JoanSanbartolome/ESP-Riego/gestion/informes/VAL-0029-01.md

---
id: VAL-0029-01
spec: SPEC-0029
fecha: 2026-11-14
commit_revisado: 0a786a3
checklists: [esquema v10, librerias v6]
veredicto: APROBADO_CON_OBSERVACIONES
---

# VAL-0029-01 · Bloque de sensores

## Alcance de la revisión

Nivel completo sobre `0a786a3` (rama `spec/SPEC-0029-bloque-sensores`), con copias en la carpeta temporal y sin MCP.

- **Reproducido de forma independiente:**
  - pinout del símbolo y de la huella frente a §5.4 (p. 17, Fig. 18), Fig. 15 (p. 15) y Fig. 17 (p. 16);
  - dirección I²C con la Tabla 11 (p. 21);
  - unión de la raíz en la netlist kicadxml exportada de una copia;
  - modelo 3D enlazado en la instancia: ruta, transformación, `layout.3d` y render `vista.py huella --3d` con el STEP de respaldo;
  - la sincronización de la PCB: `sincronizar.py` sobre la PCB de `3dfec5d` da una placa igual a la del commit (comparación huella a huella sin UUID).
- **Cambios de `herramientas/kicad/`** (`_comun.modelo_de_respaldo`, `sincronizar.py`, `comprobar.py librerias.3d`): revisión del diff, 5 casos directos de la función, 3 mutaciones de `librerias.3d`/`layout.3d` y `sincronizar.py --actualizar U13`. `test_kicad.py` completo: 34/35; el fallo, `Mutaciones.test_librerias_fichas`, viene de SPEC-0028.
- **Recalculado:** C_b máx. (75 pF), derating de C47 (73 nF), autocalentamiento (2 mK y 0,49 K), modelo de la isla (G = 0,67 + 0,29 y 2,4 mW/K; f = 0,29; τ ≈ 108 s), calentamiento de la placa (4,5 K y 10,5 K), dHR/dT (2,98 % HR/K) y 3 K → 41,9 % HR. Todo cuadra.
- **Por muestreo:**
  - 4 códigos con `jlc.py` (C2848306, C2909890, C7461861 y C14663): coinciden con `stock-sensores.csv`, salvo el stock de C14663, que se ha movido (34,63 M);
  - las 2 URL de `Datasheet`: HTTP 200;
  - 3 restricciones de AMB-02 frente al requisito: borde, sin planos y orientación.

## Comprobaciones automáticas

| Comprobación | Resultado |
|---|---|
| ERC | 0 (`verificar.py hardware/v2`; `kicad-cli sch erc --severity-all` sobre una copia: 0) |
| DRC | 0 errores, 0 avisos; sin conectar 352 → 358 (+6 = 1 por I2C_SDA, 1 por I2C_SCL, 2 por +3V3 y 2 por GND: los pads nuevos de U13 y C47) |
| Paridad esquema↔PCB | 0 |
| Puntos `[auto]` | 16 OK, 2 N/A. FALLAN `librerias.gitattributes` (`*.WRL`) y `librerias.fichas`, con las mismas 6 líneas de la hoja MCU que antes de la spec. Ningún punto nuevo en FALLA |

## Criterios de aceptación de la spec

| Criterio | Evidencia | Resultado |
|---|---|---|
| Piezas, valores, huellas y pines = `sensores.md` y datasheet | Netlist: U13-1 SDA → `/I2C_SDA`, U13-2 SCL → `/I2C_SCL`, U13-3 VDD → +3V3, U13-4 VSS → GND; C47 entre +3V3 y GND. Pads de la huella 1 (−0,7, −0,4), 2 (−0,7, 0,4), 3 (0,7, 0,4), 4 (0,7, −0,4), 0,5 × 0,3, paso 0,8, columnas a 1,4 = Fig. 17/18 | Cumple |
| `verificar.py`: ERC 0, DRC 0, paridad 0, sin `[auto]` nuevo en FALLA; sin conectar solo por las huellas nuevas | Tabla de arriba; el parte da 352 → 358 | Cumple |
| `campos.py revisar`: 0 diferencias con `campos-sensores.csv` | «diferencias con la tabla 0». Los DISTINTO y FALTA son de alimentación, ya estaban | Cumple |
| Cinco hojas; I2C_SDA/SCL a GPIO41/42; sin *pull-ups* duplicados ni NC en pines unidos | Netlist: 5 hojas; `/I2C_SDA` = {U5-34 IO41, R24-2, U13-1} y `/I2C_SCL` = {U5-35 IO42, R25-2, U13-2}. Las 2 NC de esos pines, retiradas | Cumple |
| Sin pad central, 3D de respaldo en la instancia y sin librerías de la v1 | 4 pads, sin pad central. U13 enlaza un solo `model`, `${KIPRJMOD}/../libraries/3d/…NoCentralPad.step` (offset 0, giro 0, escala 1). El STEP no ha cambiado desde `daa0aa6`, validado en VAL-0015-02; en el render, la marca del pin 1 cae sobre el triángulo de la serigrafía. `lib_id`: `Sensor_Humidity`, `Device` y `power` | Cumple |
| Dirección sin choque, calentador fuera de uso, consumo = `mcu.md` §8.2 | AD1B → 0x44 (Tabla 11, p. 21), único en el bus de la placa; la expansión va por GPIO47/48. `heater_max_duty: 0.0`. 500 µA máx. (p. 9) = 0,5 mA de §8.2 | Cumple |
| Restricciones de AMB-02 listas para `restricciones.csv`, sin colocar ni rutar | Tabla del §0 con el formato de `restricciones.py`. U13 y C47 quedan fuera del Edge.Cuts (y ≈ 271–277 frente a 60–130) y no hay pistas nuevas | Cumple |

## Requisitos

| Requisito | Evidencia | Resultado |
|---|---|---|
| AMB-01 | SHT40 en placa, I²C, desacoplo y *pull-ups* | Cumple |
| AMB-02 | Borde lateral (FAB-07), ranuras con un puente, área de regla en F.Cu y B.Cu sin relleno ni vías, orientación a la rejilla y corrección según las salidas (§8). Cifras recalculadas | Cumple (lo confirma el prototipo, §9) |
| KIC-02 | Raíz con alimentación, MCU, salidas, sensores y conectores | Cumple |
| FW-03 | §8: T corregida, HR por Magnus y calentador apagado | Cumple |

Puntos `[juicio]` de las checklists:

- Cajetín: título, hoja, versión, fecha e Id 6/6, vistos en el render de la hoja.
- Cálculos con fórmula, fuente y margen; recalculados.
- C47 con derating.
- Desacoplo y *pull-ups* del sensor (esquema l. 63).
- Tabla de restricciones (l. 67).
- Pines y tipo eléctrico (librerías l. 20, 21 y 41).
- Pin 1 en serigrafía y en Fab.
- 3D alineado (l. 30 y 34).
- Datasheet del fabricante, V7.3 (l. 46).
- Origen oficial anotado (l. 9).

Todo correcto.

## Hallazgos

Severidad: **C** crítico · **A** alto · **M** medio · **B** bajo.

| ID | Sev. | Hallazgo | Evidencia | Requisito | Cambio propuesto |
|---|---|---|---|---|---|
| VAL-0029-01-01 | M | El comportamiento nuevo de `herramientas/kicad/` no tiene prueba en `test_kicad.py`: ni `_comun.modelo_de_respaldo`, ni el cambio de modelo de `sincronizar.py`, ni la rama «respaldo» de `librerias.3d`. El README pide una prueba para lo que se añade. Mis comprobaciones dan el comportamiento correcto: función con oficial ausente/existente, sin respaldo y `libs3d=None`; M1, la instancia vuelve al oficial → `layout.3d` FALLA; M2, sin el STEP → los dos puntos FALLAN; M3, respaldo `.wrl` → FALLA; `--actualizar U13` conserva el respaldo. El autor ya lo dejó en PENDIENTE: `test_kicad.py` está fuera de su zona | `git diff 3dfec5d 0a786a3 -- herramientas/` (sin cambios en `herramientas/pruebas/`); `herramientas/kicad/README.md` § Herramientas y § Puntos | KIC-02 (herramientas, DEC-0009 M1) | Añadir en `test_kicad.py`: (a) casos de `modelo_de_respaldo` como los de arriba; (b) `Mutaciones`: `librerias.3d` OK con respaldo y FALLA sin él; (c) `sincronizar` de una huella oficial sin 3D que deja `${KIPRJMOD}/../libraries/3d/…` en la instancia. Se puede juntar con el arreglo de `test_librerias_fichas`. **No afecta a la spec siguiente**, salvo que vuelva a cargar una huella oficial sin 3D (el USB-C HRO ya tiene respaldo); `layout.3d` cubre ese caso mientras tanto |
| VAL-0029-01-02 | B | La ficha `SHT4x.md` no recoge el cierre del bloque. Sigue con `verificado_por: pendiente (ing-validacion), solo el modelo 3D de respaldo`, aunque VAL-0015-02-05 lo cerró. «Uso en el proyecto» dice que la variante «la fija el bloque de sensores» y las «Notas de los assets» dicen que el bloque «tiene que añadir» el `model`: las dos cosas ya están hechas. `sensores.md` Anexo A lo reconoce («la ficha no se ha tocado») | `hardware/componentes/SHT4x.md`, cabecera, «Notas de los assets» y «Uso en el proyecto»; `gestion/informes/VAL-0015-02.md` l. 34 | AMB-01 | En la cabecera, `verificado_por: VAL-0015-02 (3D de respaldo)`. Variante fijada: SHT40-AD1B-R3, U13 (SPEC-0029). Instancia con el `model` de respaldo, enlazada por `sincronizar.py` |
| VAL-0029-01-03 | B | El SHT40-AD1B-R2 (C2909890) es el mismo chip a 1,7491 $ (frente a 1,8538 $ del R3) y tiene más stock (14 052 frente a 13 207). Con la misma huella y la misma dirección, ahorra ≈ 0,10 $ por placa. La diferencia entre R2 y R3 es solo el carrete (2 500 o 10 000 uds, Tabla 11, p. 21), que en el montaje de JLCPCB no cuenta | `jlc.py` 2026-11-14; `stock-sensores.csv` | — | Valorar el cambio de U13 a C2909890 (MPN, LCSC y Value en `campos-sensores.csv`, `sensores.md` §0, §2 y §10, y la ficha) con `campos.py aplicar`. Es opcional |
| VAL-0029-01-04 | B | `mcu.md` §8.2 da 61 mA para el calentador (200 mW / 3,3 V). El datasheet da 60 mA típ. y **100 mA máx.** (Tabla 4, p. 9). No cambia nada porque el calentador no se usa; `sensores.md` §4.1 ya da el máximo. Lo anotó el autor | `docs/diseno/mcu.md` l. 194; SHT4x p. 9 | AMB-01 | En la próxima revisión de `mcu.md`: «60 mA típ. / 100 mA máx. (p. 9) … el total subiría a 0,55 A» |

Contraste con los partes:

- Las afirmaciones del parte 02 se sostienen: +6 sin conectar, netlist, 3D y fallo previo del test.
- El parte 01 nombra C46: lo corrigió el paso 2 (C47) y la nota del coordinador lo explica.
- Los dos partes coinciden con los entregables.

## Propuestas para las checklists

- `[auto]` Esquema: las referencias de `campos-<hoja>.csv` no pueden estar usadas en otra hoja del proyecto (`campos.py revisar`). Habría parado el C46 duplicado de la spec y del paso 1.
- `[auto]` Librerías, l. 33: un caso de `test_kicad.py` en el que el respaldo de `libraries/3d` haga pasar `librerias.3d` y su ausencia lo haga fallar (ver VAL-0029-01-01).
- `[juicio]` Esquema: cuando un bloque cierra la elección de una pieza (variante, 3D enlazado), su ficha en `hardware/componentes/` se actualiza en la misma spec.

## Veredicto

**APROBADO_CON_OBSERVACIONES.** Se cumplen los 7 criterios de aceptación. Quedan un hallazgo M (VAL-0029-01-01, pruebas de la herramienta, que no afecta a la spec siguiente) y tres B.
