JoanSanbartolome/ESP-Riego/gestion/informes/VAL-0025-01.md

---
id: VAL-0025-01
spec: SPEC-0025
fecha: 2026-11-13
commit_revisado: 07b48a6
checklists: [esquema v9, librerias v6]
veredicto: APROBADO_CON_OBSERVACIONES
---

# VAL-0025-01 · Hoja de salidas en el esquema v2

## Alcance de la revisión

Validación completa de `7d78d12..07b48a6` en la rama `spec/SPEC-0025-hoja-salidas`. Reproducido de forma independiente, sobre una copia de `hardware/{v2,libraries,componentes}` en el *scratchpad* (`v25\`):

- la netlist kicadxml exportada de la copia frente al Anexo B, en los **6 canales** (87 refs, todos sus pines, con el script propio `anexo_b.py`), y los pines de U7–U12 frente a la Tabla 2, p. 4 del BTT6050 (`pdftotext`);
- las uniones de la raíz (pin de hoja ↔ etiqueta ↔ no conexión) y los GPIO de U5 frente a la tabla de pines del ESP32-S3-WROOM-1;
- BOM (`sch export bom`, con y sin `--exclude-dnp`) y CPL (`pcb export pos`, completo y `--smd-only --exclude-dnp`);
- atributos de las dos huellas (`huella.py`, `git diff`) y de J1 y las huellas nuevas en la PCB;
- diff semántico de la PCB frente a `7d78d12` (sin uuid) y cruce de los 628 pads con la netlist; recuento esperado de «sin conectar».

Por muestreo: 4 filas de `campos-salidas.csv`/`stock-salidas.csv` con `jlc.py` (C534868, C17902, C17713, C2286) y 5 de los 12 cambios de `salidas.md` (1, 7, 9, 10 y 11). El MCP no se ha usado (salvo `get_jlcpcb_part`, que no tiene la base descargada).

## Comprobaciones automáticas

| Comprobación | Resultado |
|---|---|
| ERC | 0 (0 errores, 0 avisos) |
| DRC | 0 errores, 0 avisos; 352 sin conectar (172 en `main`) |
| Paridad esquema↔PCB | 0 |
| Puntos `[auto]` | 16 OK, 2 N/A (zonas, restricciones), 2 FALLA: `librerias.gitattributes` (`*.WRL`) y `librerias.fichas` (6 códigos del MCU); los dos están en SPEC-0028 |
| `campos.py revisar` | 0 diferencias con la tabla; 20 incoherencias entre hojas, todas de los tipos de SPEC-0028 |
| `hardware/v2` tras `verificar.py` | sin cambios (`git status`) |

## Criterios de aceptación de la spec

| Criterio | Evidencia | Resultado |
|---|---|---|
| Piezas, valores, huellas y pines frente a §9 y Anexo B | Netlist: 0 diferencias en los 6 canales (pines NC del BTT sin red; D6 K=GND, A=`LED1_A`; D12 K=`OUT1`, A=GND). U7–U12 = Tabla 2, p. 4. Valores, huellas, LCSC y MPN de las 13 líneas = §9; totales 6 U, 6 J, 43 R, 20 C, 6 LED + 6 D | Cumple |
| `verificar.py`: ERC 0, DRC 0, paridad 0; `attr`, `campos`, `dnp` OK; sin conectar solo por huellas nuevas | +180 sin conectar = mi recuento por redes (10 aristas internas por canal × 6, IN/IS 3 × 6 cada una, OUT_DEN 7, BUS_24V 20, GND 57). Diff semántico: las 80 huellas previas solo cambian en el `thickness` de los textos, el `attr` de J1 y 19 redes renombradas (`/MCU/INn` → `/INn`, `/Alimentacion/BUS_24V` → `/BUS_24V`); 628 pads = netlist | Cumple |
| `campos.py revisar`: 0 diferencias; sin incoherencias nuevas fuera de SPEC-0028 | Las 7 nuevas (Datasheet y Fabricante de C25803, C381466, C513710, C8465) son del tipo «`Datasheet` distinto» y «`Fabricante` ausente», en el alcance de SPEC-0028 | Cumple |
| Pin 1 = OUTn, pin 2 = GND en los 6 bornes (REL-06) | J4–J9 en la netlist y en la PCB | Cumple |
| D12–D17 DNP en símbolo y huella, fuera de BOM y CPL | Símbolo `dnp yes`, `in_bom no`, `in_pos_files no`; huella `smd exclude_from_pos_files exclude_from_bom dnp`; ausentes en los 2 BOM y los 2 CPL exportados (D6 presente) | Cumple |
| Ninguna librería de la v1 | `lib_id`: `Device`, `Connector`, `power`, `esp-riego`; tablas solo con `${KIPRJMOD}/../libraries/esp-riego.*` | Cumple |
| Raíz: sin no conexiones en pines unidos; IN1–6, IS1–6, OUT_DEN y BUS_24V a sus GPIO | 21 → 7 no conexiones, las 7 en pines de MCU sin unir (I²C, EXP_*, PULSE_IN). Etiqueta local en cada uno de los 38 pines unidos, sin discrepancias de nombre. IN1–6 → U5 19, 20, 21, 8, 9, 10 (IO11, 12, 13, 15, 16, 17); IS1–6 → U5 4, 5, 6, 7, 12, 17 (IO4–9); OUT_DEN → U5 31 (IO38); BUS_24V → U1 OUT, JP1, TP5 y VS de U7–U12. Direcciones: hoja y raíz según Anexo B | Cumple |

## Requisitos

| Requisito | Evidencia | Resultado |
|---|---|---|
| REL-01, REL-03 | 6 BTT6050 con su *clamp*; D12–D17 DNP (DEC-0008) | Cumple |
| REL-04 | R32–R37 en IN1–6 y R44 en OUT_DEN a GND, sin otras cargas en esas redes | Cumple |
| REL-05, REL-08, REL-09 | Sin cambio de cálculo; se deciden en el layout (§11) | Fuera de esta spec |
| REL-07 | R63–R68 + D6–D11 desde IN_n, cátodo a GND (pad 1 = ② del KT-0603R) | Cumple |
| REL-10 | Pin 6 → R_SENSE 1206 → IS_n con R_IS 820 Ω y C_IS 100 nF a GND; R_OL 47 kΩ 0805 de BUS_24V a OUTn | Cumple |
| Checklist de esquema `[juicio]` | Cajetín en el PDF exportado (p. 2: título, «Hoja: Salidas», 2.0-dev, 2026-11-12, A3, 2/5). Cálculos de `salidas.md` sin cambios de valor (los validó VAL-0023-01). Tabla de restricciones en §11. Pines de arranque: ninguno de los GPIO usados es de arranque | Cumple |
| Checklist de librerías `[juicio]` | Las dos huellas solo ganan la línea `attr`; `huella.py`: BTT smd, 40 pads, cruce con el símbolo de 15 pines sin pines ni pads sueltos; WJ500V through_hole, 2 pads | Cumple |
| Muestreo de campos y stock | Tipo, MPN y fabricante iguales a JLCPCB (2026-11-13); stock ±2 % del 2026-11-12. MPN de UNI-ROYAL coherentes con valor y potencia (W4 = 1/4 W, W8 = 1/8 W) | Cumple |
| Muestreo de `salidas.md` | Cambios 1, 7, 9, 10 y 11 con el texto exacto del log de SPEC-0024; los «requiere DEC» de §0, §5, §11 nota 1, §13.1, §13.8 y trazabilidad citan DEC-0008 (no queda ninguno) | Cumple |

## Hallazgos

Severidad: **C** crítico · **A** alto · **M** medio · **B** bajo.

| ID | Sev. | Hallazgo | Evidencia | Requisito | Cambio propuesto |
|---|---|---|---|---|---|
| VAL-0025-01-01 | B | La cabecera de `salidas.md` sigue citando «`docs/02` v0.4», mientras §11 (l. 373) y DEC-0008 ya remiten a la v0.5, que cambia FAB-03, un requisito de la misma línea | `docs/diseno/salidas.md` l. 4 y l. 373; `docs/02` l. 3 y l. 269 | FAB-03 | «`docs/02` v0.5» en l. 4. Se puede llevar a SPEC-0028; no afecta a la spec siguiente |

Contraste con los partes: lo que afirma el parte 02 (cifras de sin conectar, renombres, 14 no conexiones quitadas, banderas DNP, incoherencias 13 → 20) coincide con lo que he reproducido. El parte 03 dice que `hardware/v2` «todavía no tiene la hoja de salidas», pero el commit del paso 2 (`dc8d474`) es anterior. Su resultado, sin embargo, es correcto: con la hoja, C17713, C17902 y C23253 ya no salen en `librerias.fichas`.

## Propuestas para las checklists

- `[auto]` esquema: netlist de la hoja frente al plan de conexiones del documento de diseño (Anexo B o equivalente, en una tabla que se pueda leer con un script). Lo han escrito por separado el autor (`plan_salidas.py`) y validación (`anexo_b.py`): es candidato a `hoja.py netlist --plan`.
- `[auto]` esquema (`esquema.dnp`): que las piezas DNP no salgan en el BOM ni en el CPL exportados con las órdenes del paquete de fabricación, no solo que lleven las banderas.

## Veredicto

**APROBADO_CON_OBSERVACIONES.** Se cumplen los siete criterios de aceptación: la netlist reproduce el Anexo B en los seis canales, la raíz llega a los GPIO de `mcu.md` §9.2, D12–D17 quedan fuera del BOM y del CPL, y la PCB solo gana las 87 huellas sin colocar. Queda una sola observación, B, que no afecta a la spec siguiente.
