JoanSanbartolome/ESP-Riego/gestion/informes/VAL-0024-01.md

---
id: VAL-0024-01
spec: SPEC-0024
fecha: 2026-11-10
commit_revisado: c2401d6
checklists: [librerias v3, esquema v6 (FAB-02)]
veredicto: APROBADO_CON_OBSERVACIONES
---

# VAL-0024-01 · Piezas del bloque de salidas

## Alcance de la revisión

Nivel completo. Commit `c2401d6` (rama `spec/SPEC-0024-piezas-salidas`), diff frente a `60cec8d`. Revisados la huella `esp-riego:Infineon_PG-TDSO-14_8.65x3.9mm_P1.27mm_EP2.65x6.4mm`, el símbolo `esp-riego:BTT6050-1ERA`, las fichas `M7.md` (y `datasheets/M7.pdf`), `BTT6050-1ERA.md`, `BTT6030-2ERA.md`, `WJ500V-5.08-2P.md`, `KT-0603R.md` y la fila D4 de `bloque-alimentacion.md`, los tres renders `render_SPEC-0024_*.png` y el log `01-jr-conformidad.md` (tablas de stock, de campos y los 10 cambios a `salidas.md`). `hardware/v2` no se ha abierto: solo copias en la carpeta temporal.

## Comprobaciones automáticas

| Comprobación | Resultado |
|---|---|
| `verificar.py` sobre una copia de `hardware/v2` + `libraries` | ERC 0 · DRC 0 (172 sin conectar: placa sin rutar, previo) · paridad 0. `hardware/v2` no cambia en la spec |
| DRC de una placa de prueba con el `.kicad_pro` de v2 (huella nueva y la de `60cec8d` como control, pads 15 en BUS_24V) | 0 errores. Solo `lib_footprint_issues` (librería no listada en la placa de prueba) y el «sin conectar» entre las dos huellas |
| Gerber + Excellon de la placa de prueba | F.Paste: 10 aperturas (2 × 1,1 × 2,95 y 8 × 0,6 × 0,4), 8,410 mm² = **49,6 %**; pasta a ≥ 0,250 mm del taladro y 0,100 mm del anillo. F.Mask: una apertura de 2,65 × 6,4 (vías dentro). B.Mask: ninguna apertura en el EP. B.Cu: pad de 2,65 × 6,4 + 10 anillos de 0,6. Taladros: 10 × 0,3 mm; paso 1,2 mm (0,9 mm entre bordes) y 1,9 mm entre columnas |
| API de JLCPCB (2026-11-10, 20 códigos) | Tipo, stock, tramos y `dataManualUrl` coinciden con el log (deriva de stock < 0,1 %) |
| Modelos 3D | Los 10 `.step` existen (`${KICAD10_3DMODEL_DIR}` de 10.0.6 y `hardware/libraries/3d/`) |

## Criterios de aceptación de la spec

| Criterio | Evidencia | Resultado |
|---|---|---|
| Símbolo, huella y 3D resolubles; pines y pads frente al datasheet; render con pin 1 y cátodos | Script de modelos; símbolo BTT 15/15 frente a la Tabla 2, p. 4; M7 pp. 1 y 3; KT-0603R (VAL-0022-01); renders: triángulo y marca junto al pad 1 del BTT, pad cuadrado del borne, banda del D_SMA en el pad 1 | Cumple |
| ≥ 8 vías 0,3/0,6 numeradas 15, sin pasta en taladros; diff limitado; ninguna otra huella con vías | 10 vías; diff solo en `descr`, pad 15, pad B.Cu, vías y pasta; oficiales sin `thru_hole`; borne: 2 patillas de 1,3 mm | Cumple |
| Tipo y stock con fecha; cambios de compra según DEC-0007 | Tabla del log frente a la API; búsqueda de Basic para 220 nF 100 V 0805 y 4,7 µF 100 V 1210: los primeros 100 de 1 385 y 679 resultados, todos Extended | Cumple |
| Fichas M7, BTT6050, WJ500V y D4 | Ver hallazgo 05 | Cumple |
| Tabla de campos de 87 referencias, D12–D17 DNP | 6 U + 6 J + 43 R + 20 C + 12 D; coherente con §9 y Anexo B | Cumple |
| Cambios a `salidas.md` con texto exacto | Están los que enumera la spec (l. 434, §9, §11, Anexo A). Falta uno que también es consecuencia de la spec (hallazgo 03) | Cumple |
| Checklist de librerías v3 | Repaso del log contrastado | Cumple |
| Nada de `hardware/v2` ni de `docs/` modificado | `git diff --stat 60cec8d c2401d6` | Cumple |

## Requisitos

| Requisito | Evidencia | Resultado |
|---|---|---|
| FAB-02 | Vías 0,3/0,6 mm; anillo de 0,15 mm; 0,9 mm entre taladros ≥ 0,45 mm (JLCPCB, entre taladros de pads) y ≥ 0,25 mm (`min_hole_to_hole` de v2) | Cumple |
| FAB-05 | `LCSC Part#` en las 87; 4 líneas Extended, todas ya justificadas | Cumple |
| FAB-11 | 10/10 `.step` existentes | Cumple |
| KIC-01 | Rutas `${KIPRJMOD}` / `${KICAD10_3DMODEL_DIR}` | Cumple |
| REL-03 | D12–D17 DNP con huella `D_SMA` (DEC-0008); atributos y `--exclude-dnp` de `sch export bom` y `pcb export pos` presentes en kicad-cli 10.0.6 | Cumple |
| REL-06, REL-07 | Pin 1 = OUT_n en el borne; LED K = pad 1 | Cumple |

## Hallazgos

Severidad: **C** crítico · **A** alto · **M** medio · **B** bajo.

| ID | Sev. | Hallazgo | Evidencia | Requisito | Cambio propuesto |
|---|---|---|---|---|---|
| VAL-0024-01-01 | M | **No se demuestra que la pasta del EP baste para soldar el *tab*.** El 49,6 % está en el límite inferior del intervalo habitual (50–80 %; IPC-7525) y no compensa las vías abiertas por arriba. Las 10 vías dejan 1,13 mm³ de agujero (Ø 0,3 × 1,6 mm). La pasta aporta 8,41 mm² × 0,10–0,12 mm × ≈ 50 % de metal = 0,42–0,50 mm³ de estaño. El *tab* lleva toda la corriente de VS y el calor. Referencias: Infineon 85 % sin vías; `SOIC-8-1EP…_ThermalVias` oficial, 70 %. **No afecta a la hoja de SPEC-0025**, solo a la cifra del cambio 10 | Gerber F.Paste de la placa de prueba; imagen *footprint* de infineon.com/package/PG-TDSO-14-11 (sin vías, 2 × 2,95 × 2,45); `Package_SO.pretty/SOIC-8-1EP_3.9x4.9mm_P1.27mm_EP2.41x3.3mm_ThermalVias` | FAB-02 | Llevar la pasta a 0,10 mm del **taladro**, no del anillo, para subir a ≈ 65 %. Ejemplo comprobado: 2 centrales de 1,40 × 2,95 en (0, ±1,625); 8 laterales de 0,375 × 0,70 en (±1,0875; ±0,60 y ±1,80); 4 en los extremos de 0,375 × 0,45 en (±1,0875; ±2,875). Total 11,03 mm² = 65 %, puentes de 0,2 mm y relación de área ≥ 0,85 con 0,12 mm. Otra opción, si se acepta el coste: vías rellenas y tapadas de JLCPCB (resina o pasta de cobre, Ø 0,15–0,55 mm) |
| VAL-0024-01-02 | M | **Las vías «tapadas por la cara inferior» no están demostradas.** Lo afirman `descr`, `BTT6050-1ERA.md` y el log. JLCPCB solo rellena con máscara las vías **sin apertura en ninguna cara** y a ≥ 0,35 mm de otras aperturas, y estas quedan dentro de la apertura de F.Mask del EP. No cita ningún tapado por una sola cara. Por debajo solo se garantiza que B.Mask no tiene apertura, no que el agujero quede cerrado. Además, el tapado por una cara atrapa aire, que se expande al refundir. No afecta a SPEC-0025 | Capacidades de JLCPCB (jlcpcb.com/capabilities/pcb-capabilities, «Plugged vias», consulta 2026-11-10); Gerber F.Mask y B.Mask | FAB-02 | Corregir el texto: «sin apertura de máscara en B.Cu; el tapado de vías con apertura en F.Mask no lo garantiza JLCPCB». La elección (abiertas, rellenas y tapadas, o pasta compensada; ver 01) se fija en la huella y se comprueba en los Gerber de la fase 5 |
| VAL-0024-01-03 | M | **Faltan cambios en las propuestas a `salidas.md`.** (a) La l. 69 sigue diciendo «huella … (sin vías: las pone el layout, §11)», en contra de la huella nueva y del cambio 10. (b) El cambio 1 (Anexo A, KT-0603R) dice «D4 y D6–D11» y omite D5, que también es KT-0603R por DEC-0008 (`mcu.kicad_sch`, D5 = C2286; `KT-0603R.md`, l. 4). **Afecta a SPEC-0025**, que aplica estos cambios | `docs/diseno/salidas.md` l. 69 y l. 434; log, cambios 1 y 10 | — | Añadir el cambio 11: en la l. 69, sustituir «(sin vías: las pone el layout, §11)» por «(con 10 vías de 0,3 / 0,6 mm en el EP, numeradas 15, desde SPEC-0024; §11)». En el cambio 1, poner «D4, D5 y D6–D11» |
| VAL-0024-01-04 | B | Distancia entre taladros citada con la regla de vías de JLCPCB (0,2 mm). Estas vías son pads `thru_hole`, así que se aplica «Pad Hole-to-Hole Spacing» de 0,45 mm, que también se cumple (0,9 mm) | jlcpcb.com/capabilities/pcb-capabilities; log, tabla de vías; `BTT6050-1ERA.md` | FAB-02 | Citar las dos reglas |
| VAL-0024-01-05 | B | Fichas. (a) `BTT6050-1ERA.md`: la fila V_S(OP) pasa de «hasta 48 V» a «5…36 V (V_S > 48 V solo con JP1…)». Deja sin cubrir el tramo de 36 a 48 V, en el que cae el régimen con JP1 (36,7 V), y no cita el margen extendido de 5–48 V (Tabla 4, p. 8) que usa `salidas.md` l. 69. (b) `M7.md`: `verificado_por` vacío; las demás fichas ponen «pendiente (ing-validacion)» | BTT6050 p. 2 (Tabla 1) y p. 8 (Tabla 4); `M7.md` l. 14 | — | (a) «V_NOM 8–36 V; V_S(OP) ampliado 5–48 V (Tabla 4, p. 8)». (b) Rellenar `verificado_por` |
| VAL-0024-01-06 | B | Forma de las propuestas. En los cambios 1 y 2, el texto va entre comillas invertidas y lleva otras dentro, así que el bloque se rompe al leerlo. La l. 5 de `salidas.md` («los confirma jr-conformidad (SPEC-0024)») queda sin actualizar | Log, l. 164 y l. 166; `salidas.md` l. 5 | — | Usar bloques de código. Para la l. 5: «… confirmados por jr-conformidad el 2026-11-10 (SPEC-0024)» |
| VAL-0024-01-07 | B | Una misma pieza lleva distinto `Datasheet` según la hoja. En alimentación es `lcsc.com/product-detail/Cxxxx.html` (C513710, C14663, C381466, C2286, C25803, C25804); en la tabla de salidas y en MCU es el PDF. Además, `Fabricante` falta en `alimentacion.kicad_sch`, y `Value` del LED es «Rojo» en D4 y «LED» en D5. La tabla sigue la spec; la incoherencia viene de antes | `alimentacion.kicad_sch` y `mcu.kicad_sch` (lectura de campos) | FAB-05 | Unificarlo en la spec de mantenimiento de la fase 2 |

Comprobado sin hallazgo:

- Anillo dentro del EP: 0,075 mm en x y 0,5 mm en y.
- `zone_connect 2` y `pad_prop_heatsink` en los 12 pads «15».
- Diff de la huella frente a `60cec8d`: pads 1–14, tamaño del EP, Fab, serigrafía, patio y 3D idénticos.
- Infineon no publica patrón de vías.
- Símbolo BTT: 15/15 pines frente a la Tabla 2, p. 4.
- Pinout del BTT6030 frente a su Tabla 2, p. 4.
- Errata de P_7.5.2 en p. 30 («I_IS(OL) = 8 mA»).
- R_GND 27 Ω y zéner de 58 V en la Tabla 11, p. 48; V_S(AZ) ≥ 65 V en la p. 22.
- M7 (pp. 1 y 3): V_RRM, I_F, V_F, I_R, C_J, R_θJA y las cotas del SMA. La banda y el símbolo del diodo marcan el cátodo a la izquierda.
- `D_SMA`: pads de 2,5 × 1,8 en ±2,0 y barra de Fab en el pad 1.
- J1 en `alimentacion.kicad_sch`.
- Recuentos para el stock: C381466 = 6 por placa, C513710 = 14, C8465 = 7.

## Propuestas para las checklists

- `librerias.md`: en huellas con vías dentro de un pad expuesto, (a) cobertura de pasta frente al intervalo de 50–80 % y al volumen de los agujeros, y (b) tratamiento de las vías (abiertas, tapadas por una cara, rellenas), contrastado con las capacidades del fabricante. No dar por «tapada» una vía que tiene apertura de máscara en una de las caras.
- `librerias.md`: cuando se proponen cambios a un documento de diseño por un cambio de pieza, buscar con Grep todas las menciones del rasgo cambiado (p. ej. «sin vías»), no solo las líneas que cita la spec.

## Veredicto

**APROBADO_CON_OBSERVACIONES.** Hay tres M y cuatro B, y no queda ningún criterio sin cumplir. La M 03 afecta a SPEC-0025 y se corrige antes del merge. Las M 01 y 02 tocan la huella y la ficha, no la hoja; deben quedar resueltas antes del layout de salidas.
