JoanSanbartolome/ESP-Riego/gestion/informes/VAL-0022-01.md

---
id: VAL-0022-01
spec: SPEC-0022
fecha: 2026-11-07
commit_revisado: 38090d2
checklists: [esquema v6, layout v5 (solo «Reglas y verificación»)]
veredicto: APROBADO_CON_OBSERVACIONES
---

# VAL-0022-01 · Hoja del MCU en el esquema v2

## Alcance de la revisión

- Nivel completo. Rama `spec/SPEC-0022-hoja-mcu`, HEAD `38090d2` (commits `047cabd` y `38090d2`).
- Artefactos: `hardware/v2/mcu.kicad_sch`, la raíz `esp-riego.kicad_sch`, `esp-riego.kicad_pcb`, `docs/diseno/mcu.md` y `hardware/v2/README.md`.
- Todo sobre una copia de `hardware/v2` + `hardware/libraries` en el *scratchpad* (`v22/hw`). Repositorio sin cambios: MD5 de los 234 archivos de `hardware/` y `docs/` iguales antes y después. Solo cambia la auditoría.
- No se usó el MCP.

## Comprobaciones automáticas

| Comprobación | Resultado |
|---|---|
| ERC (`verificar.py` sobre la copia) | 0 errores, 0 avisos (0 `lib_symbol_mismatch`) |
| DRC | 0 errores, 0 avisos (0 `lib_footprint_mismatch`, 0 `courtyards_overlap`, 0 `drill_out_of_range`); 172 sin conectar (placa sin rutar) |
| Paridad esquema↔PCB | 0 |
| Cruce pad↔netlist (script propio, netlist `kicadxml`) | 80/80 referencias, misma huella y mismo valor; 0 pads con red distinta (H1–H4 sin red, como en el esquema); 77/77 redes en los dos lados |
| Diff semántico de la PCB frente a `047cabd` | +21 huellas (las de la hoja MCU), 0 quitadas. Las 59 que ya estaban, `setup`, contorno y nivel superior no cambian (salvo la red de los pads). Diff *patience*: +5 865/−11; las 11 líneas quitadas son `(net "/Alimentacion/…")` |
| Courtyards de las 21 nuevas | Todos fuera del Edge.Cuts (100–200 × 60–130); x 10–64, y 120–198 |

## Criterios de aceptación de la spec

| Criterio | Evidencia | Resultado |
|---|---|---|
| Piezas, valores y pines según `mcu.md` | Netlist frente a §4–§10, pin a pin: los 41 pines de U5 (GPIO↔pin según §9.2; NC en 3, 10, 18, 39, 45 y 46), USB (J2 A6/B6 → U6 1/6 → R20 → pin 14; A7/B7 → U6 3/4 → R21 → pin 13; CC con 5k1; SBU NC; SHIELD y U6-2 a GND), EN (R16/C23/SW1 en el pin 3), BOOT (R17/SW2 en el pin 27), UART (R22 en TXD0 → J3-2; RXD0 → J3-3; J3-1 a +3V3; J3-4 a GND), LED (pin 33 → R23 → D5 A, K a GND), I²C (R24/R25), C24/C25 y VBUS (J2 ×4, U6-5, C26, U3-6, C15) | Cumple |
| Campos según la tabla de SPEC-0021 | Las 21 piezas tienen `Value`, `Footprint`, `Datasheet`, `Description`, `MPN`, `LCSC Part#` y `Fabricante` iguales a la tabla del log 01 de SPEC-0021, corregida en su log 03. C23 = C15849/CL10A105KB8NNNC y D5 = C2286/KT-0603R, con el `dataManualUrl` que da la API de JLCPCB. Llevan las tres huellas `esp-riego:` | Cumple |
| Ninguna librería de la v1 | `lib_id`: RF_Module, Connector, Connector_Generic, Device, Power_Protection, Switch y power. Huellas oficiales o `esp-riego:`. Las tablas del proyecto solo tienen `esp-riego` | Cumple |
| Etiquetas del Anexo C conectadas con Alimentación | 25 etiquetas jerárquicas, cada una con la forma del Anexo C. En la raíz, la hoja tiene 25 pines: VBUS, VIN_SENSE, LIM_IMON, LIM_FLT y LIM_EN van por etiqueta local a Alimentación, con las direcciones complementarias, y los otros 20 llevan NC provisional. Las redes `/VBUS`… de la netlist unen U5/U6 con U1/U3/R4–R6/R14/R15/C5/C15/C20 | Cumple |
| `mcu.md`: huellas, stock, DEC-0007 con recálculo, §9.2/Anexo B | Recalculado (abajo): EN, LED y U6 (ST/UMW) frente a los datasheets. §9.2 y el Anexo B coinciden con `salidas.md` §3, §3.2 y §12 (R_IS 820 Ω, C_IS 100 nF, sin diodo, 6 dB, 2,32 V a 30 V, k_ILIS 1500/1600, ≥ 16 muestras, DEN ≥ 1 ms). §11 y el Anexo A: huellas `esp-riego:`, N8 con 2 776, TS-1187A y C14663 Basic, C318887 de 2,5 mm y 260 gf | Cumple (B -02 y M -01) |
| `verificar.py` tras el paso 2 | ERC 0, DRC 0 (172 sin conectar, anotados en el log 02) y paridad 0 | Cumple |

### Recálculos

- **§5.1, EN con C15849.** τ mín. = 10 k × 0,99 × 1 µ × 0,90 × 0,816 × 0,984 = 7,154 ms; τ máx. = 11,11 ms. Simulación propia con paso de 1 µs y el mismo modelo de VDD:
  - buck de 6 ms: EN/VDD = 0,1587 a 3,96 ms;
  - buck de 3 ms: 0,0835;
  - rampa lineal de 6 ms: 0,3003;
  - liberación: 9,9–15,4 ms (escalón) y 12,8–18,3 ms (buck de 6 ms).
  Coincide con la tabla. Con C106248 (τ = 7,35 ms) sale 0,1549.
- **§7, D5 con R23.** KT-0603R (PDF de LCSC C2286): V_F 1,8–2,4 V a 20 mA (p. 3 y bins de la p. 4); I_F ≤ 25 mA y P_d ≤ 40 mW (p. 3); V_F ≈ 1,85 V a 1 mA (curva de la p. 5).
  - I_típ ≈ 1,4 mA.
  - I_máx = (3,389 − 1,6)/1 k = 1,79 mA, conservador. P_R23 = 3,2 mW y P_LED ≤ 4,3 mW.
  - I_mín: ver -02.
- **§4, U6.** ST, tabla 2 (p. 2, PDF local): I_RM ≤ 150 nA a V_RM = 5,25 V; V_CL de 12/17 V; C ≤ 3,5/1,7 pF. UMW, §6 (p. 3, PDF de LCSC, nov. 2024): V_RWM = 5 V; V_BR 6–9 V; I_R ≤ 0,1 µA a 5 V; V_C de 10/15 V; C ≤ 1/0,4 pF; sin números de pin. Las cifras de la tabla de `mcu.md` son correctas. Decisión justificada: el UMW no garantiza 5,25 V.
- **API de JLCPCB (2026-11-07):**
  - C2286: Basic, 6,62 M.
  - C15849: Basic, 13,0 M, 50 V X5R ±10 %.
  - C2687116: Extended.
  - C7519: Extended.

## Requisitos

| Requisito | Evidencia | Resultado |
|---|---|---|
| MCU-01 | U5 = ESP32-S3-WROOM-1-N8 (C2913198) | Cumple |
| MCU-02 | Huella `esp-riego:` con la zona de *keepout*; la posición queda para el layout | Pendiente del layout (fuera de alcance) |
| MCU-03 | J2 + U6 (ST) + R18/R19 de 5,1 kΩ en GPIO19/20 | Cumple |
| MCU-04 | R16/C23 + SW1 en EN; R17 + SW2 en GPIO0 | Cumple |
| MCU-05 | Analógicas en GPIO1, 2 y 4–9; GPIO0/3/45/46 sin cargas extra; salidas fuera de 18/39/40/43/44 | Cumple |
| MCU-06 | J3 3V3/TX/RX/GND + R22 | Cumple |
| MCU-07 | D5 + R23 en GPIO40 | Cumple |

## Hallazgos

Severidad: **C** crítico · **A** alto · **M** medio · **B** bajo.

| ID | Sev. | Hallazgo | Evidencia | Requisito | Cambio propuesto |
|---|---|---|---|---|---|
| VAL-0022-01-01 | M | El KT-0603R pasa a ser el LED de toda la placa (D4, D5 y D6–D11), pero ningún documento registra su polaridad. `mcu.md` §11 dice que sus datos están en `bloque-alimentacion.md` (D4), y esa ficha solo trae el LCSC, el tipo y el stock: no tiene V_F, I_F ni polaridad. La numeración de su datasheet es la **inversa** de la de KiCad, y su marca no sigue la regla de la ficha del KT-0603YG («barra ancha de la T = cátodo»): aplicar esa regla aquí da la polaridad al revés en el montaje | PDF de LCSC C2286, p. 2: ① «+» (ánodo); ② «−» (cátodo), con la marca verde de la vista superior en ②; en la vista inferior, el triángulo verde tiene la base en ① y apunta a ②. `LED_0603_1608Metric`: pad 1 = K = ② del datasheet. `bloque-alimentacion.md` fila D4; `KT-0603YG.md` §Pinout | MCU-07, REL-07, ALI-10, FAB-05 | jr-conformidad: ficha `hardware/componentes/KT-0603R.md` con V_F, I_F, P_d (pp. 3-4) y la polaridad («cátodo = ② del datasheet = pad 1 de KiCad; marca verde en el lado del cátodo»). Corregir la frase de `mcu.md` §11. Antes de la spec de Salidas (D6–D11) o en la de mantenimiento |
| VAL-0022-01-02 | B | La cota I_mín de D5 se calcula con VDD nominal, mientras que I_máx usa VDD máx. Con VDD mín. 3,211 V (§1) y la tolerancia de V_F (±0,05 V, p. 4): (0,8 × 3,211 − 2,45)/1 k = 0,12 mA, no ≥ 0,24 mA. La conclusión no cambia: §7 no garantiza el brillo, y a 1–2 mA la V_F real es ≈ 1,85 V | `mcu.md` §7, viñeta I_mín; KT-0603R p. 4 (bins y tolerancia) y p. 5 (curva I–V) | MCU-07 | Escribir I_mín ≥ 0,12 mA (peor caso) o calcularla con la V_F a corriente baja de la curva de la p. 5 |
| VAL-0022-01-03 | B | `hardware/v2/README.md` describe la PCB y la verificación como estaban antes del paso 2: dice que a la PCB le faltan las piezas de alimentación (§PCB) y da paridad 32 con 108 sin conectar. La PCB ya tiene las 80 huellas, paridad 0 y 172 sin conectar | `hardware/v2/README.md`, §PCB y último párrafo de «Cómo se trabaja»; la salida de `verificar.py` de este informe | KIC-02 | ing-esquematicos o el coordinador: actualizar los dos párrafos con el estado tras SPEC-0022 |
| VAL-0022-01-04 | B | El cambio de D5 a rojo se aplica como cambio de compra de DEC-0007. VAL-0021-01 lo había calificado como cambio de diseño que decide el usuario, porque se pierde la distinción por color. Solo consta en el diario del coordinador del 2026-11-07, sin DEC ni línea en DEC-0007. No incumple ningún requisito (MCU-07 no fija el color) y `mcu.md` §7/§12 lo compensa con la serigrafía «STATUS» | VAL-0021-01, §Propuestas DEC-0007; `gestion/logs/coordinador/2026-11-07.md` l. 11; `mcu.md` §7; log 01, Pendiente | MCU-07 | Coordinador: dejar constancia de la conformidad del usuario (una línea en DEC-0007 «Consecuencias» o en el diario) |

## Propuestas para las checklists

- **Esquema (campos):** cada pieza con polaridad que se use en la hoja (LED, diodos) tiene que tener su ficha con la correspondencia entre la numeración del datasheet y los pads de KiCad. La numeración del fabricante puede ser la inversa de la de KiCad. Es la propuesta de VAL-0021-01 para librerías, aplicada a las piezas que llegan de otra hoja.
- **Layout (verificación):** el cruce pad↔netlist y el diff semántico frente al commit anterior (huellas existentes sin cambios salvo la red) cuando la PCB se sincroniza por script. Es la propuesta de VAL-0019-02, todavía fuera de `layout.md` v5.

## Veredicto

**APROBADO_CON_OBSERVACIONES**: 1 M y 3 B, sin C ni A. Se cumplen todos los criterios de aceptación. VAL-0022-01-01 afecta a la spec de Salidas (D6–D11): conviene corregirla antes de esa spec o en la spec de mantenimiento de la fase.
