JoanSanbartolome/ESP-Riego/gestion/informes/VAL-0023-01.md

---
id: VAL-0023-01
spec: SPEC-0023
fecha: 2026-11-07
commit_revisado: 992812c
checklists: [esquema v6, requisitos v3]
veredicto: APROBADO_CON_OBSERVACIONES
---

# VAL-0023-01 · Selección y cálculos del bloque de salidas

## Alcance de la revisión

- Nivel completo, commit 992812c (rama `spec/SPEC-0023-calculos-salidas`). Artefactos: `docs/diseno/salidas.md` y el log `01-ing-esquematicos.md` (este, leído al final).
- Entradas contrastadas: `docs/02` v0.4 (REL-01…10, ALI-01/12/13, FAB-03/07/09, §5, §6), `estudio-salidas.md` §1.2 y tabla de datos de entrada, `mcu.md` §1, §7, §8.2, §9.2, §10.2, §11 y Anexo C, `alimentacion.md` §3.13, §4, §7 y §8, DEC-0007.
- BTT6050-1ERA Rev. 1.00 releído: pp. 4, 6-8, 13, 15, 22-31, 34, 43-44 y 47-48 (pp. 6, 10, 13, 15, 34, 43, 44, 47 y 48 renderizadas).
- Huellas: `esp-riego:Infineon_PG-TDSO-14…` (pads), `R_0805_2012Metric`, `C_0805_2012Metric` y `R_1206_3216Metric` de KiCad 10 (lectura del `.kicad_mod`). Símbolo `esp-riego:BTT6050-1ERA`: pines 1-15 ✔.
- LCSC JSON (2026-11-07): C534868, C17713, C17902, C23253, C95872.
- Sin KiCad ni MCP.

## Comprobaciones automáticas

| Comprobación | Resultado |
|---|---|
| ERC / DRC / paridad | No aplica: el commit solo toca `docs/`, `gestion/logs/` y la memoria del autor |
| Recalculado independiente (script propio) | Divisor de IS, tabla de fallo, rango normal, R_OL, E_AS (ec. 5.1), T_J, IPC-2221: coinciden con el documento salvo lo indicado en los hallazgos |
| LCSC | MPN correctos: C534868 = BTT6050-1ERA (1 638, 1,0889 $ en el tramo de 30); C17713 = 0805W8F4702T5E (150 V); C17902 = 1206W4F1002T5E (0,25 W, 200 V); C23253 = 0603WAF8200T5E; C95872 = M7 (1 kV, 5 µA a 1 kV) ✔ |
| Referencias | Alimentación llega a R15, C22, D4, J1, U4; MCU, a R25, C26, D5, J3, U6, SW2. Salidas: U7–U12, J4–J9, R26–R68, C27–C46, D6–D17. Sin choques; el mapeo por canal del Anexo B cuadra (43 R, 20 C) ✔ |

## Criterios de aceptación de la spec

| Criterio | Evidencia | Resultado |
|---|---|---|
| REL-01…REL-10 con pieza o cálculo, datasheet y página | §14 y secciones citadas | Cumple |
| V_ADC ≤ 3,1 V en fallo, corriente de *clamp* dentro del límite | Divisor 0,0744–0,0772; 2,24 V a 30 V; 2,76 V a 36,7 V; con la cota física V_IS = V_S, 2,32 / 2,83 V (B-01). < VDD mín. 3,211 V: sin inyección | Cumple |
| Carga abierta en OFF: fuga ≤ 1 mA, sin activar, margen frente al umbral | 0,64 mA a 30 V, 0,78 mA a 36,7 V; 0,10 V en la bobina; R_L < 90 kΩ ⇒ sin aviso; R_fuga ≥ 159 kΩ ⇒ aviso (p. 24, p. 30) | Cumple |
| R_PD y R_IN/R_DEN coherentes con `mcu.md` §10.2 | 100 kΩ C25803 en el lado del GPIO, una en OUT_DEN; 2,39 V ≥ 2,0 V; 5 mV ≪ 0,8 V (p. 34) | Cumple |
| E_AS con 2 válvulas bajo la curva, inductancia justificada | E = 540·L/R² J a 30 V: Bermad 81–150 mJ; curva ≈ 155 mJ a 1 A (Fig. 12, p. 13); τ 9–16,7 ms justificado con solenoides AC; L a medir (B-04) | Cumple (condicionado a la medida de REL-03) |
| T_J con margen a 60 °C | 0,34 W × 50 K/W → 77 °C (Fig. 7, p. 10; p. 15; p. 8) | Cumple |
| Referencias sin choque y nota U5/U6 | §1 y §9; U5/U6 son IDs de `estudio-salidas.md` l. 30-31 | Cumple |
| Lista de piezas con LCSC, stock y piezas nuevas | §9 y Anexo A | Cumple |

## Requisitos

| Requisito | Evidencia | Resultado |
|---|---|---|
| REL-01, REL-02, REL-06, REL-09, FAB-07, FAB-09 | §8, §9 | Cumple |
| REL-03 | §2.2, §5; L pendiente de medir antes de cerrar el esquema | Cumple (condicionado) |
| REL-04 | §2.2; R_PD única barrera con JP1 cerrado | Cumple |
| REL-05 | 1,2 mm: ΔT 37,8 °C a 4,9 A, 16,5 °C a 3,4 A, ≈ 1 °C a 1 A | Cumple |
| REL-07 | LED desde IN_n, 1,5 mA, dentro de la reserva de 18 mA de `mcu.md` §8.2 | Cumple |
| REL-08 | §4.1, §6, §12 | Cumple |
| REL-10 | §3, §12; umbral de carga abierta en ON con poco margen (M-02) | Cumple |
| FAB-03 | §11; separación de `Salidas` imposible en varias huellas (M-01) | Parcial |

## Hallazgos

Severidad: **C** crítico · **A** alto · **M** medio · **B** bajo.

| ID | Sev. | Hallazgo | Evidencia | Requisito | Cambio propuesto |
|---|---|---|---|---|---|
| VAL-0023-01-01 | M | La tabla de §11 fija `Salidas` con **≥ 1 mm** de separación en OUT_n, pero varias huellas de la red no lo permiten: BTT, pads OUT 10-12 a 0,735 mm del EP (VS) y a 0,62 mm de los NC 9 y 13; R_OL 0805, 0,80 mm entre pads; C_OUT 0805, 0,90 mm. La propia tabla da 0,6 mm a R_OL. El DRC del layout fallará con la clase de red. Eléctricamente basta: IPC-2221 B2 da 0,6 mm hasta 100 V (V_DS(AZ) ≤ 75 V) | `esp-riego:Infineon_PG-TDSO-14…` (pads x = ±2,73, 1,34 × 0,65; EP 2,65 × 6,4); KiCad `R_0805_2012Metric` (±0,9125, 1,025) y `C_0805_2012Metric` (±0,95, 1,0); `salidas.md` §11; FAB-03 | FAB-03 | En §11, fijar la excepción: regla propia de 0,6 mm dentro de las huellas U7–U12, R57–R62 y C33–C38 (y en sus pads), y 1 mm en el resto de OUT_n. Alternativa: R_OL y C_OUT en 1206 (1,8 mm), si hay línea Basic sin empeorar el coste |
| VAL-0023-01-02 | M | La corriente mínima de una válvula (fila de 0,135 A, «caliente, bus a 18 V», §3.2) sale de 0,18 A × 18/24, es decir, de R = 133 Ω. Es menos que los 156 Ω a 20 °C del propio documento (§5) y no incluye el calentamiento de la bobina. Con 156 Ω a ≈ 100 °C (205 Ω) y el bus a 17,5 V: I_L ≈ 85 mA. k_ILIS ± 44 % (interpolación logarítmica entre 50 mA y 0,5 A, p. 30) y R_IS −1 %: V_ADC ≥ 30 mV, y con el ± 10 mV del ADC, **20 mV < 25 mV**, el umbral de «carga abierta en ON» de §12: falso aviso posible. Con la bobina a 80 °C queda en el umbral (25 mV) | `salidas.md` §3.2 (tabla normal), §12; BTT p. 30 (k_ILIS0/1); `estudio-salidas.md` §1.2 b (156 Ω, 4,2 W) | REL-10 | Recalcular la fila con R a 20 °C, la temperatura de la bobina en marcha (justificada o supuesta y marcada) y 17,5 V. Bajar el umbral a ≈ 18 mV: la carga abierta real da < I_IS(OL) × R_IS + 10 mV ≈ 17 mV, con I_L < I_L(OL) (p. 30, Fig. 44-45). Si no, dejar el margen como punto a medir en §13 |
| VAL-0023-01-03 | B | «El pin IS nunca pasa de V_S − 1 V» (§3.1): V_S − V_IS(RANGE) ≥ 1 V solo está especificado con I_IS = 6 mA, y aquí circulan 1,3–3,3 mA. La cota segura es V_IS ≤ V_S (máximo absoluto, p. 6): 2,32 V a 30 V, 2,83 V a 36,7 V y 4,11 V en el impulso. Sigue cumpliendo | BTT p. 30 (condición de prueba I_IS = 6 mA), p. 6 (P_4.1.19), Fig. 46 p. 44 | REL-10 | Añadir la fila con V_IS = V_S o una nota con esos valores |
| VAL-0023-01-04 | B | E_AS: el documento dice «cumple con la válvula instalada en todo el rango estimado», con 150 mJ frente a ≈ 155 mJ (margen del 3 %, del orden de la lectura de la figura). Además, la curva empieza en 1 A y se extrapola a 0,44–0,69 A. El «cumple» de la cota alta no está demostrado | Fig. 12, p. 13; `salidas.md` §5 y §0 | REL-03 | Decir «cumple en la cota baja; en la alta, margen dentro de la incertidumbre de la figura» y dejar como condición la medida de L (§13.1), ya prevista |
| VAL-0023-01-05 | B | Umbral de sobrecarga (450 mV): con 2 válvulas de diseño en frío y la entrada a 30 V (dentro de ALI-01), I_L = 0,686 A, k −19 % y V_ADC ≤ 468 mV: aviso falso. A 24,5 V (0,56 A, 412 mV) no hay aviso | `salidas.md` §12; BTT p. 30 | REL-10 | Anotar en §12 que «nunca con 0,56 A» vale a ≤ 24,5 V, o calcular el umbral a 30 V |
| VAL-0023-01-06 | B | Citas y cifras menores: (a) «abre a > 15 V (`estudio-salidas.md` §1.2)»: ese dato no está en el estudio, que solo dice «muy por debajo de su tensión de apertura»; (b) §0 da 0,08 V sobre la bobina junto a 0,64 mA a 30 V, pero a 30 V son 0,10 V (§3.3); (c) desmagnetización «14 ms»: con la ec. 5.1 salen ≈ 11–12 ms; (d) «R_IS de 1,2 kΩ en el pin IS (Tabla 11, p. 48)»: la Fig. 52 (p. 47) pone R_IS en el lado del ADC, como la topología elegida. La razón real para 820 Ω es el divisor (1,2 kΩ daría 3,16 V a 30 V); (e) V_S(OP) e I_L(NOM) se citan en Tabla 3 / Tabla 7, pero están en la Tabla 4 (p. 8) y la Tabla 6 (p. 15) | `salidas.md` §0, §2.1, §3.1, §3.3, §5 | — | Corregir las citas y las cifras |

## Propuestas para las checklists

- `esquema.md`, «Entregables para layout»: la separación de cada clase de red (p. ej. `Salidas` ≥ 1 mm) se comprueba frente al hueco entre pads de las huellas conectadas a esa red; si no cabe, la tabla fija la excepción (VAL-0023-01-01).
- `esquema.md`, «Cálculos»: los umbrales de diagnóstico del firmware se comprueban con la carga mínima real (bobina caliente, bus mínimo) y la máxima (bobina fría, entrada máxima de ALI-01), con la tolerancia del sensor y la del ADC (VAL-0023-01-02, -05).
- `esquema.md`, «Cálculos»: una cota del datasheet solo vale en su condición de prueba (p. ej. V_S − V_IS(RANGE) a I_IS = 6 mA); fuera de ella, se usa el límite físico (VAL-0023-01-03).

## Veredicto

**APROBADO_CON_OBSERVACIONES**: 2 M y 4 B, y los 8 criterios de aceptación se cumplen. La M-01 afecta a la tabla de layout y la M-02 a las notas de firmware; ninguna cambia las piezas de SPEC-0024. Pendiente del usuario (REL-03): medir L antes de cerrar el esquema (SPEC-0025).
