JoanSanbartolome/ESP-Riego/gestion/informes/VAL-0021-01.md

---
id: VAL-0021-01
spec: SPEC-0021
fecha: 2026-11-07
commit_revisado: 73af0ee
checklists: [librerias v3, esquema v6 (punto FAB-02)]
veredicto: APROBADO_CON_OBSERVACIONES
---

# VAL-0021-01 · Piezas del bloque MCU

## Alcance de la revisión

Nivel completo. Rama `spec/SPEC-0021-piezas-mcu`, commit 73af0ee. Revisados:
- las huellas `esp-riego:ESP32-S3-WROOM-1`, `SW_Push_1P1T_XKB_TS-1187A` y `USB_C_Receptacle_HRO_TYPE-C-31-M-12`;
- `3d/SW_Push_1P1T_XKB_TS-1187A.step` y su generador;
- las fichas nuevas TS-1187A-B-A-B, KT-0603YG y B-2100S04P-A110, y las actualizadas ESP32-S3-WROOM-1 y TYPE-C-31-M-12;
- la tabla de stock y la tabla de campos del log 01.

Revisión independiente en `scratchpad\v21\` (placas de prueba con el `.kicad_pro` de `hardware/v2`). MCP no usado.

## Comprobaciones automáticas

| Comprobación | Resultado |
|---|---|
| `verificar.py hardware/v2` | ERC 0 · DRC 0 (108 sin conectar: PCB sin rutar, esperado) · paridad 0. `.kicad_prl` intacto (md5) |
| `diff` frente a las oficiales de KiCad 10.0.6 | WROOM: solo `generator`, `descr` y 12 × `drill 0.2→0.3`. TS-1187A y HRO: solo `generator`, `descr` y la ruta del modelo |
| DRC de la placa de prueba (reglas de v2) | Huella propia del WROOM: 0 `drill_out_of_range`. Control con la oficial: 12. Resto de avisos, artefactos de la placa sin redes: pads A/B superpuestos del USB-C, serigrafía de `REF**` del LED y `lib_footprint_mismatch` (también en la oficial) |
| Gerber F/B.Mask y F.Paste (zona del EPAD) | B.Mask: 0 aperturas (las vías van tapadas por debajo). F.Mask: 13 aperturas (EPAD y 12 vías). F.Paste: 9 cuadrados de 0,9 mm |
| `pcb render` superior y frontal | El 3D del TS-1187A queda sobre los 4 pads, con la marca del pin 1 sobre el pad 1 (−3; −1,875). WROOM y HRO, alineados |
| Caja del STEP del TS-1187A | x ±3,25 · y ±2,55 · z 0–1,5 (mm) |
| API de JLCPCB (2026-11-07, 15 códigos por muestreo) | Tipo igual al del log en los 15. Stock dentro de ±9 % del 2026-11-06 |

## Criterios de aceptación de la spec

| Criterio | Evidencia | Resultado |
|---|---|---|
| Símbolo, huella y 3D resolubles; pines↔pads frente al datasheet | Script de pines↔pads: 0 faltas, 0 sobras. Comprobado frente al datasheet: WROOM (tabla 3-1, p. 11), USBLC6 (p. 1), HRO (orden de pads del *layout*, hoja única), TS-1187A (A-B / C-D, hoja única) y LED (pad 1 = K). Los `.step` existen | Cumple (véase -07) |
| 3D del TS-1187A en `.step`, alineado, con el pin 1 confirmado por render | Render propio y caja del STEP | Cumple (véase -04) |
| Vías conforme a FAB-02; *keepout* en todas las capas | Vías 0,3/0,6 (anillo 0,15) y DRC frente al control; zona de 48 × 21 mm en F/B/In1–30.Cu, sin pistas, vías, pads, relleno ni huellas | Cumple |
| Tipo y stock de todas las piezas de §11 con fecha; DEC-0007 | Tabla del log: 19 principales y 8 alternativas, a 2026-11-06. Ninguna principal sin stock | Cumple |
| Fichas nuevas y la del WROOM con la N8 | Las 3 fichas existen; WROOM con N8, N16, R8/R16V y antena | Cumple (véanse -01 y -06) |
| Checklist de librerías v3 punto por punto | Repaso en el log 01; esta revisión lo completa | Cumple |

## Requisitos

| Requisito | Evidencia | Resultado |
|---|---|---|
| MCU-01 | Ficha con la N8 fija y la N16 de alternativa; N4 descartada | Cumple |
| MCU-02 | *Keepout* de la oficial conservado | Cumple |
| MCU-03, MCU-04, MCU-06, MCU-07 | J2/U6, SW1/SW2, J3 y D5 con huella, 3D y ficha | Cumple |
| FAB-02 | 12 vías de 0,3/0,6; DRC sin errores de taladro | Cumple |
| FAB-11 | 3D de todas las piezas del bloque (TS-1187A propio, HRO de respaldo) | Cumple |
| KIC-01 | Modelos propios con `${KIPRJMOD}/../libraries/3d/`; tablas sin cambios | Cumple |

## Hallazgos

Severidad: **C** crítico · **A** alto · **M** medio · **B** bajo.

| ID | Sev. | Hallazgo | Evidencia | Requisito | Cambio propuesto |
|---|---|---|---|---|---|
| VAL-0021-01-01 | M | La polaridad del LED está escrita de forma ambigua. La ficha dice que la marca en «T» «señala el cátodo», sin decir qué extremo de la T. En el dibujo, el diodo tiene el cátodo abajo, que es el lado de la barra ancha de la T; el trazo estrecho apunta al ánodo. Leída como «la T apunta al cátodo», la ficha da la polaridad al revés | `KT-0603YG.pdf` p. 2 (vista inferior y símbolo del diodo); `hardware/componentes/KT-0603YG.md` §Pinout | MCU-07 | Escribir: «cátodo en el lado de la barra ancha de la T (abajo en la vista inferior de la p. 2, igual que el símbolo dibujado al lado); pad 1 (K) de `LED_0603_1608Metric`» |
| VAL-0021-01-02 | M | La tabla de campos no está lista para SPEC-0022. En la columna `Datasheet` hay marcadores «(PDF de LCSC Cxxxx)» en 10 filas. U5 y U6 enlazan rutas relativas a la raíz del repositorio, que KiCad no abre desde `hardware/v2`, aunque sus fichas tienen la URL del fabricante. Afecta a la spec siguiente: corregir antes del merge (DEC-0005) | Log 01, «Tabla de campos por referencia»; `ESP32-S3-WROOM-1.md` y `USBLC6-2SC6.md` (campo `datasheet:`) | FAB-05 | Usar la URL del fabricante. Si no la hay, usar el `dataManualUrl` de LCSC que da la API, o `${KIPRJMOD}/../componentes/datasheets/<MPN>.pdf` |
| VAL-0021-01-03 | B | El paso de las vías a 0,3 mm acerca el taladro a la pasta del EPAD: queda a 0,10 mm de los cuadrados de pasta (antes, 0,15). Además, el anillo de 0,6 entra 0,05 mm en ellos. Las vías están abiertas en F.Mask y tapadas solo por debajo, así que pueden absorber soldadura o sacarla por la cara inferior. La pasta cubre el 48 % del EPAD | Pads `""` F.Paste de 0,9 en (−2,9/−1,5/−0,1; 1,06/2,46/3,86) y vías a 0,7 de sus centros; Gerber B.Mask sin aperturas | FAB-02 | Anotarlo para layout y fabricación: aceptar, o pedir vías rellenas y tapadas. WROOM p. 41: soldar el EPAD no es obligatorio |
| VAL-0021-01-04 | B | El 3D del TS-1187A no tiene el escalón de la tapa de 0,9 a 1,2 mm, y el cuerpo empieza a z = 0,15, separado de la placa. La altura máxima (1,5) es correcta, así que no afecta a FAB-11 | `TS-1187A-B-A-B.pdf`, alzado (cotas 0,9, 1,2 y H); niveles z del STEP: 0 / 0,15 / 0,3 / 0,85 / 0,9 / 1,5 | FAB-11 | Anotar en la ficha que el escalón de 1,2 se omite. Opcional: bajar la tapa a z = 0 en el generador |
| VAL-0021-01-05 | B | El taladro de J3 (1,0 mm) no llega a la diagonal máxima del pin más 0,1 mm (0,933 + 0,1 = 1,033). Es el taladro habitual para pines de 0,64 mm, y la holgura nominal es de 0,07 mm. La justificación de la ficha («práctica habitual») es escueta | `B-2100S04P-A110.pdf`, SQ 0,64 ± 0,02; huella oficial `PinHeader_1x04_P2.54mm_Vertical` (taladro 1,0, pad 1,7) | MCU-06 | Aceptarlo, anotando en la ficha que es una excepción justificada por ser el estándar de las tiras de 2,54 mm. Opcional: una copia con taladro de 1,05 (anillo 0,325) |
| VAL-0021-01-06 | B | Ni la ficha del LED ni la de la tira dan una URL de datasheet, solo el espejo local. La del TS-1187A da una URL de XKB que no responde. La checklist pide que LCSC quede como espejo enlazado | `KT-0603YG.md`, `B-2100S04P-A110.md` y `TS-1187A-B-A-B.md` (campo `datasheet:`); la API da `lcsc_datasheet_…_C2289.pdf`, `…_C124378.pdf` y `…_C318884.pdf` | — | Añadir el `dataManualUrl` de LCSC como espejo en las tres fichas |
| VAL-0021-01-07 | B | El log solo comprueba frente al datasheet los pines del WROOM. Para el resto, comprueba solo que los pines y los pads coinciden en número y nombre. El criterio pide el datasheet con su página; lo cubre esta revisión | Log 01, §Repaso, «Símbolo» | KIC-01 | En próximas specs de piezas, citar la página del pinout de cada pieza en el log |
| VAL-0021-01-08 | B | La ficha `TYPE-C-31-M-12.md` cambia de huella y de 3D, pero conserva `stock_consultado: 2026-11-05`. El stock actual está en el log (324 114 a 2026-11-06) | `TYPE-C-31-M-12.md`, *frontmatter* | — | Actualizar la fecha y el stock |

### Tabla de cotas: piezas creadas o modificadas

| Pieza | Cota | Datasheet | Huella o 3D | Resultado |
|---|---|---|---|---|
| TS-1187A, pads | X 5,0/7,0 → ±3,0, ancho 1,0; Y 3,0/4,5 → ±1,875, alto 0,75 | Hoja única, «P.C.B LAYOUT» | 1,0 × 0,75 en (±3; ±1,875) | Cumple |
| TS-1187A, mapeo | A-B unidos (arriba), C-D unidos (abajo) y contacto entre los dos pares | Hoja única, símbolo | Pads «1» arriba (y = −1,875) y «2» abajo | Cumple |
| TS-1187A, 3D | Cuerpo 5,1; ancho con terminales 6,5; terminal 0,5 a ±1,85 (3,7); tecla Ø 2,0; H 1,5 | Vista superior y alzado | 5,1 × 6,5 × 1,5; terminales a ±1,85; tecla Ø 2,0 | Cumple (-04) |
| WROOM, EPAD | 3,7 × 3,7 en 3 × 3 cuadrados de 0,9; 12 vías en los huecos | Fig. 11-1, p. 45 | Cobre 3,9 × 3,9; pasta 9 × 0,9; 12 vías en (±0,7/±1,4) desde el centro | Cumple; sin cambios salvo el taladro |
| WROOM, pads 1–40 | 40 × 1,5 × 0,9 a 1,27 mm | Fig. 11-1, p. 45 | `diff` sin cambios frente a la oficial | Cumple |
| WROOM, pin 1 | Pin 1 arriba a la izquierda, junto a la antena | Fig. 11-1, p. 45 | Triángulo en la serigrafía y 3D oficial | Cumple |
| HRO, orden de pads | A1/B12, A4/B9, B8, A5, B7, A6, A7, B6, A8, B5, B4/A9, B1/A12; 4 × 0,6 y 8 × 0,3; NPTH a 5,78 | Hoja única, «RECOMMEND P.C.B LAYOUT» | x −3,25 … 3,25 en ese orden; NPTH a ±2,89 | Cumple |

### Propuestas DEC-0007 del log (observaciones para el coordinador)

- **C23 → C15849 (CL10A105KB8NNNC, Basic): se puede aplicar.**
  - SimSurfing da −18,4 % a 3,3 V (lo he comprobado).
  - τ mín. = 10 k × 0,99 × 1 µ × 0,9 × 0,816 × 0,984 = 7,16 ms. EN/VDD en el caso del buck de 6 ms ≈ 0,159 < 0,25. La liberación llega a ≥ 9,9 ms, ≫ 50 µs.
  - Pasa de X7R 16 V a X5R 50 V: con 60 °C de ambiente no empeora ningún requisito.
  - Quita una referencia Extended. Requiere actualizar `mcu.md` §5.1 (τ y tabla) y §11.
- **U6 → UMW C2687116: no se aplica sin comparar su datasheet.**
  - Hay que comparar V_CL (12 V a 1 A y 17 V a 5 A), la capacidad por línea (≤ 3,5 pF) e I_PP frente a la tabla 2 de ST.
  - Las dos son Extended: el ahorro es de ≈ 0,11 $ por placa y no quita ningún cargo.
- **D5 rojo (KT-0603R, Basic): no entra en DEC-0007.**
  - Anula el criterio de `mcu.md` §7 de distinguir el LED de estado del D4 rojo de alimentación (`alimentacion.md` §3.11). Es un cambio de diseño, no de compra.
  - A cambio, quita un cargo Extended y une la línea con D4 (C2286).
  - Lo decide el usuario.

## Propuestas para las checklists

- **Librerías (huella):** al cambiar el taladro de vías dentro de un EP, medir la distancia del taladro a las aperturas de F.Paste (pads `""`) y la cobertura de pasta. Mirar también si F.Mask/B.Mask dejan las vías abiertas por arriba.
- **Librerías (ficha):** describir la polaridad de LEDs y diodos sin ambigüedad: qué extremo de la marca es el cátodo, con la página. La huella sola no basta.
- **Librerías (taladro THT):** admitir 1,0 mm para pines de 0,64 mm cuadrados (tiras de 2,54 mm) como excepción tipificada, en lugar de justificarla cada vez.
- **Esquema (campos):** la tabla de campos que se entrega para el esquema usa en `Datasheet` URLs o rutas `${KIPRJMOD}`, sin marcadores ni rutas relativas a la raíz del repositorio.

## Veredicto

**APROBADO_CON_OBSERVACIONES**: 2 M y 6 B, sin C ni A. Todos los criterios se cumplen. VAL-0021-01-02 afecta a SPEC-0022: corregir antes del merge.
