JoanSanbartolome/ESP-Riego/gestion/informes/VAL-0019-01.md

---
id: VAL-0019-01
spec: SPEC-0019
fecha: 2026-11-06
commit_revisado: e4dbf44
checklists: [esquema v5]
veredicto: RECHAZADO
---

# VAL-0019-01 · Hoja de alimentación de la v2

## Alcance de la revisión

Nivel completo, rama `spec/SPEC-0019-hoja-alimentacion`, commit e4dbf44. Revisados: `hardware/v2/alimentacion.kicad_sch`, `esp-riego.kicad_sch` (pines de hoja), `conectores.kicad_sch` (texto), `fp-lib-table`, `sym-lib-table`, `README.md`, `docs/diseno/alimentacion.md` §0, §3, §7 y §8. Todo sobre una copia en el *scratchpad* (`…/scratchpad/v19/`): `verificar.py`, netlist XML, PDF, DRC de placas de prueba con las reglas del `.kicad_pro` de v2. Sin MCP de proyecto (estado: nada cargado). MD5 del proyecto iguales antes y después.

## Comprobaciones automáticas

| Comprobación | Resultado |
|---|---|
| ERC | 0 errores, 0 avisos (5 hojas) |
| DRC | 0 (la PCB solo tiene H1–H4) |
| Paridad esquema↔PCB | 55 `missing_footprint`: las 55 piezas de la hoja (VAL-0019-01-01) |
| DRC de placa de prueba con U1 | 9 `drill_out_of_range` (VAL-0019-01-02) |
| DRC de placa de prueba con las otras 20 huellas de la hoja | 0 errores (solo avisos propios de la prueba: tabla de librerías y `REF**`) |
| JLCPCB API (2026-11-06) | C14663 Basic 34 758 297 · C136967 Extended 14 042 · C1591 Extended · C28323 Basic · C513710, C381466, C1850278, C1858395 Extended con stock |

## Criterios de aceptación de la spec

| Criterio | Evidencia | Resultado |
|---|---|---|
| Cada pieza y valor coinciden con `alimentacion.md` | 55/55 referencias de §7 en la hoja; valor, huella, LCSC y MPN iguales; redes de la netlist iguales a §2, §3 y §7 (abajo) | Cumple |
| `verificar.py`: ERC 0, sin errores de paridad nuevos (justificados por piezas sin colocar) | ERC 0; paridad 55 nuevas por piezas **no sincronizadas**, no «sin colocar» | **No cumple** (01) |
| VAL-0014-01-01 y 02 resueltas | (a) texto de `conectores.kicad_sch` corregido; (b) texto antiguo de alimentación eliminado; tablas solo con `esp-riego` | Cumple |
| Ninguna pieza usa una librería de la v1 | `lib_id`: Device, Connector, Jumper, Transistor_FET, Power_Management, Regulator_Linear, power, esp-riego; huellas oficiales de KiCad 10 o `esp-riego` (todas existen) | Cumple |

Comprobado además:

- Pinouts frente a datasheet: TPS2663 RGE (SLVSE94G tabla 5-1, pp. 3-4: IN 1-2, B_GATE 3, DRV 4, IN_SYS 5, UVLO 6, PLIM 7, GND 8, dVdT 9, ILIM 10, MODE 11, SHDN 12, IMON 13, FLT 14, PGTH 15, PGOOD 16, OUT 17-18, EP 25 a GND); TPS2116 DRL (SLVSFG1A p. 3); LMR36520 (pin 9 = EP a GND); TLV1117 (1 GND, 2/pestaña OUT, 3 IN); SUD50P06-15 con TO-252-2 (pad 2 = pestaña = D). Cumplen.
- Redes: Q1 D→`VIN_F`, S→`VIN_PROT`; D1 K en S, A en G; D2, D3 y C1 con la polaridad correcta; FB tomada en `+5V_BUCK`; MODE de U3 = VIN1; R5 *pull-down* de SHDN; R6 *pull-up* de FLT a +3V3; R3/R4/C5 de IMON; R14/R15/C20; U1 UVLO, PLIM y PGTH a GND; B_GATE, DRV, MODE, PGOOD, PG y ST con marca de no conexión.
- **JP1** en paralelo con U1: pad 1 `VIN_PROT` (IN/IN_SYS), pad 2 `BUS_24V` (OUT). Texto «JP1: abierto = limitador · cerrado = sin limitador» en la hoja. `in_bom no`, `in_pos_files no`. Cumple DEC-0006.
- **README:** sección JP1 con las pérdidas de §3.13.9 (limitación, LIM_EN, FLT/IMON, *clamp*, dVdT; REL-04 se mantiene). Cumple.
- **VAL-0018-02-04:** §7 con `esp-riego:SMBJ33A`, huella DDA0008B, C22, C3 y C10 en 0805 (C513710, C28323); §8 con la conexión sólida de JP1 y el soldador. Cumple.
- **DEC-0007:** R8 C136967 (RT0603BRD0724K9L, 0,1 %, 25 ppm, como R7); 6 × 100 nF a C14663 (X7R 50 V 0603, igual que C1591), Basic confirmado en JLCPCB. Cumple.
- Referencias reservadas al MCU sin usar. Sin duplicados.
- Cajetín en el PDF (pág. 4/5): «Alimentación: protecciones, limitador, buck y 3,3 V», hoja Alimentacion, rev. 2.0-dev, 2026-11-06, A3. Cumple.
- Recalculado: VOUT 5,016 V; k UVLO 11 → 13,54 V; I_OL 18,09/4,30 = 4,207 A; k VIN 21,534; PR1 k 4,3; LED 1,4 mA. Coinciden con la hoja y con §3.
- +5V, +3V3 y GND con símbolos globales: aceptable (VAL-0019-01-04).

## Requisitos

| Requisito | Evidencia | Resultado |
|---|---|---|
| ALI-01…ALI-11, ALI-13 | Topología de §2 en la netlist; piezas de §7 | Cumple en esquema |
| ALI-12 | Presupuesto de §4 sin cambios | Cumple |
| FAB-02 | Vías del EP de U1 a 0,2/0,5 mm | No cumple (02) |
| FAB-05 | Campos presentes en las 55 piezas; JP1 y TP sin LCSC, fuera de BOM y de posiciones | Cumple |
| KIC-01 | Huellas existentes | Cumple |

## Hallazgos

Severidad: **C** crítico · **A** alto · **M** medio · **B** bajo.

| ID | Sev. | Hallazgo | Evidencia | Requisito | Cambio propuesto |
|---|---|---|---|---|---|
| VAL-0019-01-01 | A | **Paridad: 55 errores nuevos, no justificados por el criterio.** El paréntesis del criterio («piezas sin colocar») se refiere, según el alcance, a piezas sincronizadas con la PCB sin colocar (avisos de DRC por *ratsnest* o solapes), no a piezas ausentes. La PCB no se tocó. La causa está en la spec: asigna la sincronización a ing-esquematicos, que no puede escribir `.kicad_pcb` ni usar `sync_schematic_to_board`. Efecto: ningún DRC con las reglas de v2 ha pasado por las 55 huellas, y así se escapó 02 | `verificar.py` (copia): paridad 55 `missing_footprint`; SPEC-0019 «Alcance» y criterio 2; `.claude/hooks/guardia.py` l. 48 (`AJENOS`); `.claude/agents/ing-esquematicos.md` l. 54; log 01 l. 46 y 83 | KIC-01, criterio 2 | Antes del merge, en esta rama: corregir 02 y después encargar a ing-layout `sync_schematic_to_board` sin colocar. Volver a pasar `verificar.py`: paridad 0, con los avisos de DRC de piezas sin colocar justificados. Revalidación ligera |
| VAL-0019-01-02 | M | **Las vías térmicas de la huella de U1 no cumplen FAB-02.** `Texas_RGE0024H_…_ThermalVias` tiene 9 vías de 0,2 / 0,5 mm (FAB-02: 0,3 / 0,6; `min_through_hole_diameter` 0,3). Al sincronizar, `verificar.py` falla. Es el mismo fallo que VAL-0018-02-01 en U2 | Placa de prueba con el `.kicad_pro` de v2: 9 `drill_out_of_range` («min hole 0.3000 mm; actual 0.2000 mm»), `…/scratchpad/v19/drcu1/drc.json`. `alimentacion.md` §7 l. 473; `TPS2663.md` l. 11 | FAB-02 | Huella `Package_DFN_QFN:Texas_RGE0024H_VQFN-24-1EP_4x4mm_P0.5mm_EP2.7x2.7mm` (sin vías), con las vías de 0,3 / 0,6 al EP en el layout (SLVSE94G p. 39), o una variante propia con 0,3 / 0,6. Cambiar el campo `Footprint` de U1, `alimentacion.md` §7 (ing-esquematicos) y `TPS2663.md` (jr-conformidad). Antes de 01 |
| VAL-0019-01-03 | B | `alimentacion.md` se contradice en la huella de F1: §3.2 dice `Fuse:Fuse_Littelfuse-NANO2-451_453` (oficial); §7 y la hoja, `esp-riego:` (copia con 3D propio) | `alimentacion.md` l. 84 frente a l. 465 | — | §3.2: `esp-riego:Fuse_Littelfuse-NANO2-451_453` (copia de la oficial con 3D, SPEC-0018) |
| VAL-0019-01-04 | B | El alcance de la spec pide etiquetas jerárquicas para 5 V, 3,3 V y GND, y la hoja usa símbolos de alimentación globales. **Es aceptable:** es la convención de KiCad, coincide con `mcu.md` Anexo C, y mezclar etiquetas jerárquicas con los símbolos `power:` de otras hojas partiría las redes. Lo que falta es dejar constancia | SPEC-0019 «Alcance»; `mcu.md` l. 429-441; log 01 l. 37 | — | Anotar la desviación en el registro de SPEC-0019 (coordinador). No hay que cambiar el diseño |

## Propuestas para las checklists

- `esquema.md`, «Estructura»: «Si la spec cambia piezas, la PCB está sincronizada (paridad 0) antes de validar. Las diferencias por piezas sin colocar se justifican; las piezas ausentes, no.»
- `esquema.md`, «Campos»: «Las huellas con vías térmicas (`*_ThermalVias`) cumplen FAB-02 (0,3 / 0,6 mm). Si no, se usa la variante sin vías.» Ya ha pasado dos veces (VAL-0018-02-01 y VAL-0019-01-02).
- `proceso.md` (para el coordinador): «Antes de encargar, comprobar que cada entregable cae en la zona del agente responsable (`guardia.py`, `ZONAS` y `AJENOS`).»

## Veredicto

**RECHAZADO**: un hallazgo A (criterio 2 sin cumplir). El diseño de la hoja es correcto pieza a pieza y red a red. Para el merge faltan la huella de U1 (02) y la sincronización de la PCB (01).
