JoanSanbartolome/ESP-Riego/gestion/informes/VAL-0019-02.md

---
id: VAL-0019-02
spec: SPEC-0019
fecha: 2026-11-06
commit_revisado: c6b24e2
checklists: [esquema v6]
veredicto: APROBADO
---

# VAL-0019-02 · Hoja de alimentación de la v2 (revalidación)

## Alcance de la revisión

Nivel completo, rama `spec/SPEC-0019-hoja-alimentacion`, commit c6b24e2 (cambios desde e4dbf44: a9495a1…c6b24e2). Revisados: hallazgos VAL-0019-01-01 a 04, `alimentacion.kicad_sch` (diff), `esp-riego.kicad_pcb`, `docs/diseno/alimentacion.md` §3.2, §7 y §8, `TPS2663.md`, `bloque-alimentacion.md` y la spec. Todo sobre una copia en `…/scratchpad/v19b/`. Sin MCP (no se abrió ningún proyecto). MD5 de `hardware/v2` iguales antes y después.

## Comprobaciones automáticas

| Comprobación | Resultado |
|---|---|
| ERC | 0 errores, 0 avisos |
| DRC (reglas del `.kicad_pro` de v2: agujero mín. 0,3, vía 0,6) | 0 errores, 0 avisos; 108 `unconnected_items`, todos por no rutar. `ignored_checks` sin cambios (`.kicad_pro` intacto) |
| Paridad esquema↔PCB | 0 |
| Cruce netlist XML ↔ PCB (script propio) | 55/55 refs; huella, valor y LCSC iguales; red de cada pad numerado igual a la netlist: 0 diferencias |
| Contorno | Edge.Cuts sin cambios (100–200 × 60–130); 55 huellas nuevas en x 11,5–87,5, *courtyard* máx. x 88,96 (C14): todas fuera; ninguna bloqueada |
| H1–H4 | Iguales a e4dbf44 en posición, bloqueo, pads y campos (en el diff solo cambia el orden) |
| PCB | 0 pistas, vías y zonas |

## Criterios de aceptación de la spec

| Criterio | Evidencia | Resultado |
|---|---|---|
| Cada pieza y cada valor coinciden con `alimentacion.md` | Hoja: solo cambia la huella de U1 (diff de 1 línea), igual que §7 | Cumple |
| `verificar.py`: ERC 0, paridad sin errores nuevos | ERC 0, paridad 0; los 108 sin conectar son de las piezas sin colocar (log 05) | Cumple |
| VAL-0014-01-01 y 02 resueltas | Sin cambios desde VAL-0019-01 | Cumple |
| Ninguna pieza usa una librería de la v1 | Sin cambios; U1 oficial `Package_DFN_QFN` | Cumple |

Hallazgos anteriores:

- **01 (A):** resuelto. Paridad 0, con las 55 huellas fuera del contorno y sin colocar.
- **02 (M):** resuelto. La huella de U1 no tiene vías (pad 25 SMD a GND, 3D oficial) en la hoja, en la PCB, en §7 y §8 de `alimentacion.md`, en `TPS2663.md` l. 11 y en `bloque-alimentacion.md` l. 16. La caché `lib_symbols` (l. 2130) mantiene el campo por defecto de la librería, pero la instancia manda (log 04). Es aceptable.
- **03 (B):** resuelto. §3.2 l. 84 coincide con §7 l. 465 (`esp-riego:Fuse_…`).
- **04 (B):** resuelto. Nota en el alcance de la spec.

Checklist v6, punto de vías: cumple. Solo U2 lleva vías (8 de 0,3 / 0,6). J1 (1,3) y TP4 (1,0) son de inserción, no vías. El cajetín no se ha vuelto a comprobar porque la hoja solo cambia en un campo oculto.

## Requisitos

| Requisito | Evidencia | Resultado |
|---|---|---|
| FAB-02 | Agujero mínimo de la PCB 0,3 mm (U2); U1 sin vías | Cumple |
| KIC-01 | Paridad 0; huellas existentes | Cumple |
| ALI-01…ALI-13 | Sin cambios de red ni de valor desde VAL-0019-01 | Cumple en esquema |

## Hallazgos

Ninguno.

## Propuestas para las checklists

- `layout.md`, «Reglas»: «Si la PCB se sincroniza con un script en lugar del actualizador de KiCad, se cruza la red de cada pad con la netlist de `kicad-cli`.» `sync_schematic_to_board` del MCP no sirve en proyectos jerárquicos (log 05).
- Sigue pendiente la propuesta de VAL-0019-01 para `esquema.md`, «Estructura»: «paridad 0 antes de validar». La v6 no la recoge.

## Veredicto

**APROBADO**: sin hallazgos. Los cuatro criterios se cumplen.
