JoanSanbartolome/ESP-Riego/gestion/informes/VAL-0020-01.md

---
id: VAL-0020-01
spec: SPEC-0020
fecha: 2026-11-06
commit_revisado: a406117
checklists: [esquema v5, requisitos v3]
veredicto: APROBADO_CON_OBSERVACIONES
---

# VAL-0020-01 · Selección y cálculos del bloque MCU

## Alcance de la revisión

- Nivel completo, en el commit a406117. `docs/diseno/mcu.md` no cambia desde 9730fc7. DEC-0007 llegó durante la revisión y se ha tenido en cuenta.
- Artefactos: `docs/diseno/mcu.md` y el log `01-ing-esquematicos.md`, contrastados con `alimentacion.md`, `estudio-salidas.md`, `docs/02` v0.4 y DEC-0007.
- Checklists: `esquema.md` v5 («Cálculos», «Microcontrolador», «Entregables para layout») y `requisitos.md` v3 («Estudios de diseño»).
- Datasheets releídos:
  - WROOM-1 v1.8: pp. 3, 11-16, 27-28 y 41;
  - ESP32-S3 v2.2: pp. 16-19, renderizadas;
  - HDG *release master*: pp. 7-9, 13, 15, 18-19 y 28-31, renderizadas;
  - TLV1117LV SBVS160C: pp. 5 y 8;
  - LMR36520: p. 7;
  - TPS2116: pp. 7 y 15;
  - BTT6050: pp. 21 y 34;
  - USBLC6-2SC6: p. 2.
- Librerías oficiales de KiCad 10: pines de los símbolos y *keepout* y pads de las huellas.
- Sin KiCad ni MCP.

## Comprobaciones automáticas

| Comprobación | Resultado |
|---|---|
| ERC / DRC / paridad | No aplica: la rama no cambia archivos de KiCad (`git diff --stat main...HEAD`) |
| Pines de `RF_Module:ESP32-S3-WROOM-1` frente a WROOM-1 tabla 3-1 y a §9.2 | 41 pines; los 36 GPIO de §9.2 coinciden con su número de pin del módulo ✔ |
| `USBLC6-2SC6` (deriva de `USBLC6-2P6`) | 1/6 I/O1, 3/4 I/O2, 2 GND, 5 VBUS ✔ (§4) |
| *Keepout* de `ESP32-S3-WROOM-1.kicad_mod` | Polígono de 48 × 21 mm, en todas las capas de cobre; prohíbe pistas, vías, pads, cobre y huellas ✔ |
| `SW_Push_1P1T_XKB_TS-1187A` | Pads 1, 1, 2 y 2, que casan con `SW_Push` (1, 2). Sin `.step` en KiCad 10.0 ✔ (lo dice §11) |
| 3D de `USB_C_Receptacle_HRO_TYPE-C-31-M-12` | Falta en KiCad; el respaldo `hardware/libraries/3d/…TYPE-C-31-M-12.step` existe ✔ |
| LCSC JSON (2026-11-06), 25 códigos | Los MPN coinciden. C2913198: 3 257 en stock, 4,91 / 4,2345 $ ✔ |
| Coste (recalculado) | 5,61 $ por placa con 5 placas y 4,93 $ con 10 ✔ |

## Recálculos independientes

- **EN** (`val20/en_sim.py`): τ de 8,8 ms (autor) y de 7,35 ms (pesimista: C −10 % × −15 % por polarización × −3 % a 60 °C, R −1 %).
  - Buck con t_SS de 6 ms sin el TPS2116: EN/VDD = 0,132 / 0,155 al llegar VDD a 3,0 V (< 0,25 ✔).
  - Con el TPS2116, que solo conecta VIN1 por encima del umbral de PR1 (3,9–4,72 V) y con su *soft-start*: 0,04–0,08. El caso del autor es, por tanto, conservador.
  - Liberación del reset entre 10 y 21 ms después ✔.
- **+3V3:** 355 + 0,5 + 2,8 + 4,4 + 1,1 + 18 + 50 = 431,8 mA ✔.
  - TLV1117LV: 0,813 W y T_J 108,8 °C con el buck; 0,864 W y 111,8 °C con USB a 5,25 V.
  - Márgenes de caída: 0,88 / 0,72 / 0,37 V.
  - Fig. 6-16: ≈ 40 mV típicos.
  - Todo ✔.
- **REL-04 (*pull-downs*):**
  - con el pin en Z: 50 nA × 100 kΩ = 5 mV;
  - con el GPIO alto: V_IN y V_DEN ≥ 2,64 − 25 µA × 10 kΩ = 2,39 V ≥ 2,0 V (BTT tabla 10, p. 34);
  - carga de OUT_DEN: 183 µA. Todo ✔.
- **Estados de arranque:**
  - S3 tabla 2-1: GPIO39 con WPU después del reset (nota 7); GPIO43/44 con WPU; GPIO45/46 con WPD;
  - tabla 2-2: pulso alto solo en GPIO18–20;
  - HDG tabla 12 (p. 19): GPIO21 de entrada, GPIO38 bajo y GPIO40 alto en la descarga USB-OTG.
  - Coinciden con §9.2 y §10 ✔.
- **Otros cálculos:**
  - I²C: 0,97 kΩ mínimo; t_r de 0,20 µs; 536 pF ✔;
  - LED: 1,2 mA típicos ✔;
  - GPIO3 se ignora con los eFuse por defecto (WROOM-1 tabla 4-5) ✔.
- **C23 (SimSurfing CL21A226MAQNNN):** −32,3 % a 3,3 V y −3,5 % a 60 °C → 14,4 µF típicos; 11,5 µF con −20 % (≥ 10 µF ✔; hallazgo 03).

## Criterios de aceptación de la spec

| Criterio | Evidencia | Resultado |
|---|---|---|
| MCU-01…07 con pieza o cálculo, datasheet y página | §13; páginas comprobadas por muestreo (arriba) | Cumple |
| Tabla de GPIO completa (señal, bloque, dirección, ADC1, estado de arranque) | §9.2: 36 GPIO, todos con su estado en reset, arranque y flasheo; pines del módulo verificados | Cumple |
| Analógicas en ADC1 o alternativa con coste | 8 en ADC1_CH0–CH8 sin CH2 (GPIO3); GPIO10 de reserva | Cumple |
| Nada se activa en el arranque, el reset o el flasheo (REL-04) | §10 + recálculo; OTA y `esp_restart()` por firmware, declarado como interpretación del autor y con prueba (§14.3) | Cumple |
| Presupuesto de 3,3 V con el pico de Wi-Fi frente al TLV1117LV | §8, recalculado | Cumple |
| Piezas con LCSC y stock, y marca de las nuevas | §11 y Anexo A; LCSC del 2026-11-06 coincide | Cumple |

## Requisitos

| Requisito | Evidencia | Resultado |
|---|---|---|
| MCU-01 | N8, de −40 a 85 °C (WROOM-1 tabla 1-1, p. 3) | Cumple |
| MCU-02 | §3 y §12, con la Fig. 26 de la HDG y el *keepout* de la huella | Cumple (hallazgo 04) |
| MCU-03 | §4: CC de 5,1 kΩ, USBLC6 y GPIO19/20 | Cumple (hallazgo 02) |
| MCU-04 | §5: 10 kΩ / 1 µF (WROOM-1 p. 41), SW1 y SW2 | Cumple |
| MCU-05 | §9: ningún pin de arranque con carga; GPIO35–37 solo sin PSRAM octal | Cumple |
| MCU-06 / MCU-07 | §6 / §7 | Cumple |
| ALI-07 | §8.3 | Cumple |
| REL-04, REL-10 (pines), AMB-01, EXP-01, EXP-02 (pines) | §9.2, §10 | Cumple |

**Variantes de DEN** (sin hallazgo; decidido en DEC-0007):

- **A (común, GPIO38):** válida.
  - Cada IS en su propio ADC1, el rearme por IN (BTT p. 21) y GPIO38 bajo en la descarga OTG.
  - Deja 3 GPIO y un segundo bus I²C.
- **B (DEN por canal en 38, 10, 35, 36, 47 y 48):** también cumple REL-04, porque ningún pin tiene WPU ni pulso alto, pero ocupa 28 de 28 pines.
  - Deja EXP_IO2 solo como entrada (GPIO18).
  - El SHT4x comparte el bus con la expansión.

## Hallazgos

Severidad: **C** crítico · **A** alto · **M** medio · **B** bajo.

| ID | Sev. | Hallazgo | Evidencia | Requisito | Cambio propuesto |
|---|---|---|---|---|---|
| VAL-0020-01-01 | M | **C22 duplicada.** `mcu.md` usa C22 para el 1 µF de EN, pero `alimentacion.md` ya la usa para el segundo CIN de U2 (4,7 µF 100 V, SPEC-0018). El log afirma que las referencias «siguen a las de alimentación (… C22–C25)». SPEC-0019 dibuja ya C22 en la hoja de alimentación, y SPEC-0021/0022 toman las referencias de `mcu.md` | `alimentacion.md` §3.6, l. 159, y §7, l. 471; `mcu.md` §5.1, §11, l. 325, y §12; log, l. 92-93 | MCU-04, FAB-05 | Renumerar los condensadores del MCU desde C23 (p. ej. C23 EN, C24 22 µF, C25 100 nF, C26 VBUS) en §4, §5, §8, §11, §12, §13 y §14, y en las notas del log. Corregir antes del merge: afecta a SPEC-0021 y SPEC-0022 |
| VAL-0020-01-02 | B | La tensión de *clamping* del USBLC6 está mal citada: «17 V a 1 A». El datasheet da 12 V a 1 A y 17 V a 5 A (8/20 µs) | USBLC6-2SC6 Rev 5, tabla 2, p. 2; `mcu.md` §4 | MCU-03 | «V_CL 12 V a 1 A, 17 V a 5 A». No cambia la elección |
| VAL-0020-01-03 | B | Al *derating* de C23 le faltan la fuente y la tolerancia: es un «≈ −30 % estimado» y C45783 es ±20 %. El −10 % de C22 en τ tampoco tiene fuente. La conclusión se mantiene: 11,5 µF ≥ 10 µF y EN/VDD ≤ 0,155 con τ = 7,35 ms | SimSurfing CL21A226MAQNNN: −32,3 % a 3,3 V y −3,5 % a 60 °C; LCSC C45783 «±20 %»; `mcu.md` §8.1 y §5.1 | ALI-07, MCU-04 | En §8.1: 22 × 0,677 × 0,965 × 0,8 = 11,5 µF, citando SimSurfing. En §5.1, dar τ_min con la polarización justificada o con un −15 % conservador |
| VAL-0020-01-04 | B | Los «≥ 15 mm» de la antena al buck, los *high-side*, el USB, la UART y el SHT4x se atribuyen a la HDG. La HDG da 15 mm solo como zona libre **dentro de la caja**; para el USB y la UART dice «*as far away … as possible*». En una placa de ≤ 100 × 70 mm, la restricción puede no ser realizable | HDG §1.4.7, p. 30, y p. 28; `mcu.md` §3 y §12 (fila de la antena) | MCU-02, FAB-08 | Marcar los 15 mm como objetivo del autor, no como requisito de la HDG, y dejar que el *floorplan* justifique una distancia menor si hace falta |
| VAL-0020-01-05 | B | Texto desfasado tras DEC-0007 y SPEC-0018 | (1) §0, §9.2 («la propuesta») y §14.1 («lo confirma el coordinador»): DEC-0007 ya fija el DEN común. (2) §11 (C22) y §14.7: C10 ya no es C15849 (es C28323), y C15849 tiene hoy 211 050 en stock en LCSC. (3) C24 sigue en C1591, mientras DEC-0007 pasa los 100 nF a C14663 (LCSC 0 hoy; JLCPCB, sin comprobar). (4) El log sigue en `estado: bloqueado` | MCU-05 | Citar DEC-0007 y marcar B como descartada. Cerrar el punto 7 de §14. Decidir C24 = C14663 si jr-conformidad confirma que es Basic con stock (una línea menos). Cerrar el log |
| VAL-0020-01-06 | B | VBUS tiene dos restricciones distintas: `alimentacion.md` §8 pide 0,5 A y 0,5 mm; `mcu.md` §12 pide 0,5 A (0,75 A con la expansión) y 0,6 mm | `alimentacion.md` l. 530; `mcu.md` §12 | ALI-08 | Unificar en 0,75 A y 0,6 mm en la spec de mantenimiento o en la siguiente edición de `alimentacion.md` |
| VAL-0020-01-07 | B | «D5» designa dos cosas: el LED de estado y la decisión D5 (caja) | `mcu.md` §3 («Se comprueba con D5»), §12 y §14.5 frente a §7 y §11; `docs/02`, l. 197 | — | Escribir «decisión D5 (caja)» o renumerar el LED |

## Propuestas para las checklists

- **`esquema.md` «Cálculos»:** las referencias provisionales de un documento de bloque no chocan con las de los demás documentos de `docs/diseno/`. Se comprueba de nuevo después de traer `main` a la rama (hallazgo 01).
- **`esquema.md` «Entregables para layout»:** una red que aparece en las tablas de restricciones de dos bloques tiene la misma corriente y el mismo ancho en las dos (hallazgo 06).
- **`esquema.md` «Microcontrolador»:** estado de los pines de control en la descarga USB-OTG (HDG tabla 12) y tras un reinicio por software u OTA (REL-04).

## Veredicto

**APROBADO_CON_OBSERVACIONES:** 1 M y 6 B, y todos los criterios de aceptación se cumplen. El hallazgo 01 afecta a SPEC-0021 y SPEC-0022, así que se corrige antes del merge (DEC-0005). Los hallazgos 02–07 pueden ir a la spec de mantenimiento.
