JoanSanbartolome/ESP-Riego/gestion/informes/VAL-0018-01.md

---
id: VAL-0018-01
spec: SPEC-0018
fecha: 2026-11-05
commit_revisado: 52e574f (entregable en 1d68288)
checklists: [librerias v3]
veredicto: RECHAZADO
---

# VAL-0018-01 · Piezas del bloque de alimentación

## Alcance de la revisión

Nivel completo. Rama `spec/SPEC-0018-piezas-alimentacion`, commit 1d68288 (HEAD 52e574f solo añade memoria de otro agente). Se revisan el símbolo `esp-riego:LMR36520FADDA`, las huellas `esp-riego:SolderJumper-2_P1.8mm_Open_Pad1.2x3.0mm` y `esp-riego:Fuse_Littelfuse-NANO2-451_453`, el STEP del fusible, las tablas de `hardware/v2`, las 8 fichas nuevas, `TPS2663.md` y `bloque-alimentacion.md`. También se revisan las piezas oficiales de la lista frente a sus datasheets. MCP: no se ha cargado ningún proyecto (`get_backend_state`: vacío); solo se ha usado `validate_symbol_library` sobre una copia.

## Comprobaciones automáticas

| Comprobación | Resultado |
|---|---|
| ERC (`verificar.py`, copia de `hardware/v2` + `libraries`) | 0 |
| DRC | 0 |
| Paridad esquema↔PCB | 0. LIMPIO |
| `validate_symbol_library` (`esp-riego.kicad_sym`, con kicad-cli) | Válida, 4 símbolos |
| DRC de una placa de prueba con F1, JP1 y U2 | 1 `silk_overlap` en JP1 (hallazgo 07). Los 2 avisos `lib_footprint_issues` se deben a que la placa de prueba no tiene tabla |
| `pcb render` superior y frontal | El 3D del fusible está centrado, apoyado en z = 0, y mide 6,10 × 2,69 × 2,69 (caja del STEP: x ± 3,05, y ± 1,345, z 0–2,69). El punto del pin 1 del 3D de U2 cae sobre el pad 1 |
| JLCPCB, API `selectSmtComponentList` (2026-11-05) | 16 códigos: tipo, stock y precio coinciden con `bloque-alimentacion.md` (deriva de stock ≤ 0,3 %) |
| SimSurfing de Samsung (datos incrustados en la página) | ΔC DC reproducidos: CL31A226KAHNNN −38,0 % (5 V) / −38,9 % (5,107 V); CL10A105KB8NNN −34,4 %; CL32B475KCJZ4N −24,5 / −33,4 %; CL10B104KC8NNN −25,5 / −35,4 %; CL10A106KP8NNN −55,7 %. Coinciden con el autor |

## Criterios de aceptación de la spec

| Criterio | Evidencia | Resultado |
|---|---|---|
| Símbolo y huella resolubles desde `hardware/v2`, con 3D | Tablas con `esp-riego` vía `${KIPRJMOD}`. Los 22 `.step` referenciados existen. JP1 y los TP no llevan 3D, por su naturaleza | Cumple |
| Pines y pads coinciden con el datasheet (página) | LMR36520, TPS2116 (p. 3; DRL0008A p. 23, igual a `SOT-583-8`), TLV1117LV (p. 3), SQD50P06 (p. 1) y NANO2 (p. 4) coinciden. Fallan D2 (hallazgo 01) y la huella de U2 frente a DDA0008B (hallazgo 02) | Parcial |
| Campos completos y stock JLCPCB con fecha | `bloque-alimentacion.md` §1–§2, fichas y muestreo de la API | Cumple |
| Checklist de librerías pasada punto por punto | Repaso del log. No detecta 01 ni 07, y deja «tablas sin restos» en No cumple (hallazgo 08) | Parcial |

## Requisitos

| Requisito | Evidencia | Resultado |
|---|---|---|
| ALI-04 | TVS unidireccional con símbolo sin polaridad | Parcial (01) |
| ALI-05 | CIN efectiva de U2 < 4,7 µF | Parcial (03) |
| ALI-13 / DEC-0006 | JP1: 1,2 × 3,0 mm, paso 1,8 mm, hueco 0,6 mm (pads en ± 0,9), máscara común, sin pasta, fuera de BOM/CPL | Cumple; ver 06 y 07 |
| KIC-01 | Entradas nuevas con `${KIPRJMOD}/../libraries/...` | Cumple |
| ALI-01…03, 06…12 | Piezas disponibles, sin cambios de valor | Cumple |

### Tabla de cotas

| Pieza | Cota | Referencia | Huella | ✔ |
|---|---|---|---|---|
| JP1 | Pad | 1,2 × 3,0 (§3.13.9) | 1,2 × 3,0 | ✔ |
| JP1 | Paso / hueco | 1,8 / 0,6 | ± 0,9 → 1,8 / 0,6 | ✔ |
| JP1 | Máscara | Común | `fp_rect` F.Mask 0,6 × 3,0 + pads con máscara | ✔ |
| JP1 | Pasta / BOM | No / fuera | Sin F.Paste; `exclude_from_bom`, `exclude_from_pos_files` | ✔ |
| JP1 | Pin 1 | — | «1» en SilkS (x −2,4) y en Fab | ✔ |
| F1 NANO2 | Pad | 1,96 × 3,15 (Littelfuse p. 4) | 1,96 × 3,15 | ✔ |
| F1 | Hueco / exterior | 2,95 / 6,86 | 2,95 / 6,87 | ✔ |
| F1 | Cuerpo 3D | 6,10 × 2,69 × 2,69, casquillo 1,45 | Igual | ✔ |
| F1 | Diferencias con la oficial | — | Solo `Datasheet` y la ruta del modelo (diff sin UUID) | ✔ |
| U2 DDA0008B | Pad de señal | 1,55 × 0,6 a ± 2,7 (p. 39) | 2,2 × 0,5 a ± 2,875 | ✘ (02) |
| U2 | Pad térmico de cobre | 2,95 × 4,9 | 2,95 × 4,9 | ✔ |
| U2 | Apertura de máscara del EP | 2,71 × 3,4 | 2,4 × 3,1 (+0,07 de margen) | ✘ (02) |
| U2 | Pasta del EP | 2,71 × 3,4 a 0,125 mm; 3,03 × 3,80 a 0,1 mm (p. 40) | 2,4 × 3,1 | ✘ (02) |
| U2 | Pin 1 / mapeo | Pin 1 PGND … 8 SW, 9 EP (Tabla 5-1, p. 4) | Pads 1–9; 3D con el pin 1 en el pad 1 | ✔ |

## Hallazgos

Severidad: **C** crítico · **A** alto · **M** medio · **B** bajo.

| ID | Sev. | Hallazgo | Evidencia | Requisito | Cambio propuesto |
|---|---|---|---|---|---|
| VAL-0018-01-01 | A | D2 (SMBJ33A, **unidireccional**) se asigna a `Device:D_TVS`, que es **bidireccional**: pines A1/A2 y dibujo simétrico. El esquema no muestra el cátodo, y el pad 1 de `D_SMB` es el cátodo. Si en SPEC-0019 se conecta A1 a GND, la TVS queda en directa sobre `VIN_PROT`: cortocircuito al encender, con F1 y Q1 en riesgo. El log da el mapeo símbolo↔huella por cumplido. **Bloquea SPEC-0019** | Descripción de `Device:D_TVS` en `Device.kicad_sym`: «Bidirectional…». `SMBJ33A.md` (campo `simbolo`); `bloque-alimentacion.md` §1, fila D2 | ALI-04 | Símbolo polarizado con K = pin 1 → pad 1: `Diode:SM6T33A` (unidireccional, `D_SMB`, cátodo en el pin 1) con Value SMBJ33A, o `Device:D_Zener`. Corregir `SMBJ33A.md` y `bloque-alimentacion.md` |
| VAL-0018-01-02 | M | La huella oficial de U2 no sigue el *land pattern* DDA0008B de TI (rev. 4214849/B, 09/2025):<br>- el pad de 0,5 mm es **menor que la patilla máxima** (0,51 mm; TI pide 0,6);<br>- el pad se alarga 0,5 mm hacia fuera, y el hueco entre el pad y el EP es de 0,30 mm frente a 0,45 mm (VIN y SW llegan a 53 V; sigue siendo ≥ 0,13 mm, IPC-2221 A6);<br>- la máscara y la pasta del EP miden 2,4 × 3,1 frente a 2,71 × 3,4;<br>- hay 6 vías de 0,33 mm abiertas (`*.Mask`) bajo la pasta, y TI pide rellenarlas o taparlas (nota 10).<br>La ficha tiene dos errores: dice «pasta 2,6 × 3,3», cuando eso es el pad de B.Cu y la pasta es 2,4 × 3,1, y dice que las patillas «caben en ambos». No bloquea el inicio de SPEC-0019 si se decide antes del layout. Se recomienda resolverlo ya, porque cambia el campo `Footprint` del símbolo | DDA0008B pp. 38-40 de `LMR36520.pdf`; `Texas_HTSOP-8-1EP_…_ThermalVias.kicad_mod` (pads 1–9, F.Mask/F.Paste 2,4 × 3,1, vías `*.Mask`); `LMR36520.md` §Huella | ALI-05 | Crear `esp-riego:Texas_DDA0008B_…` según TI:<br>- pads 1,55 × 0,6 a ± 2,7;<br>- EP de 2,95 × 4,9 con máscara de 2,71 × 3,4 y pasta según el estarcido de JLCPCB;<br>- vías tapadas o fuera de la pasta.<br>Apuntarla en el símbolo y en la ficha |
| VAL-0018-01-03 | M | C7 no llega al CIN mínimo de U2: da 3,0–3,4 µF efectivos frente a ≥ 4,7 µF **efectivos** (p. 20 y nota de la p. 17). Además, la Tabla 8-1 (p. 18), que `alimentacion.md` §3.6 no cita, recomienda **2 × 4,7 µF + 220 nF** en todas las filas. La salida que propone el autor («C2 junto a U2») choca con §8: C2 forma parte del nodo de entrada (J1-F1-Q1-D2, en el borde). **Bloquea SPEC-0019**: añade una pieza al esquema | `LMR36520.pdf` pp. 17, 18 y 20; `bloque-alimentacion.md` §3, punto 3; `alimentacion.md` §3.6 y §8 | ALI-05 | Añadir un segundo 4,7 µF 100 V X7R 1210 (C381466) junto a C7, dedicado a U2: 6,0–6,8 µF efectivos. Actualizar §3.6, §7 y §8 antes de encargar SPEC-0019 o en su propia orden |
| VAL-0018-01-04 | M | C10 (CVCC) da 0,64 µF efectivos frente al «1 µF» de la p. 21, que según la nota de la p. 17 es un valor efectivo | `bloque-alimentacion.md` §3, punto 4; SimSurfing CL10A105KB8NNN −34,4 % a 5 V | ALI-05 | Usar CL21B105KBFNNNE (C28323): 1 µF 50 V X7R 0805, **Basic**, 3,5 M de stock, −2,5 % a 5 V (SimSurfing) → ≈ 0,95 µF. Se aplica dentro de SPEC-0019 (cambio de valor y huella); no bloquea su inicio |
| VAL-0018-01-05 | B | C3 (IN_SYS) da 62–72 nF efectivos frente a «0,1 µF o más». En TPS2663 no consta como valor efectivo | `bloque-alimentacion.md` §3, punto 5; `TPS2663.md` l. 62 | ALI-13 | 220 nF 100 V X7R 0805, C513710, la misma pieza que C8: no añade ninguna línea Extended. En SPEC-0019 o en la spec de mantenimiento |
| VAL-0018-01-06 | M | JP1 tiene `(zone_connect 1)`, es decir, alivio térmico, heredado de la oficial. La conexión de la huella prevalece sobre la de la zona: si `VIN_PROT` o `BUS_24V` llegan por polígono (§8), JP1 se conecta con radios. Con eso deja de valer el cálculo de §3.13.9 (3,0 mm de cobre para 4,9 A) | `SolderJumper-2_P1.8mm_Open_Pad1.2x3.0mm.kicad_mod` l. 56; `alimentacion.md` §3.13.9 y §8 (fila JP1) | ALI-13, DEC-0006 | `(zone_connect 2)`, es decir, sólido, o quitar la línea y fijarlo en la regla de la zona. Anotar en §8 que el estaño a mano necesita más potencia de soldador. No bloquea SPEC-0019 (afecta al layout) |
| VAL-0018-01-07 | B | La referencia de JP1 (y = −2,3, texto de 1 mm) pisa su marco de serigrafía (y = −1,75) | DRC de la placa de prueba: `silk_overlap` en (145, 87,7) | — | Mover `Reference` a y ≈ −2,9 |
| VAL-0018-01-08 | B | Las tablas de `hardware/v2` mantienen 5 + 8 librerías del TFG. El autor lo declara: las usan `mcu.kicad_sch` y `salidas.kicad_sch` | `hardware/v2/sym-lib-table` y `fp-lib-table`; log 01, repaso de la checklist | KIC-01 | Quitarlas en la spec que rehaga esas hojas (spec de mantenimiento) |

### Contraste con el log de jr-conformidad

- «Símbolo ↔ huella: Cumple» y «SMBJ33A conserva la suya»: el log no detecta la polaridad de D2 (01). El fallo viene de VAL-0015-01, que tampoco lo vio.
- «Serigrafía a 0,25 mm de los pads… render correcto»: es cierto para los pads, pero no se pasó el DRC de la placa de prueba (07).
- Los valores del *derating* son exactos (reproducidos). La conclusión «con C2 junto a U2 se cumple» no se sostiene con §8 (03).

## Propuestas para las checklists

- **Librerías · Símbolo:** las piezas polarizadas (TVS unidireccional, diodos, LED, electrolíticos) usan un símbolo que muestra la polaridad. El cátodo o el positivo cae en el pad marcado de la huella. Revisar también las fichas heredadas que entren en la lista.
- **Librerías · Huella:** `kicad-cli pcb drc` de la placa de prueba del render, con la serigrafía incluida.
- **Librerías · Huella oficial de un CI con *land pattern* publicado:** tabla de cotas también para las huellas oficiales. Ancho del pad ≥ ancho máximo de la patilla. Vías bajo la pasta: tapadas o justificadas.
- **Librerías · Huellas de potencia** (puentes, *shunts*): `zone_connect` coherente con la corriente de diseño.
- **Esquema:** si el datasheet declara sus capacidades como **efectivas**, comprobar la capacidad efectiva (tensión DC y temperatura) frente a ese valor, y citar también la tabla de valores típicos.

## Veredicto

**RECHAZADO**: hay 1 hallazgo A (01) y dos criterios en Parcial. Antes de SPEC-0019 hay que resolver 01 y 03. Se recomienda resolver 02 en la misma corrección, porque cambia el campo `Footprint`. 04 y 05 se aplican dentro de SPEC-0019, y 06, 07 y 08 antes del layout o en la spec de mantenimiento.
