JoanSanbartolome/ESP-Riego/gestion/informes/VAL-0018-02.md

---
id: VAL-0018-02
spec: SPEC-0018
fecha: 2026-11-05
commit_revisado: 6250829
checklists: [librerias v3]
veredicto: APROBADO_CON_OBSERVACIONES
---

# VAL-0018-02 · Piezas del bloque de alimentación (revalidación)

## Alcance de la revisión

Nivel completo. Revalidación de VAL-0018-01 (hallazgos 01–07) en el commit 6250829, que incluye las correcciones 5daee9f, d1d7328 y 6250829, y búsqueda de regresiones. Se revisan los siguientes artefactos:

- el símbolo `esp-riego:SMBJ33A` y el campo `Footprint` de `esp-riego:LMR36520FADDA`;
- la huella `esp-riego:Texas_DDA0008B_…_Mask2.71x3.4mm`;
- JP1;
- los documentos `LMR36520.md`, `SMBJ33A.md`, `bloque-alimentacion.md` y `alimentacion.md`.

MCP: ningún proyecto cargado (`get_backend_state` vacío, sin `.lck`). Solo se ha usado `validate_symbol_library` sobre una copia, y `kicad-cli` sobre copias en el *scratchpad*.

## Comprobaciones automáticas

| Comprobación | Resultado |
|---|---|
| ERC / DRC / paridad (`verificar.py`, copia de `hardware/v2` + `libraries`) | 0 / 0 / 0. LIMPIO. U2 aún no está en la placa |
| `validate_symbol_library` (con kicad-cli) | Válida, 5 símbolos |
| DRC de una placa de prueba **con las reglas de `hardware/v2/esp-riego.kicad_pro`** (U2 nueva, JP1, D_SMB y U2 oficial) | **6 `drill_out_of_range` (error)** en las vías del pad 9 de la U2 nueva: taladro de 0,2 mm, mínimo de 0,3 (hallazgo 01). JP1 ya no da `silk_overlap`. La oficial y D_SMB salen limpias |
| Gerber F.Mask/B.Mask/F.Paste de la placa de prueba | El EP abre F.Mask y F.Paste con 2,71 × 3,4. Las 6 vías caen dentro de ese hueco. B.Mask no tiene aperturas en la U2 nueva |
| `pcb render` superior e inferior (U2) | El triángulo de la serigrafía y el punto del pin 1 del 3D caen sobre el pad 1. Por debajo, el B.Cu de 2,6 × 3,3 con las vías |
| `sym export svg` de SMBJ33A | Cátodo a la izquierda (pin 1). Los nombres «A» y «K» se ven dentro del cuerpo y pisan el dibujo (hallazgo 02) |

## Seguimiento de VAL-0018-01

| ID | Estado | Evidencia |
|---|---|---|
| 01 (A) D2 bidireccional | **Resuelto** | `esp-riego:SMBJ33A`: pin 1 = K en x −3,81, del lado de la barra (x −1,27); pin 2 = A. `Diode_SMD:D_SMB`: pad 1 en x −2,15, con la marca de serigrafía en x −3,66. El render muestra la banda del 3D sobre el pad 1. Las fichas `SMBJ33A.md` y `bloque-alimentacion.md` están actualizadas |
| 02 (M) Huella DDA0008B | **Resuelto en pads, máscara y pasta**; las vías generan 01 | Ver la tabla de cotas |
| 03 (M) CIN de U2 | **Resuelto** | C7 + C22 recalculados: 3,40 / 2,98 / 2,82 µF por condensador (24 V a 60 °C; 30 V a 60 °C; 30 V a 85 °C) → mínimo de 5,07 µF con −10 % (≥ 4,7). Con el proxy KCIZNW, 4,86 µF. C2 se queda en el nodo de entrada (§3.6, §8). `alimentacion.md` y `bloque-alimentacion.md` coinciden |
| 04 (M) C10 | **Resuelto** | C28323: 1 × 0,975 × 0,985 = 0,96 µF a 60 °C y 0,94 µF a 85 °C; 0,85 µF en el peor caso. Coincide en los dos documentos |
| 05 (B) C3 | **Resuelto** | C513710: 0,17 / 0,15 µF a 24 / 30 V (60 °C). Las líneas pasan a 19 Extended (sale C15725) y 10 Basic (entra C28323) |
| 06 (M) `zone_connect` de JP1 | **Resuelto** en la huella (`zone_connect 2`). La nota de §8 sobre la potencia del soldador sigue pendiente (hallazgo 04) | `SolderJumper-2_P1.8mm_…kicad_mod` |
| 07 (B) Serigrafía de JP1 | **Resuelto** | `Reference` en y = −2,9. El DRC de la placa de prueba no da `silk_overlap` |
| 08 (B) Tablas de la v1 | Abierto; está asignado a la spec de mantenimiento | Sin cambios |

### Tabla de cotas: U2, huella `esp-riego:Texas_DDA0008B_…`, frente a LMR36520.pdf pp. 38-40 (4214849/B)

| Cota | TI | Huella | ✔ |
|---|---|---|---|
| Pads 1–8 | 1,55 × 0,6, centros a ± 2,7 (5,4), paso 1,27 | 1,55 × 0,6 a ± 2,7; y = ± 0,635 y ± 1,905 | ✔ |
| Máscara de las señales | NSMD, 0,07 máx. alrededor (p. 39) | `solder_mask_margin 0.07` | ✔ |
| Patilla frente al pad | 0,31–0,51 (p. 38) | 0,6 | ✔ |
| Hueco entre pad y EP | (5,4 − 1,55)/2 − 1,475 = 0,45 | 0,45 | ✔ |
| Cobre del EP | 2,95 × 4,9 | F.Cu 2,95 × 4,9 (+ B.Cu 2,6 × 3,3) | ✔ |
| Apertura de máscara del EP | 2,71 × 3,4 (pad SMD) | 2,71 × 3,4, margen 0 | ✔ |
| Pasta del EP | 2,71 × 3,4 a 0,125 mm; 3,03 × 3,80 a 0,10; 2,47 × 3,10 a 0,15 (p. 40) | 2,71 × 3,4 | ✔ con 0,12 mm (hallazgo 05) |
| Pasta de las señales | 1,55 × 0,6 | 1,55 × 0,6 | ✔ |
| Vías | Ø 0,2, 8 vías a (± 0,65; ± 0,65 / ± 1,95): 4 bajo la pasta y 4 bajo la máscara; «filled, plugged or tented» (nota 10) | 6 vías de 0,2 / 0,45 a (± 0,65; 0 / ± 1,3), todas bajo la apertura de F.Mask y F.Paste. Tapadas solo por B.Mask | ✘ (01) |
| Pin 1 y mapeo | Pin 1 PGND … 8 SW, 9 EP (p. 4) | Pads 1–9; triángulo y 3D sobre el pad 1 | ✔ |
| Courtyard | Cuerpo de 3,9 × 4,9 y pads hasta ± 3,475 | ± 3,8 × ± 2,75 | ✔ |

**Pasta del EP.** Se acepta 2,71 × 3,4, el valor de TI para 0,125 mm. Por qué:

- los espesores estándar de JLCPCB son 0,10, 0,12, 0,15, 0,18 y 0,20 mm («Select by JLCPCB» o «by customer»);
- con 0,12 mm, el volumen de pasta queda en el 96 % del de TI;
- si JLCPCB eligiera 0,15 mm, sobraría un 21 % de pasta frente a los 2,47 × 3,10 de TI, con riesgo de que la pieza flote.

Por eso el espesor hay que fijarlo en el pedido (hallazgo 05). No se recomienda 3,03 × 3,80: excede la apertura de máscara.

## Criterios de aceptación de la spec

| Criterio | Evidencia | Resultado |
|---|---|---|
| Símbolo y huella resolubles desde `hardware/v2`, con 3D | `esp-riego:SMBJ33A` y la huella nueva, vía `${KIPRJMOD}`. El STEP oficial `…EP2.85x4.9mm…` existe (el mismo que usa la huella oficial) | Cumple |
| Pines y pads frente al datasheet | Tabla de cotas (pp. 38-40). Polaridad de D2 resuelta | Cumple (vías: 01) |
| Campos y stock con fecha | `LCSC Part#`, `MPN`, `Datasheet` y `Description` en SMBJ33A. C22, C10 y C3 con el tipo y el stock de JLCPCB del 2026-11-05 | Cumple |
| Checklist pasada punto por punto | Logs 03 y 05. El 03 da «polaridad visible» y «vías tapadas» por cumplidos (02, 01) | Cumple con observaciones |

## Requisitos

| Requisito | Evidencia | Resultado |
|---|---|---|
| ALI-04 | TVS unidireccional, K = pin 1 = pad 1 | Cumple |
| ALI-05 | CIN ≥ 5,07 µF efectivos; CVCC 0,85–0,96 µF | Cumple |
| ALI-13 / DEC-0006 | JP1 con conexión sólida a zona y serigrafía limpia | Cumple |
| **FAB-02** | Vías de 0,3 / 0,6 mm. La U2 nueva trae vías de 0,2 / 0,45 | **No cumple (01)** |
| KIC-01 | Sin cambios en las tablas | Cumple (08 abierto) |

## Hallazgos

Severidad: **C** crítico · **A** alto · **M** medio · **B** bajo.

| ID | Sev. | Hallazgo | Evidencia | Requisito | Cambio propuesto |
|---|---|---|---|---|---|
| VAL-0018-02-01 | M | Las vías térmicas de la U2 nueva tienen 0,2 / 0,45 mm, por debajo de FAB-02 (0,3 / 0,6) y de las reglas de `hardware/v2` (`min_through_hole_diameter` 0,3; `min_via_annular_width` 0,15, y el anillo es de 0,125). Al colocar U2 salen 6 errores de DRC. Es una **regresión**: la oficial traía 0,33 / 0,63.<br>Además, no están «tapadas», como dicen la ficha, `descr` y el log 03: caen dentro de las aperturas de F.Mask y F.Paste de 2,71 × 3,4, así que quedan abiertas por arriba bajo la pasta, y solo B.Mask las cubre. Tampoco siguen la disposición de TI (± 1,3 en lugar de ± 0,65 / ± 1,95) | DRC de la placa de prueba con el `.kicad_pro` de v2: 6 `drill_out_of_range`. `Texas_DDA0008B_…kicad_mod`: pads «9» `thru_hole`, `drill 0.2`, `size 0.45`. Gerber de B.Mask sin aperturas. `LMR36520.md` §Huella, fila «Vías». LMR36520.pdf p. 39 (nota 10) | FAB-02 | Vías de 0,3 / 0,6 en las 8 posiciones de TI, (± 0,65; ± 0,65) y (± 0,65; ± 1,95), o en las 6 actuales, con la misma pasta. Mantenerlas sin B.Mask (tapadas por debajo, la variante que admite la nota 10). Corregir el texto: «tapadas por la cara inferior; bajo la pasta por arriba». Repetir el DRC con las reglas de v2. Conviene antes del merge: hace fallar `verificar.py` en cuanto U2 esté en la PCB |
| VAL-0018-02-02 | B | `esp-riego:SMBJ33A` muestra los nombres de pin: «K» y «A» se dibujan dentro del cuerpo, se leen «AK» y pisan la barra y el triángulo. Las oficiales `Diode:SM6T*` los ocultan | Render del `sym export svg`. `pin_names` sin `(hide yes)` | — | `(pin_names (offset 1.016) (hide yes))` |
| VAL-0018-02-03 | B | Quedan restos del nombre oficial en U2:<br>- la huella nueva conserva `Value` = `Texas_HTSOP-8-1EP_…_Mask2.4x3.1mm_ThermalVias`;<br>- `ki_fp_filters` de `LMR36520FADDA` termina en `Mask2.4x3.1mm*`, así que el selector de huellas no ofrece la nueva y sí la oficial descartada | `Texas_DDA0008B_…kicad_mod` l. 18; `esp-riego.kicad_sym` l. 1142 | — | `Value` con el nombre de la huella. Filtro `Texas*DDA0008B*` (o `*HTSOP*8*1EP*3.9x4.9mm*P1.27mm*`) |
| VAL-0018-02-04 | B | `alimentacion.md` no recoge los cambios de piezas del 5daee9f:<br>- §7, fila U2: sigue con `Package_SO:Texas_HTSOP-8-1EP_…_ThermalVias`;<br>- §7, «Símbolos o huellas nuevos»: no cita `esp-riego:SMBJ33A` ni la huella DDA0008B;<br>- §8, fila JP1: no anota la conexión sólida ni la potencia de soldador (propuesta de 01-06).<br>`bloque-alimentacion.md` está bien, y el campo `Footprint` del símbolo de U2 también, así que el riesgo es bajo | `alimentacion.md` l. 480, 510-513 y 525 | ALI-05, ALI-13 | Actualizar §7 y §8 (ing-esquematicos), en SPEC-0019 o en la spec de mantenimiento |
| VAL-0018-02-05 | B | La pasta del EP (2,71 × 3,4) solo es correcta con un estarcido de 0,12–0,125 mm, y JLCPCB elige el espesor entre 0,10 y 0,20 si no se le indica | LMR36520.pdf p. 40 (tabla de espesores); JLCPCB, *stencil*: espesores estándar 0,10–0,20 | FAB-02 | Anotar «estarcido de 0,12 mm, Select by customer» en `LMR36520.md` y en el plan de fabricación (fase 5) |

### Contraste con los logs

- Log 03: dice «6 vías 0,2/0,45 sin máscara (tapadas)», pero la F.Mask del EP las deja abiertas por arriba, y el taladro incumple FAB-02 (01). El `verificar.py` LIMPIO que cita no prueba la huella, porque U2 no está en la PCB.
- Log 03: da por cumplido «símbolo polarizado con polaridad visible». La polaridad es correcta, pero los nombres de pin confunden (02).
- Logs 04 y 05: cifras reproducidas sin diferencias. El 05 reconoce que copió las cifras sin consultarlas: las he recalculado y coinciden.

## Propuestas para las checklists

- **Librerías · Huella:** el DRC de la placa de prueba se pasa con el `.kicad_pro` del proyecto destino (FAB-02: taladro, anillo y vía), no con las reglas por defecto.
- **Librerías · Huella con EP:** las vías que caen dentro de una apertura de F.Mask o F.Paste del EP no están tapadas por arriba. El estado de cada cara se comprueba en el Gerber de máscara.
- **Librerías · Huella:** se mira el selector de huellas: `ki_fp_filters` del símbolo coincide con la huella asignada, y `Value` de la huella coincide con su nombre.

## Veredicto

**APROBADO_CON_OBSERVACIONES**: hay 1 M (01) y 4 B (02–05). Los hallazgos A y M de VAL-0018-01 están resueltos. Se recomienda corregir 01 (y de paso 02 y 03, en la misma librería) antes del merge, porque la huella entra en la PCB en cuanto SPEC-0019 la actualice. 04 y 05 pueden ir a SPEC-0019 o a la spec de mantenimiento.

Fuentes externas: [JLCPCB · PCB stencil manufacturing](https://jlcpcb.com/capabilities/pcb-stencil-manufacturing), [JLCPCB · instructions for stencil order](https://jlcpcb.com/help/article/instructions-for-stencil-order).
