JoanSanbartolome/ESP-Riego/gestion/informes/VAL-0017-01.md

---
id: VAL-0017-01
spec: SPEC-0017
fecha: 2026-11-05
commit_revisado: cfe843a
checklists: [esquema v5 (Cálculos, Alimentación), requisitos v3]
veredicto: APROBADO_CON_OBSERVACIONES
---

# VAL-0017-01 · Selección y cálculos del bloque de alimentación

## Alcance de la revisión

- Nivel **ligero**. Rama `spec/SPEC-0017-calculos-alimentacion`, commit `cfe843a`.
- Revisado: `docs/diseno/alimentacion.md` (todo), DEC-0003/0004/0006, `docs/02` v0.4 (ALI-01…13, REL-04/08, §6), logs 01 y 02 (leídos después).
- Recalculado a mano con el datasheet: UVLO (§3.7), banda del limitador (§3.13.2), precisión de VIN (§3.10), tensión nominal frente a Vc + 10 % (§3.5), puente JP1 (§3.13.9).
- Muestreo: VFB, I_LIMIT y EN del LMR36520; V_REF y R_ON del TPS2116; R_DS(on), R_thJA y V_GS del SQD50P06-15L; R, I²t del fusible; SHDN, IMON, R_ON, UVLO, dVdT y MODE del TPS26632; tabla de pines del ESP32-S3; precio y stock LCSC de 9 piezas; existencia de símbolos y huellas oficiales de KiCad 10.
- Datasheets: copias de ti.com (SLVSE94G, SNVSBF0C), `SMBJ33A.pdf` local (tabla p. 2) y ESP32-S3 v2.2.

## Comprobaciones automáticas

| Comprobación | Resultado |
|---|---|
| ERC / DRC / paridad | No aplica: `git diff main..HEAD` sin archivos KiCad (solo docs, gestión y memoria del autor) |

## Criterios de aceptación de la spec

| Criterio | Evidencia | Resultado |
|---|---|---|
| ALI-01…13 con pieza o cálculo y condición de partida | §9 y §3; condiciones (60 °C, tolerancias) en cada cálculo | Cumple |
| UVLO: arranque en frío 17 V, marcha hasta 15,5 V | R9/R10 al 1 %: k = 10,80–11,20; V_EN-H = 1,157–1,3 V (SNVSBF0C p. 6, releído): arranque 12,50–14,56 V. Bajada ≤ 14,56 V (histéresis ≥ 0, sin mínimo en el datasheet). Con 0,16 V de caída: 14,72 V ≤ 15,5 V; arranque 14,57 V ≤ 17 V | Cumple |
| Nominal de cada pieza ≥ Vc + 10 % | 53,3 × 1,1 = 58,63 V (SMBJ33A p. 2 releída: Vc 53,3 V a 11,3 A). F1 125 V, Q1 60 V, U1 60 V, U2 65 V, C1 63 V, MLCC 100 V, R 0603 75 V | Cumple |
| Banda 3,5–4,9 A; buck antes del limitador | 18/R_ILIM; 4,30 kΩ 1 % + 0,35 % de deriva; ±7 %: 3,84–4,54 A. Con la lógica, 4,74 A < 5,14 A. Buck en `VIN_PROT` | Cumple (ver 02) |
| VIN ≤ ± 3 % | k = 21,534; ± 10 mV a 6 dB (ESP32-S3 tabla 5-6): 1,62 % a 17 V; 1,05 % a 31 V; ≤ 2,1 % a 12,3 V; ≤ 2,6 % con la caída de F1 + Q1 a 4,74 A | Cumple |
| Presupuesto por raíl con margen | 3,68 / 4,74 A; 0,75 A frente a 2 A; 0,45 A frente a 1 A; 4,32 W ≤ 4,8 W | Cumple |
| Lista de piezas con LCSC, stock y piezas nuevas | §7. 9 piezas comprobadas en LCSC: stock y precio coinciden (TPS26632 3,56 $ a 1 ud.; R8 760 uds.). Símbolos y huellas citados existen en KiCad 10 | Cumple |

## Requisitos

| Requisito | Evidencia | Resultado |
|---|---|---|
| ALI-01…ALI-13, REL-04, REL-08 | §9 y los criterios anteriores. ALI-06 «≈ 15 V» desviado a 13,5 V por DEC-0006 (corrección de texto pendiente en mantenimiento) | Cumple |

## Recálculos

- **UVLO:** k_mín = 1 + 99/10,1 = 10,80; k_máx = 1 + 101/9,9 = 11,20 → 12,50 / 13,54 / 14,56 V ✔. Bajada nominal 13,54 × (1 − 0,11/1,231) = 12,33 V ✔. Caída 5,6 mΩ × 1,3 + 26 mΩ = 33 mΩ → 0,157 V a 4,74 A ✔.
- **Banda:** nominal 18/4,30 = 4,186 A. Mín. 18/(4,30 × 1,0135) × 0,93 = 3,841 A. Máx. 18/(4,30 × 0,9865) × 1,07 = 4,540 A ✔.
- **VIN:** a 17 V, 10/789,5 = 1,27 %; cociente 0,954 × 0,2 % = 0,19 %; deriva 0,954 × 2 × 25 ppm × 35 °C = 0,17 %; total 1,63 % ✔. Escala a 33 V: 1,532 V < 1,6 V ✔. Pin a Vc: 2,475 V.
- **JP1:** IPC-2221 externa, 1 oz, 3,0 mm: 5,30 A con ΔT = 10 °C (4,9 A cumple); 5,1 A pide 2,84 mm ✔. Estaño: 13,2·10⁻⁸ × 0,4·10⁻³ / 0,6·10⁻⁶ = 0,088 mΩ → 2,1 mW a 4,9 A ✔; con 0,1 mm de espesor, 4,2 mW (sin consecuencias).
- **Fusible:** 10 × 0,75 × 0,96 = 7,2 A ≥ 5,1 A; R 5,6 mΩ e I²t 26,46 A²s (tabla p. 2) ✔.

## Hallazgos

Severidad: **C** crítico · **A** alto · **M** medio · **B** bajo.

| ID | Sev. | Hallazgo | Evidencia | Requisito | Cambio propuesto |
|---|---|---|---|---|---|
| VAL-0017-01-01 | M | El hueco de JP1 (0,4 mm) se justifica con ≤ 30 V continuos (IPC-2221 B2, 0,1 mm), pero `VIN_PROT` llega a Vc = 53,3 V con el bus a 0 V (U1 apagado por REL-04). §8 exige ≥ 0,6 mm a 53 V (B2, 51–100 V) en la misma clase `Power_In`: criterio incoherente y huella nueva en SPEC-0018 | `alimentacion.md` §3.13.9 (fila «Separación»), §8 (filas 1 y JP1), Anexo A | ALI-04, FAB-02 | Hueco de 0,6 mm (nombre `…P1.8mm_Open_Pad1.2x3.0mm`; estaño 0,13 mΩ, 3,2 mW, sin cambio práctico) o justificar el transitorio como excepción. Decidir antes de SPEC-0018 |
| VAL-0017-01-02 | B | La nominal de I_OL a 4,02 kΩ es 4,5 A (18,09/R), no 18/R = 4,478 A (p. 7). Y la tolerancia de ± 7 % solo se da en 3 y 4,02 kΩ (± 8 % a 9 kΩ): a 4,30 kΩ queda ≈ ± 7,1 %. Efecto: banda 3,86–4,57 A. Sigue dentro de 3,5–4,9 A | §3.13.2; SLVSE94G p. 7, filas I_OL | ALI-13 | Anotar la nominal de la tabla y la interpolación; cifras 3,86–4,57 A (4,77 A con la lógica < 5,14 A) |
| VAL-0017-01-03 | B | La medida de IMON suma «± 1 % del ADC» con C5 = 1 nF y 20 kΩ de fuente (R3 + R4). El ± 10 mV de Espressif se mide con 100 nF en el pin (v2.2 §5.5, p. 66), condición que sí se usa en VIN | §3.13.7; ESP32-S3 v2.2 p. 66 | ALI-13 (deseable) | C5 = 100 nF (τ ≈ 2 ms, sin efecto en el firmware) o retirar el ± 1 % del ADC |
| VAL-0017-01-04 | B | La cota de caída de `VIN_PROT` en el *fast-trip* (5,7 V) usa 1 µs típico. El datasheet da hasta 4,5 µs en el corto blando y no da máximo en el duro. El resultado final (la salida de 5 V sigue por COUT de 28 µF y el EN filtra a 0,91 ms) no cambia | §3.13.4; SLVSE94G p. 8 (t_FASTTRIP) | ALI-13 | Decirlo con la cota en µs máxima y medir `VIN_PROT` con el osciloscopio en el corto de §6 |
| VAL-0017-01-05 | B | *Derating* DC y térmico de los cerámicos sin curva del fabricante (COUT 2 × 22 µF «≈ 14 µF», C2/C7 «≈ 7,9 µF»). El autor lo declara «parcial» | Log 01, checklist «Cálculos» (cerámicos) | ALI-05, ALI-07 | Comprobar con la curva en SPEC-0018 (jr-conformidad), con prioridad en C11/C12 y C16/C17 |

## Propuestas para las checklists

- `esquema.md` (Alimentación): para un puente de soldadura o hueco entre redes, calcular la separación con la tensión máxima del transitorio (Vc), no solo la continua.
- `esquema.md` (Cálculos): cuando el datasheet da la tolerancia en puntos concretos (R_ILIM = 3, 4,02, 9 y 30 kΩ), indicar el punto o la interpolación y la nominal de la tabla frente a la de la fórmula.
- `esquema.md` (Alimentación): las señales analógicas con filtro propio al ADC1 deben respetar la condición de medida del error de Espressif (100 nF en el pin) o declarar el error extra.

## Veredicto

**APROBADO_CON_OBSERVACIONES.** Sin C ni A. Todos los criterios de aceptación se cumplen y los recálculos coinciden con el documento. Corregir la 01 antes de SPEC-0018 (crea la huella de JP1). Las demás se acumulan en la spec de mantenimiento o se atienden en SPEC-0018/0019.
