JoanSanbartolome/ESP-Riego/gestion/informes/VAL-0017-02.md

---
id: VAL-0017-02
spec: SPEC-0017
fecha: 2026-11-05
commit_revisado: 5117c57
checklists: [esquema v5 (Cálculos, Alimentación)]
veredicto: APROBADO_CON_OBSERVACIONES
---

# VAL-0017-02 · Revalidación de VAL-0017-01-01 a 04

## Alcance

- Nivel **ligero** (revalidación). Rama `spec/SPEC-0017-calculos-alimentacion`, commit `5117c57`.
- Revisado: `git show HEAD -- docs/diseno/alimentacion.md`, Grep de cifras antiguas en `docs/` y `gestion/`, log 04 (después). Sin MCP ni KiCad (diff sin archivos KiCad). 05 trasladado a SPEC-0018.

## Hallazgos anteriores

| ID | Resultado | Evidencia |
|---|---|---|
| 01 (M) | Corregido | Hueco 0,6 mm, paso 1,8 mm, `…P1.8mm_Open_Pad1.2x3.0mm` en §3.13.9, §7 (JP1 y piezas nuevas), §8 y Anexo A. 13,2·10⁻⁸ × 0,6·10⁻³ / 0,6·10⁻⁶ = 0,132 mΩ; × 4,9² = 3,2 mW ✔. IPC-2221 B2 51–100 V = 0,6 mm, igual que `Power_In` ✔ |
| 02 (B) | Corregido | Tabla de los 4 puntos. Recálculo: nominal 18,09/4,30 = 4,207 A; mín. 18,09/(4,30 × 1,0135) × 0,929 = 3,856 → 3,86 A; máx. 18,09/(4,30 × 0,9865) × 1,071 = 4,567 → 4,57 A; −8,3 / +8,6 %; + 0,2 A = 4,77 A; margen 0,37 A (7,2 %); interpolación 7 + 0,28/4,98 = 7,06 % ✔. Propagado a §3.7, §3.13.4, §3.13.7 (4,57 A: 1,19–1,37 V), §3.13.8 (1,11 W), §3.13.9, §4, §5, §8, §9 |
| 03 (B) | Corregido | C5 = 100 nF (C1591, mismo código que C20), τ = 20 kΩ × 100 nF = 2 ms, cita p. 66 ✔. Error de IMON redactado como ± 7 % + ± 10 mV |
| 04 (B) | Corregido, con reparo (04-b) | Cotas 1 µs (franco, sin máximo) y 4,5 µs (blando, p. 9). +5V: 0,75 A × 4,5 µs / 28 µF = 0,12 V ✔; EN: 1 − e^(−4,5/910) = 0,49 % ✔. Medida de TP1/TP2 en el corto de §6 añadida |

Sin cambios de KiCad: ERC/DRC no aplican.

## Hallazgos nuevos

| ID | Sev. | Hallazgo | Evidencia | Cambio propuesto |
|---|---|---|---|---|
| VAL-0017-02-01 | M | Quedan cifras antiguas de la banda, pese a que el log 04 («Verificación») afirma que no quedan. Contradicen la nominal 4,21 A y −8,3 / +8,6 % | `alimentacion.md` línea 13 (diagrama: «limitador 4,19 A») y línea 28 (§0, tabla de piezas: «I_OL = 4,19 A ± 8,5 %»). Grep `4,19` | Poner «4,21 A» (diagrama) y «I_OL = 4,21 A (3,86–4,57 A)» (tabla). Corregir antes de SPEC-0019 (anotación lee esa tabla) |
| VAL-0017-02-02 | B | §3.13.2 llama «conservadora» a la constante 18,09. Lo es para el máximo, no para el mínimo: con 18,0 (puntos 3 y 9 kΩ) el mínimo es 3,84 A | §3.13.2; recálculo 18,0/(4,30 × 1,0135) × 0,929 = 3,837 A. Margen sigue ≥ 9,6 % sobre 3,5 A | Redactar «conservadora para el máximo; el mínimo con 18,0 sería 3,84 A» |
| VAL-0017-02-03 | B | §3.13.4: 202 µC / 7,9 µF = 25,6 V, no «≤ 25 V». Sin efecto en la conclusión (VIN_PROT casi a 0 V durante ≤ 4,5 µs) | §3.13.4 | Escribir «≈ 26 V (más que los 24 V de la fuente: caída total)» |

## Propuestas para las checklists

- `esquema.md` (Cálculos): tras propagar una cifra, hacer Grep del valor antiguo también en el diagrama y en la tabla resumen de §0, no solo en los cálculos.

## Veredicto

**APROBADO_CON_OBSERVACIONES.** Los cuatro hallazgos (01 a 04) están corregidos y los recálculos coinciden. Sin C ni A. Corregir 02-01 (dos líneas) antes del merge o en mantenimiento antes de SPEC-0019; 05 sigue en SPEC-0018.
