JoanSanbartolome/ESP-Riego/gestion/informes/VAL-0016-01.md

---
id: VAL-0016-01
spec: SPEC-0016
fecha: 2026-11-05
commit_revisado: d125c37
checklists: [requisitos v3, librerias v2, proceso]
veredicto: APROBADO_CON_OBSERVACIONES
---

# VAL-0016-01 · Mantenimiento de las fases 0 a 2

## Alcance de la revisión

Nivel ligero. Rama `spec/SPEC-0016-mantenimiento-fases-0-2`, commit d125c37, `git diff main...HEAD` (12 archivos). Revisado con detalle: nombres de pines de BTT6050-1ERA y BTT6030-2ERA y cajetín `ESP-Riego.kicad_wks`. Por muestreo: `estudio-salidas.md`, `INFORME.md` de 3D, README y logs de la v1. Sin MCP. Pruebas sobre copias en el scratchpad (`v16\`).

## Comprobaciones automáticas

| Comprobación | Resultado |
|---|---|
| ERC (`verificar.py hardware/v2`) | 0 |
| DRC | 0 |
| Paridad esquema↔PCB | 0 · LIMPIO |
| `sym export svg` de `esp-riego.kicad_sym` | sin error; render revisado (hallazgo 01) |
| `sch export pdf` del v2 con la `.kicad_wks` nueva | cajetín sin solapes (casillas, fecha, tamaño, «KiCad E.D.A. 10.0.6») |

## Criterios de aceptación de la spec

| Criterio | Evidencia | Resultado |
|---|---|---|
| Cada observación corregida o justificada en el log | Logs 01 y 02, una fila por observación; comprobadas todas las de jr-conformidad y las de estudio por muestreo (abajo) | Cumple |
| Criterios de SPEC-0008: sin 24 V AC como instaladas sin remitir a §11; sin recomendación sustituida sin aviso; costes cuadran | Cabecera S1–S7 + avisos en §0, §1.3, §6, §7, §8, §11, §11.4, §11.5; l. 89, 602 y 610 dicen «supuesta»/«superado»; recalculado: 18/29, 35/57, 70/115, 86/139 mJ; 8,38 + 3·(2,5169 − 2,2173) = 9,28 $ | Cumple |
| Criterios de SPEC-0012: sin «artefacto» ni «copia embebida» para jack/Wemos | README v1 l. 25, SPEC-0010 l. 30/44/49, SPEC-0009 l. 98–99 corregidos; l. 25/55/73 de SPEC-0009 quedan como registro histórico anulado en «Corrección» (lo que pedía la spec) | Cumple |
| Ningún pendiente pide cambiar `docs/01` §2 | Anulado en SPEC-0009 l. 98; «pad 3 del jack» quitado de los pendientes v2 de SPEC-0010 | Cumple |

## Comprobación detallada

**Pines (`esp-riego.kicad_sym` frente a datasheet Rev 1.00, §3.2 Tabla 2, p. 4).** Solo cambian los nombres; números, posiciones y tipos idénticos a main.

| Pieza | Pines | Datasheet | Símbolo |
|---|---|---|---|
| BTT6050-1ERA | 10, 11, 12 | OUT | «OUT (10-12)» ✔ |
| | 3 / 4 / 5 / 6 / tab | GND / IN / DEN / IS / VS | 3 / 4 / 5 / 6 / 15 ✔ |
| | 1, 2, 7, 8, 9, 13, 14 | NC | NC ✔ |
| BTT6030-2ERA | 12, 13, 14 | OUT0 | «OUT0 (12-14)» ✔ |
| | 8, 9, 10 | OUT1 | «OUT1 (8-10)» ✔ |
| | 1 / 2 / 3 / 4 / 5 / 6 | GND / IN0 / DEN / IS / DSEL / IN1 | ✔ |
| | 7, 11 / tab | NC / VS (15) | ✔ |

**Cajetín.** Origen en la esquina inferior derecha. La línea y = 37 de la columna derecha quita la casilla vacía; Date (y = 32) cae en la celda superior (20–45) y Size (y = 12) sobre Id (4,1). «KiCad E.D.A. 10.0.6» a x = 58 termina antes de la línea x = 32. PDF revisado a 300 dpi.

**Estudio de salidas (muestreo).** BTS428L2 (V_IN(T+), corto hasta 24 V), BTT6030 (6/4 A, k_ILIS 2240), ISP752R/BSP752R unificados, EXP-01 en §1.8, `OUT_n` ≈ 1,2 mm y N2 → DEC-0004: presentes. Ecuación y tabla de energía recalculadas con Python: coinciden. Los enlaces y las cifras de páginas de datasheet no se han vuelto a abrir (ligero).

**INFORME.md de 3D.** Pads TDSO ±2,73 coinciden con la huella (`esp-riego.pretty/Infineon_PG-TDSO-14…`, pads 1 y 8). Figura 15 en la p. 15 de `SHT4x.pdf` ✔. `kicad_test/` no versionado ✔ (0 archivos en `git ls-files`). Extremo del STEP del borne: `CARTESIAN_POINT` y máx. = 5,6 (siguiente 5,5) ✔.

## Requisitos

| Requisito | Evidencia | Resultado |
|---|---|---|
| REL-03, REL-05 | Criterio de energía y pistas ≈ 1,2 mm en el estudio, recalculado | Cumple |
| KIC-01 | `verificar.py` LIMPIO; librería lee sin error | Cumple |

## Hallazgos

Severidad: **C** crítico · **A** alto · **M** medio · **B** bajo.

| ID | Sev. | Hallazgo | Evidencia | Requisito | Cambio propuesto |
|---|---|---|---|---|---|
| VAL-0016-01-01 | M | Los nombres largos de los pines OUT apilados se montan sobre los de entrada: en el BTT6050 «OUT (10-12)» pisa «IS»; en el BTT6030 «OUT0 (12-14)» pisa «DEN» y «OUT1 (8-10)» pisa «DSEL». Antes de este cambio no solapaban («OUT», «OUT0»). | `sym export svg` + PNG de `BTT6050-1ERA` y `BTT6030-2ERA` (`scratchpad\v16\*.png`); cuerpo de 15,24 mm ≈ 12 caracteres a 1,27 mm | VAL-0015-02-02; KIC-01 | Ensanchar el cuerpo del símbolo (mover los pines de la derecha 5,08 mm y el rectángulo) o acortar a «OUT 10-12» / «OUT0 12-14» / «OUT1 8-10» y comprobar de nuevo con el render. El log 02 dejó pendiente la comprobación visual con `sym export svg` y no se hizo |
| VAL-0016-01-02 | B | `INFORME.md`, marca de pin 1 del TDSO (l. 56): sigue «pad 1 (-2,6, -3,81)»; la huella es -2,73. | `INFORME.md` l. 56; huella pad 1 `(at -2.73 -3.81)` | — | Cambiar a -2,73 |
| VAL-0016-01-03 | B | `INFORME.md`, tabla de pines del TDSO: la fila 14 y la 15 (EP) están pegadas en una línea (`\| OK \|\| 15 (EP)`), de antes de esta spec. | `INFORME.md` tabla de §2 | — | Separar la fila 15 |

## Propuestas para las checklists

- `librerias.md`: al cambiar el texto de un nombre de pin, renderizar el símbolo (`sym export svg` → PNG) y comprobar que el nombre no pisa a otros; el cambio de nombre no cambia el ERC y pasa desapercibido.

## Veredicto

**APROBADO_CON_OBSERVACIONES.** Sin C ni A; los criterios se cumplen. La M 01 afecta al uso de los símbolos en la spec de salidas: conviene corregirla antes de dibujar el esquema con ellos.
