JoanSanbartolome/ESP-Riego/gestion/informes/VAL-0015-01.md

---
id: VAL-0015-01
spec: SPEC-0015
fecha: 2026-11-05
commit_revisado: 8503def
checklists: [librerias v2]
veredicto: APROBADO_CON_OBSERVACIONES
---

# VAL-0015-01 · Recopilación de componentes de la v2

## Alcance de la revisión

Rama `spec/SPEC-0015-recopilacion-componentes`, en `8503def`. La base es `bf917f9` y se revisa un solo commit (`8503def`, jr-conformidad), con 31 archivos nuevos y ninguno modificado:

- 11 fichas en `hardware/componentes/` y 10 datasheets en `hardware/componentes/datasheets/`;
- `hardware/libraries/esp-riego.kicad_sym` (BTT6050-1ERA, BTT6030-2ERA y BSP752R);
- `hardware/libraries/esp-riego.pretty/` (PG-TDSO-14 y WJ500V-5.08-2P);
- 4 modelos en `hardware/libraries/3d/` (TDSO-14, WJ500V, SHT4x simplificado y USB-C HRO);
- el log y la memoria de jr-conformidad.

Cómo trabajé:

- Checklist `librerias.md` v2, completa.
- Sin MCP de carga: solo `get_jlcpcb_part` (consulta; la base local está vacía).
- `kicad-cli` solo sobre archivos de prueba en `…\scratchpad\v15\`:
  - un esquema con los tres símbolos para el ERC;
  - una PCB con las cuatro huellas y sus modelos, con la misma estructura de carpetas que la v2 (`proj/` y `libraries/3d/`), para comprobar que `${KIPRJMOD}/../libraries/3d/` resuelve. Sobre ella pasé el DRC, `pcb render` y la exportación SVG.
- Los datasheets los leí en PDF. Los que tienen la fuente codificada (BSP752R) o son una imagen (WJ500V) los rendericé a PNG con PyMuPDF.
- La huella oficial de Infineon la descargué de su página del encapsulado (PG-TDSO-14-11).
- LCSC/JLCPCB: API de JLCPCB y JSON de LCSC, el 2026-11-05.
- Git, solo para leer. El log del autor lo leí al final.

## Comprobaciones automáticas

No hay proyecto KiCad en el alcance (`hardware/v2/` no cambia), así que `verificar.py` no aplica. En su lugar:

| Comprobación | Resultado |
|---|---|
| ERC del esquema de prueba con los 3 símbolos | Sin `pin_to_pin` ni `no_connect_connected`: los NC y los OUT apilados no generan conflictos. Solo salen los esperables en un esquema sin cablear (`pin_not_connected`, `pin_not_driven` y `power_pin_not_driven`) |
| DRC de la PCB de prueba | TDSO-14, WJ500V y SHT4x: 0 violaciones. USB-C: 4 `clearance` y 4 `solder_mask_bridge` entre los pads dobles A1/B12, A4/B9… porque la prueba no tiene redes. Es un artefacto de la prueba, no de la huella |
| Referencias `librería:nombre` a KiCad 10.0.6 | 16 símbolos y 8 huellas, todos existen (`scratchpad\v15\refs.py`). Faltan 2 modelos 3D oficiales: `Connector_USB.3dshapes/USB_C_Receptacle_HRO_TYPE-C-31-M-12.step` y `Sensor_Humidity.3dshapes/…SHT4x_NoCentralPad.step`. Las fichas lo declaran y dan un respaldo |
| Rutas absolutas | Ninguna en las fichas, `esp-riego.kicad_sym` ni `esp-riego.pretty` (Grep de `X:\`, `/c/Users`) |
| Formato nativo | `.kicad_sym` versión 20251024, `.kicad_mod` versión 20260206. Las cargan `sym export svg`, `pcb drc` y `pcb render` |
| `.gitattributes` | `*.step` y `*.pdf` son `binary` (`git ls-files --eol`: `attr/-text`) |
| Datasheets ≤ 5 MB | Los 10 entre 0,1 y 2,2 MB. El TPS2663 (5,7 MB) solo tiene enlace |
| `hardware/v2/`, `hardware/v1-tfg/` y librerías de la v1 | `git diff --name-status bf917f9 8503def`: solo altas (`A`), ninguna en `hardware/v2` ni `hardware/v1-tfg` |
| TFG | `python herramientas/integridad_tfg.py verificar`: «TFG intacto: 337 archivos» |
| MCP sin proyecto cargado | Auditoría de 2026-11-05: jr-conformidad (líneas con la rama de SPEC-0014, como avisa el coordinador) solo usó `get_jlcpcb_part`, `search_parts_registry` y `get_registry_part`. Los dos `open_project` del día son de ing-layout (SPEC-0014) |

## Criterios de aceptación de la spec

| Criterio | Evidencia | Resultado |
|---|---|---|
| Cada componente de la tabla tiene su ficha completa según la checklist de librerías v2, con datasheet y LCSC con fecha | 11 fichas con `lcsc`, `tipo_jlcpcb`, `stock_consultado: 2026-11-05`, datasheet y datos clave. Muestreé 13 códigos con la API de JLCPCB: todos coinciden (abajo). Observaciones 06, 07 y 08 | Cumple |
| Cada símbolo, huella y modelo 3D se puede resolver (KiCad 10 oficial o `hardware/libraries/esp-riego.*`), nativo y sin rutas absolutas | Referencias oficiales comprobadas en la instalación. Las propias resuelven con `${KIPRJMOD}/../libraries/3d/` en la PCB de prueba. Los 2 modelos oficiales que faltan tienen respaldo en `hardware/libraries/3d/`, que el bloque tiene que enlazar (pendiente anotado en la ficha y en el log) | Cumple |
| Cada pieza que no viene de la librería oficial está en «Requiere verificación de validación», con la página del dibujo | 3 símbolos, 2 huellas y 4 modelos 3D, cada uno con su página | Cumple |
| `hardware/v2/`, librerías de la v1 y TFG sin cambios; el MCP no ha cargado ningún proyecto | Ver «Comprobaciones automáticas» | Cumple |

## Requisitos

| Requisito | Evidencia | Resultado |
|---|---|---|
| MCU-01 | `RF_Module:ESP32-S3-WROOM-1`, la misma huella de N4 a N16R8 (Tabla 1-1, p. 3). C2913198 (N8), Extended | Cumple |
| MCU-03 | USBLC6-2SC6 (C7519) y TYPE-C-31-M-12 de 16 pines (C165948), los dos Extended en JLCPCB. Huella oficial, con el modelo 3D de los demos | Cumple |
| REL-03 | BTT6050-1ERA y BTT6030-2ERA con símbolo y huella, y el BSP752R como reserva | Cumple (hallazgos 01 y 02) |
| ALI-04 | SMBJ33A: V_BR de 36,7–40,6 V y V_C de 53,3 V a 11,3 A (tabla de la p. 2 de Littelfuse, revisión de 07/04/25) | Cumple |
| ALI-13 | TPS2663 (60 V, máx. absoluto de 67 V) y LM5069 (9–80 V), los dos ≥ 60 V. La ficha avisa del *clamp* de 35 V del TPS26632 | Cumple |
| AMB-01 | `Sensor_Humidity:SHT4x` y huella `NoCentralPad` oficiales (§5.3, p. 15: pad central sin soldar) | Cumple (hallazgo 05) |
| FAB-05 | Los 3 símbolos propios tienen `LCSC Part#`. Los 11 componentes son Extended: no hay alternativa Basic ni Preferred en JLCPCB para SMBJ33A, USBLC6-2SC6 ni el USB-C de 16 pines (búsqueda por palabra clave, 30 primeros resultados) | Cumple |
| FAB-07 | Borne WJ500V de 5,08 mm | Parcial (hallazgos 03, 04 y 09) |
| KIC-01 | Sin rutas absolutas. Formato nativo. 3D con `${KIPRJMOD}` relativo y `${KICAD10_3DMODEL_DIR}` | Cumple |

### Muestreo de LCSC/JLCPCB (2026-11-05)

API de JLCPCB `selectSmtComponentList`. En los 13 códigos, el tipo (`expand` = Extended) y los tramos de precio coinciden al cuarto decimal con las fichas. El stock varía un poco a lo largo del día.

| Código | MPN | Ficha (stock · tramos) | Mi consulta | Precio de la ficha recalculado |
|---|---|---|---|---|
| C534868 | BTT6050-1ERA | 1 698 · 1,2756 / 1,1644 / 1,0941 | 1 698 · igual | 30 × 1,0941 = 32,82 $; 60 × 1,0941 = 65,65 $ ✔ |
| C534865 | BTT6030-2ERA | 10 626 · 2,9764 / 2,5005 / 2,2028 | 10 621 · igual | 15 × 2,5005 = 37,51 $; 30 × 2,2028 = 66,08 $ ✔ |
| C112644 | BSP752R | 288 · 1,5405 / 1,2920 / 1,1350 | 288 · igual | 34,05 $ / 68,10 $ ✔ |
| C8465 | WJ500V-5.08-2P | 284 732 · 0,1345 / 0,1083 | 283 400 · igual | No da el precio a 5 y 10 placas (hallazgo 06) |
| C165948 | TYPE-C-31-M-12 | 152 447 · 0,1868 / 0,1476 | 150 336 · igual | 0,93 $ / 1,87 $ ✔ |
| C2913198 | ESP32-S3-WROOM-1-N8 | 4 641 · 4,9208 / 4,2437 | 4 166 · igual | 24,60 $ / 42,44 $ ✔ |
| C7519 | USBLC6-2SC6 | 46 715 · 0,1795 | 45 662 · igual | 0,90 $ / 1,80 $ ✔ |
| C224019 | SMBJ33A | 9 752 · 0,1229 | 9 752 · igual | 0,61 $ / 1,23 $ ✔ |
| C1850278 | TPS26632RGER | 1 631 · 3,5258 / 2,9993 | 1 631 · igual | 17,63 $ / 29,99 $ ✔ |
| C111822 | LM5069MM-2/NOPB | 9 471 · 4,9764 / 4,3827 | 9 451 · igual | 24,88 $ / 43,83 $ ✔ |
| C2653582 | LM5069MMX-2/NOPB | 5 419 · 4,1325 / 3,5160 | 5 419 · igual | 20,66 $ / 35,16 $ ✔ |
| C2848306 | SHT40-AD1B-R3 | 15 537 · 1,8529 / 1,5732 | 15 537 · igual | 9,26 $ / 15,73 $ ✔ |
| C7461861 / C5221601 | SHT41 / SHT45 | 12 072 / 7 078 | 11 957 / 7 078 · igual | ✔ |

Nota: el JSON de LCSC (`wmsc.lcsc.com`) y la ficha web de LCSC devuelven «Part not found» para los 4 códigos de Sensirion (C2848306, C7461861, C5221601 y C2909890). JLCPCB sí los tiene (con `lcscGoodsUrl`). Hoy, los SHT4x solo se pueden comprar a través del montaje de JLCPCB, no sueltos en LCSC. No afecta al montaje, pero conviene saberlo si se piden piezas sueltas para el prototipo.

## Verificación de las piezas creadas

### Símbolos frente al datasheet

**BTT6050-1ERA.** Rev. 1.00, §3.1 Figura 2 y §3.2 Tabla 2, p. 4. Huella `esp-riego:Infineon_PG-TDSO-14_…`.

| Pin (datasheet) | Nombre | Símbolo: número · nombre · tipo | Pad de la huella | Resultado |
|---|---|---|---|---|
| 1, 2, 7, 8, 9, 13, 14 | NC («No internal connection») | 1 visible, el resto ocultos y apilados · NC · `no_connect` | 1, 2, 7, 8, 9, 13, 14 | ✔ |
| 3 | GND | 3 · GND · `power_in` | 3 | ✔ |
| 4 | IN | 4 · IN · `input` | 4 | ✔ |
| 5 | DEN | 5 · DEN · `input` | 5 | ✔ |
| 6 | IS | 6 · IS · `output` | 6 | ✔ |
| 10, 11, 12 | OUT (nota 1: unidos en la placa) | 10 visible, 11 y 12 ocultos y apilados · OUT · `power_out` | 10, 11, 12 | ✔ |
| *Cooling tab* | VS | 15 · VS · `power_in` | 15 (EP de 2,65 × 6,4) | ✔ |

**BTT6030-2ERA.** Rev. 1.00, §3.1 Figura 2 y §3.2 Tabla 2, p. 4.

| Pin | Nombre | Símbolo | Pad | Resultado |
|---|---|---|---|---|
| 1 | GND | 1 · GND · `power_in` | 1 | ✔ |
| 2 | IN0 | 2 · IN0 · `input` | 2 | ✔ |
| 3 | DEN | 3 · DEN · `input` | 3 | ✔ |
| 4 | IS | 4 · IS · `output` | 4 | ✔ |
| 5 | DSEL | 5 · DSEL · `input` | 5 | ✔ |
| 6 | IN1 | 6 · IN1 · `input` | 6 | ✔ |
| 7, 11 | NC | 7 visible y 11 oculto, apilados · `no_connect` | 7, 11 | ✔ |
| 8, 9, 10 | OUT1 | 8 visible, 9 y 10 apilados · `power_out` | 8, 9, 10 | ✔ |
| 12, 13, 14 | OUT0 | 12 visible, 13 y 14 apilados · `power_out` | 12, 13, 14 | ✔ |
| *Cooling tab* | VS | 15 · VS · `power_in` | 15 | ✔ |

**BSP752R.** V1.3, tabla de pines y *Pin configuration*, p. 2 (leída en imagen). Huella oficial `Package_SO:Infineon_PG-DSO-8-24_4x5mm`, cuya descripción cita este datasheet. El encapsulado PG-DSO-8-24 lo confirma la Figura 1 de la p. 16 impresa (p. 17 del PDF).

| Pin | Nombre | Símbolo | Resultado |
|---|---|---|---|
| 1 | GND | 1 · GND · `power_in` | ✔ |
| 2 | IN | 2 · IN · `input` | ✔ |
| 3 | OUT | 3 · OUT · `power_out` | ✔ |
| 4 | ST («Open drain diagnostic output», p. 1; «Status output (open drain)», p. 6) | 4 · ST · `open_collector` | ✔ |
| 5–8 | Vbb | 5 visible, 6–8 apilados · `power_in` | ✔ |

Los tres símbolos tienen `Value`, `Footprint`, `LCSC Part#`, `MPN`, `Datasheet` y `Description`. Los pines están en la rejilla de 2,54 mm. Cosmética en el hallazgo 10.

### Huella PG-TDSO-14 frente al encapsulado y al *land pattern* de Infineon

Encapsulado: BTT6050-1ERA, Figura 53, p. 49; idéntico al BTT6030-2ERA, Figura 54, p. 51. Infineon lo publica como **PG-TDSO-14-11**: el dibujo de su página es el mismo que el del datasheet, cota a cota.

Esa página trae también el *mounting footprint* oficial (`https://www.infineon.com/package/PG-TDSO-14-11`, imagen `infineon-pg-tdso-14-11-png-footprint-en.png`). El log da por hecho que no hay *land pattern* de Infineon, pero sí lo hay.

| Elemento | Encapsulado (p. 49) | *Land pattern* de Infineon (PG-TDSO-14-11) | IPC-7351B nominal (mi cálculo) | Huella entregada | Valoración |
|---|---|---|---|---|---|
| Paso | 1,27 | 1,27 | — | 1,27 | ✔ |
| Patilla | b = 0,4 ± 0,05; L = 0,67 ± 0,25; E = 6,0 ± 0,2 | — | — | — | — |
| Pad de señal (ancho × largo) | — | 0,65 × 1,34 | ≈ 0,56–0,60 × 1,68 | 0,60 × 1,50 | Difiere |
| Centro del pad (x) | — | ± 2,73 (filas a 5,46) | ± 2,62 | ± 2,60 | Difiere 0,13 mm |
| Borde interior / exterior | — | ± 2,06 / ± 3,40 | ± 1,78 / ± 3,46 | ± 1,85 / ± 3,35 | — |
| Menisco de punta / talón con E y L nominales (punta en 3,00, talón en 2,33) | — | 0,40 / 0,27 | 0,46 / 0,55 | 0,35 / 0,48 | Los tres son soldables |
| Pad expuesto (cobre) | 2,65 ± 0,1 × 6,4 ± 0,1 | 2,65 × 6,4 | — | 2,65 × 6,4 (pad 15) | ✔ |
| Separación entre el pad de señal y el EP | — | 0,735 | — | 0,525 | Menor que la de Infineon, pero válida para JLCPCB |
| Pasta del EP | — | 2 ventanas de 2,95 (largo) × 2,45 (ancho) con 0,3 entre ellas: 85 % | — | 2 ventanas de 2,9 × 2,2 con 0,3 entre ellas: 75 % | Difiere |
| Pasta de los pads | — | igual al pad | — | igual al pad | ✔ |
| Pin 1 y numeración | Índice en la patilla 1; 1–7 en una fila y 8–14 en la otra, en sentido antihorario | — | — | 1–7 a la izquierda de arriba abajo, 8–14 a la derecha de abajo arriba, triángulo en serigrafía y chaflán en Fab | ✔ |
| Courtyard | — | — | ≥ 0,25 | ± 3,6 × ± 4,6: 0,25 sobre los pads y 0,275 sobre el cuerpo | ✔ |
| Serigrafía | — | — | — | Líneas a y = ± 4,45, a 0,28 mm del pad 1. Ninguna sobre un pad | ✔ |

**Decisión.** La derivación por IPC es soldable y no la rechazo, pero el orden de preferencia pide el dato del fabricante cuando existe. Infineon publica un *land pattern* que difiere en el pad (0,65 × 1,34 frente a 0,6 × 1,5), en la fila (5,46 frente a 5,2) y en la pasta del EP. Hay que rehacer la huella con el *land pattern* oficial (hallazgo 01).

### Huella WJ500V-5.08-2P frente al dibujo de Kangnex

Dibujo de la hoja única: imagen escaneada, rotada 90°, leída a 0,7 y 1,2 × sobre 2480 × 3508 px.

| Elemento | Dibujo | Huella / 3D | Valoración |
|---|---|---|---|
| Paso | Layout: (N−1) × 5,08 ± 0,10; cuerpo: N × 5,08 ± 0,20 | 5,08 | ✔ |
| Taladro | Ø 1,20 ± 0,05 («RECOMMEND PCB LAYOUT, TOLERANCE ± 0,05») | 1,2 | ✔ con el dibujo; ver hallazgo 09 |
| Patilla | 0,90 ± 0,05 (vista frontal) × 0,80 ± 0,05 (sección A-A), 4,50 ± 0,20 bajo el cuerpo | 3D: 0,8 × 0,8 × 4,5 | ✔ (simplificado) |
| Pad | — | Ø 2,4 (anillo de 0,6) | ✔ |
| Ancho del cuerpo | N × 5,08 = 10,16, más la lengüeta de unión de 0,60 | x de −2,54 a 7,62 (10,16) | ✔ (sin la lengüeta) |
| Fondo del cuerpo | 10,00 ± 0,20. **La patilla está a 4,50 ± 0,20 de la cara trasera** (sección A-A), así que queda a 5,5 mm de la cara de entrada del cable | Fab, serigrafía, courtyard y 3D centrados: y de −5,0 a +5,0 | ✘ desplazado 0,5 mm (hallazgo 03) |
| Alto | 14,00 ± 0,20 | 3D: z de 0 a 14 | ✔ |
| Entrada del cable | La cara con la ventana de la jaula (izquierda en la sección A-A) | Supuesta hacia +Y, sin marcar en ninguna capa | Hallazgo 03 |
| Pin 1 | — | Pad 1 cuadrado; sin marca en la serigrafía ni en Fab | ✘ checklist (hallazgo 04) |
| Courtyard | — | 0,25 sobre la silueta Fab | ✔ (pero centrado, ver 03) |

### Modelos 3D

Renderizados con `kicad-cli pcb render` (vistas superior y frontal) sobre la PCB de prueba. Caja envolvente leída de los `CARTESIAN_POINT` del STEP.

| Modelo | Dato | Modelo / alineación | Valoración |
|---|---|---|---|
| `Infineon_PG-TDSO-14.step` | Cuerpo de 8,65 × 3,9, de 0,05 a 1,15; E = 6,0; EP de 2,65 × 6,4 | x ± 1,95, y ± 4,325, z de 0,05 a 1,15; patillas hasta ± 3,0 a y = ± 3,81 … 0 con 0,4 de ancho; EP de ± 1,325 × ± 3,2 | ✔ cotas |
| ídem: índice del pin 1 | Junto a la patilla 1 | Marca en x de −1,5 a −1,0 e y de −4,0 a −3,5 del STEP, que KiCad pinta (Y hacia arriba) junto al **pad 7**. El render lo confirma: el triángulo de serigrafía está en el pad 1 y el punto del modelo, en el 7 | ✘ (hallazgo 02) |
| `TerminalBlock_Kangnex_WJ500V-5.08-2P.step` | 10,16 × 10 × 14; patilla a 4,5 de la cara trasera | Prisma de x −2,54 a 7,62, y ± 5, z de 0 a 14, patillas de 0,8 × 0,8 × 4,5 | Desplazado 0,5 mm en Y (hallazgo 03) |
| `Sensirion_DFN-4_1.5x1.5mm_SHT4x_simplificado.step` | Figura 15, p. 14: 1,5 ± 0,1 × 1,5 ± 0,1 × **0,54 ± 0,05**; pads de 0,3 × 0,3 ± 0,1, enrasados con el borde; índice en la esquina del pin 1 | Cuerpo de ± 0,75, z de 0 a 0,5; pads de x 0,5 a 0,9 (sobresalen 0,15 del cuerpo); z mínima −0,01; sin índice | Altura 0,04 por debajo del nominal, dentro de la tolerancia pero no es el nominal; pads fuera del cuerpo; sin pin 1 (hallazgo 05) |
| `USB_C_Receptacle_HRO_TYPE-C-31-M-12.step` | Huella oficial `Connector_USB:USB_C_Receptacle_HRO_TYPE-C-31-M-12` | `cmp` idéntico a `demos/royalblue54L_feather/lib/3dmodels/Connector_USB.3dshapes/…STEP`. La huella de esa demo tiene los 22 pads en las mismas posiciones y tamaños que la oficial (solo cambia `rect` por `roundrect` y `S1` por `SH`). El modelo va con desplazamiento 0 en las dos. En el render, los contactos caen sobre la fila A/B y las pestañas sobre los taladros `SH` | ✔ |

## Hallazgos

Severidad: **C** crítico · **A** alto · **M** medio · **B** bajo.

| ID | Sev. | Hallazgo | Evidencia | Requisito | Cambio propuesto |
|---|---|---|---|---|---|
| VAL-0015-01-01 | M | La huella PG-TDSO-14 se derivó por IPC-7351 dando por hecho que «el datasheet no da *land pattern*», pero Infineon publica el *mounting footprint* oficial del encapsulado (**PG-TDSO-14-11**, el mismo dibujo que la Figura 53). Difiere en el pad (0,6 × 1,5 frente a 0,65 × 1,34), en la fila (centros a ± 2,60 frente a ± 2,73), en la separación con el EP (0,525 frente a 0,735) y en la pasta del EP (75 % frente a 85 %). Es soldable, pero no sigue el dato del fabricante | `esp-riego.pretty/Infineon_PG-TDSO-14_…kicad_mod` (pads 1–14 y ventanas de pasta); `https://www.infineon.com/package/PG-TDSO-14-11` (*footprint*: 1,27 · 0,65 · 1,34 · 5,46 · EP de 6,4 × 2,65 · pasta de 2 × 2,95 × 2,45 con 0,3 entre ellas); log, «Decisiones», 3.ª viñeta | REL-03, KIC-01 | Rehacer los pads 1–14 en 0,65 × 1,34 con centro en x = ± 2,73 y la pasta del EP en dos ventanas de 2,45 × 2,95 en y = ± 1,625. Mantener el EP de 2,65 × 6,4. Citar en `descr` el encapsulado PG-TDSO-14-11 y la URL de Infineon (opcional: renombrar a `Infineon_PG-TDSO-14-11_…`). Recalcular el courtyard (pads hasta ± 3,40, así que ± 3,65) y ajustar las fichas del BTT6050 y del BTT6030 |
| VAL-0015-01-02 | M | El modelo 3D del TDSO-14 tiene la marca de índice del pin 1 junto al **pad 7**. El script escribió el STEP en coordenadas de huella (Y hacia abajo) sin invertir Y, y KiCad lo pinta con Y hacia arriba. Las cotas y la simetría están bien, pero la revisión visual del 3D (orientación al montar) indica el pin 1 en el lado equivocado. El log afirma que «la imagen muestra el cuerpo con las patillas bien alineadas», pero no comprobó la marca | `hardware/libraries/3d/Infineon_PG-TDSO-14.step`, `CARTESIAN_POINT` #2581–#2629 (x de −1,5 a −1,0, y de −4,0 a −3,5, z = 1,17). Render `scratchpad\v15\r3d\proj\top.png`: triángulo de serigrafía en el pad 1 y punto del modelo en el pad 7 | REL-03 | Invertir el signo de Y de la marca (y de +3,5 a +4,0 en el STEP) o del STEP completo. Comprobarlo con `pcb render` en cada modelo propio: pin 1 de la serigrafía igual al del 3D |
| VAL-0015-01-03 | M | Huella y 3D del WJ500V con el cuerpo centrado sobre la patilla (y de −5 a +5), cuando la sección A-A acota la patilla a **4,50 ± 0,20 de la cara trasera** (5,5 mm de la entrada del cable). Todo el cuerpo (Fab, serigrafía, courtyard y 3D) queda desplazado 0,5 mm, y no se marca el lado de entrada del cable. En un borne de borde (FAB-07), eso cambia el saliente sobre el canto y el hueco en la caja | Dibujo de Kangnex, sección A-A (cotas 10,00 ± 0,20 y 4,50 ± 0,20); `esp-riego.pretty/TerminalBlock_Kangnex_WJ500V-…kicad_mod` (`fp_line` en y = ± 5,0, ± 5,1 y ± 5,25); STEP con y ± 5; ficha `WJ500V-5.08-2P.md`, «Recomendaciones», 3.ª viñeta (supuesto del autor) | FAB-07 | Con la entrada del cable hacia +Y (el supuesto del autor): cuerpo de y = −4,5 (trasera) a +5,5 (entrada del cable) en Fab y serigrafía, courtyard de −4,75 a +5,75 y el STEP desplazado igual. Marcar en Fab la cara de entrada del cable (texto o línea), quitar el «supuesto» de la ficha y citar la sección A-A |
| VAL-0015-01-04 | B | La huella del WJ500V no marca el pin 1 en serigrafía ni en Fab; solo el pad cuadrado. La checklist lo pide | `TerminalBlock_Kangnex_WJ500V-…kicad_mod`: ningún `fp_poly` ni texto de pin 1; checklist `librerias.md` v2, «Huella», 2.º punto | — | Añadir un triángulo o un chaflán junto al pad 1, en F.SilkS y F.Fab (como en el TDSO-14) |
| VAL-0015-01-05 | B | El modelo 3D de respaldo del SHT4x usa 0,50 mm de altura. La Figura 15 de la p. 14 da **0,54 ± 0,05** (el log dice que «el texto del PDF no la da»). Sus pads sobresalen 0,15 mm del cuerpo (x de 0,5 a 0,9; en el sensor están enrasados, 0,3 ± 0,1 desde el borde) y no tiene marca de pin 1 | `3d/Sensirion_DFN-4_1.5x1.5mm_SHT4x_simplificado.step` (z máx. 0,5; x ± 0,9); `datasheets/SHT4x.pdf`, Figura 15, p. 14; ficha `SHT4x.md`, «Notas de los assets» | AMB-01 | Altura de 0,54. Pads de x = ± 0,45 a ± 0,75, enrasados. Punto de índice en la esquina del pin 1 (x < 0, y > 0 en el STEP, por lo visto en 02). Corregir la nota de la ficha |
| VAL-0015-01-06 | B | La ficha del WJ500V no da el precio a 5 y 10 placas (la spec lo pide en el Alcance). Además, «a unos 0,11 $ la unidad, 10 bornes cuestan ≈ 1,35 $» se contradice: 10 × 0,1345 = 1,35 $ es el tramo de 1–49, no el de 0,11 $ | `hardware/componentes/WJ500V-5.08-2P.md`, «Aprovisionamiento» | FAB-07 | Fijar el número de bornes por placa con FAB-07 (6 de salidas, más entrada y pulsos ≈ 8). Con 8: 5 placas = 40 uds × 0,1345 = 5,38 $ (1,08 $/placa); 10 placas = 80 × 0,1083 = 8,66 $ (0,87 $/placa) |
| VAL-0015-01-07 | B | La ficha del BSP752R toma el umbral de entrada y la limitación de corto del estudio («dato del gemelo ISP752R») y pide confirmarlos. Pero el datasheet versionado ya los da: V_IN(T+) ≤ 2,2 V, V_IN(T−) ≥ 0,8 V, ST de drenador abierto, V_ST(low) ≤ 0,4 V (p. 6). La p. 17 citada para el encapsulado es la 16 impresa (17 del PDF) | `datasheets/BSP752R.pdf`, p. 6 (*Input and Status feedback*) y p. 16; ficha `BSP752R.md`, «Datos clave» | REL-03 | Citar la p. 6 del BSP752R para V_IN(T+) y V_IN(T−), quitar «dato del gemelo» y buscar I_L(SCp) en sus tablas antes de citarla. Unificar el criterio de página (impresa o del PDF) |
| VAL-0015-01-08 | B | `datasheet:` de las fichas y campo `Datasheet` de los símbolos apuntan a copias de LCSC en piezas cuyo fabricante publica el PDF: Infineon (×3), ST y Littelfuse. La spec admite LCSC solo «si el fabricante no lo publica». Los PDF locales son del fabricante (metadatos de Infineon y ST), así que el contenido vale, pero no se ha comprobado que sean la última revisión: el USBLC6-2 local es la Rev 5 de 2011 | Fichas `BTT6050-1ERA.md`, `BTT6030-2ERA.md`, `BSP752R.md`, `USBLC6-2SC6.md` y `SMBJ33A.md` (`datasheet:`); `esp-riego.kicad_sym` (`Datasheet`); log, «Acciones» 3 (`curl` a ST da 000) | KIC-01 | Poner la URL del fabricante en `datasheet:` y en `Datasheet` y dejar la de LCSC como espejo. Confirmar en la web del fabricante que la revisión local es la vigente y anotarla |
| VAL-0015-01-09 | B | Taladro del WJ500V de 1,2 mm, el del dibujo, pero muy justo: la patilla mide 0,9 × 0,8 (diagonal de 1,20 nominal, 1,27 en el máximo). En KiCad el taladro es el agujero acabado, con una tolerancia típica de ± 0,08 mm en JLCPCB, así que el agujero puede salir de 1,12. Las huellas oficiales de bornes de 5,08 mm usan 1,3 (p. ej. `TerminalBlock_Phoenix_MKDS-1,5-2-5.08`: «drill diameter 1.3mm, pad diameter 2.6mm») | Dibujo de Kangnex (0,90 ± 0,05 y 0,80 ± 0,05; Ø 1,20 ± 0,05); `TerminalBlock_Kangnex_WJ500V-…kicad_mod` (`drill 1.2`) | FAB-07 | Pasar a un taladro de 1,3 con pad de 2,5–2,6, o justificar en la ficha que 1,2 es el valor nominal acabado de Kangnex con el riesgo de inserción. Anotarlo para el pedido de prueba |
| VAL-0015-01-10 | B | Cosmética de los símbolos BTT6050 y BTT6030: el campo `Value`, debajo del cuerpo, se monta sobre el pin NC que sale por abajo. En los grupos apilados solo se ve el primer número (OUT «10», OUT0 «12», OUT1 «8»), y quien lea el esquema no sabe que 11 y 12 también son OUT | `sym export svg` → `scratchpad\v15\erc\svg\all.png` | — | Bajar `Value` por debajo del extremo del pin NC (o sacar el NC por arriba). Añadir los números del grupo en el nombre o en un texto del símbolo (p. ej. «OUT (10-12)») |

Recuento: C 0 · A 0 · M 3 · B 7.

## Notas para el coordinador

- **Los 3D de respaldo del USB-C y del SHT4x** no se cargan solos: la huella oficial apunta a `${KICAD10_3DMODEL_DIR}/…` y ese archivo no existe en la 10.0.6 ni en `kicad-packages3D`. La spec de bloque que los use tiene que añadir un segundo `model` con `${KIPRJMOD}/../libraries/3d/…` en la instancia, o hacer una copia derivada en `esp-riego.pretty`. Lo anoto para las specs del bloque MCU y del de sensores.
- **SHT4x en LCSC:** los códigos de Sensirion no se encuentran como pieza suelta en LCSC (solo en JLCPCB). Tenerlo en cuenta si el prototipo se monta a mano.
- **Stock justo:** BSP752R (288) para 60 unidades y BTT6050 (1 698). Sin cambios respecto al log.
- **TPS2663:** su pinout (pines 1–18 de la Tabla 5-1 de SLVSE94G) coincide con la ficha. Lo comprobé con el PDF de TI, descargado a `scratchpad\v15\dl_ti\`. El LM5069 (pines 1–10, p. 3 de SNVS452G) también coincide.

## Propuestas para las checklists

Para `gestion/checklists/librerias.md`:

1. **Huella** — «Antes de derivar una huella por IPC, se busca el *land pattern* del fabricante en la página del encapsulado (en Infineon, `infineon.com/package/<encapsulado>`, imagen «mounting footprint»), no solo en el datasheet. Si existe, se usa; si no, se anota dónde se buscó.» (Hallazgo 01.)
2. **Modelo 3D** — «El índice del pin 1 del modelo 3D coincide con el pad 1 en un `kicad-cli pcb render --side top` de una placa de prueba. Los STEP generados con un script usan Y hacia arriba (al revés que la huella).» (Hallazgo 02.)
3. **Huella THT de conector** — «Posición de la patilla dentro del cuerpo con la cota del corte o de la vista lateral (no supuesta centrada), y cara de entrada del cable marcada en Fab.» (Hallazgo 03.)
4. **Huella THT** — «Taladro acabado ≥ diagonal máxima de la patilla rectangular + 0,1 mm, o justificado.» (Hallazgo 09.)
5. **Ficha** — «`datasheet:` con la URL del fabricante cuando la publica; la copia de LCSC como espejo. Anotar la revisión y comprobar que es la vigente.» (Hallazgo 08.)
6. **Ficha** — «LCSC: si el JSON de LCSC no encuentra la pieza, se consulta la API de JLCPCB y se anota que la pieza solo está para montaje.»

## Veredicto

**APROBADO_CON_OBSERVACIONES.** Los cuatro criterios de aceptación se cumplen. Los símbolos y su mapeo con las huellas coinciden pin a pin con los datasheets. No hay ningún hallazgo C ni A. Las observaciones M (01, 02 y 03) se pueden corregir en `esp-riego.pretty` y `3d/` sin tocar `hardware/v2/`, pero conviene cerrarlas **antes** de que la primera spec de bloque coloque el BTT6050 o los bornes en la PCB.
