JoanSanbartolome/ESP-Riego/gestion/informes/VAL-0015-02.md

---
id: VAL-0015-02
spec: SPEC-0015
fecha: 2026-11-05
commit_revisado: daa0aa6
checklists: [librerias v2]
veredicto: APROBADO_CON_OBSERVACIONES
---

# VAL-0015-02 · Recopilación de componentes de la v2 (revalidación de la corrección)

## Alcance de la revisión

Nivel **ligero** (DEC-0005). Rama `spec/SPEC-0015-recopilacion-componentes`, commit `daa0aa6` frente a la base `2e0b34a` (VAL-0015-01). Se comprueban uno a uno los 10 hallazgos de VAL-0015-01 y lo que tocó la corrección (huellas, 3D, fichas, símbolos). No se revalida lo que la corrección no tocó (los 3 símbolos salvo `Value` y `Datasheet`, el muestreo de LCSC, ERC de símbolos). Sin MCP. `kicad-cli` solo sobre copias en el *scratchpad* (`v15c\`), con la misma estructura `proj/` + `libraries/3d/` que la v2. El log del autor lo leí al final.

## Comprobaciones automáticas

| Comprobación | Resultado |
|---|---|
| `git diff 2e0b34a HEAD --stat -- hardware/v2 hardware/v1-tfg` | Vacío. Solo cambian fichas, 2 huellas, 3 símbolos (`Value` y `Datasheet`), `3d/`, `fuentes-solidcraft/`, un datasheet, logs y memoria de jr-conformidad |
| TFG | `integridad_tfg.py verificar`: «TFG intacto: 337 archivos» |
| `revisar_zonas.py jr-conformidad` | Todo dentro de su zona |
| PCB de prueba con las 2 huellas propias y la oficial del SHT4x (con el 3D de respaldo enlazado) | `pcb render` y `pcb drc` sin errores; el DRC solo da `lib_footprint_issues` (la biblioteca `t` no está en la configuración de la prueba). Sin violaciones de serigrafía, máscara ni *clearance* |
| Rutas absolutas en `fuentes-solidcraft/` | Ninguna |

## Verificación hallazgo a hallazgo

| ID | Estado | Evidencia propia |
|---|---|---|
| VAL-0015-01-01 (M) | **Cerrado** | Land pattern de Infineon PG-TDSO-14-11 (imagen `footprint.png` de `infineon.com/package/PG-TDSO-14-11`, la misma que usé en 01). Huella: pads 1–14 de 1,34 × 0,65 en x = ±2,73 e y = 0 … ±3,81 (paso 1,27, filas a 5,46: coincide); pad 15 de 2,65 × 6,4 (coincide); pasta del EP en dos ventanas de 2,45 × 2,95 en y = ±1,625 (0,3 entre ellas: coincide). Numeración 1–7 a la izquierda y 8–14 a la derecha, sin cambios. Courtyard ± 3,65 × ± 4,6: pads hasta 3,40 (0,25) y cuerpo 4,325 (0,275). Serigrafía a y = ± 4,45, fuera de los pads (hasta 4,135); el triángulo de pin 1, fuera del pad 1. `descr` cita PG-TDSO-14-11 y la URL. Ficha del BTT6050 corregida (ya no dice «sin land pattern») |
| VAL-0015-01-02 (M) | **Cerrado** | Render `pcb render --side top` (8000 × 3300, recorte ampliado): el triángulo de serigrafía y el punto del 3D están junto al **pad 1** (arriba a la izquierda); las 14 patillas caen sobre sus pads, 1–7 a la izquierda y 8–14 a la derecha. STEP: x ± 3,0 · y ± 4,325 · z 0–1,15 |
| VAL-0015-01-03 (M) | **Cerrado** | Frente a la sección A-A de Kangnex (`v15\wjs_0.png`): la cara de entrada del cable es la de la izquierda, con la patilla a 5,5 de ella y a 4,5 de la trasera. Huella: cuerpo de y = −5,5 (entrada) a +4,5 (trasera) en Fab; serigrafía a 0,1 y courtyard a 0,25. Entrada marcada en Fab (línea gruesa, flecha y «ENTRADA CABLE»). El render top muestra la cara frontal inclinada (1,66 mm) arriba, hacia −Y, y el escalón trasero abajo (1,2 + 1,0 mm): coincide con el perfil del corte (frontal vertical hasta ≈ 7, escalón trasero a 9,80). Vista `--side left`: perfil del corte (frontal vertical y luego inclinada; trasera con escalón). Altura 14,00 y fondo 10,00 en el STEP |
| VAL-0015-01-04 (B) | **Cerrado** | Triángulo de pin 1 en F.SilkS y F.Fab a x = −2,3 … −1,75 (fuera del pad cuadrado, que llega a −1,3) |
| VAL-0015-01-05 (B) | **Cerrado** | STEP del SHT4x: x e y ± 0,75, z de 0 a **0,54** (Figura 15, p. 15 de la V7.3: 0,54 ± 0,05). Pads 0,3 (izquierda) y 0,4 (derecha) enrasados (cotas 0,3 y 0,4 de la vista inferior), sin sobresalir. Marca de pin 1 en la esquina del pad 1 en el render. El 3D cae sobre los 4 pads de la huella oficial y sin error de carga (enlazado con `${KIPRJMOD}/../libraries/3d/…`) |
| VAL-0015-01-06 (B) | **Cerrado** | 7 bornes (confirmado por el usuario): 35 × 0,1345 = 4,71 $ y 70 × 0,1083 = 7,58 $; con 8: 40 × 0,1345 = 5,38 $ y 80 × 0,1083 = 8,66 $. Tramos correctos (35 en 1–49 y 70 en 50–149), por placa 0,94 y 0,76 $. Frase contradictoria eliminada |
| VAL-0015-01-07 (B) | **Cerrado** | Lo leí en imagen de `BSP752R.pdf`: p. 5, I_L(SCp) 9 A máx. (−40 °C, 20 V), 6,5 A típ. (25 °C), 4 A mín. (150 °C); p. 6, V_IN(T+) ≤ 2,2 V, V_IN(T−) ≥ 0,8 V, histéresis 0,4 V típ., V_ST(low) ≤ 0,4 V (1,6 mA, ≤ 25 °C). Coinciden con la ficha. Criterio de páginas explicado |
| VAL-0015-01-08 (B) | **Cerrado** | Muestreo: descargué de `infineon.com` los PDF del BSP752R y del BTT6050-1ERA y el MD5 coincide con las copias locales. SHT4x local = V7.3 (junio de 2026, comprobado en la propia portada y pie de página). ST y Littelfuse, confirmados por el usuario (no contrastados con el fabricante: el log lo dice). `datasheet:` apunta a la URL del fabricante, con `datasheet_espejo` de LCSC |
| VAL-0015-01-09 (B) | **Cerrado** | Taladro 1,3 y pad 2,6 (Ø; el pad 1 es cuadrado de 2,6), como el Phoenix MKDS-1,5-2-5.08. Patilla del STEP de 0,9 × 0,8 (x ± 0,45, y ± 0,4), diagonal 1,204 nominal y 1,275 máxima: holgura de 0,1 sobre el nominal. Justificado en la ficha |
| VAL-0015-01-10 (B) | **Cerrado en parte** | `Value` movido bajo el pin NC: en el SVG exportado no pisa ningún pin (BTT6050 y BTT6030). Pines y conexiones sin cambios (`git diff` solo toca `Value` y `Datasheet`). No se añadió la numeración de los grupos apilados (OUT 10–12, etc.), que era la segunda mitad de la propuesta: ver observación 02 |

## Hallazgos nuevos

Severidad: **C** crítico · **A** alto · **M** medio · **B** bajo.

| ID | Sev. | Hallazgo | Evidencia | Requisito | Cambio propuesto |
|---|---|---|---|---|---|
| VAL-0015-02-01 | B | `fuentes-solidcraft/INFORME.md` está desactualizado respecto a lo entregado: en la tabla del TDSO-14 da los pads en x = ±2,60 (ahora ±2,73), cita la Figura 15 en la p. 14 (ahora p. 15 de la V7.3), dice que la huella del borne es simétrica y «no indica el lado» (ahora lo marca) y remite a un directorio `kicad_test/` y a capturas que no están versionados. Además dice que el cuerpo del borne llega a y = +5,5, y el STEP llega a +5,6 (marco de la ventana del cable, `CARTESIAN_POINT` en y = 5,6): 0,1 mm más allá del contorno Fab, dentro del courtyard (5,75) | `hardware/libraries/3d/fuentes-solidcraft/INFORME.md`, §1, §2 y §3; `TerminalBlock_Kangnex_WJ500V-5.08-2P.step` (y de −4,5 a 5,6) | KIC-01 | Actualizar o anotar en el INFORME que el archivo es el de generación (rev. anterior a la corrección de la huella), y citar el 5,6 del marco. No bloquea |
| VAL-0015-02-02 | B | Resto de VAL-0015-01-10: los símbolos BTT6050 y BTT6030 solo muestran el primer número de los grupos apilados (OUT «10», OUT0 «12», OUT1 «8»), así que quien lea el esquema no ve que 11 y 12 (o 9, 10, 13, 14) también son OUT | `sym export svg` de `esp-riego.kicad_sym` | REL-03 | Añadir «OUT (10-12)» al nombre del pin o un texto en el símbolo. Puede hacerse al integrar el primer bloque que lo use |

Recuento: C 0 · A 0 · M 0 · B 2.

## Notas para el coordinador

- Los 10 hallazgos de VAL-0015-01 quedan cerrados (el 10 en parte, como observación 02). No he vuelto a ejecutar ERC de símbolos: la corrección solo movió `Value` y cambió `Datasheet`.
- Sigue pendiente, como ya anotaba VAL-0015-01, que el primer bloque que use el USB-C y el SHT4x añada en la instancia el `model` de respaldo, y que inscriba `esp-riego` en las lib-tables.
- El STEP del SHT4x oficial no existe en `kicad-packages3D`: el nombre del respaldo es el mismo que el de la huella oficial, de modo que basta con el `model` de `${KIPRJMOD}`.

## Propuestas para las checklists

Mantengo las de VAL-0015-01. Añado: **Modelo 3D** — «Comparar el perfil lateral (`pcb render --side left`) con la sección del fabricante y anotar si el STEP sobresale del contorno Fab.»

## Veredicto

**APROBADO_CON_OBSERVACIONES.** Los tres M y los siete B de VAL-0015-01 están corregidos y comprobados (el 10, en parte). Quedan dos observaciones B sin riesgo para el diseño.
