JoanSanbartolome/ESP-Riego/gestion/informes/VAL-0014-01.md

---
id: VAL-0014-01
spec: SPEC-0014
fecha: 2026-11-05
commit_revisado: 9a8c24f
checklists: [esquema v5 (estructura y cajetín), layout v5 (reglas y verificación; dimensiones y taladros M3)]
veredicto: APROBADO_CON_OBSERVACIONES
---

# VAL-0014-01 · Limpieza de la copia de trabajo de la v2

## Alcance de la revisión

Rama `spec/SPEC-0014-limpieza-v2`, en `9a8c24f`. La base es `61d58eb`, y se revisan dos commits:

- `3c8a700` (ing-esquematicos): los 5 esquemas y el `README.md`;
- `9a8c24f` (ing-layout): `esp-riego.kicad_pcb`, `esp-riego.kicad_pro` y el `README.md`.

Toda la comparación es contra los commits (`git diff 61d58eb HEAD`). En el directorio de trabajo hay archivos sin commit de SPEC-0015 (`hardware/componentes/`, `hardware/libraries/esp-riego.*` y `3d/*.step` nuevos); no forman parte de esta revisión. Comprobé además que `hardware/v2/` y `hardware/libraries/ESP-Riego.kicad_wks` del directorio de trabajo son iguales a `HEAD` (`git diff HEAD` vacío).

Cómo trabajé:

- No usé el MCP.
- `kicad-cli` solo trabajó sobre copias en `…\scratchpad\val14\`.
- Usé git solo para leer.
- El estado de partida (la copia de la v1 de SPEC-0013) lo saqué de `61d58eb` a `scratchpad\val14\base\` con `git show`.
- Los logs de los autores los leí al final.

Checklists: `esquema.md` v5 (estructura y cajetín) y `layout.md` v5 (reglas y verificación, dimensiones y taladros M3). Con la placa vacía, el resto no aplica.

## Comprobaciones automáticas

`python herramientas/verificar.py hardware/v2 --salida <scratchpad>\val14\ver_v2`. El `md5sum` de `hardware/v2/*` es el mismo antes y después; `verificar.py` creó y borró el `.kicad_prl`.

| Comprobación | Resultado |
|---|---|
| ERC | 0 (errores 0, avisos 0). Las 5 hojas (`/`, `/Salidas/`, `/MCU/`, `/Alimentacion/` y `/Conectores/`) tienen 0 violaciones en `erc.json` |
| DRC | 0 (errores 0, avisos 0, sin conectar 0). `drc.json`: `violations` 0, `unconnected_items` 0 |
| Paridad esquema↔PCB | 0 (`schematic_parity` 0) |

**Resultado: LIMPIO.** Las 7 comprobaciones de DRC ignoradas (`footprint_filters_mismatch`, `footprint_type_mismatch`, `missing_courtyard`, `npth_inside_courtyard`, `pth_inside_courtyard`…) y las 3 de ERC son los valores por defecto de KiCad, no exclusiones del proyecto: `drc_exclusions` y `erc_exclusions` están vacíos.

Comprobaciones independientes:

- **Inventario** con un analizador de *s-expressions* propio (`val14\inventario.py`) en la base y en `HEAD`:
  - **Base:** 99 símbolos de esquema, 61 con referencia de componente y 38 de alimentación (34 de potencia y 4 `PWR_FLAG`). La PCB tiene 61 huellas, 262 segmentos, 36 vías, 3 zonas, 2 `gr_rect`, 5 `gr_text` y 1 `embedded_files`.
  - **`HEAD`:** el esquema solo tiene H1–H4 (en `conectores.kicad_sch`) y, en cada hoja, 2 textos (1 en la raíz). La PCB tiene 4 huellas (H1–H4), 1 `gr_rect` en `Edge.Cuts` y 1 `gr_text` en `Cmts.User`. No quedan segmentos, vías, zonas, cables, etiquetas, uniones ni `no_connect`.
- **Redes del estado de partida:** `kicad-cli sch export netlist` sobre la copia base (`val14\base_net.net`). Me sirvieron para comprobar los motivos del inventario (p. ej., las redes de TP1–TP4).
- **Formato:** reguardé con `kicad-cli pcb upgrade --force` una copia de la PCB entregada y es **idéntica byte a byte** a la entregada. Con `sch upgrade --force`, los esquemas solo cambian en el orden de los textos y en `(lib_symbols)`, que pasa a una línea: el contenido es el mismo si se comparan las líneas ordenadas.

## Criterios de aceptación de la spec

| Criterio | Evidencia | Resultado |
|---|---|---|
| `verificar.py`: ERC 0 errores, DRC 0 errores y 0 sin conectar, paridad 0; avisos justificados | Tabla de arriba: no queda ningún aviso | Cumple |
| Ninguna pieza de la v1 que contradiga v0.4 en el esquema ni en la PCB; cada pieza conservada, justificada con su requisito | Ver «Inventario frente a la v1» | Cumple |
| Las 4 hojas siguen en la jerarquía, cada una con su texto de bloque pendiente | La raíz tiene las 4 `sheet` con los mismos UUID que la base (los `path` de la PCB siguen resolviendo: paridad 0), sin pines. Cada hoja tiene un texto «BLOQUE PENDIENTE: … (requisitos)» y una descripción del contenido previsto, que coteja con los requisitos de v0.4 sin contradicciones. La raíz, además, anuncia la hoja `Sensores` (AMB-01…03, KIC-02). Véase la observación 01 sobre dos frases de esos textos | Cumple |
| Contorno de 100 × 70 mm, 4 M3, reglas de FAB-02, sin `embedded_files` del TFG ni `outputdirectory` fuera de `fabricacion/` | Ver «PCB y proyecto» | Cumple |
| Cajetín en los PDF exportados sobre una copia: título una vez y descripción del bloque en cada hoja | Exporté el esquema y la PCB desde `val14\copia\hardware\v2\`, con `hardware\libraries\ESP-Riego.kicad_wks` al lado (igual a `HEAD`). `sch.pdf` (5 páginas): «ESP-Riego v2» sale una vez por página (`${TITLE}`), y la casilla grande muestra «Placa de control de riego», «Salidas: 6 high-side con diagnóstico y bornes», «Microcontrolador: ESP32-S3, USB-C y UART», «Alimentación: protecciones, limitador, buck y 3,3 V» y «Conectores: pulsos, expansión y taladros M3». También aparecen «Hoja: …», «Rev: 2.0-dev», la fecha y el autor. `pcb.pdf` (`--include-border-title`) muestra «Placa de control de riego» y «ESP-Riego v2» una vez cada uno. No hay ningún texto del TFG | Cumple |
| `hardware/v1-tfg/` y `hardware/libraries/` sin cambios; sin `.lck` ni `-backups/`; MCP con `close_project` | `git diff --stat 61d58eb HEAD -- hardware/v1-tfg hardware/libraries` está vacío. `find` en el repositorio (sin `.git`) no encuentra `.lck`, `*-backups`, `.mcp-backups`, `.kicad_prl` ni `fp-info-cache`. `integridad_tfg.py verificar`: «TFG intacto: 337 archivos». El MCP no lo comprobé (no lo usé, por orden del coordinador); los dos logs dicen que hicieron `close_project` y que `get_backend_state` no tenía nada cargado | Cumple |

### Inventario frente a la v1

En la base hay 61 referencias, que coinciden con las del log de ing-esquematicos (15 + 1 + 32 + 9 retiradas y 4 conservadas):

| Hoja | Retirado (referencia · valor) | Motivo según v0.4 |
|---|---|---|
| Alimentacion | J5 DC Jack; U2 TPS54202DDC; L1 22 µH; C1 10 µF; C2, C3 100 nF; C4, C5 22 µF; C6 68 pF; R9 270k; R10 33k; R11 100k; R12 13k; R13 180; D9 LED verde | ALI-02 (borne), ALI-05 (el TPS54202 no llega a ≥ 60 V) y ALI-06. El LED D9 y su R13 cuelgan del 5 V del buck retirado (ALI-10 se rehace con el bloque) |
| MCU | U1 WEMOS-S2-MINI | MCU-01 |
| Salidas | K1–K4 relés SRD; Q1, Q2, Q5, Q6 PS2705; Q3, Q4, Q7, Q8 BC817; D3, D4, D7, D8 1N4007; D1, D2, D5, D6 LED; R1, R2, R5, R6 50; R3, R4, R7, R8 1k; J1–J4 bornes de 3 polos a 5,00 mm | REL-01, REL-03 y DEC-0003. Bornes: FAB-07 (2 polos, 5,08 mm) |
| Conectores | J6 borne de 2 polos a 5,00 mm, R14 270k, R15 150 y C7 100 nF (lazo 4–20 mA); J7 cabecera de 3 pines (DHT11); TP1–TP4 | DEC-0002, AMB-01 y FAB-07. Redes de los TP en la base: TP1 `V_Level`, TP2 `+12V`, TP3 `+5V` y TP4 `+3.3V` |
| Conservado | H1–H4 `Mechanical:MountingHole`, `MountingHole_3.2mm_M3_Pad_Via` (librería oficial de KiCad 10), `in_bom no` | FAB-08 (4 taladros M3) y KIC-01 (huella oficial) |

También se retiraron 34 símbolos de alimentación y 4 `PWR_FLAG`. Sin redes, un `PWR_FLAG` suelto daría error de ERC.

**¿Se pierde algo que la v2 pida tal cual?** No. Hay tres requisitos de la v2 con algo parecido en la v1, y ninguno se cumple con la pieza de la v1 tal como está:

- **ALI-10 (LED de alimentación):** D9 estaba en el 5 V del TPS54202.
- **ALI-11 (test points):** TP3 y TP4 eran *pads* genéricos en redes de la v1, y el bloque de alimentación los tiene que crear con sus redes.
- **REL-07 (LED por canal):** iban en serie con el opto.

Los textos de cada hoja recogen esos requisitos para el bloque nuevo. La spec pide además retirar en caso de duda.

**H1–H4:** en la PCB solo cambian la posición, el campo `LCSC Part#` vacío que añade «Actualizar desde el esquema» y el intercambio de las posiciones de la referencia y del valor en H1 y H3 (los de arriba), para que la serigrafía quede dentro del contorno. Pads, taladros, patio y atributos son iguales que en la base (`val14\fp_h.py`).

### PCB y proyecto

- **Contorno.** `gr_rect` en `Edge.Cuts`, de (100, 60) a (200, 130) mm: 100,0 × 70,0 mm (`esp-riego.kicad_pcb` l. 886–896). El texto «CONTORNO PRELIMINAR 100 x 70 mm (FAB-08, SPEC-0014)…» está en `Cmts.User` (l. 897).
- **Taladros.** H3 (104, 64), H1 (196, 64), H4 (104, 126) y H2 (196, 126), a 4 mm de los dos bordes de su esquina. El pad de Ø 6,4 mm queda a 0,8 mm del borde, por encima de los 0,5 mm de FAB-02, y el patio de r = 3,45 mm, a 0,55 mm. El DRC lo confirma con la regla nueva.
- **Reglas** (`.kicad_pro`, `rules`, l. 124–145):

  | Regla | Valor | FAB-02 |
  |---|---|---|
  | `min_clearance` | 0,2 | ≥ 0,2 |
  | `min_track_width` | 0,2 | ≥ 0,2 |
  | `min_connection` | 0,2 | — |
  | `min_copper_edge_clearance` | 0,5 | ≥ 0,5 |
  | `min_via_diameter` | 0,6 | 0,6 |
  | `min_through_hole_diameter` | 0,3 | 0,3 |
  | `min_via_annular_width` | 0,15 | (0,6 − 0,3)/2 |

  La vía predefinida y la de la clase `Default` son de 0,6/0,3.
- **Clases de red.** Solo queda `Default` (pista 0,2, separación 0,2), con `netclass_assignments: null` y `netclass_patterns: []`. Se han borrado las clases `power` y `signal`, las 28 asignaciones y los 11 patrones de la v1, y la exclusión de DRC de U1.
- **Restos.** No hay `embedded_files` en la PCB (Grep: 0). `outputdirectory ""` (l. 127). `comment 1` = «Placa de control de riego» (l. 15). En `hardware/v2/*.kicad_*`, el Grep de `Cajetin`, `Control_De_Riego`, `TFG`, `12V`, `REL[1-4]`, `ECHO`, `TRIG`, `ESP32_S2`, `G:/` y `C:/` no encuentra nada, salvo el texto explicativo de la hoja MCU y las tablas de librerías (observación 02).

## Requisitos

| Requisito | Evidencia | Resultado |
|---|---|---|
| KIC-02 | Las 4 hojas por bloque siguen en la jerarquía. La 5.ª, `Sensores`, queda anunciada en la raíz y en el `README.md` para el bloque de temperatura y humedad | Cumple en lo que pide esta spec (4 hojas). `Sensores` queda pendiente |
| KIC-03 | ERC 0, DRC 0 y paridad 0 | Cumple |
| FAB-02 | Tabla de reglas de arriba y DRC 0 con ellas | Cumple |
| FAB-08 | 100 × 70 mm y 4 taladros M3 en las esquinas, marcados como preliminares hasta el *floorplan* | Cumple (preliminar) |
| FAB-03 | `Default` tiene la pista a 0,2 mm, y FAB-03 pide 0,25 mm. La spec deja las clases para el layout, y el log de ing-layout lo anota como pendiente | Fuera de alcance, anotado |

## Hallazgos

Severidad: **C** crítico · **A** alto · **M** medio · **B** bajo.

| ID | Sev. | Hallazgo | Evidencia | Requisito | Cambio propuesto |
|---|---|---|---|---|---|
| VAL-0014-01-01 | B | **Dos frases de los textos de bloque no describen bien la v1.** (a) En Conectores: «los test points a +12 V de la v1 no cumplen…». Solo TP2 estaba en `+12V`: TP1 estaba en `V_Level`, TP3 en `+5V` y TP4 en `+3.3V`. Así, el texto da a entender que solo se retiraron puntos de 12 V. El log sí lo cuenta bien (l. 93–96). (b) En Alimentacion: «buck TPS54202 a 12 V» se lee como si la salida fuera de 12 V; en la v1 bajaba de 12 V a 5 V | `conectores.kicad_sch` l. 471; `alimentacion.kicad_sch` l. 28; redes de la base en `val14\base_net.net` | — | (a) «los test points TP1–TP4 de la v1 (V_Level, +12 V, +5 V y +3,3 V)»; (b) «buck TPS54202 de 12 V a 5 V». Son textos provisionales que se borran con cada bloque: se puede corregir entonces, o ahora si se vuelve a tocar la hoja |
| VAL-0014-01-02 | B | **Las tablas de librerías del proyecto solo tienen librerías de la v1, y ninguna se usa.** `fp-lib-table` lista PS2705, BC817-25-7, PRT10811, KiCad, Wemos s2 mini, PhoenixTerminal, SMMS0530-150M y DC-Jack. `sym-lib-table` lista PS2705-1-F3-A, BC817-25-7-F, 1548129, PRT-10811 y Wemos s2 mini. Tras la limpieza no queda ningún símbolo ni huella que las use: H1–H4 usan `Mechanical` y `MountingHole`, que son oficiales. Así, el primer bloque puede colocar por error una pieza de la v1 desde el selector (un PS2705, un Wemos o el jack) en un esqueleto que se pretende limpio. Ningún log lo menciona. La spec solo excluye añadir las tablas de las piezas nuevas | `hardware/v2/fp-lib-table` l. 3–10; `hardware/v2/sym-lib-table` l. 3–7 | KIC-01 (en espíritu); objetivo de la spec | Quitar de las dos tablas las entradas de la v1 cuando se añadan las librerías de la v2 (`esp-riego.kicad_sym` y `esp-riego.pretty`, de SPEC-0015), en la spec que las integre o en el primer bloque. Las librerías siguen en `hardware/libraries/` para `v1-tfg`, que tiene sus propias tablas. Después, `verificar.py` |

**Notas, sin hallazgo:**

- El anillo de H1–H4 (`Pad_Via`, sin red) se puede dejar sin red, llevar a GND o cambiar a NPTH. Los dos autores lo dejan para el *floorplan*, y me parece correcto.
- La PCB no declara las capas `F.Fab` y `B.Fab` en `(layers …)`, que es herencia de la v1, aunque H1–H4 tienen textos en `F.Fab`. Lo probé: `kicad-cli pcb export pdf --layers F.Fab` las traza bien (`val14\copia\fab.pdf`), así que no hay pérdida.
- El `copper_finish` del *stackup* es «None». Lo propongo para la checklist de fabricación.

## Contraste con los logs de los autores (leídos al final)

**01-ing-esquematicos:**

- **Inventario:** coincide con el mío referencia por referencia (57 retiradas: 15 + 1 + 32 + 9). También coinciden los recuentos de elementos retirados: 191 cables (49 + 15 + 108 + 19), 31 uniones, 13 etiquetas globales, 24 locales, 20 *netclass flags* y 22 *no-connect*.
- **Motivos:** se sostienen. El del TPS54202 (VIN de 28 V como máximo, frente a ≥ 60 V de ALI-05) coincide con el rango de entrada de 4,5–28 V de esa pieza, aunque en esta revisión no lo he cotejado con la página del datasheet. Para retirarla basta con que no llegue a 60 V.
- **Ejemplo de `comment 1`:** el log dice que el de la spec no cabe en la casilla. En el PDF, las descripciones acortadas caben.
- **Verificación intermedia:** ERC 0, DRC 40 y paridad 61, antes de que la PCB se sincronizara. Es coherente con el estado del commit `3c8a700`.

**02-ing-layout:**

- **Lo que quita la limpieza:** 57 huellas, 262 segmentos, 36 vías, 3 zonas, 2 `gr_rect`, 5 `gr_text` y `embedded_files`. Coincide con mi inventario de la base.
- **Reglas, clases y exclusión:** coinciden con el `diff`.
- **«La PCB guardada por pcbnew es idéntica a la del script»:** reproducido con otro método. `kicad-cli pcb upgrade --force` da un archivo idéntico byte a byte.
- **Comentarios sobre el MCP:** que reescribe el `.kicad_pro` y que `sync_schematic_to_board` no copia campos. No los he comprobado, porque no usé el MCP.
- **Su observación de que «KiCad E.D.A. 10.0.6» pisa una línea del cajetín:** se ve también en mis PDF. Es de `ESP-Riego.kicad_wks`, que está en la zona de librerías y no en esta spec.

Ningún log afirma algo que los artefactos no demuestren.

## Propuestas para las checklists

- **`esquema.md` / `layout.md`:** «`sym-lib-table` y `fp-lib-table` del proyecto solo listan librerías en uso o previstas para la versión; no quedan librerías de una versión anterior sin uso». Viene de la observación 02.
- **`proceso.md` (o una sección de limpiezas o migraciones):** «En una spec de limpieza, el inventario de lo retirado se coteja con la netlist del estado de partida (referencias, valores y redes), no solo con los recuentos». Así se detectó la observación 01.
- **`fabricacion.md`:** «`copper_finish` del *stackup* según FAB-01 (HASL sin plomo o ENIG) y grosor de cobre según D6».

## Veredicto

**APROBADO_CON_OBSERVACIONES.** Se cumplen los seis criterios de aceptación. `verificar.py` da LIMPIO (ERC 0, DRC 0 y paridad 0). No queda ninguna pieza de la v1 que contradiga v0.4. H1–H4 están justificados con FAB-08 y KIC-01, y el inventario cuadra con la v1. Hay dos observaciones B (01 y 02), que el coordinador puede convertir en specs propuestas o agrupar con la integración de las librerías de SPEC-0015 o con el primer bloque.
