JoanSanbartolome/ESP-Riego/gestion/informes/VAL-0013-01.md

---
id: VAL-0013-01
spec: SPEC-0013
fecha: 2026-11-05
commit_revisado: e808e47
checklists: [librerias v1 (rutas y tablas), esquema v4 (estructura: jerarquía y cajetín), proceso v2 (efectos secundarios)]
veredicto: RECHAZADO
---

# VAL-0013-01 · Copia de trabajo de la v2

## Alcance de la revisión

Revisión de la rama `spec/SPEC-0013-copia-v2` en `e808e47`. Cubre dos commits:

- `dd9d7a9` (coordinador): `docs/03-plan-de-diseno.md`, fases 2–4.
- `e808e47` (`jr-conformidad`): `hardware/v2/` (7 archivos del proyecto, `sym-lib-table`, `fp-lib-table` y `README.md`) y su log.

Checklists aplicadas:

- `librerias.md` v1: solo «Tablas con `${KIPRJMOD}`; ninguna ruta absoluta». No hay piezas nuevas ni modificadas, así que no hay tabla de cotas.
- `esquema.md` v4: apartado «Estructura» (hojas por bloque y cajetín).
- `proceso.md` v2: «Efectos secundarios» (`md5sum` e integridad del TFG).

**Método.** Repetí todas las comprobaciones yo mismo:

- `verificar.py` sobre `hardware/v2` y `hardware/v1-tfg`, con `md5sum` antes y después.
- `kicad-cli` (10.0.6) solo sobre una copia de `hardware/{v1-tfg,v2,libraries}` en `…\scratchpad\copia\`.
- Scripts propios en el scratchpad: `cmp_net.py` (netlists), `cmp_inf.py` (ERC/DRC/paridad, violación por violación) y la PCB v1 con el mapeo de hojas aplicado (`copia\v1_mapeada.kicad_pcb`).
- No usé el MCP. Leí el log del autor después de formar los hallazgos.

## Comprobaciones automáticas

`python herramientas/verificar.py hardware/v2 --salida <scratchpad>\ver_v2`, y lo mismo para `hardware/v1-tfg`. `md5sum -c` de `hardware/v2/*` y `hardware/v1-tfg/*`: todo OK después de verificar. `verificar.py` crea el `.kicad_prl` y después lo borra.

| Comprobación | v2 (HEAD) | Frente a v1-tfg (multiconjunto de tipo, severidad, descripción, elementos y posiciones, con el mapeo de hojas) |
|---|---|---|
| ERC | 1 `pin_to_pin` (aviso) | Idéntico. Las hojas del informe son `/`, `/Salidas/`, `/MCU/`, `/Alimentacion/` y `/Conectores/` |
| DRC | 40: 1 `starved_thermal` y 39 `lib_footprint_mismatch`; 0 sin conectar | Idéntico, violación por violación |
| Paridad esquema↔PCB | 77: 61 `footprint_symbol_field_mismatch`, 10 `net_conflict` y 6 `footprint_symbol_mismatch` | Idéntica, elemento por elemento |

## Criterios de aceptación de la spec

| Criterio | Evidencia | Resultado |
|---|---|---|
| `verificar.py hardware/v2` da lo mismo que la v1 (ERC 1, DRC 40, paridad 77) | Tabla de arriba: mismos recuentos y mismas violaciones una a una | Cumple |
| El diseño es el de la v1: netlist con las mismas 61 referencias, valores, huellas y conexiones, y solo cambia el prefijo de hoja. La PCB conserva posiciones, pistas, vías y zonas | **Netlist** (`kicad-cli sch export netlist --format kicadsexpr`, `cmp_net.py`): 61/61 componentes, iguales en valor, huella, datasheet, campos, propiedades, `libsource`, `tstamps` y `sheetpath` (este último tras el mapeo). 70/70 redes con el mismo nombre tras el mapeo y los mismos nodos (ref, pin, tipo); 173 nodos. La partición de nodos, que no depende de los nombres, es idéntica. El único prefijo de red con hoja es `/Modulo_reles/` → `/Salidas/`. El `diff` textual de las netlists mapeadas solo difiere en la cabecera (ruta, fecha y cajetín). **PCB:** aplico a la PCB v1 los mapeos `/Modulo_reles/`→`/Salidas/`, `/ESP32_S2/`→`/MCU/`, `/Conectores y agujeros PCB/`→`/Conectores/` y los tres `sheetfile`. El `diff --strip-trailing-cr` con `esp-riego.kicad_pcb` solo da el `title_block` (l. 11–16). No cambia ningún segmento, vía, zona, posición, UUID, `path` ni modelo 3D. Renombrados en la PCB: 32 + 1 + 13 `sheetname`, 32 + 15 + 1 `sheetfile` y 12 redes `/Salidas/…` | Cumple |
| La jerarquía tiene las 4 hojas de la tabla y no queda ninguna referencia a los archivos antiguos | `esp-riego.kicad_sch` l. 31–180: `Salidas`·`salidas.kicad_sch`, `MCU`·`mcu.kicad_sch`, `Alimentacion`·`alimentacion.kicad_sch` y `Conectores`·`conectores.kicad_sch`, con las UUID de hoja de la v1. `.kicad_pro` l. 887–908 (`sheets`) coherente. No hay hojas huérfanas: los 4 `.kicad_sch` hijos están referenciados. Grep de `Control_De_Riego\|allimentacion\|wemos_s2mini\|modulo_reles\|Modulo_reles\|ESP32_S2\|agujeros` en `hardware/v2`: solo aparece en la tabla de correspondencia del `README.md` (l. 9–12), que es intencionada. `diff` de cada hoja frente a la v1: solo cambian el `title_block` y `(project "Control_De_Riego"` → `"esp-riego"` (las instancias `(project ""` heredadas de la v1 no cambian) | Cumple |
| El cajetín del esquema y de la PCB tiene los datos de la v2 y ningún resto del TFG | Los `title_block` de los 5 esquemas y de la PCB tienen los datos de la v2. Pero el cajetín que se ve (plano exportado con `kicad-cli sch export pdf` y `pcb export pdf --include-border-title`) muestra «PROYECTO: Joan San Bartolomé Ferri», el título del TFG bajo «Plano:» y ni el título «ESP-Riego v2» ni la revisión «2.0-dev». Hallazgos 01 y 02 | **No cumple** |
| Sin rutas absolutas; v1-tfg y libraries sin cambios; sin `.lck` ni `-backups/`; MCP cerrado | Grep de `(^\|[^a-zA-Z])[A-Za-z]:[\\/]`, `/Users/`, `josan` y `Llibreries` en `hardware/v2`: 0 coincidencias (las únicas `X:/` son URL `https://`). Tablas idénticas a las de la v1 (`${KIPRJMOD}/../libraries/…`). `git diff 298af3c HEAD -- hardware/v1-tfg hardware/libraries` y `git diff v1.1-tfg HEAD -- …` vacíos. `find hardware` sin `.lck`, `*-backups`, `.mcp-backups`, `.kicad_prl` ni `fp-info-cache`. En la auditoría (`2026-11-05.jsonl`, l. 145–164) no hay ninguna llamada MCP de `jr-conformidad`. `integridad_tfg.py verificar`: «TFG intacto: 337 archivos» | Cumple (con la observación 03) |

## Requisitos

| Requisito | Evidencia | Resultado |
|---|---|---|
| KIC-01 (librerías en el repositorio con `${KIPRJMOD}`, sin rutas absolutas) | Tablas con `${KIPRJMOD}/../libraries/…`; las dos `page_layout_descr_file` (l. 694 y 875 del `.kicad_pro`) con `${KIPRJMOD}`; sin rutas absolutas | Cumple |
| KIC-02 (esquema jerárquico por bloques) | 4 hojas `Alimentacion`, `MCU`, `Salidas` y `Conectores`. `Sensores` llega con su bloque, como dice la spec. El contenido de las hojas sigue siendo el de la v1, como pide la spec | Cumple en lo que pide esta spec |

## Cambio del coordinador en `docs/03` (`dd9d7a9`)

Es coherente con la spec y con el README de `hardware/v2`: forma de trabajo bloque a bloque (fase 2), copia de trabajo con las 4 hojas y `sensores` después (fase 3), y layout rehecho con el esquema estable (fase 4). No encuentro nada que observar.

## Hallazgos

Severidad: **C** crítico · **A** alto · **M** medio · **B** bajo.

| ID | Sev. | Hallazgo | Evidencia | Requisito | Cambio propuesto |
|---|---|---|---|---|---|
| VAL-0013-01-01 | A | **El cajetín visible conserva el TFG y no muestra la v2.** La hoja de dibujo `Cajetin_Kicad.kicad_wks` no usa `${TITLE}`, `${REVISION}`, `${COMPANY}` ni `${SHEETNAME}`. Solo pinta `${ISSUE_DATE}`, `PROYECTO: ${COMMENT1}`, `${COMMENT3}` (Plano Nº) y `${COMMENT4}` (Escala), además de textos fijos: el título del TFG «Estudio, diseño y fabricación de un dispositivo inalámbrico para el control de un sistema de riego por goteo» bajo «Plano:» y «Autor: Joan San Bartolomé Ferri». En todas las hojas y en la PCB, «ESP-Riego v2» y «2.0-dev» están en el archivo pero no se ven, y el título del TFG sí. La spec es contradictoria: pide mantener esa hoja de dibujo y no tocar `hardware/libraries/`, pero también «ningún resto del TFG». Tampoco se cumple la checklist `esquema.md` v4: «Cajetín con proyecto, hoja, versión y fecha» | `hardware/libraries/Cajetin_Kicad.kicad_wks` l. 125 (título TFG), 143 (autor fijo), 151 (`PROYECTO: ${COMMENT1}`), 158 y 166. Ninguna aparición de `TITLE`, `REVISION`, `COMPANY` ni `SHEETNAME`. Planos: `scratchpad\copia\sch_v2.pdf` (p. 1) y `pcb_v2_cajetin.pdf` | KIC-02 (identificación de las hojas), criterio 4 | El coordinador corrige la spec y autoriza una hoja de dibujo propia de la v2, sin tocar la de la v1: por ejemplo `hardware/libraries/ESP-Riego.kicad_wks`, copia de la actual sin el texto fijo del TFG y con `${TITLE}`, `${REVISION}`, `${ISSUE_DATE}`, `${COMPANY}` y `${SHEETNAME}`. Después hay que apuntar a ella las dos `page_layout_descr_file` de `esp-riego.kicad_pro` (l. 694 y 875) y comprobar el resultado en el PDF exportado. Si prefiere no crear la hoja, puede rebajar el criterio a «los campos `title_block`» y aceptar el texto fijo hasta el cambio de layout. En ese caso, la decisión debe constar en la spec |
| VAL-0013-01-02 | M | **«PROYECTO: Joan San Bartolomé Ferri».** El autor puso su nombre en `comment 1`, que la hoja de dibujo muestra como «PROYECTO:». El nombre del autor ya aparece en el texto fijo «Autor:», así que sale dos veces y el proyecto no aparece. En la v1, `comment 1` era el nombre del plano y el autor iba en `comment 2`, que la hoja no muestra. No se comprobó el plano exportado | `esp-riego.kicad_sch` l. 12; l. 12 de las 4 hojas; `esp-riego.kicad_pcb` l. 15; `Cajetin_Kicad.kicad_wks` l. 151; `sch_v2.pdf` p. 1 | criterio 4 | Con la hoja de dibujo actual: `comment 1` = «ESP-Riego v2» (o el nombre del bloque de cada hoja) en los 5 esquemas y en la PCB. Con una hoja nueva (hallazgo 01): definir en el README de `hardware/v2` qué campo lleva cada dato, y comprobarlo en el PDF |
| VAL-0013-01-03 | B | **Rutas de salida heredadas que apuntan a la raíz del repositorio.** `pcbnew.output.plot` = `"../../"` y `schematic.bom_export_filename` = `"..\\..\\esp-riego.csv"` son relativas a `hardware/v2`. Un trazado o una BOM desde la interfaz caería en la raíz del repositorio. El autor renombró el archivo de la BOM pero mantuvo la ruta. Vienen de la v1, no son absolutas (KIC-01 se cumple) y no afectan al diseño | `esp-riego.kicad_pro` l. 687 y 698 (idénticas en `Control_De_Riego.kicad_pro`, salvo el nombre) | FAB (paquete en `fabricacion/`) | Ponerlas a `""` / `"esp-riego.csv"`, o a `../../fabricacion/v2.0/`, en esta spec o en la primera de fabricación. No bloquea |

**Nota, sin hallazgo.** Los fines de línea de la copia de trabajo son LF en `esp-riego.kicad_pcb`, `.kicad_pro` y `README.md` y CRLF en el resto. El índice está en LF para todos (`git ls-files --eol`, `* text=auto`), así que no hay efecto.

## Contraste con el log del autor (leído al final)

- Lo comprobable del log se reproduce: verificación, netlist (61 refs, 70 redes), PCB (solo el cajetín tras los mapeos), ausencia de restos de nombres antiguos y de rutas absolutas, `v1-tfg` y `libraries` intactas, y no se usó el MCP (la auditoría lo confirma).
- El log (l. 12) dice «quitados los comentarios y la empresa del TFG. Hoja de dibujo sin cambios», pero no advierte que la hoja de dibujo contiene el título del TFG como texto fijo ni que `comment 1` se pinta como «PROYECTO:». La afirmación implícita de que el cajetín quedó sin restos del TFG no está demostrada (hallazgos 01 y 02).
- La línea 155 de la auditoría muestra que el autor ejecutó `kicad-cli` directamente sobre `hardware/v2` y luego borró el `.kicad_prl` con `rm -f`. Está permitido (no es el TFG) y el resultado está limpio, pero lo recomendable es trabajar sobre copias, como ya hace `verificar.py`.

## Propuestas para las checklists

- `esquema.md` (Estructura) y `layout.md`: «El cajetín se comprueba **en el plano exportado**: `kicad-cli sch export pdf` y `kicad-cli pcb export pdf --include-border-title`. No basta con el `title_block`, porque la hoja de dibujo puede tener textos fijos o no usar `${TITLE}`/`${REVISION}`».
- `fabricacion.md`: «Las rutas de salida del `.kicad_pro` (`plot`, `bom_export_filename`, `step`, `svg`…) están vacías o apuntan dentro de `fabricacion/<versión>/`».
- Para specs de copia o renombrado de proyectos (podría ir en `librerias.md`, o en una checklist de importación): «`diff` de la PCB y de las hojas frente al origen, con el mapeo de nombres aplicado: solo debe quedar lo que la spec permite».

## Veredicto

**RECHAZADO.** No se cumple el criterio 4 (cajetín sin restos del TFG y con los datos de la v2 visibles) y hay un hallazgo A (01). Todo lo demás es correcto: el diseño copiado es idéntico al de la v1 (netlist, PCB, ERC, DRC y paridad, elemento por elemento), la jerarquía y los nombres son los de la spec, y no hay rutas absolutas ni cambios en `v1-tfg` o `libraries`. Para corregirlo hace falta primero una decisión del coordinador sobre la hoja de dibujo (01). Después, ajustar `comment 1` (02) y, opcionalmente, las rutas de salida (03).
