JoanSanbartolome/ESP-Riego/gestion/informes/VAL-0013-02.md

---
id: VAL-0013-02
spec: SPEC-0013
fecha: 2026-11-05
commit_revisado: 8e0fd4e
checklists: [librerias v1 (rutas y tablas), esquema v4 (estructura: jerarquía y cajetín), proceso v2 (efectos secundarios)]
veredicto: APROBADO_CON_OBSERVACIONES
---

# VAL-0013-02 · Copia de trabajo de la v2 (segunda validación)

## Alcance de la revisión

Segunda validación de la rama `spec/SPEC-0013-copia-v2`, en `8e0fd4e`. Cambios desde VAL-0013-01 (`git diff 886d8e1 HEAD`):

- `f1c9d77` (coordinador): spec corregida. Incluye la hoja de dibujo propia de la v2, `comment 1`, las rutas de salida y la comprobación en el PDF.
- `8e0fd4e` (`jr-conformidad`): hay una hoja nueva, `hardware/libraries/ESP-Riego.kicad_wks`. En `esp-riego.kicad_pro`, las dos `page_layout_descr_file` apuntan a ella y `plot`, `bom_export_filename` y `step` quedan vacíos. `comment 1` pasa a «ESP-Riego v2» en los 5 esquemas y en la PCB. El log del autor tiene una sección nueva.

Repetí también las comprobaciones de la primera validación sobre el estado nuevo. No usé el MCP. `kicad-cli` solo trabajó sobre una copia nueva (`…\scratchpad\copia2\`), y git, solo para leer. El log del autor lo leí al final.

## Comprobaciones automáticas

`python herramientas/verificar.py hardware/v2 --salida <scratchpad>\ver_v2b`. El `md5sum` de `hardware/v2/*`, `hardware/v1-tfg/*.kicad_*` y `hardware/libraries/*.kicad_wks` no cambia después de verificar.

| Comprobación | v2 (HEAD) | Frente a v1-tfg (`cmp_inf.py`, violación por violación, con el mapeo de hojas) |
|---|---|---|
| ERC | 1 `pin_to_pin` (aviso) | Idéntico |
| DRC | 40: 1 `starved_thermal` y 39 `lib_footprint_mismatch`; 0 sin conectar | Idéntico |
| Paridad esquema↔PCB | 77 (61, 10, 6) | Idéntica |

## Seguimiento de los hallazgos de VAL-0013-01

| Hallazgo | Comprobación | Estado |
|---|---|---|
| 01 (A): el cajetín visible conserva el TFG y no muestra la v2 | **`ESP-Riego.kicad_wks`:** el `diff` con `Cajetin_Kicad.kicad_wks` conserva igual el marco, las reglas, los rectángulos y las líneas. Quita los textos fijos del TFG (título, «Autor:», «PROYECTO:», «Plano:», «Plano Nº», «Escala») y `${COMMENT3}`/`${COMMENT4}`. Añade `${TITLE}`, `Hoja: ${SHEETNAME}`, `Rev: ${REVISION}`, `${COMPANY}` y `${COMMENT1}`. **`.kicad_pro`:** l. 694 y 875 apuntan a `${KIPRJMOD}/../libraries/ESP-Riego.kicad_wks`. **Planos** exportados desde la copia: `copia2\sch_v2.pdf`, págs. 1–5, y `copia2\pcb_v2.pdf`, con `--include-border-title`. Revisé todas las páginas como imagen. Cada una muestra «ESP-Riego v2», «Rev: 2.0-dev», «Date: 2026-11-05», «Joan San Bartolomé Ferri» y «Hoja: esp-riego / Salidas / MCU / Alimentacion / Conectores». No aparece ningún texto del TFG | **Cerrado** |
| 02 (M): «PROYECTO: Joan San Bartolomé Ferri» | `comment 1` = «ESP-Riego v2» en los 5 esquemas (l. 12) y en la PCB (l. 15). La hoja nueva ya no tiene «PROYECTO:» | **Cerrado** (queda la observación 03) |
| 03 (B): rutas de salida hacia la raíz del repositorio | En `.kicad_pro`, `plot`, `bom_export_filename`, `step`, `svg` y el resto de `output` están vacíos (Grep de valores no vacíos: 0). **Pero** el directorio de trazado de la PCB está en el propio `.kicad_pcb` (`pcbplotparams`), que sigue con `(outputdirectory "../../")`. Ese campo se me pasó en VAL-0013-01 | **Cerrado en el `.kicad_pro`**; lo que queda pasa a la observación 01 |

## Criterios de aceptación de la spec (versión corregida en `f1c9d77`)

| Criterio | Evidencia | Resultado |
|---|---|---|
| `verificar.py hardware/v2`: ERC 1, DRC 40, paridad 77, como la v1 | Tabla de arriba | Cumple |
| El diseño es el de la v1 (netlist y PCB) | Netlist nueva de `copia2` frente a la netlist v1 de VAL-0013-01 (`cmp_net.py`): 61/61 componentes iguales y 70/70 redes con los mismos nodos. La partición de nodos es idéntica y el único prefijo que cambia es `/Modulo_reles/`→`/Salidas/`. PCB v1 con el mapeo frente a `esp-riego.kicad_pcb`: solo cambia el `title_block` (l. 11–15) | Cumple |
| La jerarquía tiene 4 hojas y no quedan referencias a los archivos antiguos | Sin cambios desde VAL-0013-01 (los esquemas solo cambian en `comment 1`). La PDF da 5 páginas con los nombres de hoja correctos | Cumple |
| Cajetín con los datos de la v2 y sin restos del TFG, comprobado en el PDF exportado sobre copias | Ver el seguimiento del hallazgo 01. En la PCB, el archivo aún guarda una copia incrustada de la hoja antigua, que no se usa (observación 02) | Cumple |
| Sin rutas absolutas; `v1-tfg` y `libraries` sin cambios salvo `ESP-Riego.kicad_wks`; sin `.lck` ni `-backups/`; MCP | Grep de rutas absolutas y de `Cajetin_Kicad` en `hardware/v2`: solo aparece el nombre del archivo incrustado (observación 02). `git diff --stat 298af3c HEAD -- hardware/v1-tfg hardware/libraries` y `git diff --stat v1.1-tfg HEAD -- …` dan solo `ESP-Riego.kicad_wks` (+179). El índice la guarda con LF (`git ls-files --eol`). `find hardware` no encuentra `.lck`, `*-backups`, `.kicad_prl` ni `fp-info-cache`. No hay MCP. `integridad_tfg.py verificar`: «TFG intacto: 337 archivos» | Cumple |

## Requisitos

| Requisito | Evidencia | Resultado |
|---|---|---|
| KIC-01 | La hoja nueva está en `hardware/libraries/` y se referencia con `${KIPRJMOD}`. No hay rutas absolutas | Cumple |
| KIC-02 | 4 hojas por bloque. El cajetín identifica cada hoja con `${SHEETNAME}` | Cumple en lo que pide esta spec |

## Hallazgos

Severidad: **C** crítico · **A** alto · **M** medio · **B** bajo.

| ID | Sev. | Hallazgo | Evidencia | Requisito | Cambio propuesto |
|---|---|---|---|---|---|
| VAL-0013-02-01 | B | **Directorio de trazado de la PCB hacia la raíz del repositorio.** El cuadro de trazado de pcbnew no usa `output.plot` del `.kicad_pro`, sino `pcbplotparams/outputdirectory` del `.kicad_pcb`, que sigue en `"../../"`. Un trazado desde la interfaz dejaría los Gerber en la raíz del repositorio. Viene de la v1 (`Control_De_Riego.kicad_pcb` l. 128). Es lo que quedaba de VAL-0013-01-03, que yo solo había localizado en el `.kicad_pro` | `hardware/v2/esp-riego.kicad_pcb` l. 127 | FAB (paquete en `fabricacion/`) | `(outputdirectory "")` o `"../../fabricacion/v2.0/gerber/"`, en esta spec o en la primera de fabricación. Hay que comprobar con `verificar.py` que no cambia nada más |
| VAL-0013-02-02 | B | **La PCB lleva incrustada la hoja de dibujo antigua.** `(embedded_files (file (name "Cajetin_Kicad.kicad_wks") (type worksheet) …))` es una copia comprimida de la hoja del TFG, heredada de la v1. Hoy no se usa: el `.kicad_pro` apunta a `ESP-Riego.kicad_wks` y el PDF lo confirma. Pero es un resto del TFG dentro de la PCB, y se usaría si alguien eligiera la hoja incrustada | `esp-riego.kicad_pcb` l. 24013–24034. La misma copia está en `Control_De_Riego.kicad_pcb` l. 24014 | criterio 4 (en espíritu) | Quitar el bloque `embedded_files`, o sustituirlo por `ESP-Riego.kicad_wks` si se quiere la hoja incrustada. Después, exportar de nuevo el PDF y pasar `verificar.py` |
| VAL-0013-02-03 | B | **Título repetido y casillas vacías en el cajetín.** `${TITLE}` y `${COMMENT1}` valen los dos «ESP-Riego v2» y salen dos veces en cada hoja. El hueco grande de arriba, que es el más visible, no aporta nada. Las casillas que eran «Plano Nº» y «Escala» quedan vacías, porque las líneas se conservan. Además, la spec (l. 45) aún justifica `comment 1` con «porque la hoja de dibujo lo pinta como «PROYECTO:»», y eso ya no es cierto con la hoja nueva | `copia2\sch_v2.pdf`, cualquier página. `ESP-Riego.kicad_wks` l. 142 y 172. `SPEC-0013-copia-v2.md` l. 45 | — | Usar `comment 1` para algo útil: por ejemplo, el nombre del bloque o la descripción de cada hoja (como en la v1, «Módulo de relés»…), o quitar `${COMMENT1}` de la hoja. Quitar o reaprovechar las casillas vacías. Actualizar la frase de la spec. Es cosmético y puede ir con la primera spec de bloque |

**Nota, sin hallazgo.** En la PCB, `Hoja: ${SHEETNAME}` muestra el nombre de la capa trazada («Hoja: Edge.Cuts»). Así funciona pcbnew, y es aceptable.

## Contraste con el log del autor (leído al final)

El log (sección «Corrección (VAL-0013-01)») se reproduce:

- La hoja nueva y lo que se ha quitado y añadido coinciden con el `diff`.
- Las rutas vacías en el `.kicad_pro` y `comment 1` coinciden.
- Los recuentos del PDF son correctos: «ESP-Riego v2» sale 10 veces en el esquema y 2 en la PCB, porque está repetido (observación 03).
- La verificación coincide, y no se usó el MCP.

El log no menciona `outputdirectory` ni `embedded_files`, que el `diff` de la PCB no mostraba porque vienen de la v1 sin cambios (observaciones 01 y 02).

## Propuestas para las checklists

- `fabricacion.md`: «Rutas de salida **del `.kicad_pro` y del `.kicad_pcb`** (`pcbplotparams/outputdirectory`) vacías o dentro de `fabricacion/<versión>/`». Completa la propuesta de VAL-0013-01.
- `esquema.md` / `layout.md`: «La PCB no lleva `embedded_files` con hojas de dibujo u otros archivos ajenos al diseño actual».
- Mantengo la propuesta de VAL-0013-01: comprobar el cajetín en el PDF exportado. Fue la comprobación que permitió cerrar el hallazgo 01.

## Veredicto

**APROBADO_CON_OBSERVACIONES.** Los tres hallazgos de VAL-0013-01 están cerrados. El de las rutas de salida lo está en el `.kicad_pro`; lo que queda en la PCB es la observación 01. Se cumplen los cinco criterios de la spec corregida. Quedan tres observaciones B (01–03), que el coordinador puede convertir en specs propuestas o agrupar con la primera spec de bloque o de fabricación.
