JoanSanbartolome/ESP-Riego/gestion/informes/VAL-0011-01.md

---
id: VAL-0011-01
spec: SPEC-0011
fecha: 2026-11-05
commit_revisado: 81b848f
checklists: [requisitos v3]
veredicto: RECHAZADO
---

# VAL-0011-01 · Requisitos v0.4: ventana del limitador y sobrecarga por canal

## Alcance de la revisión

- **Commits revisados:** `6f2888e` y `81b848f`, punta de `spec/SPEC-0011-requisitos-v04`. Base: `d4cf007` (apertura de la spec). Diff: `git diff d4cf007 81b848f`, 8 archivos:
  - `docs/02` (v0.3 → v0.4) y `docs/03`;
  - DEC-0004 (nueva);
  - las checklists de requisitos v3, esquema v4 y layout v4;
  - SPEC-0006 y SPEC-0011.
- **Checklist aplicada:** `gestion/checklists/requisitos.md` **v3**, la de esta rama. Las de esquema v4 y layout v4 se revisan como entregables, no se aplican.
- **Sin KiCad:** no he usado el MCP ni `kicad-cli`, porque la spec no toca archivos de KiCad.
- **Datasheets y fuentes** (texto extraído con `pdftotext` en `scratchpad/val1101/`):
  - MEAN WELL LRS-150 (`LRS-150-SPEC 2025-04-07`, ya usado en VAL-0007-01);
  - MEAN WELL LRS-100-24 (copia de led-card.com);
  - LRS-120 (copia de un distribuidor, TNI Controls, sin fecha). La URL de meanwell.com da 404, y no he encontrado la hoja oficial de la LRS-120-24;
  - Infineon BTT6050-1ERA rev. 1.00 (2019-03-09);
  - TI LM5069 (SNVS452G, enero de 2020) y la página de producto del TPS2663 (hoja rev. G, junio de 2024);
  - SMBJ33A: valores coincidentes en varios distribuidores (LCSC, JLCPCB y Automa), sin abrir la hoja del fabricante;
  - HLG-120H-24 (MEAN WELL): resultados de búsqueda que citan copias de la hoja. **No lo he comprobado** en el PDF oficial.
- **Cálculos propios:** `scratchpad/val1101/calc.py` (IPC-2221, banda, fuente, eFuses, carga instalada y BTT6050) y `scratchpad/val1101/traza.py` (trazabilidad en memoria y comparación de tablas).

## Comprobaciones automáticas

| Comprobación | Resultado |
|---|---|
| ERC / DRC / paridad | No aplica: la spec no toca archivos de KiCad. |
| `gestion.py trazabilidad` (en memoria, `traza.py`) | **0 avisos.** 57 requisitos vigentes. M: 12 sin cubrir, 1 en curso y 29 cubiertos. El `TRAZABILIDAD.md` versionado difiere en 12 filas, lo que es normal porque lo regenera el merge. |
| Tablas v0.3 (`d4cf007`) → v0.4 | **Cambiados (10):** ALI-04, ALI-09, ALI-12, ALI-13, FAB-01, FAB-09, REL-03, REL-05, REL-08 y REL-10. Ninguno nuevo ni quitado, y ninguna prioridad cambiada. |
| Campo `requisitos` de SPEC-0011 y de DEC-0004 | Los dos coinciden exactamente con los 10 cambiados: no falta ni sobra ninguno. El tráiler `Requisitos:` de `6f2888e` es el mismo. |
| IDs citados | Revisados en docs/02, docs/03, `CLAUDE.md`, las 6 checklists, los 4 agentes, DEC-0001 a DEC-0004, las specs abiertas o propuestas (0002, 0006, 0008, 0011 y 0012) y el estudio de salidas. **Ningún ID inexistente.** Los retirados solo aparecen en §9 y en DEC-0002. |
| Términos obsoletos (Grep) | Busco `4 A`, `16 V`, `32 V`, `hasta 5 A`, `> 4 A`, `0,5 × 4`, `4–5 A`, `0,3 mm` y `0,49 A` en docs/, las checklists, las specs abiertas o propuestas, `CLAUDE.md`, `gestion/README.md`, las plantillas, `.claude/agents/` y `.claude/agent-memory/`. Quedan restos vigentes en tres sitios (hallazgo 08):<br>- docs/02 §2: «de hasta 5 A»;<br>- el estudio de salidas (§0 N2, §1.3 y §8), sin aviso de DEC-0004 en SPEC-0008;<br>- la memoria de ing-esquematicos: «≈ 4 A en total».<br>Lo demás es historial (§9 v0.3, el historial de la checklist de layout v3) o el análisis de la v1. |

## Checklist de requisitos v3

| Punto | Evidencia | Resultado |
|---|---|---|
| `gestion.py trazabilidad` sin avisos | En memoria: 0 avisos | Cumple |
| IDs citados existen como vigentes o retirados | `traza.py` sobre 25 archivos | Cumple |
| Tabla de retirados con el motivo y la DEC; ningún ID reutilizado | §9: 9 filas. La v0.4 no retira ninguno | Cumple |
| Cambios de prioridad y de sentido anotados | §9 «En la v0.4» y DEC-0004 «Interpretación» | Cumple. La lista de secciones de DEC-0004 y del commit no cuadra (hallazgo 09) |
| Las cifras de la DEC coinciden con las de docs/02 | 3,5 A; 3,5–4,9 A; ≈ 4,2 A ± 16 %; 5,25 A; ≤ 0,25 A; 36,7 V frente a 33,6 V; 1 A; 4,9 A; ΔT ≤ 40 °C; ≈ 1,2 mm; 17 V y 31 V. Todas coinciden con ALI-04, ALI-09, ALI-12, ALI-13 y REL-05 | Cumple. Dato de la fuente erróneo en la DEC: «±10 %» (hallazgo 01) |
| El campo `requisitos` de la spec incluye todos los IDs cambiados | Comparación de tablas | Cumple |
| Cada decisión del usuario llega a un requisito vigente | DEC-0004 #1 → ALI-12, ALI-13 y ALI-04. #2 → REL-05, REL-08 y FAB-09 | Cumple |
| Cada interpretación del autor figura como tal en la DEC | DEC-0004, «Interpretación del coordinador»: la fuente supuesta, la lógica, el total, la banda, la TVS, la carga máxima, el dimensionamiento, los avisos y la carga abierta | Cumple |
| Decisiones abiertas (§7) coherentes | D6: «se revisa… con `Power_In` a 5 A y las salidas a 4,9 A». FAB-01 la cita | Cumple |
| Cadena de tensiones | OVP de 33,6 V < V_BR mínima de 36,7 V. Vc = 53,3 V ≤ 60 V / 1,1. UVLO ≈ 15 V | Cumple. ALI-06 no acota el UVLO que exige ALI-09 (hallazgo 04) |
| Presupuesto de la fuente frente a las cargas simultáneas | A 24 V cierra: 4,9 + 0,25 = 5,15 A < 5,25 A. Con la fuente ajustada por encima de 24 V, como admite ALI-01, no cierra | **Parcial (hallazgo 01)** |
| Cada criterio de §6 se puede verificar con la arquitectura | Todos. Los márgenes de algunos puntos de prueba son escasos (hallazgos 04 y 05) | Cumple |
| Orden de las protecciones de entrada coherente con §6 | No cambia respecto a la v0.3 | Cumple |
| Cada límite global tiene un mecanismo y una prueba en §6 | 3,5 A: limitador y prueba a 3,4 A y 5,5 A. Carga máxima de 1 A: dimensionamiento, aviso y prueba de 1 h. ≤ 0,25 A de la lógica: sin comprobación (hallazgo 06) | Parcial (hallazgos 01 y 06) |
| Puntos de prueba dentro de la ventana UVLO–VRWM | 16,5 V, 18 V, 30 V y 31,5 V están entre ≈ 15,75 V y 33 V | Cumple (hallazgo 04: márgenes respecto al umbral) |
| Si una protección depende de otra, el requisito dice qué ven los demás canales y la lógica | Sobrecarga del conjunto: «actúa antes que la fuente y la lógica no se reinicia». La sobrecarga de un canal no corta nada. El enclavamiento térmico del BTT no está descrito (hallazgo 03) | Parcial (hallazgo 03) |
| Cada umbral con tolerancia es una banda, con pruebas por encima y por debajo | ALI-13: banda 3,5–4,9 A, pruebas a 3,4 A y 5,5 A. ALI-09: umbrales 17 V y 31 V, pruebas a 16,5/18 V y 30/31,5 V, pero sin precisión de la medida (hallazgo 04) | Cumple (hallazgo 04) |
| En las protecciones escalonadas, cada escalón aguanta hasta que actúa el siguiente | La pista y el borne de la salida aguantan 4,9 A. Pero el retorno GND está fijado para 3,5 A (hallazgo 02), el fusible de entrada para 5 A frente a 5,15 A (hallazgo 07) y el BTT6050 se enclava antes (hallazgo 03) | Parcial (hallazgos 02, 03 y 07) |
| Los parámetros de los equipos externos se fijan como requisito o como supuesto en una DEC | DEC-0004 fija la fuente supuesta. Falta el punto de ajuste de la tensión, del que depende su protección (hallazgo 01) | Parcial (hallazgo 01) |
| Términos retirados, incluidas las memorias y los estudios que sustituye la DEC | Fila «Términos obsoletos» | Parcial (hallazgo 08) |
| Aclaraciones del usuario buscadas en las specs abiertas y en otras ramas | La fuente LED: SPEC-0006 pasa a 3,5 A, pero no recibe el límite de la lógica ni el hecho de que el bus ya está ocupado (hallazgo 06). SPEC-0008 no recibe DEC-0004 (hallazgo 08). No hay otras ramas con entregables de requisitos | Parcial (hallazgos 06 y 08) |
| Estudios de diseño (3 puntos) | La spec no cambia ningún estudio. El aviso que falta en el estudio de salidas está en el hallazgo 08 | No aplica |

## Criterios de aceptación de la spec

| Criterio | Evidencia | Resultado |
|---|---|---|
| Cada hallazgo del alcance está resuelto o justificado uno a uno | Tabla siguiente: el 02, el 05, el 06 y el 09 están resueltos, y también las propuestas de las checklists. El 01 lo está a 24 V nominales, pero no en el rango de ajuste que la propia DEC atribuye a la fuente (hallazgo 01) | **Parcial** |
| El umbral del limitador es una banda con tolerancia, compatible con la fuente, y la prueba de §6 queda fuera de ella | La banda (3,5–4,9 A) y las pruebas (3,4 A y 5,5 A) son correctas, y es alcanzable con piezas comunes (TPS2663 y LM5069, ver más abajo). Pero solo es «compatible con la fuente» a 24 V. Con la fuente supuesta (LRS, protección en % de la **potencia**) ajustada a 25 V, la protección mínima baja a 5,04 A < 5,15 A. Y a 28,8 V, las 12 válvulas de diseño consumen 4,03 A > 3,5 A (hallazgo 01) | **Parcial** |
| Ninguna corriente entre la nominal de un canal y el umbral del limitador queda sin mecanismo de protección ni prueba | Entre 1 A y 4,9 A: la pista (1,16 mm a ΔT = 40 °C) y el borne (18 A) aguantan sin protección propia, el firmware avisa (REL-10) y §6 lo prueba a 3,4 A. Detalles en los hallazgos 02, 03 y 05 | Cumple (con observaciones B) |

### Hallazgos de VAL-0007-01

| Obs. | Sev. | Estado | Evidencia |
|---|---|---|---|
| 01 · Ventana del limitador y fuente | M | **Parcial: queda el hallazgo 01** | (a) La fuente es un dato supuesto en DEC-0004 (`:29–34`) y en ALI-12 (`docs/02:80`): 5 A, protección desde 5,25 A y OVP de 33,6 V. (b) Banda en ALI-13 (`:81`): 3,5–4,9 A con la tolerancia incluida. (c) §6 (`:182`): 3,4 A y 5,5 A, fuera de la banda. (d) ALI-04 (`:72`) se queda con la SMBJ33A (V_BR ≥ 36,7 V > 33,6 V) y ALI-13 con ≥ 60 V. Todo cuadra **a 24 V**. No cuadra con la fuente ajustada al alza dentro de ALI-01. |
| 02 · Sobrecarga de un canal | M | **Resuelta según la decisión del usuario**, con los hallazgos B 02, 03 y 05 | REL-05 (`:103`): carga máxima de 1 A como parámetro, y pista y borne para 4,9 A con ΔT ≤ 40 °C. REL-08 (`:106`): sin protección por canal. REL-10 (`:108`): aviso sin cortar. FAB-09 (`:139`): carga máxima en la serigrafía. §6 (`:183`): un canal a 3,4 A durante 1 h. No se añade ningún componente, como pidió el usuario. |
| 05 · Aviso y punto de prueba; arranque en frío | B | **Resuelta**, con el hallazgo 04 | ALI-09 (`:77`): 17 V y 31 V, y arranque en frío desde 17 V. §6 (`:176`): 16,5 V, 18 V, 30 V y 31,5 V. Arranque a 17 V: 17 − 0,3 = 16,7 V > 15,75 V (UVLO de 15 V + 5 %). |
| 06 · Carga abierta frente al corte general; limitador en el reset | B | **Resuelta** | ALI-13: «el firmware habilita el bus… durante la comprobación de carga abierta de REL-10». REL-10: «con el canal apagado y el bus habilitado». §6, Salidas (`:178`): «ellos y el limitador común quedan desactivados durante el reset y el flasheo». La fila «Diagnóstico» no dice el estado, pero REL-10 sí. |
| 09 · Registro y redacción | B | **Resuelta**, con un resto en el hallazgo 09 | (a) El campo `requisitos` de DEC-0003 ya incluye AMB-02 y FAB-06. Su «Consecuencias» (`DEC-0003:82`) sigue sin FAB-06. (b) Sin objeto, porque se mantiene la SMBJ33A y ≥ 60 V basta. (c) FAB-01 (`:131`): «según REL-05; D6». (d) `docs/03:33–34`: limitador y presupuesto de los bordes. (e) REL-03 (`:101`): «La inductancia… se mide o se toma del fabricante antes de cerrar el esquema». (f) §6 T/HR (`:180`): «la corrección… que le corresponde (fija, o según las salidas activas)». |
| Propuestas de checklists | — | **Incorporadas** | Requisitos v3: las 5 propuestas (`requisitos.md:11, 29–31, 35`). Esquema v4: las 4 (`esquema.md:33–34, 53–54`). Dos llegan recortadas: la de salidas sin «retornos» (hallazgo 02) y la de IN/DEN sin «corriente dentro del datasheet». Layout v4 (`layout.md:26`): pistas para 4,9 A. |

## Comprobaciones técnicas pedidas por el coordinador

### 1. Fuente LED supuesta frente a datasheets reales

| Parámetro (DEC-0004) | LRS-120-24 (copia de distribuidor) | LRS-100-24 | LRS-150-24 (2025-04-07) | Resultado |
|---|---|---|---|---|
| 5 A nominales, 120 W | 5,0 A, 120 W | 4,5 A, 108 W | 6,5 A, 156 W | ✔ |
| Sobrecarga del 105–150 %, hipo | «110 % to 140 % rated load current», *hiccup* | «110 ~ 150 % **rated output power**», *hiccup* | «110 ~ 140 % **rated output power**», *hiccup* | ✔ como envolvente conservadora: 105 % queda por debajo del 110 % real. Pero la hoja oficial la da **en % de la potencia**, y no en corriente (hallazgo 01) |
| OVP de 28,8–33,6 V | Sin cifra | 28,8–33,6 V, se apaga y hay que desconectar la red | 28,8–33,6 V | ✔ |
| Ajuste de 21,6–28,8 V, «±10 %» | «±10 % (with V.ADJ)» | 21,6–28,8 V | 21,6–28,8 V | Rango ✔. Pero 21,6–28,8 V es **−10 / +20 %**, no ±10 % (errata, hallazgo 01) |

Otra fuente típica «para LED» de 24 V y 5 A, el *driver* MEAN WELL HLG-120H-24, limita en **corriente constante al 95–108 %** (4,75–5,4 A), según las copias de su hoja que citan los buscadores; no lo he comprobado en el PDF oficial. Con ella, 4,9 + 0,25 = 5,15 A > 4,75 A, y la banda no cierra. La DEC lo prevé («si la fuente real es otra, solo cambian las cifras»), pero ningún paso del plan obliga a mirar la etiqueta de la fuente real antes de elegir el limitador (hallazgo 01, propuesta c).

### 2. Banda del limitador y piezas comunes de ≥ 60 V

- **Banda:** centro 4,2 A, ± 16,7 %. Con la lógica, 4,9 + 0,25 = 5,15 A < 5,25 A a 24 V ✔. Las pruebas de §6 (3,4 A y 5,5 A) quedan fuera ✔.
- **Ejemplos** (sin elegir pieza):

| Pieza | Tensión | Tolerancia de corriente | Banda con centro en 4,2 A (y R al 1 %) | ¿Cabe en 3,5–4,9 A? |
|---|---|---|---|---|
| TI TPS2663 (eFuse) | 4,5–60 V de funcionamiento, 67 V de máximo absoluto | «0.6A to 6A adjustable current limit (±7%)» (página de producto, hoja rev. G) | 3,86–4,54 A | ✔ (lógica incluida: 4,79 A < 5,25 A) |
| TI LM5069 (*hot-swap*, MOSFET y *shunt* externos) | 9–80 V | V_CL de 48,5 / 55 / 61,5 mV (± 11,8 %), SNVS452G, tabla de características. Corte rápido V_CB de 80–130 mV | 3,67–4,74 A (R_S = 13,1 mΩ). Corte rápido a 6,0–10 A | ✔ |

- **Tensión:** Vc = 53,3 V < 60 V de funcionamiento del TPS2663, y por debajo del límite del LM5069 ✔. Los 60 V de ALI-13 bastan.

### 3. Pista, BTT6050 y borne con 4,9 A

- **IPC-2221, capa externa, 1 oz (35 µm):**
  - 4,9 A con ΔT = 40 °C → **1,16 mm** ✔ (≈ 1,2 mm);
  - con 1,2 mm: 37,8 °C a 4,9 A, 16,5 °C a 3,4 A y 1 °C a 1 A;
  - 1 A con ΔT = 10 °C → 0,30 mm, que queda cubierto;
  - con 2 oz: 0,58 mm.
- **BTT6050-1ERA:**
  - I_L(NOM) = 4,5 A con T_A = 85 °C (P_5.5.8). R_DS(ON) de 50 mΩ a 25 °C y ≤ 100 mΩ a 150 °C (P_5.5.2, P_5.5.6);
  - R_thJA = 28 K/W en placa 2s2p (P_4.3.2), y 45–100 K/W en 1s0p según el área de cobre (figura 7);
  - con 4,9 A: 1,2–2,4 W. Con T_A = 50 °C, T_J va de ≈ 100 °C a > 150 °C, según la placa;
  - si llega a T_J(SC) (150–170 °C, P_5.x), **se enclava**: «No retry strategy… Only the IN pin signal toggling can re-activate the power stage (latch behavior)» (§6.5.2);
  - en ninguno de los dos casos se daña. Pero no hay «apagado y rearme», como dice DEC-0004, y las protecciones «are designed for neither continuous nor repetitive operation» (§6) (hallazgo 03).
- **Borne de 5,08 mm:** el estudio de salidas (`estudio-salidas.md:217, 302`) da el WJ500V-5.08-2P (LCSC C8465) para 18 A. 4,9 A queda muy por debajo ✔. No he vuelto a comprobar la hoja.

### 4. Total de 3,5 A frente a REL-05 y la carga instalada

- **A 24 V:**
  - 12 válvulas de diseño en frío (0,28 A; `estudio-salidas.md:97`) = 3,36 A ≤ 3,5 A ✔ (margen del 4 %);
  - las válvulas instaladas (Bermad, 0,18 A) dan 2,2 A a 20 °C.
- **Con la fuente ajustada al alza** (ALI-01 admite hasta 30 V «para cubrir el ajuste de la fuente»), la corriente sube con V/R:

| Tensión | 12 válvulas a 20 °C | 12 válvulas en frío |
|---|---|---|
| 26,4 V | 3,30 A | 3,70 A |
| 28,8 V | **3,60 A** | **4,03 A** |
| 30 V | 3,75 A | 4,20 A |

  Todas están por encima de la cota inferior de la banda (3,5 A): un limitador que cumple ALI-13 puede cortar el riego normal (hallazgo 01).

### 5. SMBJ33A frente a la OVP

- **Datos:** VRWM 33 V, V_BR de 36,7–40,6 V con 1 mA, Vc = 53,3 V con 11,3 A, I_R ≤ 1 µA.
- **OVP máxima de 33,6 V < 36,7 V** ✔, con un margen de 3,1 V (9 %).
- Entre 33 y 33,6 V la fuga supera el dato de I_R, pero sigue muy por debajo de 1 mA. La fuente se apaga al disparar su OVP ✔.
- 30 V (ALI-01) y 31,5 V (§6) quedan por debajo de la VRWM ✔.

## Requisitos nuevos o redefinidos

| Requisito | Evidencia | Resultado |
|---|---|---|
| ALI-04 | SMBJ33A, con V_BR ≥ 36,7 V > OVP de 33,6 V | Cumple |
| ALI-09 | 17 V y 31 V; arranque en frío desde 17 V | Cumple (hallazgo 04) |
| ALI-12 | Fuente LED de 5 A con protección desde 5,25 A; 3,5 A en las salidas; ≤ 0,25 A en la lógica; `Power_In` para 5 A | Parcial (hallazgos 01, 06 y 07) |
| ALI-13 | Banda 3,5–4,9 A; habilitación durante la carga abierta | Parcial (hallazgo 01) |
| REL-03 | Inductancia medida o del fabricante antes de cerrar el esquema | Cumple |
| REL-05 | 1 A como parámetro; pista y borne para 4,9 A con ΔT ≤ 40 °C (≈ 1,2 mm) | Cumple (hallazgos 02 y 03) |
| REL-08 | Sin protección por canal | Cumple (hallazgo 03) |
| REL-10 | Carga abierta con el bus habilitado; aviso por encima de 1 A | Cumple |
| FAB-01 | 2 oz a evaluar según D6 | Cumple |
| FAB-09 | Carga máxima por canal en la serigrafía | Cumple |

## Hallazgos

Severidad: **C** crítico · **A** alto · **M** medio · **B** bajo.

| ID | Sev. | Hallazgo | Evidencia | Requisito | Cambio propuesto |
|---|---|---|---|---|---|
| VAL-0011-01-01 | M | **La ventana del limitador y el total de 3,5 A solo cierran con la fuente a 24 V, y ningún requisito fija su ajuste.** ALI-01 admite 18–30 V «para cubrir el ajuste de la fuente». DEC-0004 atribuye a la fuente un ajuste de 21,6–28,8 V.<br>**(a) Protección de la fuente.** La hoja oficial de la familia LRS da la sobrecarga en % de la **potencia** («110 ~ 140 % / 110 ~ 150 % rated output power»). En corriente, el mínimo supuesto (105 % de 120 W) baja al subir el ajuste: 5,04 A a 25 V, 4,77 A a 26,4 V y 4,38 A a 28,8 V. Ya a 25 V queda por debajo de los 5,15 A del limitador más la lógica. Una sobrecarga del conjunto de 4,6–4,9 A haría actuar la fuente antes que el limitador, y la lógica se reiniciaría (contra REL-08 y la prueba de §6).<br>**(b) Carga instalada.** Las 12 válvulas de diseño consumen 3,60 A a 28,8 V y 20 °C, y 4,03 A en frío (4,20 A a 30 V), por encima de la cota inferior de la banda (3,5 A). Un limitador que cumple ALI-13 puede cortar el riego normal con las 6 salidas activas (REL-05).<br>Con 28,8 V no hay ninguna banda posible: el límite inferior sería 4,03 A y el superior, 4,38 − 0,25 = 4,13 A.<br>**(c) Fuente real.** Las fuentes «para LED» con limitación en corriente constante (HLG-120H-24: 95–108 %) no caben en la banda, y el plan no incluye mirar la etiqueta de la fuente real antes de elegir el limitador.<br>**(d) Errata:** DEC-0004 dice «ajustable ±10 % (21,6–28,8 V)», y ese rango es −10 / +20 %. | `docs/02:69` (ALI-01), `:80` (ALI-12), `:81` (ALI-13), `:182` (§6); `DEC-0004:30–34, 36–41`; LRS-100-24, «OVER LOAD 110 ~ 150% rated output power»; LRS-150 (2025-04-07), «110 ~ 140% rated output power»; `estudio-salidas.md:97` (0,25 A a 20 °C y 0,28 A en frío); `calc.py` | ALI-01, ALI-12, ALI-13, REL-05, REL-08 | Sin componentes nuevos:<br>- **ALI-12** (y una línea en DEC-0004): «la fuente se deja en su ajuste nominal de 24 V (± 2 %); el rango de 18–30 V de ALI-01 es de funcionamiento, no de ajuste. La banda de ALI-13 y el total de 3,5 A valen a 24 V». Indicarlo en la documentación de instalación (FAB-09 si cabe).<br>- **ALI-01:** cambiar «para cubrir el ajuste de la fuente» por «para cubrir la tolerancia de la fuente, la caída en el cable y los transitorios».<br>- **§6:** las dos filas de sobrecarga, «con la fuente LED de 5 A a 24 V».<br>- **docs/03, fase 2:** «comprobar la etiqueta o el modelo de la fuente real (protección de sobrecarga ≥ 5,25 A a 24 V, no de corriente constante) antes de elegir el limitador».<br>- **DEC-0004:** «−10 / +20 %», y la protección expresada en % de la potencia. |
| VAL-0011-01-02 | B | **El retorno GND de las salidas está fijado para 3,5 A, y lo que protege la sobrecarga son 4,9 A.** FAB-03 dimensiona los retornos GND de los bornes de salida «para el total de ALI-12» (3,5 A). Con un canal en sobrecarga, su polo GND y su camino al plano llevan hasta 4,9 A, y el retorno común también, con la banda en su máximo. Un retorno de 3,5 A con ΔT ≤ 10 °C llevaría 4,9 A con ΔT ≈ 22 °C (IPC-2221), así que no se daña. Pero el requisito no lo dice, y la línea de la checklist de esquema v4 omite los «retornos» de la propuesta de VAL-0007-01. | `docs/02:133` (FAB-03), `:103` (REL-05); `esquema.md:53`; `layout.md:26`; `calc.py` | FAB-03, REL-05 | FAB-03: «los retornos GND de cada borne de salida y el común, para la corriente máxima del limitador (4,9 A) con ΔT ≤ 40 °C, como las pistas de REL-05». Añadir «y retornos» en `esquema.md:53` y `layout.md:26`. |
| VAL-0011-01-03 | B | **El *high-side* no «se apaga y rearma» con 4,9 A: se enclava. Ningún requisito dice qué hace el firmware entonces.** Con 4,9 A, el BTT6050 pasa de su I_L(NOM) (4,5 A con T_A = 85 °C en 2s2p). En una placa de 2 capas puede llegar a T_J(SC) y se enclava («Only the IN pin signal toggling can re-activate the power stage»). Las protecciones no están pensadas para un uso «continuous nor repetitive». REL-10 dice «avisa, sin cortar», y REL-08 solo describe el corto. Un firmware que vuelva a conmutar IN tras cada enclavamiento lo hace trabajar en ciclos repetidos. | BTT6050 rev. 1.00: P_5.5.8, P_4.3.2, figura 7, §6 (introducción) y §6.5.2; `DEC-0004:48`; `docs/02:106, 108` | REL-05, REL-08, REL-10 | REL-08: «si el *high-side* se enclava por temperatura (IS en fallo), el firmware lo trata como un corto: lo deja apagado y avisa; no lo rearma solo». DEC-0004: «enclavamiento (*latch*), que se rearma conmutando IN», en vez de «apagado y rearme». Checklist de esquema: cálculo térmico del BTT con 4,9 A y el área de cobre en `docs/diseno/`. |
| VAL-0011-01-04 | B | **El aviso de sobretensión se prueba con un margen del 1,6 %. ALI-09 no fija la precisión de la medida, y ALI-06 no garantiza el arranque en frío desde 17 V que promete ALI-09.**<br>(a) §6 prueba a 31,5 V para un umbral de 31 V (+1,6 %), mientras que a 16,5 V (−2,9 %) y a 30 V (−3,2 %) el margen es mayor. Con un ADC y un divisor de ± 2 %, la prueba de 31,5 V puede fallar con un diseño correcto.<br>(b) ALI-06 solo pide un UVLO de subida «por debajo de 18 V menos la caída… (≈ 15 V)». Un UVLO de 17,2 V lo cumple, y entonces la placa no arranca en frío a 17 V ni funciona a 16,5 V si la prueba empieza en frío. | `docs/02:74` (ALI-06), `:77` (ALI-09), `:176` (§6); `calc.py` | ALI-06, ALI-09 | §6: sobretensión a **32 V** (+3,2 %, todavía por debajo de la VRWM de 33 V) y «a 16,5 V bajando desde 24 V». ALI-09: «precisión de la medida ≤ ± 2 % tras calibrar». ALI-06: «UVLO de subida máximo, con su tolerancia, más la caída de las protecciones ≤ 16,5 V». |
| VAL-0011-01-05 | B | **La prueba de sobrecarga de un canal no comprueba el dimensionamiento para 4,9 A.** Con la pista de ≈ 1,2 mm, 3,4 A dan ΔT ≈ 17 °C (IPC-2221). El criterio «ΔT ≤ 40 °C» se cumple aunque la pista fuera mucho más estrecha que la que pide REL-05: con 0,7 mm, 3,4 A dan ≈ 40 °C, y con esa pista 4,9 A darían ≈ 92 °C. La prueba se hace a 3,4 A con razón (por debajo de la banda), pero el criterio tiene que estar escalado. | `docs/02:183` (§6), `:103` (REL-05); `calc.py` | REL-05 | §6: «ΔT de su pista ≤ 20 °C con 3,4 A (equivale a ≤ 40 °C con 4,9 A según IPC-2221), y el borne sin daños». |
| VAL-0011-01-06 | B | **El límite de la lógica (≤ 0,25 A) es nuevo y no se comprueba, no se reparte ni llega a SPEC-0006.**<br>- ALI-12 lo fija como M, e incluye «el 5 V de la expansión» (DEC-0004). Pero ninguna prueba de §6 lo mide, y el *buck* de ALI-05 da hasta 1,5 A (≈ 0,49 A en la entrada a 18 V).<br>- SPEC-0006 no sabe cuánto 5 V queda para el módulo.<br>- Tampoco sabe que, con 3,36 A instalados de 3,5 A, al bus limitado le quedan ≈ 0,14 A para las salidas del módulo: en la práctica, un módulo con salidas necesita su propia fuente y su propio limitador, porque la fuente de 5 A también está agotada. | `docs/02:73` (ALI-05), `:80` (ALI-12); `DEC-0004:35`; `SPEC-0006:35, 37` | ALI-12, EXP-02, EXP-04 | §6: «consumo de la lógica en la entrada ≤ 0,25 A a 18 V, con Wi-Fi transmitiendo y la carga máxima de la expansión». SPEC-0006: el presupuesto de 5 V del conector (lo que quede de ≈ 4,5 W en la entrada) y la nota de que el bus y la fuente ya están ocupados por las 6 salidas. |
| VAL-0011-01-07 | B | **El fusible y la protección de polaridad se dimensionan «para 5 A», y la entrada puede llevar 5,15 A de forma continua sin que actúe nada.** Con la banda en su máximo, una sobrecarga de 4,9 A en las salidas más 0,25 A de la lógica dan 5,15 A indefinidamente. Un PTC con I_hold de 5 A a 25 °C se queda por debajo a 50 °C (§5) y dispararía antes que el limitador. El orden de las protecciones se invierte y la lógica se reinicia. | `docs/02:80` (ALI-12), `:71` (ALI-03), `:72` (ALI-04); §5 (`:165`) | ALI-03, ALI-04, ALI-12 | ALI-12: «fusible, protección de polaridad y `Power_In` dimensionados para la corriente máxima sin actuación del limitador (4,9 + 0,25 = 5,15 A) a 50 °C, con la reducción por temperatura del fusible o del PTC; el fusible no actúa antes que el limitador». |
| VAL-0011-01-08 | B | **Quedan restos de la v0.3 en docs/02 §2, en el estudio de salidas y en la memoria de ing-esquematicos.**<br>(a) docs/02 §2: «24 V DC de una fuente de hasta 5 A».<br>(b) Estudio de salidas:<br>- §0 N2: «≈ 4 A en total»;<br>- §1.3: «¿Cabe en 4 A?»;<br>- §8: `OUT_n` de **1,0 mm** (REL-05 pide ahora ≈ 1,2 mm), y `+24V_SAL` y `COM` para 4 A.<br>SPEC-0008, la única spec que corrige el estudio, solo remite a DEC-0003.<br>(c) `.claude/agent-memory/ing-esquematicos/project_salidas_d8.md:11`: «≈ 4 A en total», además de lo pendiente de VAL-0007-01-10. | `docs/02:28`; `estudio-salidas.md:16, 124, 744–746`; `SPEC-0008:34–36, 53`; memoria citada | ALI-12, REL-05, FAB-03 | (a) §2: «fuente LED de 24 V DC y 5 A». (b) SPEC-0008: aviso en §0 (N2), §1.3 y §8 que remita a DEC-0004 (3,5 A, `Salidas` ≈ 1,2 mm y retornos). (c) En la próxima orden a ing-esquematicos, que actualice su memoria con DEC-0003 y DEC-0004. |
| VAL-0011-01-09 | B | **Detalles de registro.** (a) «Consecuencias» de DEC-0004 no cita FAB-09 (que sí está en su campo `requisitos` y en §9) y dice «se actualizan §6, §8 y §10». Lo que cambia es §6, §7 (D6), §9 y §10; §8 no cambia. El mensaje de `6f2888e` dice «§6, §7, §8 y §10». (b) «Consecuencias» de DEC-0003 (`:82`) sigue sin citar FAB-06 (resto de VAL-0007-01-09a). (c) DEC-0004 da «105–150 %» como dato de la LRS-120. La LRS real da 110–140 %. Es una envolvente conservadora, y conviene decirlo. | `DEC-0004:64`; `DEC-0003:82`; `git log 6f2888e`; `docs/02:196, 252–257` | FAB-09, FAB-06 | (a) DEC-0004: «… y FAB-09; se actualizan §6, §7, §9 y §10». (b) Añadir FAB-06 a `DEC-0003:82`. (c) DEC-0004: «sobrecarga supuesta desde el 105 % (la LRS-120/150 da 110–140 % de la potencia), por prudencia». |

**Recuento:** C 0 · A 0 · M 1 · B 8.

## Contraste con los logs

He leído los mensajes de commit y el diario del coordinador después de formar los hallazgos. SPEC-0011 no tiene log de autor, porque la ha escrito el coordinador.

- `6f2888e` dice «Resuelve VAL-0007-01-01, 02, 05, 06 y 09». El 02, el 05, el 06 y el 09 están resueltos. El 01 solo lo está a 24 V (hallazgo 01).
- `6f2888e` cita «§6, §7, §8 y §10», pero §8 no cambia y §9 sí (hallazgo 09).
- `81b848f` dice «salidas para la corriente del limitador». La línea de la checklist de esquema solo habla de pistas y bornes, sin retornos (hallazgo 02).
- El diario del 2026-11-05 (punto 34) pedía al usuario «modelo de la fuente… protección de sobrecarga y OVP». El usuario no lo ha dado, y la DEC lo suple con un supuesto, que es lo que pedía la checklist. Pero el plan no incluye mirar la etiqueta antes de elegir el limitador (hallazgo 01c).
- Ningún mensaje afirma algo que los artefactos contradigan, salvo la lista de secciones.

## Propuestas para las checklists

Checklist de requisitos (v4):

- [ ] Las protecciones de los equipos externos expresadas en % de la **potencia** (fuentes conmutadas) se pasan a corriente en **todo** el rango de ajuste o de funcionamiento que admite ALI-01, no solo a la tensión nominal. Si no cierran, se fija el punto de ajuste como requisito de instalación.
- [ ] Los límites de corriente que dependen de la carga (total de las salidas) se calculan con la tensión máxima de funcionamiento y la bobina fría, no a la tensión nominal.
- [ ] Cada límite nuevo de consumo (la lógica, la expansión) tiene un reparto entre los bloques, una prueba en §6 y llega a las specs que lo consumen.
- [ ] Los márgenes de las pruebas de §6 respecto a cada umbral son mayores que la precisión fijada para la medida. Si la precisión no está fijada, se fija.

Checklist de esquema (v5):

- [ ] Cálculo térmico de cada *high-side* con la corriente máxima sin protección (4,9 A): T_J frente a T_J(SC) con el área de cobre real, y comportamiento del firmware ante el enclavamiento (REL-08).
- [ ] Fusible o PTC de entrada que no actúa con la corriente máxima sin actuación del limitador a la temperatura máxima (§5).

## Veredicto

**RECHAZADO.** No hay hallazgos C ni A, pero dos criterios de aceptación se cumplen solo en parte, por el mismo motivo (hallazgo 01, M):

- **Criterio 2** («compatible con la fuente») y **criterio 1** (el hallazgo VAL-0007-01-01 resuelto): la banda de 3,5–4,9 A y el total de 3,5 A son correctos **a 24 V**. Pero ALI-01 y DEC-0004 admiten subir el ajuste de la fuente hasta 28,8 V, y entonces la banda no cierra:
  - la protección de la LRS, en % de la potencia, baja de 5,15 A ya a 25 V;
  - las 12 válvulas de diseño pasan de 3,5 A a 28,8 V.

**Lo mínimo para aprobar** es redacción de docs/02 y de la DEC, sin componentes ni complejidad nueva:

- fijar la fuente en su ajuste nominal de 24 V como requisito de instalación, en ALI-12 y en la DEC;
- quitar «el ajuste de la fuente» de ALI-01;
- hacer las pruebas de sobrecarga a 24 V;
- corregir la errata «±10 %».

Los ocho hallazgos B pueden resolverse ahora o pasar a una spec propuesta.

Lo demás está bien:

- **Fuente LED supuesta:** 5 A, OVP de 28,8–33,6 V y la envolvente del 105 %, coherentes con las hojas LRS.
- **Banda:** alcanzable con piezas comunes: TPS2663 de ± 7 % (3,86–4,54 A) o LM5069 de ± 12 % (3,67–4,74 A).
- **Pista:** 1,16 mm con 1 oz para 4,9 A con ΔT ≤ 40 °C, una cifra correcta.
- **Borne:** WJ500V, de 18 A.
- **TVS:** la SMBJ33A cumple (V_BR ≥ 36,7 V > 33,6 V).
- **Decisiones del usuario:** reflejadas sin añadir protección por canal ni componentes.
- **Trazabilidad:** sin avisos. Los 10 IDs cambiados coinciden con la spec y la DEC.
