JoanSanbartolome/ESP-Riego/gestion/informes/VAL-0011-02.md

---
id: VAL-0011-02
spec: SPEC-0011
fecha: 2026-11-05
commit_revisado: 0d6ab92
checklists: [requisitos v3]
veredicto: APROBADO_CON_OBSERVACIONES
---

# VAL-0011-02 · Requisitos v0.4: ventana del limitador y sobrecarga por canal (segunda validación)

## Alcance de la revisión

- **Commit revisado:** `0d6ab92` («fix(req): requisitos v0.4 corregidos según VAL-0011-01»), punta de `spec/SPEC-0011-requisitos-v04`.
  - Diff: `git diff 4a0b771 0d6ab92`, con 10 archivos: docs/02, docs/03, DEC-0003, DEC-0004, las checklists de requisitos, esquema y layout, SPEC-0006, SPEC-0008 y SPEC-0011.
  - El resto de la v0.4 ya se revisó en VAL-0011-01, sobre `81b848f`.
- **Checklist aplicada:** `gestion/checklists/requisitos.md` v3, en su versión de esta rama, que ya incluye las propuestas de VAL-0011-01.
- **Sin KiCad:** no he usado el MCP ni `kicad-cli`.
- **Fuentes:**
  - las mismas hojas de VAL-0011-01: LRS-100 y LRS-150, BTT6050 rev. 1.00, LM5069 SNVS452G y la página de producto del TPS2663;
  - `docs/diseno/estudio-salidas.md` (§1.2–§1.3), para la corriente de diseño de las válvulas;
  - el consumo del ESP32-S3 al transmitir, de una reproducción de la tabla de Espressif. No es la hoja oficial.
- **Cálculos:** `scratchpad/val1101/calc2.py`. La trazabilidad y la comparación de tablas, con `scratchpad/val1101/traza.py`.

## Comprobaciones automáticas

| Comprobación | Resultado |
|---|---|
| ERC / DRC / paridad | No aplica: la spec no toca archivos de KiCad. |
| `gestion.py trazabilidad` (en memoria) | **0 avisos**, 57 requisitos. El `TRAZABILIDAD.md` versionado difiere en 15 filas, lo que es normal porque lo regenera el merge. |
| Tablas v0.3 (`d4cf007`) → v0.4 (`0d6ab92`) | **Cambiados (13):** ALI-01, ALI-04, ALI-06, ALI-09, ALI-12, ALI-13, FAB-01, FAB-03, FAB-09, REL-03, REL-05, REL-08 y REL-10. Ninguno nuevo, quitado ni con cambio de prioridad. |
| Campo `requisitos` de SPEC-0011 y de DEC-0004 | Los dos coinciden exactamente con los 13: no falta ni sobra ninguno. |
| IDs citados | Ningún ID inexistente en 25 archivos. |
| Términos obsoletos (Grep) | Busco `3,5 A`, `3,5–4,9`, `0,25 A`, `4,2 A`, `± 16`, `5,25 A`, `16,5 V`, `31,5 V`, `3,4 A` y `hasta 5 A` en docs/, las checklists, DEC-0004, las specs abiertas o propuestas, los agentes, las memorias y `CLAUDE.md`.<br>- **Ningún resto vigente.** Lo que queda es historial (§10 v0.2) o el estudio de salidas, que ahora cubre SPEC-0008.<br>- La memoria de ing-esquematicos sigue con «≈ 4 A». Está fuera de la rama y pendiente de la próxima orden a ese agente (VAL-0011-01-08 c). |

## Estado de los hallazgos de VAL-0011-01

| Obs. | Sev. | Estado | Evidencia |
|---|---|---|---|
| 01 · Ventana y total solo a 24 V | M | **Resuelta**, con las observaciones nuevas 01 y 02 | **Ajuste de la fuente:**<br>- ALI-01 (`docs/02:69`): «se deja en su ajuste de fábrica de 24 V (± 2 %)», sin «el ajuste de la fuente»;<br>- ALI-12 (`:80`): protección «en % de la potencia (≥ 5,15 A a 24,5 V)».<br>**Pruebas de §6** (`:184–185`): «a 24 V».<br>**DEC-0004:**<br>- «−10 / +20 %» (`:29–33`);<br>- el ajuste fijado (`:34–37`);<br>- la alternativa de 28,8 V, descartada con cifras (`:66`);<br>- la fuente de corriente constante, descartada (`:67`).<br>**docs/03** (`:33`): comprobar la etiqueta de la fuente real antes de elegir el limitador. |
| 02 · Retorno GND para 3,5 A | B | **Resuelta** | FAB-03 (`:133`): «retornos GND… para la corriente máxima del limitador (4,9 A, ALI-13)». La checklist de esquema (`esquema.md:53`) y la de layout (`layout.md:19`) incluyen ya los retornos. |
| 03 · Enclavamiento del BTT6050 | B | **Resuelta** | REL-08 (`:106`): «queda apagado hasta que su entrada vuelve a conmutar: el firmware lo detecta (IS, DEN), avisa y no lo reintenta en el mismo riego». Con un intento por riego no hay funcionamiento repetitivo en el sentido del BTT6050 §6. DEC-0004 (`:50–51`) dice ahora «se enclava». La checklist de esquema (`:54`) pide el cálculo térmico a 4,9 A. |
| 04 · Margen de las pruebas de ALI-09 y arranque en frío | B | **Resuelta**, con la observación nueva 03 | ALI-09 (`:77`) fija una precisión de ± 3 %. Las pruebas son a 16, 18, 29,5 y 32,5 V (`:176`). Con ± 3 %, las lecturas son 15,52–16,48 (< 17), 17,46–18,54 (> 17), 28,61–30,39 (< 31) y 31,52–33,48 V (> 31) ✔. 32,5 V queda por debajo de la VRWM de 33 V ✔. ALI-06 (`:74`) garantiza el arranque en frío desde 17 V, y §6 (`:177`) lo prueba. Queda sin acotar el umbral de bajada, que la prueba de 16 V necesita (observación 03). |
| 05 · Prueba de un canal no escalada | B | **Resuelta** | §6 (`:185`): 3,8 A durante 1 h con ΔT ≤ 25 °C. Recalculado con IPC-2221: 22,4 °C con 1,16 mm y 21,2 °C con 1,2 mm; el «≈ 23 °C» es correcto. 3,8 A < 3,9 A, por debajo de la banda ✔. El criterio de 25 °C admitiría una pista de 1,09 mm (44,6 °C con 4,9 A), un 7 % más estrecha que la de REL-05. Lo acepto, porque es menos que la incertidumbre de una medida térmica de ± 2–3 °C. |
| 06 · Límite de la lógica sin prueba ni reparto | B | **Resuelta** | ALI-12: «incluido el 5 V de la expansión, ≤ 0,2 A en la entrada a 24 V». §6 (`:178`): prueba de consumo con Wi-Fi transmitiendo y la expansión a su carga máxima. SPEC-0006 (`:37`): el módulo lleva su propio limitador o su propia alimentación, y su 5 V cuenta en los 0,2 A. |
| 07 · Fusible para 5 A frente a 5,15 A | B | **Resuelta** | ALI-12: «dimensionados para la corriente máxima de entrada (5,1 A…), continua y a 50 °C, sin actuar». FAB-03: `Power_In` de 5,1 A. Checklist de esquema (`:30`) y de layout (`:19`). |
| 08 · Restos | B | **Resuelta en la rama.** La memoria de ing-esquematicos sigue pendiente | §2 (`:28`): «fuente LED de 5 A». SPEC-0008 (`:37`) añade VAL-0011-01-08 y remite a DEC-0004. La memoria de ing-esquematicos solo la puede cambiar ese agente. |
| 09 · Registro | B | **Resuelta** | DEC-0004, «Consecuencias»: los 13 IDs y «§2, §6, §7, §9 y §10», que coincide con el diff. `DEC-0003:82` incluye FAB-06. DEC-0004 (`:31`): «del 110 al 150 % según la hoja. Se supone un 105 %, que da margen». |

## Comprobación de los cambios no propuestos en VAL-0011-01

| Cifra | Recálculo | Resultado |
|---|---|---|
| Carga instalada máxima: 12 × 0,28 A × 1,02 × 1,13 ≈ 3,9 A (ALI-12; DEC-0004 `:40`: «0,28 A a 24 V y **20 °C**») | El estudio fija **0,25 A a 20 °C** y **0,28 A en frío** (`estudio-salidas.md:96–97`; §1.3, `:126`: «2 válvulas DC **en frío**: 0,56 A»). REL-05 (`:103`) usa los mismos 0,56 A como máximo de un canal. El factor del frío (1 / (1 − 0,00393 × 30) = 1,134) **se aplica dos veces**. Valor correcto: 12 × 0,25 × 1,021 × 1,134 = **3,47 A**, o bien 12 × 0,28 × 1,021 = 3,43 A | ✗ La cifra es conservadora, pero la base está mal (observación 01) |
| Factor de tensión 1,02 (24,5 / 24) | 1,0208 | ✔ |
| Protección de la fuente: 126 W / 24,5 V = 5,15 A | **5,143 A** | ≈ ✔: es 5,14 A, no 5,15. El margen frente a 5,1 A es de 0,04 A (observación 02) |
| 4,9 + 0,2 = 5,1 A < 5,14 A | ✔ con un margen de 43 mA. Con el 110 % que da la hoja real (5,39 A), el margen es de 0,29 A | ✔ |
| Banda de 3,9–4,9 A ≈ 4,4 A ± 11 % | Centro 4,4 A, ± 11,4 % | ✔ |
| ¿Alcanzable con piezas comunes? | **TPS2663** (± 7 %, más la R_ILIM al 1 %): 4,05–4,75 A ✔. **LM5069** (V_CL 48,5–61,5 mV, más el *shunt* al 1 %): la relación entre máximo y mínimo es 1,294, y la banda solo admite 4,9 / 3,9 = 1,256. **Ya no cabe**, aunque sí cabía en 3,5–4,9 A (1,40) | ✔ con eFuses de ± 7–8 %. Quedan fuera los controladores *hot-swap* de ± 12 % (observación 01) |
| Lógica ≤ 0,2 A en la entrada a 24 V (4,8 W) | ESP32-S3 transmitiendo en 802.11b a 21 dBm: ≈ 340 mA a 3,3 V, de una tabla reproducida, no de la hoja oficial; he calculado con 355 mA. Por el LDO desde 5 V son ≈ 1,8 W. Con sensores, LED y pérdidas (≈ 0,2 W) y el *buck* al 85 %: ≈ 2,3 W, es decir, ≈ 0,1 A a 24 V. Quedan ≈ 0,4 A a 5 V para la expansión. Es realista | ✔. A potencia constante, con 22 V en el borne (caída en el cable) serían 0,218 A (observación 02) |
| Pruebas de §6 fuera de la banda | 3,8 A < 3,9 A y 5,5 A > 4,9 A (`:184`) | ✔ |
| Prueba térmica con 3,9 A (1 + 1 + 0,475 × 4) | Suma 3,9 A | ✔ |
| Complejidad descartada por el usuario | No se añade ningún componente ni protección por canal. El firmware solo detecta el enclavamiento y no reintenta. La banda más estrecha limita la elección a eFuses de ± 7–8 %, que son comunes, pero contradice el motivo original de la DEC («que sirva una pieza normal, sin una tolerancia de corriente ajustada») | ✔ sin complejidad nueva (observación 01) |

## Checklist de requisitos v3

| Punto | Evidencia | Resultado |
|---|---|---|
| Trazabilidad sin avisos; IDs citados; retirados; prioridades | `traza.py` | Cumple |
| Cifras de la DEC = cifras de docs/02 | 3,9 A; 3,9–4,9 A; ≈ 4,4 A ± 11 %; 5,15 A; ≤ 0,2 A; 5,1 A; 4,9 A; ± 3 %; 17 V y 31 V; 16, 18, 29,5 y 32,5 V. Todas coinciden | Cumple. Las dos llevan los mismos errores de base y de redondeo (observaciones 01 y 02) |
| Campo `requisitos` de la spec frente a los cambiados | 13 de 13 | Cumple |
| Decisiones del usuario → requisitos; interpretaciones en la DEC; §7 | DEC-0004, decisiones 1 y 2, e «Interpretación». D6 sin cambios | Cumple |
| Cadena de tensiones | Sin cambios respecto a VAL-0011-01. ALI-06 acota la subida, pero no la bajada (observación 03) | Cumple (observación 03) |
| Presupuesto de la fuente frente a las cargas simultáneas | 3,47 A (o 3,9 A con la cifra de la DEC) + 0,2 A < 5,14 A. Limitador + lógica = 5,1 A < 5,14 A | Cumple (observación 02) |
| Cada criterio de §6 verificable | Las pruebas nuevas (arranque en frío y consumo) se pueden medir | Cumple (observación 03 para 16 V) |
| Cada límite global con mecanismo y prueba | Carga de las salidas: limitador y pruebas a 3,8 y 5,5 A. Lógica: prueba de consumo. Por canal: dimensionamiento y prueba a 3,8 A | Cumple |
| Pruebas dentro de la ventana UVLO–VRWM | Entre 16 V y 32,5 V | Parcial: la de 16 V depende del UVLO de bajada (observación 03) |
| Qué ven los demás canales y la lógica | REL-08 cubre el corto y el enclavamiento | Cumple |
| Umbrales como bandas, con pruebas fuera | ALI-13 y ALI-09 (con ± 3 %) | Cumple |
| Protecciones escalonadas | Pista, borne y retorno para 4,9 A. BTT con enclavamiento. Fusible y `Power_In` para 5,1 A a 50 °C | Cumple |
| Parámetros de equipos externos | DEC-0004 supone la fuente. ALI-01 fija el ajuste. docs/03 obliga a comprobar la etiqueta | Cumple |
| Protecciones en % de potencia en todo el rango permitido | La fuente queda en 24 V ± 2 %, con el cálculo a 24,5 V | Cumple (redondeo: observación 02) |
| Carga a la tensión máxima permitida y en frío | Calculada a 24,5 V y −10 °C, pero aplicando el frío dos veces | Parcial (observación 01) |
| Límites de consumo con reparto, prueba y llegada a las specs | Lógica ≤ 0,2 A: §6 y SPEC-0006 | Cumple |
| Margen de las pruebas frente a la precisión | ± 3 %: todas fuera | Cumple |
| Términos obsoletos (incluidas las memorias y los estudios) | Fila «Términos obsoletos». El estudio queda cubierto por SPEC-0008, pero heredaría los 3,9 A (observación 01) | Cumple |
| Aclaraciones del usuario en las specs abiertas | SPEC-0006 y SPEC-0008 actualizadas | Cumple |

## Criterios de aceptación de la spec

| Criterio | Evidencia | Resultado |
|---|---|---|
| Cada hallazgo del alcance está resuelto o justificado uno a uno | VAL-0007-01-01, 02, 05, 06 y 09 (en VAL-0011-01) y los 9 de VAL-0011-01 (tabla anterior) | Cumple |
| El umbral del limitador es una banda con tolerancia, compatible con la fuente, y la prueba de §6 queda fuera de ella | Banda de 3,9–4,9 A con la fuente fijada a 24 V ± 2 %: 4,9 + 0,2 = 5,1 < 5,14 A. Carga instalada real ≤ 3,47 A < 3,9 A. Pruebas a 3,8 A y 5,5 A. Alcanzable con el TPS2663. La fuente de corriente constante queda excluida con comprobación en la fase 2 | Cumple |
| Ninguna corriente entre la nominal de un canal y el umbral del limitador queda sin mecanismo ni prueba | Pista, borne y retorno para 4,9 A; enclavamiento del BTT con comportamiento del firmware; aviso por IS; prueba a 3,8 A | Cumple |
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
