JoanSanbartolome/ESP-Riego/gestion/informes/VAL-0010-01.md

---
id: VAL-0010-01
spec: SPEC-0010
fecha: 2026-11-05
commit_revisado: 76f02f8
checklists: [librerias v1 (fidelidad al origen)]
veredicto: APROBADO_CON_OBSERVACIONES
---

# VAL-0010-01 · Correcciones de la importación de la v1

## Alcance de la revisión

Revisión de la rama `spec/SPEC-0010-correcciones-importacion-v1` en `76f02f8`. Cubre dos commits: `acf0b4a` (`docs/01` §1, del coordinador) y `76f02f8` (de `jr-conformidad`). Entregables revisados:

- `hardware/libraries/Wemos s2 mini.kicad_sym` y `Wemos s2 mini.pretty/WEMOS-S2-MINI.kicad_mod`.
- `hardware/libraries/DC-Jack.pretty/DC-IN-TH_XDJK-0051-025.kicad_mod`. Se ha borrado el `.gitkeep`.
- `hardware/v1-tfg/README.md`.
- La sección «Corrección (SPEC-0010)» de `gestion/logs/SPEC-0009/01-jr-conformidad.md`.
- `docs/01-analisis-v1.md` §1.

Checklist: `librerias.md` v1, solo en lo que toca a la fidelidad al origen. Son piezas de la v1 que se conservan tal cual, así que no hay rediseño contra el datasheet.

**Método.** Todas las comprobaciones las repetí yo sobre copias en `…\scratchpad\val10\`:
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
