JoanSanbartolome/ESP-Riego/hardware/componentes/KT-0603R.md

---
mpn: KT-0603R
fabricante: Hubei KENTO Elec
funcion: LED 0603 rojo (615–630 nm); alimentación (D4), estado (D5) y canal (D6–D11)
lcsc: C2286
tipo_jlcpcb: basic
stock_consultado: 2026-11-10
datasheet: https://www.lcsc.com/datasheet/lcsc_datasheet_1810231112_Hubei-KENTO-Elec-KT-0603R_C2286.pdf (dataManualUrl de la API de JLCPCB, 2026-11-07; PDF del fabricante, 11 págs.)
datasheet_local: datasheets/KT-0603R.pdf
simbolo: Device:LED
huella: LED_SMD:LED_0603_1608Metric
modelo_3d: ${KICAD10_3DMODEL_DIR}/LED_SMD.3dshapes/LED_0603_1608Metric.step (existe en 10.0.6)
origen_assets: kicad-oficial
verificado_por:
---

# KT-0603R · LED rojo 0603

## Datos clave

Las páginas son las del PDF local (p. 1 = portada).

| Parámetro | Valor | Fuente (página) |
|---|---|---|
| Encapsulado | 1,6 × 0,8 × 0,6 mm | p. 2 |
| I_F máx. / I_FP | 25 mA / 60 mA (pulso ≤ 0,1 ms, 1/10) | p. 3 |
| P_d | 40 mW | p. 3 |
| V_R | 5 V | p. 3 |
| V_F (I_F = 20 mA) | 1,8–2,4 V (bins VE–VJ, ±0,05 V) | pp. 3-4 |
| I_V (20 mA) | 145–300 mcd (bins P22–P24, ±10 %) | pp. 3-4 |
| Longitud de onda dominante | 615–630 nm (bins R1–R5, ±1 nm) | pp. 3-4 |
| Temperatura | −40…+85 °C | p. 3 |
| Soldadura | *reflow* 260 °C, 10 s; a mano 300 °C, 3 s | p. 3 |
| Pads recomendados | 2 × 0,7 × 0,7 mm, separación 0,7 mm (centros a 1,4) | p. 2 |

## Pinout y polaridad

| Pin KiCad | Nombre | Número del datasheet (p. 2) | Función |
|---|---|---|---|
| 1 | K | **②** («−») | Cátodo |
| 2 | A | **①** («+») | Ánodo |

- **La numeración del datasheet es la inversa de la de KiCad**: ② (cátodo) = pad 1 (K) de `LED_0603_1608Metric`; ① (ánodo) = pad 2 (A).
- **Marca del encapsulado** (p. 2): vista superior con una marca verde en el borde del lado ②, el del cátodo. En la vista inferior, el triángulo verde tiene la base ancha en ① (ánodo) y el vértice estrecho hacia ② (cátodo); el símbolo del diodo dibujado al lado confirma ① «+», ② «−».
- **Difiere de la marca del KT-0603YG.** Aquel se interpreta por la barra ancha de la «T» (= cátodo). Aquí la parte ancha del triángulo es el **ánodo**: aplicar la regla del YG da la polaridad al revés. Regla del KT-0603R: marca verde en el borde superior = cátodo; el vértice del triángulo inferior apunta al cátodo.
- En la huella oficial el pad 1 (K) es el de la izquierda con la pieza sin girar. Hay que comprobar el giro del CPL en JLCPCB antes de fabricar.

## Recomendaciones de layout del fabricante

- Pads de 0,7 × 0,7 con 0,7 de separación (p. 2); la huella oficial IPC (0,8 × 0,95 a ±0,7875) es algo mayor y compatible.

## Alternativas

| MPN | LCSC | Diferencias |
|---|---|---|
| KT-0603YG | C2289 | Verde-amarillo (567–573 nm); Extended; V_F 2,0–2,2 V; marca de polaridad distinta (ver su ficha) |
| XL-1608SURC-06 | C965799 | XINGLIGHT, rojo; alternativa de `alimentacion.md` (sin ficha) |

## Aprovisionamiento (JLCPCB/LCSC, consulta 2026-11-10)

| Código | Tipo | Stock | Precio unitario por tramo (USD) |
|---|---|---|---|
| C2286 | Basic | 6 273 838 (6 618 030 el 2026-11-07) | 1–999: 0,0077 · 1000–3999: 0,0059 · 4000–7999: 0,0046 · 8000–47999: 0,0040 |

## Uso en el proyecto

| Ref. | Función | Resistencia | Corriente |
|---|---|---|---|
| D4 | Alimentación (+3V3) | R13 = 1 kΩ | ≈ 1,4 mA (`alimentacion.md` §3.11) |
| D5 | Estado, GPIO40 (MCU-07) | R23 = 1 kΩ | ≈ 1,4 mA típ.; ≤ 1,79 mA (`mcu.md` §7; VAL-0022-01) |
| D6–D11 | LED de canal, desde el GPIO IN_n (REL-07) | 1 kΩ | ≈ 1,5 mA (`salidas.md` §7) |

Con V_F ≈ 1,85 V a 1 mA (curva de la p. 5, según VAL-0022-01) y 1,5 mA el brillo es bajo pero visible.
