JoanSanbartolome/ESP-Riego/hardware/componentes/M7.md

---
mpn: M7
fabricante: MDD (Microdiode Semiconductor)
funcion: diodo rectificador de 1 kV y 1 A, SMA (DO-214AC); rueda libre de las salidas D12–D17, **DNP** (DEC-0008)
lcsc: C95872
tipo_jlcpcb: basic
stock_consultado: 2026-11-10
datasheet: PDF de MDD «M1 THRU M7», Rev. 2025A5, 3 págs. (copia en LCSC: https://www.lcsc.com/datasheet/lcsc_datasheet_2407101107_MDD-Microdiode-Semiconductor-M7_C95872.pdf, dataManualUrl de la API de JLCPCB, 2026-11-10). No se ha localizado URL estable del PDF en microdiode.com
datasheet_local: datasheets/M7.pdf
simbolo: Device:D
huella: Diode_SMD:D_SMA
modelo_3d: ${KICAD10_3DMODEL_DIR}/Diode_SMD.3dshapes/D_SMA.step (existe en 10.0.6)
origen_assets: kicad-oficial
verificado_por: VAL-0024-01
---

# M7 · rectificador 1 kV / 1 A (SMA)

## Datos clave

Las páginas son las del PDF local (p. 1 = portada). Valores de la columna M7 de la tabla de la p. 1.

| Parámetro | Valor | Fuente (página) |
|---|---|---|
| V_RRM (tensión inversa repetitiva) | 1000 V | p. 1 |
| V_RMS / V_DC | 700 V / 1000 V | p. 1 |
| I_F(AV) | 1 A | p. 1 |
| I_FSM (8,3 ms, semionda) | 30 A | p. 1 |
| V_F (I_F = 1,0 A) | 1,1 V máx. | p. 1 |
| I_R (V_R = 1000 V) | 5 µA (T_A = 25 °C) · 50 µA (125 °C) | p. 1 |
| C_J (1 MHz, 4 V) | 15 pF | p. 1 |
| R_θJA | 75 °C/W (cobre de 2,54 × 2,54 cm) | p. 1 |
| T_J, T_STG | −55…+150 °C | p. 1 |
| Polaridad | «símbolo de polaridad en el cuerpo»; en el dibujo, banda en un extremo del cuerpo = cátodo (símbolo del diodo con el triángulo hacia la banda) | p. 1 |

En `salidas.md` (§5) la rueda libre ve V_R ≤ 30 V en régimen (36,7 V con JP1 cerrado) y I ≤ 1 A, y en la desmagnetización conduce en directo (OUT ≈ −V_F en lugar de −57 V): V_RRM, I_F, V_F e I_R sobran con holgura. Es DNP: ver «Uso».

## Pinout y polaridad

| Pin KiCad (`Device:D`) | Nombre | Pad de `D_SMA` | Función |
|---|---|---|---|
| 1 | K | 1 (izquierda, x = −2,0) | Cátodo (banda) |
| 2 | A | 2 (derecha, x = +2,0) | Ánodo |

- **Cátodo (banda) = pad 1.** En la huella oficial el símbolo del diodo de la capa Fab tiene la barra a la izquierda (x = −0,65) y el 3D oficial lleva la banda clara en ese lado (render `hardware/libraries/3d/fuentes-solidcraft/render_SPEC-0024_led_m7.png`).
- Conexión en salidas: K a OUT_n, A a GND (rueda libre sobre la carga; el cátodo va al lado positivo).
- Antes de fabricar, comprobar el giro del CPL de JLCPCB (solo si algún día se monta).

## Cotas del SMA frente a `Diode_SMD:D_SMA`

| Cota | Datasheet | Página | `D_SMA` (oficial) | Veredicto |
|---|---|---|---|---|
| Longitud del cuerpo | 3,80–4,50 mm | p. 1 | Fab 4,6 | Fab es el contorno del cuerpo; vale |
| Ancho del cuerpo | 2,30–2,80 mm | p. 1 | Fab 3,0 | Vale (margen) |
| Longitud total sobre terminales | 4,70–5,30 mm | p. 1 | pads con exterior a 6,5 | Los pads salen con talón y punta (IPC) |
| Ancho del terminal | 1,30–1,70 mm | p. 1 | pad 1,8 | Vale |
| Largo del terminal | 0,75–1,55 mm | p. 1 | — | — |
| Altura | 1,85–2,45 mm | p. 1 | modelo 3D oficial | — |
| Pad: alto A | 1,68 mm | p. 3 («Suggested Pad Layout») | 1,8 | Algo mayor (+0,12), compatible |
| Pad: largo B | 1,52 mm | p. 3 | 2,5 | Mayor (IPC, nivel nominal) |
| Distancia entre centros C | 3,93 mm | p. 3 | 4,0 | +0,07 |
| Hueco entre pads D | 2,41 mm | p. 3 | 1,5 | **0,91 mm menor**: con 1 kV es lo único relevante; aquí el diodo solo ve ≤ 36,7 V inversos, y la separación entre pads es la de todos los SMA oficiales |
| Exterior E | 5,45 mm | p. 3 | 6,5 | Mayor |

La huella oficial es más generosa que el patrón del fabricante; ambas son soldables. No se modifica.

## Recomendaciones de layout del fabricante

- Solo el patrón de pads de la p. 3. Sin pasta ni vías especiales.
- Con DNP, la huella queda en la placa sin pieza: pads y courtyard como los de cualquier SMA (`salidas.md` §11, nota 1: el hueco de 1 mm entre OUT_n y otras redes ya cuenta con ellos).

## Alternativas

| MPN | LCSC | Diferencias |
|---|---|---|
| (ninguna) | | `salidas.md` §9 no fija alternativa; M7 es Basic con 5,4 M de existencias |

## Aprovisionamiento (JLCPCB/LCSC, consulta 2026-11-10)

| Código | Tipo | Stock | Precio unitario por tramo (USD) |
|---|---|---|---|
| C95872 | Basic | 5 407 651 | 1–999: 0,0103 · 1000–4999: 0,0085 |

## Uso en el proyecto

D12–D17 (`salidas.md` §5 y §9), uno por canal en paralelo con la carga (K = OUT_n, A = GND). **DNP por DEC-0008**: huella en la placa, pieza fuera del BOM y del CPL hasta que la medición de la inductancia de la válvula (`salidas.md` §13.1) pida montarlas (requiere una DEC).

Atributos para dejarlos fuera de BOM y CPL con la huella en la placa (KiCad 10): en el símbolo, «Do not populate» (`dnp yes`) y «Exclude from bill of materials» (`in_bom no`), con «Add to board» activo (`on_board yes`); en la huella, los mismos atributos (`dnp`, `exclude_from_bom`) más «Exclude from position files» (`exclude_from_pos_files`). Al exportar: `kicad-cli sch export bom --exclude-dnp` y `kicad-cli pcb export pos --exclude-dnp`.
