JoanSanbartolome/ESP-Riego/hardware/componentes/WJ500V-5.08-2P.md

---
mpn: WJ500V-5.08-2P
fabricante: Ningbo Kangnex Elec
funcion: borne atornillado de 2 polos, paso 5,08 mm, para la entrada de 24 V (J1) y las seis salidas (J4–J9) (FAB-07, ALI-02, REL-06)
lcsc: C8465
tipo_jlcpcb: extended
stock_consultado: 2026-11-10
datasheet: https://www.lcsc.com/datasheet/lcsc_datasheet_1912251636_Ningbo-Kangnex-Elec-WJ500V-5-08-2P_C8465.pdf
datasheet_local: datasheets/WJ500V-5.08-2P.pdf (1 hoja, 1,2 MB, copia de LCSC). Sin PDF propio localizado: Kangnex solo es accesible a través de LCSC (kangnex.com no responde desde este equipo, 2026-11-05)
simbolo: Connector:Screw_Terminal_01x02
huella: esp-riego:TerminalBlock_Kangnex_WJ500V-5.08-2P_1x02_P5.08mm_Horizontal
modelo_3d: ${KIPRJMOD}/../libraries/3d/TerminalBlock_Kangnex_WJ500V-5.08-2P.step
origen_assets: símbolo kicad-oficial; huella y 3D creados
verificado_por: pendiente (ing-validacion; 3D y huella sin cambios en SPEC-0024, render de comprobación)
---

# WJ500V-5.08-2P · borne de 2 polos

## Datos clave

| Parámetro | Valor | Fuente (página) |
|---|---|---|
| Paso | 5,08 mm (± 0,10 mm entre contactos) | Dibujo, layout recomendado (hoja única) |
| Tensión / corriente (UL) | 300 V / 15 A | Dibujo, características eléctricas |
| Tensión / corriente (IEC) | 250 V / 18 A | Dibujo |
| Cable | AWG 30-14 (hasta 2,5 mm²), longitud de pelado 6-7 mm | Dibujo |
| Par de apriete | 4,08 kgf·cm / 0,4 N·m | Dibujo |
| Resistencia de contacto | ≤ 20 mΩ | Dibujo |
| Temperatura | −40…+105 °C; 250 °C durante 5 s | Dibujo |
| Dimensiones (2 polos) | 10,16 × 10,0 mm, 14,0 mm de alto | Dibujo |
| Taladro recomendado por el fabricante | Ø 1,20 ± 0,05 mm (la huella usa 1,3 mm acabado; ver «Recomendaciones») | Dibujo, *layout* recomendado |
| Pines | 0,90 × 0,80 mm, 4,5 ± 0,2 mm bajo el cuerpo; la patilla está a 4,50 mm de la cara trasera y a 5,50 mm de la cara de entrada del cable | Dibujo, vista frontal y sección A-A |

## Pinout

| Pin | Nombre | Función |
|---|---|---|
| 1 | 1 | Polo 1 (pad cuadrado) |
| 2 | 2 | Polo 2 |

Símbolo `Connector:Screw_Terminal_01x02` (pines `Pin_1` y `Pin_2`, pasivos) ↔ pads 1 y 2 de la huella, comprobado el 2026-11-10. **Uso:** en J1 (entrada, `alimentacion.kicad_sch`), polo 1 = +24 V y polo 2 = GND; en J4–J9 (salidas, `salidas.kicad_sch`), **pin 1 = OUT_n y pin 2 = GND** (REL-06). Con la entrada del cable hacia fuera de la placa, el pin 1 queda en el mismo lado visto desde la entrada en los seis (`salidas.md` §8).

## Recomendaciones de layout del fabricante

- *Layout* recomendado: dos taladros Ø 1,20 mm a 5,08 mm (tolerancia de PCB ± 0,05 mm).
- Con 24 V, las pistas desde el borne dimensionadas para la corriente de la carga (FAB-07).
- Posición en la huella (sección A-A): el cuerpo va de y = −5,5 (cara de entrada del cable, hacia −Y, «arriba» en el editor de placa) a y = +4,5 (cara trasera), con la patilla en y = 0. La entrada del cable está marcada en Fab.
- Taladro: el dibujo da Ø 1,20 ± 0,05, pero la patilla mide 0,90 × 0,80 (diagonal 1,20 nominal, 1,27 en el máximo) y el taladro acabado de JLCPCB tiene ± 0,08. La huella usa taladro acabado de 1,3 mm con pad de 2,6 mm, como las huellas oficiales de bornes de 5,08 mm (p. ej. Phoenix MKDS-1,5-2-5.08).

## Alternativas

| MPN | LCSC | Diferencias |
|---|---|---|
| (ninguna elegida) | | El estudio de salidas fija este borne como único |

## Aprovisionamiento (JLCPCB/LCSC, consulta 2026-11-05)

| Código | Tipo | Stock | Precio unitario por tramo (USD) |
|---|---|---|---|
| C8465 | Extended (THT) | 312 788 (consulta 2026-11-10; 284 732 el 2026-11-05) | 1–49: 0,1345 · 50–149: 0,1084 · 150–499: 0,095 · 500–2 499: 0,0827 |

7 bornes por placa (J1 de entrada de 24 V y J4–J9 de las 6 salidas, REL-06): confirmado por el usuario (2026-11-05); los bornes de otras entradas los fija su bloque. Stock de 70 uds. para 10 placas: 0,02 % de 312 788.

| Placas | Unidades | Tramo | Coste de bornes | Por placa |
|---|---|---|---|---|
| 5 | 35 | 1–49: 0,1345 $ | 4,71 $ | 0,94 $ |
| 10 | 70 | 50–149: 0,1084 $ | 7,59 $ | 0,76 $ |

Con 8 bornes por placa: 5,38 $ (5 placas) y 8,66 $ (10 placas).

## Notas de los assets

El símbolo es oficial. La huella y el modelo 3D se han creado desde el dibujo del fabricante (no hay versión oficial ni en PartReel ni importable): ver el log de SPEC-0015. 

**Modelo 3D** (`TerminalBlock_Kangnex_WJ500V-5.08-2P.step`): creado con SolidCraft (fuentes en `hardware/libraries/3d/fuentes-solidcraft/`). Origen = origen de la huella (pin 1), offset 0, rotación 0, escala 1; cuerpo de y = −5,5 (entrada del cable) a +4,5 en coordenadas de la huella, x de −2,54 a 7,62, alto 14,0. Cotas del dibujo (hoja única, que es de 3 polos; se modelaron 2): altura 14,00 ± 0,2, fondo 10,00 ± 0,2 y patilla a 4,50 ± 0,2 de la cara trasera (corte A-A), largo N × 5,08, patillas rectangulares de 0,9 × 0,8 y 4,5 bajo la placa. Supuestos: perfil lateral tomado a escala del corte A-A (± 0,2); ventana del cable de 2,6 × 3,1 con profundidad de 6,0; aberturas de tornillo de Ø 3,9 a 4,9 de la cara frontal; color verde; marca del pin 1 como rebaje de 0,4 × 0,4 en la arista del lado del pin 1; sin elementos internos. Comprobado con `kicad-cli pcb render`: el cuerpo coincide con el contorno Fab y la entrada del cable queda hacia −Y, donde está la marca «ENTRADA CABLE».

## Uso en el proyecto

J1 (entrada de 24 V, `alimentacion.kicad_sch`; ALI-02) y J4–J9 (salidas 1–6, `salidas.kicad_sch`; REL-06, REL-09, FAB-07): 7 por placa. No se usa en `conectores.kicad_sch`.
