JoanSanbartolome/ESP-Riego/hardware/componentes/B-2100S04P-A110.md

---
mpn: B-2100S04P-A110
fabricante: Ckmtw (Shenzhen Cankemeng)
funcion: tira de pines macho 1 × 4 a 2,54 mm, recta THT (UART de programación, MCU-06)
lcsc: C124378
tipo_jlcpcb: extended
stock_consultado: 2026-11-06
datasheet: https://www.lcsc.com/datasheet/lcsc_datasheet_2304140030_Ckmtw-Shenzhen-Cankemeng-B-2100S04P-A110_C124378.pdf (espejo de LCSC, dataManualUrl de la API, 2026-11-07; sin PDF propio del fabricante localizado). Dibujo de LCSC/JLCPCB (hoja única, 2010-08-12), espejo local datasheets/B-2100S04P-A110.pdf
datasheet_local: datasheets/B-2100S04P-A110.pdf
simbolo: Connector_Generic:Conn_01x04
huella: Connector_PinHeader_2.54mm:PinHeader_1x04_P2.54mm_Vertical
modelo_3d: ${KICAD10_3DMODEL_DIR}/Connector_PinHeader_2.54mm.3dshapes/PinHeader_1x04_P2.54mm_Vertical.step (existe en 10.0.6)
origen_assets: kicad-oficial
verificado_por:
---

# B-2100S04P-A110 · tira de pines 1 × 4

## Datos clave

| Parámetro | Valor | Fuente (página) |
|---|---|---|
| Paso | 2,54 mm | Hoja única, vista superior |
| Posiciones | 2…40 (modelo 2100S-1*XP); esta: 4 | «Poles» |
| Pin | cuadrado 0,64 ± 0,02 mm | Vista superior |
| Longitud total / lado de acoplamiento / lado de PCB | (11,6) / 6,0 / 3,0 mm | Vista lateral |
| Eléctrico | 3 A; resistencia de contacto ≤ 20 mΩ; aislamiento ≥ 1000 MΩ; 500 V CA | «Specification» |
| Temperatura | −40…+105 °C | ídem |
| Contacto | latón, oro 0,8 µ" sobre níquel 50 µ" | ídem |

## Pinout

| Pin | Nombre | Función en J3 |
|---|---|---|
| 1 | Pin_1 | 3V3 |
| 2 | Pin_2 | TXD0 (a través de R22) |
| 3 | Pin_3 | RXD0 |
| 4 | Pin_4 | GND |

(Orden fijado por `mcu.md` §6.) Pad 1 cuadrado en la huella.

## Recomendaciones de layout del fabricante

- La hoja no da dibujo de *layout*. Taladro de la huella oficial: 1,0 mm, pad 1,7 mm. Diagonal del pin 0,64 ± 0,02: 0,93 mm → holgura 0,07 mm, menor que el +0,1 mm de la checklist. **Excepción justificada (VAL-0021-01-05):** el taladro de 1,0 mm es el estándar de las tiras de 2,54 mm con pin cuadrado de 0,64 mm y es el de la huella oficial; se acepta. Opcional si el fabricante da problemas de inserción: copia con taladro de 1,05 mm (anillo 0,325).
- La tira se puede cortar de una de 40 (alternativa C2337).

## Alternativas

| MPN | LCSC | Diferencias |
|---|---|---|
| 2.54-1*40P Straight pin (BOOMELE) | C2337 | Extended; 1 × 40 para cortar; stock 55 818; 0,1593 $ |
| PZ254V-11-04P (XFCN) | C492403 | 1 × 4, 6,1 mm; Extended; stock 66 689; 0,0282 $ |

## Aprovisionamiento (JLCPCB/LCSC, consulta 2026-11-06)

| Código | Tipo | Stock | Precio unitario por tramo (USD) |
|---|---|---|---|
| C124378 | Extended | 105 049 | 1–99: 0,0524 · 100–299: 0,0424 · 300–2999: 0,0372 |

## Uso en el proyecto

J3 (UART de programación) de `mcu.kicad_sch`. MCU-06.
