JoanSanbartolome/ESP-Riego/hardware/componentes/KT-0603YG.md

---
mpn: KT-0603YG
fabricante: Hubei KENTO Elec
funcion: LED 0603 verde-amarillo (567–573 nm) de estado (MCU-07)
lcsc: C2289
tipo_jlcpcb: extended
stock_consultado: 2026-11-06
datasheet: https://www.lcsc.com/datasheet/lcsc_datasheet_1806151835_Hubei-KENTO-Elec-KT-0603YG_C2289.pdf (espejo de LCSC, dataManualUrl de la API, 2026-11-07; sin PDF propio del fabricante localizado). El PDF de LCSC/JLCPCB, espejo local datasheets/KT-0603YG.pdf (8 págs.), está rotulado «XL-0603QYGC» (otro fabricante, mismo encapsulado y mismos rangos eléctricos): usar solo como referencia
datasheet_local: datasheets/KT-0603YG.pdf
simbolo: Device:LED
huella: LED_SMD:LED_0603_1608Metric
modelo_3d: ${KICAD10_3DMODEL_DIR}/LED_SMD.3dshapes/LED_0603_1608Metric.step (existe en 10.0.6)
origen_assets: kicad-oficial
verificado_por:
---

# KT-0603YG · LED verde-amarillo 0603

## Datos clave

| Parámetro | Valor | Fuente (página) |
|---|---|---|
| Encapsulado | 1,6 × 0,8 × 0,6 mm | PDF XL-0603QYGC, p. 2 |
| I_F máx. / I_FP | 20 mA / 100 mA (pulso ≤ 0,1 ms, 1/10) | p. 3 |
| V_R | 5 V | p. 3 |
| V_F (I_F = 20 mA) | 2,0–2,2 V | p. 3 |
| I_V | 30–42 mcd (20 mA) | p. 3 |
| Longitud de onda dominante | 567–573 nm | p. 3 |
| Temperatura | −40…+85 °C | p. 3 |
| Soldadura | *reflow* 250 °C, 8 s | p. 3 |
| Pads recomendados | 2 × 0,7 × 0,7 mm, separación 0,7 mm (centros a 1,4) | p. 2 |

## Pinout

| Pin | Nombre | Función |
|---|---|---|
| 1 | K | Cátodo |
| 2 | A | Ánodo |

Polaridad según el PDF (p. 2, vista inferior y símbolo del diodo dibujado al lado): el **cátodo** está en el lado de la barra ancha de la «T» (abajo en la vista inferior de la p. 2); el trazo estrecho de la «T» apunta al ánodo. Corresponde al pad 1 (K) de `LED_0603_1608Metric`. En la huella oficial el pad 1 (K) es el de la izquierda con la pieza sin girar. Hay que comprobar el giro del CPL en JLCPCB antes de fabricar.

## Recomendaciones de layout del fabricante

- Pads de 0,7 × 0,7 con 0,7 de separación (p. 2); la huella oficial IPC (0,8 × 0,95 a ±0,7875) es algo mayor y compatible.

## Alternativas

| MPN | LCSC | Diferencias |
|---|---|---|
| KT-0603Y | C2287 | Amarillo (≈ 590 nm); Extended; stock 92 914 (2026-11-06) |
| KT-0603R | C2286 | Rojo; **Basic**; stock 6,66 M; V_F 1,8–2,4 V (otro color: lo decide el coordinador) |

## Aprovisionamiento (JLCPCB/LCSC, consulta 2026-11-06)

| Código | Tipo | Stock | Precio unitario por tramo (USD) |
|---|---|---|---|
| C2289 | Extended | 39 870 | 1–499: 0,0106 · 500–1499: 0,0083 · 1500–3999: 0,0070 |

## Uso en el proyecto

D5 (LED de estado, GPIO40 con R23 de 1 kΩ) en `mcu.kicad_sch`. MCU-07: con V_F = 2,2 V, I = (3,3 − 2,2)/1 kΩ ≈ 1,1 mA.
