JoanSanbartolome/ESP-Riego/hardware/componentes/TPS2663.md

---
mpn: TPS2663x (TPS26630 / 26631 / 26632 / 26633 / 26635 / 26636 / 26637)
fabricante: Texas Instruments
funcion: eFuse de 60 V y 6 A con limitación de potencia; candidato al limitador común de entrada (ALI-13, DEC-0004)
lcsc: C1850278 (TPS26632RGER, variante con más stock)
tipo_jlcpcb: extended
stock_consultado: 2026-11-05
datasheet: https://www.ti.com/lit/ds/symlink/tps2663.pdf
datasheet_local: no se copia (5,7 MB > 5 MB); SLVSE94G, junio de 2024
simbolo: Power_Management:TPS26632RGE (también TPS26630RGE, 26631RGE, 26633RGE, 26635RGE y 26631/26633/26636PWP)
huella: Package_DFN_QFN:Texas_RGE0024H_VQFN-24-1EP_4x4mm_P0.5mm_EP2.7x2.7mm  # sin vías; las vías 0,3/0,6 al EP las pone el layout (SLVSE94G p. 39). La variante _ThermalVias usa 0,2/0,5 y no cumple FAB-02
modelo_3d: ${KICAD10_3DMODEL_DIR}/Package_DFN_QFN.3dshapes/Texas_RGE0024H_VQFN-24-1EP_4x4mm_P0.5mm_EP2.7x2.7mm.step
origen_assets: kicad-oficial
verificado_por:
---

# TPS2663x · eFuse 60 V / 6 A

## Datos clave

| Parámetro | Valor | Fuente (página) |
|---|---|---|
| Tensión de funcionamiento | 4,5…60 V (máximo absoluto 67 V; IN y OUT hasta 75 V en 10 ms) | p. 1, §6.1 (p. 5) |
| FET integrado | 60 V, R_ON 31 mΩ | p. 1 |
| Límite de corriente | 0,6…6 A ajustable (± 7 %), por R_ILIM | p. 1 |
| Limitación de potencia (PLIM) | variantes 26632, 26633, 26635, 26636, 26637 (± 6 %) | p. 1 y tabla de comparación, p. 2 |
| Protección de sobretensión | 26630 y 26631: corte ajustable (pin OVP); 26632 y 26633: *clamp* fijo de 35 V máx.; 26635 y 26636: *clamp* fijo de 39 V máx. | Tabla de comparación, p. 2 |
| Respuesta a sobrecarga | auto-retry o *latch-off* por el pin MODE; variantes de 1× o 2× con soporte de pulso | p. 1-2 |
| Salidas | FLT, PGOOD, IMON (monitor de corriente ± 6 %) | p. 1 |
| Rechazo de polaridad inversa | con un NFET externo (B_GATE / DRV) | p. 1 |
| Encapsulados | RGE (VQFN-24, 4 × 4 mm) y PWP (HTSSOP-20) | p. 1 |

**Aviso para el bloque de entrada.** La variante con *clamp* fijo de 35 V recorta la entrada por encima de 35 V, y la entrada puede llegar a 30 V en funcionamiento (ALI-09: avisos a 17 V y 31 V). El margen entre 30 V y 35 V y la variante exacta (26630 con OVP ajustable frente a 26632) las decide el bloque ALI con sus cálculos.

## Pinout (RGE, VQFN-24; nombres y números del símbolo oficial, Tabla 5-1, pp. 3-4)

| Pin | Nombre | Función |
|---|---|---|
| 1, 2 | IN | Entrada de potencia (drenador del FET interno) |
| 3 | B_GATE | Puerta del NFET de bloqueo externo (flotante si no se usa) |
| 4 | DRV | Pull-down rápido del NFET de bloqueo |
| 5 | IN_SYS | Alimentación del dispositivo (a IN si no hay NFET de bloqueo) |
| 6 | UVLO | Umbral de subtensión programable |
| 7 | OVP (26630/31) / PLIM (resto) | Umbral de sobretensión o de limitación de potencia |
| 8 | GND | Masa |
| 9 | dVdT | Pendiente de arranque (condensador a GND) |
| 10 | ILIM | Límite de corriente (resistencia a GND) |
| 11 | MODE | Respuesta a sobrecarga |
| 12 | SHDN | Apagado |
| 13 | IMON | Monitor de corriente |
| 14 | FLT | Fallo (drenador abierto) |
| 15 | PGTH | Umbral de *power good* |
| 16 | PGOOD | *Power good* |
| 17, 18 | OUT | Salida |
| 19–24 | NC | Sin conexión |
| 25 | EP (GND) | Pad térmico |

La asignación de la Tabla 5-1 se ha tomado del símbolo oficial; el PDF no se puede leer por columnas con fiabilidad. Antes de usar la pieza, el bloque comprobará el pinout de su variante en las Figuras 5-1 a 5-3 (p. 3).

## Recomendaciones de layout del fabricante (§9.6.1, pp. 38-39)

- Condensador cerámico de 0,1 µF o más entre IN_SYS y GND, lo más cerca posible de ambos pines y con el bucle mínimo.
- Pista de potencia lo más corta posible y dimensionada para al menos el doble de la corriente a plena carga.
- R_ILIM, C_dVdT, R_IMON, UVLO, OVP y PGTH junto a su pin, con retorno corto a GND; la pista de R_ILIM sin acoplamiento a señales de conmutación.
- Protecciones (TVS, diodos, condensadores) junto al dispositivo que protegen; diodo Schottky junto a OUT y GND contra transitorios negativos de cargas inductivas.
- Pad térmico soldado al plano de masa bajo el dispositivo.
- Ejemplo de layout: Figuras 9-18 y 9-19.

## Alternativas

| MPN | LCSC | Diferencias |
|---|---|---|
| LM5069MM-2/NOPB | C111822 | Controlador de *hot swap* de 9–80 V con NFET externo; ver `LM5069.md` |
| TPS26631RGER | C1850273 | OVP ajustable, 2× pulso; 7,956 $ a 30 uds, stock 639 |
| TPS26633RGER | C1850275 | *clamp* de 35 V, 2× pulso; stock 12 |
| TPS26636PWPR | C1849495 | HTSSOP-20; stock 35 |

## Aprovisionamiento (JLCPCB/LCSC, consulta 2026-11-05)

| Código | Variante | Tipo | Stock | Precio unitario por tramo (USD) | 5 placas | 10 placas |
|---|---|---|---|---|---|---|
| C1850278 | TPS26632RGER | Extended | 1 631 | 1–9: 3,5258 · 10–29: 2,9993 · 30–99: 2,6869 | 17,63 $ | 29,99 $ |
| C1850273 | TPS26631RGER | Extended | 639 | 1–9: 10,3812 · 10–29: 8,8734 | 51,91 $ | 88,73 $ |

La variante final la elige el bloque de entrada; solo la 26632 y la 26631 tienen stock holgado.

## Variante elegida: TPS26632RGER (SPEC-0017, DEC-0006)

- **MPN / LCSC:** TPS26632RGER, C1850278. Extended; stock 1 631 y 3,5258 $ a 1 ud. (consulta 2026-11-05, sin cambios). Alternativa TPS26633RGER, C1850275: stock 12 (6,9976 $).
- **Configuración:** MODE abierto (*latch-off*); PLIM, UVLO y PGTH a GND; SHDN con 10 kΩ a GND; R_ILIM 4,30 kΩ (I_OL 3,86–4,57 A); IMON 10 kΩ; B_GATE, DRV y PGOOD sin conectar; NC 19–24 sin conectar. Cálculos en `docs/diseno/alimentacion.md` §3.13.
- **Pinout de la 26632 (Fig. 5-3, p. 3; Tabla 5-1, p. 3-4):** el pin 7 es PLIM y el resto coincide con la tabla anterior. El símbolo oficial `TPS26632RGE` tiene: 1 y 2 IN, 3 B_GATE, 4 DRV, 5 IN_SYS, 6 UVLO, 7 PLIM, 8 GND, 9 dVdT, 10 ILIM, 11 MODE, 12 SHDN, 13 IMON, 14 FLT, 15 PGTH, 16 PGOOD, 17 y 18 OUT, 19–24 NC, 25 EP (GND). Coincide con la figura (comprobado el 2026-11-05 con la revisión G de ti.com) y con los pads de la huella (1–24 y 25 para el EP).
- La huella oficial usa el 3D `Texas_RGE0024H_VQFN-24-1EP_4x4mm_P0.5mm_EP2.7x2.7mm.step`, que existe en la instalación.

## Uso en el proyecto

ALI-13 y DEC-0004: limitador común de entrada (U1), variante 26632.
