JoanSanbartolome/ESP-Riego/hardware/componentes/0451010.MRL.md

---
mpn: 0451010.MRL
fabricante: Littelfuse
funcion: fusible SMD de 10 A muy rápido, 125 V, serie NANO2 451/453 (F1)
lcsc: C44479 (alternativa TLC TA10, C2998199)
tipo_jlcpcb: extended
stock_consultado: 2026-11-05 (22 770; 0,2378 $ a 1 ud.; TA10 1 461)
datasheet: https://www.littelfuse.com/~/media/electronics/datasheets/fuses/littelfuse_fuse_451_453_datasheet.pdf.pdf (403 desde curl: revisión no confirmada)
datasheet_local: datasheets/0451010.MRL.pdf (copia de LCSC, rev. 15/06/2017)
simbolo: Device:Fuse
huella: esp-riego:Fuse_Littelfuse-NANO2-451_453 (copia de la oficial Fuse:Fuse_Littelfuse-NANO2-451_453 con 3D propio)
modelo_3d: ${KIPRJMOD}/../libraries/3d/Fuse_Littelfuse-NANO2-451_453.step
origen_assets: huella kicad-oficial; modelo 3D creado (la instalación de KiCad 10.0.6 no trae el .step)
verificado_por:
---

# 0451010.MRL · fusible 10 A, 125 V

## Datos clave

| Parámetro | Valor | Fuente (página) |
|---|---|---|
| Corriente / tensión | 10 A, 125 V (CA o CC) | p. 2, tabla por referencia |
| Poder de corte | 50 A a 125 V CC | p. 2 |
| R en frío | 5,6 mΩ nominales | p. 2 |
| I²t de fusión | 26,46 A²s | p. 2 |
| Derating | 75 % de la nominal y curva de temperatura (≈ 96 % a 60 °C) | p. 3, nota 1 |
| Temperatura de funcionamiento | −55…125 °C | p. 4 |
| Cuerpo | 6,10 ± 0,20 × 2,69 ± 0,25 × 2,69 ± 0,25 mm; casquillo 1,45 mm | p. 4, «Dimensions» |

## Pinout

Dos terminales sin polaridad: pads 1 y 2.

## Huella

| | Datasheet (p. 4, «Recommended pad layout») | Huella |
|---|---|---|
| Pad | 1,96 × 3,15 mm | 1,96 × 3,15 mm |
| Separación interior / exterior | 2,95 / 6,86 mm | ± 2,455 mm de centro (2,95 / 6,86 mm) |

## Modelo 3D (creado)

`Fuse_Littelfuse-NANO2-451_453.step`: cuerpo 6,10 × 2,69 × 2,69 mm con dos casquillos de 1,45 mm, centrado en el origen. Generado con SolidCraft (`hardware/libraries/3d/fuentes-solidcraft/gen.py`, sección «Fusible»; JSON en `nano2.json`). Sin chaflanes (supuesto). Comprobado con `kicad-cli pcb render` sobre una placa de prueba: alineado con los pads. Requiere verificación de validación.

## Recomendaciones de layout del fabricante

- Solo el *pad layout* de la p. 4.

## Alternativas

| MPN | LCSC | Diferencias |
|---|---|---|
| TLC TA10 | C2998199 | 10 A; stock 1 461; sin comprobar su huella ni su curva |

## Uso en el proyecto

F1 del bloque de alimentación (ALI-04, ALI-12).
