JoanSanbartolome/ESP-Riego/hardware/componentes/BZT52C15.md

---
mpn: BZT52C15
fabricante: MDD (Microdiode Semiconductor)
funcion: zéner de 15 V y 0,5 W que limita V_GS de Q1 (D1)
lcsc: C173427 (alternativa Diodes BZT52C15-7-F, C177014)
tipo_jlcpcb: extended
stock_consultado: 2026-11-05 (148 099; 0,0161 $ a 1 ud.; Diodes 52 710)
datasheet: PDF de LCSC (MDD BZT52C2V0 – BZT52C75, rev. 2025A6); no se ha localizado URL del fabricante
datasheet_local: datasheets/BZT52C15.pdf
simbolo: Device:D_Zener
huella: Diode_SMD:D_SOD-123
modelo_3d: ${KICAD10_3DMODEL_DIR}/Diode_SMD.3dshapes/D_SOD-123.step
origen_assets: kicad-oficial
verificado_por:
---

# BZT52C15 · zéner 15 V

## Datos clave

| Parámetro | Valor | Fuente (página) |
|---|---|---|
| V_Z (5 mA) | 14,25 / 15 / 15,75 V (mín. / nom. / máx.) | p. 3, tabla |
| Z_ZT | 40 Ω máx. | p. 3 |
| I_R | 0,1 µA máx. a 11 V | p. 3 |
| Potencia | 500 mW | p. 1 |
| R_θJA | 305 °C/W (PCB de 5 × 5 cm) | p. 1 |
| Encapsulado | SOD-123; banda en el cátodo | p. 1 |

## Pinout

| Pin | Función |
|---|---|
| 1 (K) | Cátodo, a la fuente de Q1 |
| 2 (A) | Ánodo, a la puerta |

`Device:D_Zener` (1 K, 2 A) y `D_SOD-123` (pad 1 = cátodo) coinciden.

## Recomendaciones de layout del fabricante

- Ninguna; D1 y R1 junto a la puerta de Q1 (`docs/diseno/alimentacion.md` §8).

## Aprovisionamiento

C173427: Extended, 148 099 en stock (consulta 2026-11-05).

## Uso en el proyecto

D1 (SPEC-0017 §3.3).
