JoanSanbartolome/ESP-Riego/hardware/componentes/FXL0650-100-M.md

---
mpn: FXL0650-100-M
fabricante: Changjiang Microelectronics (cjiang)
funcion: inductor de potencia de 10 µH apantallado para el buck de 5 V (L1)
lcsc: C475521 (alternativa FXLA0630-100M, C5372143)
tipo_jlcpcb: extended
stock_consultado: 2026-11-05 (38 857; 0,1729 $ a 1 ud.; FXLA0630 1 545)
datasheet: PDF de LCSC (cjiang, serie FXL, 110 páginas); no se copia (13 MB > 5 MB)
datasheet_local: no
simbolo: Device:L
huella: Inductor_SMD:L_Changjiang_FXL0650
modelo_3d: ${KICAD10_3DMODEL_DIR}/Inductor_SMD.3dshapes/L_Changjiang_FXL0650.step
origen_assets: kicad-oficial
verificado_por:
---

# FXL0650-100-M · inductor 10 µH

## Datos clave (serie FXL0650, p. 16 del PDF)

| Parámetro | Valor | Nota |
|---|---|---|
| Inductancia | 10 µH ± 20 % (100 kHz, 1 V) | |
| DCR | 60 mΩ máx. | |
| I_sat | **4,24 A máx. · 5,3 A típ.** | cabecera «MAX / TYP» |
| I_rms (calentamiento) | **3,8 A máx. · 4,5 A típ.** | cabecera «MAX / TYP» |
| Tensión soportada | 30 V mín. | |
| Cuerpo | 7,0 ± 0,3 × 6,6 ± 0,2 × 5,0 máx. mm | p. 5 |

`docs/diseno/alimentacion.md` §3.6 cita I_sat 5,3 A e I_rms 4,5 A, que son los valores **típicos**. Con los de la columna «máx.» (4,24 A y 3,8 A) se sigue cumpliendo I_sat ≥ I_SC máx. = 3,6 A (margen 0,64 A) y I_rms ≥ 2,3 A de la corriente máxima disponible. Se anota para que validación lo tenga en cuenta.

## Pinout

Dos terminales sin polaridad: pads 1 y 2.

## Huella (p. 5, «Recommend Land Pattern»: a = 3,7, b = 8,4, c = 3,5 mm)

| | Datasheet | Huella |
|---|---|---|
| Hueco entre pads (a) | 3,7 mm | 6,05 − 2,35 = 3,7 mm |
| Extensión exterior (b) | 8,4 mm | 2 × (3,025 + 1,175) = 8,4 mm |
| Ancho del pad (c) | 3,5 mm | 3,5 mm |

## Recomendaciones de layout del fabricante

- Solo el *land pattern* (p. 5). Del diseño: SW lo más corto posible y lejos de la antena y del SHT4x (`docs/diseno/alimentacion.md` §8).

## Alternativas

| MPN | LCSC | Diferencias |
|---|---|---|
| FXLA0630-100M | C5372143 | I_sat 5,5 A (según SPEC-0017); huella `L_Changjiang_FXL0630`; sin comprobar |

## Uso en el proyecto

L1, buck de 5 V (ALI-05).
