JoanSanbartolome/ESP-Riego/hardware/componentes/LMR36520.md

---
mpn: LMR36520FADDAR (alternativa LMR36520ADDAR)
fabricante: Texas Instruments
funcion: buck síncrono 65 V / 2 A, 400 kHz, FPWM; raíl de 5 V (U2)
lcsc: C1858395 (FADDAR) · C2879422 (ADDAR)
tipo_jlcpcb: extended
stock_consultado: 2026-11-05 (FADDAR 8 000 · ADDAR 6 117)
datasheet: https://www.ti.com/lit/ds/symlink/lmr36520.pdf
datasheet_local: datasheets/LMR36520.pdf (SNVSBF0C, noviembre de 2025)
simbolo: esp-riego:LMR36520FADDA (copia de Regulator_Switching:LMR36510ADDA con BOOT pasivo; ver "Símbolo")
huella: esp-riego:Texas_DDA0008B_HTSOP-8-1EP_3.9x4.9mm_P1.27mm_EP2.95x4.9mm_Mask2.71x3.4mm (propia)
modelo_3d: ${KICAD10_3DMODEL_DIR}/Package_SO.3dshapes/Texas_HTSOP-8-1EP_3.9x4.9mm_P1.27mm_EP2.85x4.9mm_Mask2.4x3.1mm_ThermalVias.step
origen_assets: símbolo creado a partir del oficial LMR36510ADDA; huella propia (DDA0008B) derivada de la oficial Texas_HTSOP-8-1EP…ThermalVias; 3D kicad-oficial
verificado_por:
---

# LMR36520 · buck 65 V / 2 A

## Datos clave

| Parámetro | Valor | Fuente (página) |
|---|---|---|
| Entrada | 4,2…65 V (máximo absoluto 70 V) | p. 1, §6.1 y §6.3 (p. 5) |
| Corriente | 2 A; I_LIMIT mín. 1,8 A; I_SC máx. 3,6 A | p. 1 y p. 6 |
| Frecuencia | 400 kHz | p. 1 |
| V_FB | 1 V ± 1,5 % | p. 6 |
| EN | V_EN-H 1,157 / 1,231 / 1,3 V; histéresis típ. 110 mV, sin mín. ni máx. | p. 6 |
| t_ON mín. | 102 ns máx. | p. 7 |
| Variantes | FADDAR: FPWM (sin PFM). ADDAR: con PFM. Misma huella y pines | p. 14 y tabla de pedido |
| Recomendaciones de condensadores | Los valores del datasheet son **efectivos** (con tensión DC y temperatura), salvo que se diga lo contrario; CIN ≥ 4,7 µF cerámico + 220 nF 100 V X7R; CVCC 1 µF 16 V | §8.1 (p. 17) nota, §8.2.1.2.5 (p. 20), §8.2.1.2.7 (p. 21) |

## Pinout (DDA, HSOIC-8 con PowerPAD; Tabla 5-1, p. 4)

| Pin | Nombre | Función |
|---|---|---|
| 1 | PGND | Masa de potencia y de referencia |
| 2 | VIN | Entrada |
| 3 | EN | Habilitación (no flotante) |
| 4 | PG | *Power good*, drenador abierto |
| 5 | FB | Realimentación (no flotante, no a masa) |
| 6 | VCC | LDO interno de 5 V; 1 µF a PGND, sin cargas externas |
| 7 | BOOT | 100 nF a SW |
| 8 | SW | Nodo de conmutación |
| 9 (EP) | PAD | Pad térmico, a masa con vías |

## Símbolo

`esp-riego:LMR36520FADDA` en `hardware/libraries/esp-riego.kicad_sym`. Partió de `Regulator_Switching:LMR36510ADDA`, que el datasheet del LMR36520 declara compatible pin a pin (p. 1). La tabla de pines coincide con la 5-1 (p. 4). Cambios: nombre, valor, datasheet, descripción, campos `LCSC Part#` y `MPN`, y BOOT de entrada a pasivo. Valor del símbolo: LMR36520FADDAR; para la ADDAR se cambia solo el valor, el MPN y el LCSC.

## Huella

Propia, `esp-riego:Texas_DDA0008B_HTSOP-8-1EP_3.9x4.9mm_P1.27mm_EP2.95x4.9mm_Mask2.71x3.4mm` en `esp-riego.pretty`, según el *land pattern* DDA0008B de TI (SNVSBF0C pp. 38-40, dibujo 4214849/B). La oficial de KiCad (origen DRV8870) se descartó en VAL-0018-01-02.

| Cota | TI DDA0008B | Huella propia |
|---|---|---|
| Pad de señal | 1,55 × 0,6 mm, centros a ± 2,7 mm | igual |
| Pad térmico de cobre | 2,95 × 4,9 mm | igual (más 2,95 × 4,9 en B.Cu) |
| Apertura de máscara del EP | 2,71 × 3,4 mm | 2,71 × 3,4 (margen 0) |
| Pasta del EP | 2,71 × 3,4 mm (estarcido 0,125) | 2,71 × 3,4 mm |
| Vías | Ø 0,2, 8 vías a (± 0,65; ± 0,65 / ± 1,95), tapadas o rellenas (nota 10) | 8 de 0,3 / 0,6 mm (FAB-02) en las mismas posiciones. Por abajo, tapadas (sin apertura en B.Mask). Por arriba, las 4 de y = ± 0,65 quedan abiertas bajo la pasta/apertura del EP, y las 4 de y = ± 1,95 quedan tapadas por la máscara. Rellenarlas o taparlas por arriba es decisión de fabricación (fase 5) |

Patillas 0,31–0,51 mm: caben en el pad de 0,6. Hueco pad-EP: 0,45 mm. El 3D es el oficial (pin 1 sobre el pad 1).

## Recomendaciones de layout del fabricante

- C de entrada de 220 nF pegado a VIN y PGND, y el de 4,7 µF justo después (§8.5).
- CVCC cerca de VCC; CBOOT cerca de BOOT y SW.
- FB lejos de SW y del inductor. Pad térmico a un plano de masa con vías.

## Alternativas

| MPN | LCSC | Diferencias |
|---|---|---|
| LMR36520ADDAR | C2879422 | Variante con PFM; sube la tensión en reposo con poca carga; 1,2053 $ a 1 ud. |
| TPS54360B, LMR16030 | — | Descartados en SPEC-0017 (`docs/diseno/alimentacion.md` §3.6) |

## Aprovisionamiento (consulta 2026-11-05)

| LCSC | Tipo | Stock | Precio a 1 ud. |
|---|---|---|---|
| C1858395 | Extended | 8 000 | 1,1268 $ |
| C2879422 | Extended | 6 117 | 1,2053 $ |

## Uso en el proyecto

U2 del bloque de alimentación (SPEC-0017, SPEC-0018, ALI-05 y ALI-06).
