JoanSanbartolome/ESP-Riego/hardware/componentes/SQD50P06-15L.md

---
mpn: SQD50P06-15L_GE3
fabricante: Vishay Siliconix
funcion: P-MOS de 60 V para la protección de polaridad (Q1)
lcsc: C3281500 (alternativa UMW SUD50P06-15, C7503186)
tipo_jlcpcb: extended
stock_consultado: 2026-11-05 (Vishay 5 744 · UMW 51 103)
datasheet: https://www.vishay.com/docs/69098/sqd50p06.pdf
datasheet_local: datasheets/SQD50P06-15L.pdf (doc. 69098, S12-2006 rev. E, 20-ago-2012); alternativa en datasheets/SUD50P06-15-UMW.pdf
simbolo: Transistor_FET:SUD50P06-15 (hereda SUD19P06-60: 1 G, 2 D, 3 S)
huella: Package_TO_SOT_SMD:TO-252-2
modelo_3d: ${KICAD10_3DMODEL_DIR}/Package_TO_SOT_SMD.3dshapes/TO-252-2.step
origen_assets: kicad-oficial
verificado_por:
---

# SQD50P06-15L · P-MOS 60 V

## Datos clave

| Parámetro | Valor | Fuente (página) |
|---|---|---|
| V_DS | −60 V | p. 1 |
| V_GS | ± 20 V | p. 1 |
| R_DS(on) | 15,5 mΩ máx. a V_GS = −10 V (25 °C); 20 mΩ a −4,5 V; 26 mΩ máx. a 125 °C | pp. 1-2 |
| I_D / I_DM | −50 A (encapsulado) / −200 A | p. 1 |
| I_AS / E_AS | −38 A / 135 mJ (L = 0,1 mH) | p. 1 |
| R_thJA | 50 °C/W (PCB de 1 in²) | p. 1 |
| T_J | −55…175 °C | p. 1 |

## Pinout (TO-252, vista superior, p. 1)

| Pin | Nombre | Símbolo `SUD50P06-15` | Huella `TO-252-2` |
|---|---|---|---|
| 1 | G | 1 G | pad 1 |
| 2 y pestaña | D | 2 D | pad 2 (pestaña) |
| 3 | S | 3 S | pad 3 |

Los tres coinciden: pendiente de SPEC-0017 cerrado. La alternativa UMW SUD50P06-15 tiene el mismo orden (1 G, 2 D, 3 S; p. 1 de su datasheet).

## Alternativa UMW SUD50P06-15 (C7503186; datasheet UMW/UTD de noviembre de 2024)

| Parámetro | UMW | Vishay | Fuente UMW |
|---|---|---|---|
| V_DS / V_GS | −60 V / ± 20 V | igual | p. 1 |
| R_DS(on) a −10 V | 12 típ. / 15 máx. mΩ (−17 A) | 15,5 máx. | p. 3 |
| R_DS(on) a 125 °C | 25 mΩ máx. | 26 mΩ máx. | p. 3 |
| R_thJA estado estacionario (1 in²) | 40 típ. / 50 máx. °C/W | 50 | p. 2 |
| T_J máx. | 150 °C | 175 °C | p. 1 |
| E_AS | 125 mJ | 135 mJ | p. 1 |

Es válida para Q1 con los cálculos de `docs/diseno/alimentacion.md` §3.3 (T_J ≈ 94 °C < 150 °C). Mismo símbolo y huella.

## Recomendaciones de layout del fabricante

- Pestaña de drenador a un polígono de cobre; el dato de R_thJA es con 1 in² (§3.3).

## Aprovisionamiento (consulta 2026-11-05)

| LCSC | Tipo | Stock | 1 ud. |
|---|---|---|---|
| C3281500 | Extended | 5 744 | 1,0892 $ |
| C7503186 | Extended | 51 103 | 0,3634 $ |

## Uso en el proyecto

Q1 (ALI-03), con R1 de 100 kΩ y D1 BZT52C15 en la puerta.
