JoanSanbartolome/ESP-Riego/hardware/componentes/SS310.md

---
mpn: SS310
fabricante: MDD (Microdiode Semiconductor)
funcion: diodo Schottky de 100 V y 3 A contra transitorios negativos en OUT del limitador (D3)
lcsc: C15874 (alternativa UMW SS310A, C2988628)
tipo_jlcpcb: extended
stock_consultado: 2026-11-05 (348 658; 0,037 $ a 1 ud.; UMW 4 731)
datasheet: PDF de LCSC (MDD SS32 thru SS3200, rev. 2024A5); no se ha localizado URL del fabricante
datasheet_local: datasheets/SS310.pdf
simbolo: Device:D_Schottky
huella: Diode_SMD:D_SMA
modelo_3d: ${KICAD10_3DMODEL_DIR}/Diode_SMD.3dshapes/D_SMA.step
origen_assets: kicad-oficial
verificado_por:
---

# SS310 · Schottky 100 V / 3 A

## Datos clave

| Parámetro | Valor | Fuente (página) |
|---|---|---|
| V_RRM / V_DC | 100 V | p. 1 |
| I(AV) | 3 A | p. 1 |
| I_FSM | 80 A (8,3 ms) | p. 1 |
| V_F a 3 A | 0,85 V (columna de SS38 a SS3150) | p. 1 |
| I_R | 0,3 mA a 25 °C; 3 mA a 125 °C | p. 1 |
| R_θJA | 70 °C/W | p. 1 |
| T_J | −55…125 °C | p. 1 |
| Encapsulado | DO-214AC / SMA; banda en el cátodo | p. 1 |

## Pinout

| Pin | Función |
|---|---|
| 1 (K) | Cátodo (banda); a OUT del limitador |
| 2 (A) | Ánodo; a GND |

`Device:D_Schottky` (1 K, 2 A) y `D_SMA` (pad 1 = cátodo) coinciden.

## Recomendaciones de layout del fabricante

- Ninguna; el diseño pide D3 junto a OUT y GND del limitador (`docs/diseno/alimentacion.md` §8).

## Aprovisionamiento

C15874: Extended, 348 658 en stock (consulta 2026-11-05).

## Uso en el proyecto

D3 (SPEC-0017 §3.13.6).
