JoanSanbartolome/ESP-Riego/hardware/componentes/TPS2116.md

---
mpn: TPS2116DRLR
fabricante: Texas Instruments
funcion: multiplexor de potencia de 2 entradas con bloqueo de corriente inversa; unión buck / USB del raíl de 5 V (U3)
lcsc: C3235557
tipo_jlcpcb: extended
stock_consultado: 2026-11-05 (54 421; 0,3876 $ a 1 ud.)
datasheet: https://www.ti.com/lit/ds/symlink/tps2116.pdf
datasheet_local: datasheets/TPS2116.pdf (SLVSFG1A, mayo de 2021; dibujo mecánico 4224486/G, 11/2024)
simbolo: Power_Management:TPS2116DRL
huella: Package_TO_SOT_SMD:SOT-583-8
modelo_3d: ${KICAD10_3DMODEL_DIR}/Package_TO_SOT_SMD.3dshapes/SOT-583-8.step
origen_assets: kicad-oficial
verificado_por:
---

# TPS2116 · multiplexor de 5 V, 2,5 A

## Datos clave

| Parámetro | Valor | Fuente (página) |
|---|---|---|
| Entrada | 1,6…5,5 V (máximo absoluto 6 V) | pp. 4-5 |
| Corriente | 2,5 A | p. 1 |
| R_ON | ≤ 60 mΩ (−40…105 °C, 5 V) | p. 6 |
| Corriente inversa a VIN1 con el canal cortado | ≤ 0,25 µA | p. 6 |
| V_REF de PR1 | 0,92…1,08 V | p. 6 |
| Modo prioridad | MODE a VIN1; PR1 desde un divisor de VIN1 | §7.6.1 (p. 12) |
| R_θJA | 111,5 °C/W | p. 4 |

## Pinout (DRL, SOT-583-8; Tabla 5-1, p. 3)

| Pin | Nombre | Función |
|---|---|---|
| 1 | GND | Masa |
| 2, 7 | VOUT | Salida |
| 3 | VIN1 | Entrada 1 |
| 4 | PR1 | Selección: alto = VIN1, bajo = VIN2 |
| 5 | MODE | A VIN1 = prioridad; a una tensión externa = manual |
| 6 | VIN2 | Entrada 2 |
| 8 | ST | Estado, drenador abierto (bajo si no se usa VIN1) |

El símbolo oficial y los pads de la huella coinciden con esta tabla.

## Huella (dibujo DRL0008A, PDF pp. 22-24)

| | Datasheet | Oficial KiCad |
|---|---|---|
| Pad | 0,67 × 0,3 mm | 0,67 × 0,3 mm |
| Paso | 0,5 mm | 0,5 mm |
| Separación entre filas de centros | 1,48 mm | 1,48 mm (± 0,74) |

## Recomendaciones de layout del fabricante

- Condensador de entrada junto a VIN1 y VIN2; condensador de salida cerca de VOUT (p. 11: ≈ 100 µF recomendados si hay bloqueo inverso con carga inductiva).

## Alternativas

Ninguna en la misma huella (`docs/diseno/alimentacion.md` §3.8). Reserva: dos diodos Schottky.

## Uso en el proyecto

U3 del bloque de alimentación: VIN1 = buck, VIN2 = VBUS (ALI-08).
