JoanSanbartolome/ESP-Riego/hardware/componentes/LM5069.md

---
mpn: LM5069MM-1 / LM5069MM-2 (LM5069MM-2/NOPB en LCSC)
fabricante: Texas Instruments
funcion: controlador de *hot swap* de 9–80 V con limitación de potencia y NFET externo; candidato al limitador común de entrada (ALI-13, DEC-0004)
lcsc: C111822 (LM5069MM-2/NOPB)
tipo_jlcpcb: extended
stock_consultado: 2026-11-05
datasheet: https://www.ti.com/lit/ds/symlink/lm5069.pdf
datasheet_local: datasheets/LM5069.pdf (SNVS452G, enero de 2020, 2,2 MB)
simbolo: Power_Management:LM5069MM-2 (y LM5069MM-1)
huella: Package_SO:MSOP-10_3x3mm_P0.5mm
modelo_3d: ${KICAD10_3DMODEL_DIR}/Package_SO.3dshapes/MSOP-10_3x3mm_P0.5mm.step
origen_assets: kicad-oficial
verificado_por:
---

# LM5069 · *hot swap* de 80 V

## Datos clave

| Parámetro | Valor | Fuente (página) |
|---|---|---|
| Tensión de funcionamiento | 9…80 V | p. 1 |
| Limitación | corriente ajustable (R_S), potencia máxima del NFET programable (pin PWR), *circuit breaker* | p. 1 |
| Versiones | -1: se bloquea (*latch-off*) tras un fallo; -2: reintento automático a ciclo fijo | p. 1 |
| UVLO y OVLO | umbrales y histéresis programables | p. 1 |
| *Power good* | salida activa en alto de drenador abierto (OUT a 1,25 V de VIN) | p. 1 |
| Encapsulado | VSSOP-10 (MM) | p. 1 |
| Elemento de paso | NFET externo; no incluye interruptor | p. 1 |

A diferencia del TPS2663x (FET integrado de 6 A), la corriente y la disipación dependen del NFET y de R_S que se elijan; el cálculo es del bloque de entrada.

## Pinout (VSSOP-10, símbolo oficial; Pin Functions, p. 3)

| Pin | Nombre | Función |
|---|---|---|
| 1 | SENSE | Sentido de corriente (tras R_S) |
| 2 | VIN | Alimentación de entrada |
| 3 | UVLO | Subtensión programable |
| 4 | OVLO | Sobretensión programable |
| 5 | GND | Masa |
| 6 | TIMER | Temporizador de arranque y de fallo |
| 7 | PWR | Límite de potencia del NFET |
| 8 | PGD | *Power good* (drenador abierto) |
| 9 | OUT | Sentido de la tensión de salida |
| 10 | GATE | Puerta del NFET externo |

## Recomendaciones de layout del fabricante (§11.1, p. 28)

- LM5069 junto al conector de entrada, para minimizar la inductancia hasta el FET.
- Condensador de desacoplo de VIN junto a R_S, no junto al pin, para no formar un filtro LC en cortocircuitos (Figura 43).
- R_S cerca del LM5069 y con conexión Kelvin (Figura 46).
- Camino de corriente de entrada y retorno paralelos y juntos.
- Masas de los componentes asociados unidas al pin GND y a masa del sistema en un solo punto.
- Disipador adecuado para el NFET.
- Condensador en el lado de la fuente del conector y, con cargas inductivas, diodo en la salida (§11.1.2, Figura 44).
- Ejemplo de layout: §11.2.

## Alternativas

| MPN | LCSC | Diferencias |
|---|---|---|
| LM5069MMX-2/NOPB | C2653582 | Misma función, carrete (MMX); 3,1497 $ a 30 uds, stock 5 419 |
| LM5069MM-1/NOPB | C486026 | Versión con *latch-off*; stock 1 |
| TPS2663x | C1850278 | eFuse integrado; ver `TPS2663.md` |

## Aprovisionamiento (JLCPCB/LCSC, consulta 2026-11-05)

| Código | Tipo | Stock | Precio unitario por tramo (USD) | 5 placas | 10 placas |
|---|---|---|---|---|---|
| C111822 (MM-2/NOPB) | Extended | 9 471 | 1–9: 4,9764 · 10–29: 4,3827 · 30–99: 4,0295 | 24,88 $ | 43,83 $ |
| C2653582 (MMX-2/NOPB) | Extended | 5 419 | 1–9: 4,1325 · 10–29: 3,5160 | 20,66 $ | 35,16 $ |

Cuenta aparte el NFET externo y R_S, que no se han elegido todavía.

## Uso en el proyecto

ALI-13 y DEC-0004: candidato al limitador común de entrada.
