JoanSanbartolome/ESP-Riego/hardware/componentes/campos-salidas.csv

Refs | Value | Footprint | LCSC Part# | MPN | Fabricante | Datasheet | Description | DNP
U7-U12 | BTT6050-1ERA | esp-riego:Infineon_PG-TDSO-14_8.65x3.9mm_P1.27mm_EP2.65x6.4mm | C534868 | BTT6050-1ERA | Infineon Technologies | https://www.infineon.com/assets/row/public/documents/10/49/infineon-btt6050-1era-datasheet-en.pdf | High-side 24 V 50 mΩ con medida de corriente: canal n | no
J4-J9 | WJ500V-5.08-2P | esp-riego:TerminalBlock_Kangnex_WJ500V-5.08-2P_1x02_P5.08mm_Horizontal | C8465 | WJ500V-5.08-2P | Ningbo Kangnex Elec | https://www.lcsc.com/datasheet/lcsc_datasheet_1912251636_Ningbo-Kangnex-Elec-WJ500V-5-08-2P_C8465.pdf | Borne de tornillo 2P 5.08 mm 15 A: salida n (polo 1 = OUTn / polo 2 = GND) | no
R26-R31 | 10k | Resistor_SMD:R_0603_1608Metric | C25804 | 0603WAF1002T5E | UNI-ROYAL | https://www.lcsc.com/datasheet/lcsc_datasheet_2206010045_UNI-ROYAL-Uniroyal-Elec-0603WAF1002T5E_C25804.pdf | Resistencia 10 kΩ 1 % 0603: R_IN de IN_n | no
R32-R37 | 100k | Resistor_SMD:R_0603_1608Metric | C25803 | 0603WAF1003T5E | UNI-ROYAL | https://www.lcsc.com/datasheet/lcsc_datasheet_2206010045_UNI-ROYAL-Uniroyal-Elec-0603WAF1003T5E_C25803.pdf | Resistencia 100 kΩ 1 % 0603: pull-down de IN_n | no
R38-R43 | 10k | Resistor_SMD:R_0603_1608Metric | C25804 | 0603WAF1002T5E | UNI-ROYAL | https://www.lcsc.com/datasheet/lcsc_datasheet_2206010045_UNI-ROYAL-Uniroyal-Elec-0603WAF1002T5E_C25804.pdf | Resistencia 10 kΩ 1 % 0603: R_DEN del canal n | no
R44 | 100k | Resistor_SMD:R_0603_1608Metric | C25803 | 0603WAF1003T5E | UNI-ROYAL | https://www.lcsc.com/datasheet/lcsc_datasheet_2206010045_UNI-ROYAL-Uniroyal-Elec-0603WAF1003T5E_C25803.pdf | Resistencia 100 kΩ 1 % 0603: pull-down de OUT_DEN | no
R45-R50 | 10k | Resistor_SMD:R_1206_3216Metric | C17902 | 1206W4F1002T5E | UNI-ROYAL | https://www.lcsc.com/datasheet/lcsc_datasheet_2206010145_UNI-ROYAL-Uniroyal-Elec-1206W4F1002T5E_C17902.pdf | Resistencia 10 kΩ 1 % 0.25 W 200 V 1206: R_SENSE de IS_HS n | no
R51-R56 | 820 | Resistor_SMD:R_0603_1608Metric | C23253 | 0603WAF8200T5E | UNI-ROYAL | https://www.lcsc.com/datasheet/lcsc_datasheet_2206010100_UNI-ROYAL-Uniroyal-Elec-0603WAF8200T5E_C23253.pdf | Resistencia 820 Ω 1 % 0603: R_IS del canal n | no
R57-R62 | 47k | Resistor_SMD:R_0805_2012Metric | C17713 | 0805W8F4702T5E | UNI-ROYAL | https://www.lcsc.com/datasheet/lcsc_datasheet_2206010200_UNI-ROYAL-Uniroyal-Elec-0805W8F4702T5E_C17713.pdf | Resistencia 47 kΩ 1 % 0.125 W 150 V 0805: R_OL del canal n | no
R63-R68 | 1k | Resistor_SMD:R_0603_1608Metric | C21190 | 0603WAF1001T5E | UNI-ROYAL | https://www.lcsc.com/datasheet/lcsc_datasheet_2206010130_UNI-ROYAL-Uniroyal-Elec-0603WAF1001T5E_C21190.pdf | Resistencia 1 kΩ 1 % 0603: R_LED del canal n (≈ 1.5 mA) | no
C27-C32 | 220n 100V | Capacitor_SMD:C_0805_2012Metric | C513710 | CC0805KKX7R0BB224 | YAGEO | https://www.lcsc.com/datasheet/lcsc_datasheet_2004231434_YAGEO-CC0805KKX7R0BB224_C513710.pdf | MLCC 220 nF 100 V X7R 0805: C_VS del canal n | no
C33-C38 | 220n 100V | Capacitor_SMD:C_0805_2012Metric | C513710 | CC0805KKX7R0BB224 | YAGEO | https://www.lcsc.com/datasheet/lcsc_datasheet_2004231434_YAGEO-CC0805KKX7R0BB224_C513710.pdf | MLCC 220 nF 100 V X7R 0805: C_OUT del canal n | no
C39-C44 | 100n | Capacitor_SMD:C_0603_1608Metric | C14663 | CC0603KRX7R9BB104 | YAGEO | https://www.lcsc.com/datasheet/lcsc_datasheet_2211101700_YAGEO-CC0603KRX7R9BB104_C14663.pdf | MLCC 100 nF 50 V X7R 0603: C_IS del canal n | no
C45, C46 | 4.7u 100V | Capacitor_SMD:C_1210_3225Metric | C381466 | FS32X475K101EGG | PSA (Prosperity Dielectrics) | https://wmsc.lcsc.com/wmsc/upload/file/pdf/v2/lcsc/2304140030_PSA-Prosperity-Dielectrics-FS32X475K101EGG_C381466.pdf | MLCC 4.7 µF 100 V X7R 1210: BUS_24V a granel (C45 arriba / C46 abajo) | no
D6-D11 | Rojo | LED_SMD:LED_0603_1608Metric | C2286 | KT-0603R | Hubei KENTO Elec | https://www.lcsc.com/datasheet/lcsc_datasheet_1810231112_Hubei-KENTO-Elec-KT-0603R_C2286.pdf | LED rojo 0603: canal n (en IN_n) | no
D12-D17 | M7 | Diode_SMD:D_SMA | C95872 | M7 | MDD (Microdiode Semiconductor) | https://www.lcsc.com/datasheet/lcsc_datasheet_2407101107_MDD-Microdiode-Semiconductor-M7_C95872.pdf | Rectificador 1 kV 1 A SMA: rueda libre del canal n (K = OUTn / A = GND); DNP (DEC-0008) | sí
