JoanSanbartolome/ESP-Riego/hardware/componentes/bloque-salidas.md

# Bloque de salidas: piezas y campos (SPEC-0025)

Consulta de JLCPCB: **2026-11-12**, con `herramientas/kicad/jlc.py` (datos completos en `stock-salidas.csv`; campos de los símbolos en `campos-salidas.csv`). Fuente de la lista: `docs/diseno/salidas.md` §9. Datasheet de cada pieza: la URL de la columna `Datasheet` de `campos-salidas.csv`. Las piezas con ficha propia (BTT6050-1ERA, WJ500V-5.08-2P, KT-0603R, M7) se citan en la última columna.

| Refs. | MPN | Fabricante | LCSC | Tipo · stock (2026-11-12) | Ficha |
|---|---|---|---|---|---|
| U7–U12 | BTT6050-1ERA | Infineon | C534868 | Extended · 1 628 | `BTT6050-1ERA.md` |
| J4–J9 | WJ500V-5.08-2P | Kangnex | C8465 | Extended · 293 197 | `WJ500V-5.08-2P.md` |
| R26–R31, R38–R43 | 0603WAF1002T5E | UNI-ROYAL | C25804 | Basic · 42 855 148 | — |
| R32–R37, R44 | 0603WAF1003T5E | UNI-ROYAL | C25803 | Basic · 15 164 033 | — |
| R45–R50 | 1206W4F1002T5E | UNI-ROYAL | C17902 | Basic · 1 923 492 | — |
| R51–R56 | 0603WAF8200T5E | UNI-ROYAL | C23253 | Basic · 816 705 | — |
| R57–R62 | 0805W8F4702T5E | UNI-ROYAL | C17713 | Basic · 1 103 957 | — |
| R63–R68 | 0603WAF1001T5E | UNI-ROYAL | C21190 | Basic · 28 789 585 | — |
| C27–C38 | CC0805KKX7R0BB224 | YAGEO | C513710 | Extended · 26 821 | — |
| C39–C44 | CC0603KRX7R9BB104 | YAGEO | C14663 | Basic · 36 487 972 | — |
| C45, C46 | FS32X475K101EGG | PSA | C381466 | Extended · 37 932 | — |
| D6–D11 | KT-0603R | Hubei KENTO | C2286 | Basic · 5 986 407 | `KT-0603R.md` |
| D12–D17 (DNP) | M7 | MDD | C95872 | Basic · 6 487 297 | `M7.md` |

Alternativas con stock (2026-11-12): BTT6030-2ERA C534865 (Extended · 10 556); Yageo RC0805FR-0747KL C126351 (Extended · 245 933); Yageo RC0603FR-0710KL C98220; RC0603FR-07100KL C14675; RC1206FR-0710KL C132649; RC0603FR-07820RL C114638; RC0603FR-071KL C22548; Samsung CL21B224KCFSFNE C307542 (29 234); CL10B104KB8NNNC C1591; Walsin 1210B475K101CT C7471274 (1 959); KT-0603YG C2289 (Extended · 34 078).
