JoanSanbartolome/ESP-Riego/hardware/componentes/stock-sensores.csv

LCSC | MPN | Fabricante | Tipo | Stock | Precio_USD | Fecha
C2848306 | SHT40-AD1B-R3 | Sensirion | Extended | 13207 | 1.8538 | 2026-11-14
C7461861 | SHT41-AD1B-R2 | Sensirion | Extended | 11244 | 3.2592 | 2026-11-14
C5221601 | SHT45-AD1B-R2 | Sensirion | Extended | 6530 | 5.7167 | 2026-11-14
C2909890 | SHT40-AD1B-R2 | Sensirion | Extended | 14052 | 1.7491 | 2026-11-14
C14663 | CC0603KRX7R9BB104 | YAGEO | Basic | 34639344 | 0.0104 | 2026-11-14
