JoanSanbartolome/ESP-Riego/hardware/componentes/stock-salidas.csv

LCSC | MPN | Fabricante | Tipo | Stock | Precio_USD | Fecha
C126351 | RC0805FR-0747KL | YAGEO | Extended | 245933 | 0.0044 | 2026-11-12
C534868 | BTT6050-1ERA | Infineon Technologies | Extended | 1628 | 1.2758 | 2026-11-12
C534865 | BTT6030-2ERA | Infineon Technologies | Extended | 10556 | 2.9769 | 2026-11-12
C8465 | WJ500V-5.08-2P | Ningbo Kangnex Elec | Extended | 293197 | 0.1345 | 2026-11-12
C2286 | KT-0603R | Hubei KENTO Elec | Basic | 5986407 | 0.0077 | 2026-11-12
C2289 | KT-0603YG | Hubei KENTO Elec | Extended | 34078 | 0.0106 | 2026-11-12
C513710 | CC0805KKX7R0BB224 | YAGEO | Extended | 26821 | 0.0226 | 2026-11-12
C381466 | FS32X475K101EGG | PSA(Prosperity Dielectrics) | Extended | 37932 | 0.2343 | 2026-11-12
C95872 | M7 | MDD(Microdiode Semiconductor) | Basic | 6487297 | 0.0103 | 2026-11-12
C17902 | 1206W4F1002T5E | UNI-ROYAL(Uniroyal Elec) | Basic | 1923492 | 0.0078 | 2026-11-12
C17713 | 0805W8F4702T5E | UNI-ROYAL(Uniroyal Elec) | Basic | 1103957 | 0.0068 | 2026-11-12
C23253 | 0603WAF8200T5E | UNI-ROYAL(Uniroyal Elec) | Basic | 816705 | 0.0015 | 2026-11-12
C25803 | 0603WAF1003T5E | UNI-ROYAL(Uniroyal Elec) | Basic | 15164033 | 0.0029 | 2026-11-12
C21190 | 0603WAF1001T5E | UNI-ROYAL(Uniroyal Elec) | Basic | 28789585 | 0.0017 | 2026-11-12
C25804 | 0603WAF1002T5E | UNI-ROYAL(Uniroyal Elec) | Basic | 42855148 | 0.0022 | 2026-11-12
C98220 | RC0603FR-0710KL | YAGEO | Extended | 11771816 | 0.0023 | 2026-11-12
C14675 | RC0603FR-07100KL | YAGEO | Extended | 10800277 | 0.0021 | 2026-11-12
C132649 | RC1206FR-0710KL | YAGEO | Extended | 3331406 | 0.0088 | 2026-11-12
C114638 | RC0603FR-07820RL | YAGEO | Extended | 147774 | 0.0035 | 2026-11-12
C22548 | RC0603FR-071KL | YAGEO | Extended | 13528137 | 0.0036 | 2026-11-12
C307542 | CL21B224KCFSFNE | Samsung Electro-Mechanics | Extended | 29234 | 0.0709 | 2026-11-12
C14663 | CC0603KRX7R9BB104 | YAGEO | Basic | 36487972 | 0.0060 | 2026-11-12
C1591 | CL10B104KB8NNNC | Samsung Electro-Mechanics | Extended | 2337750 | 0.0071 | 2026-11-12
C7471274 | 1210B475K101CT | Walsin Tech Corp | Extended | 1959 | 0.4090 | 2026-11-12
C23264 | 0603WAF9100T5E | UNI-ROYAL(Uniroyal Elec) | Extended | 125890 | 0.0011 | 2026-11-12
