JoanSanbartolome/ESP-Riego/hardware/v2/esp-riego.kicad_pcb

## KiCad design hardware/v2/esp-riego.kicad_pcb (2026-11-14)

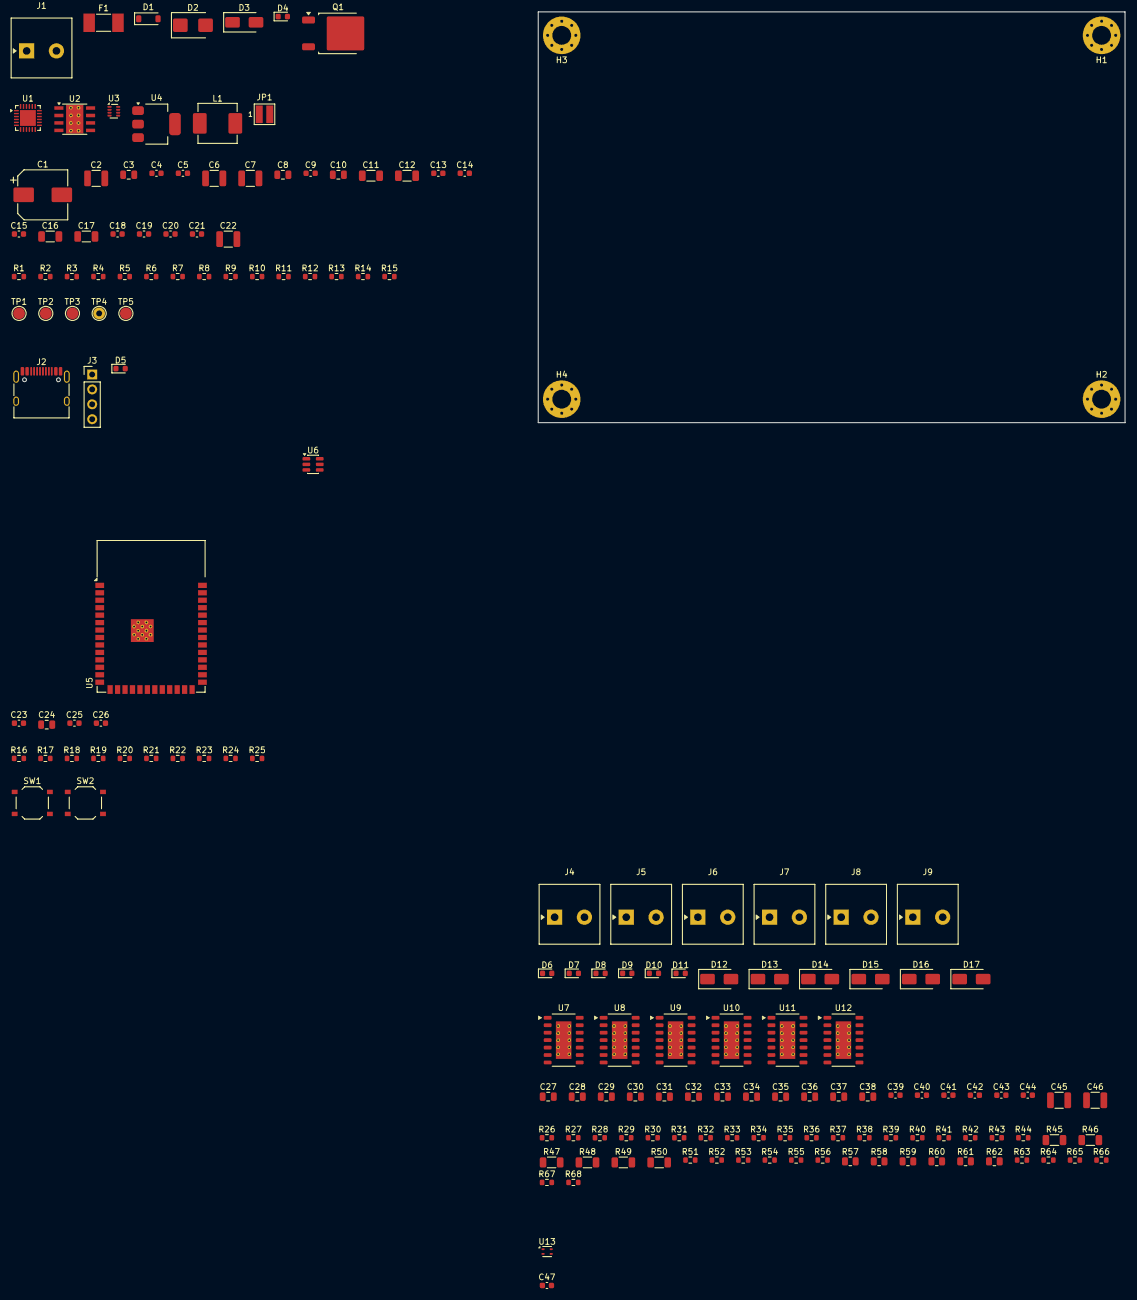
[picture p1: board esp-riego.kicad_pcb from above]

Board: 2 copper layers, 100.0 x 70.0 mm, 169 parts (0 on the bottom side), 82 nets, no tracks yet.

Parts:
C1: 47u 63V; CP_Elec_8x10
C2, C6, C7, C22, C45, C46: 4.7u 100V; C_1210_3225Metric
C3, C8, C27, C28, C29, C30, C31, C32, C33, C34, C35, C36, C37, C38: 220n 100V; C_0805_2012Metric
C4: 22n; C_0603_1608Metric
C5, C9, C13, C14, C20, C21, C39, C40, C41, C42, C43, C44, C47: 100n; C_0603_1608Metric
C10: 1u 50V; C_0805_2012Metric
C11, C12, C16, C17: 22u 25V; C_1206_3216Metric
C15: 1u; C_0603_1608Metric
C18, C19: 10u; C_0603_1608Metric
C23: 1uF; C_0603_1608Metric
C24: 22uF; C_0805_2012Metric
C25: 100nF; C_0603_1608Metric
C26: 4.7uF; C_0603_1608Metric
D1: BZT52C15; D_SOD-123
D2: SMBJ33A; D_SMB
D3: SS310; D_SMA
D4, D6, D7, D8, D9, D10, D11: Rojo; LED_0603_1608Metric
D5: LED; LED_0603_1608Metric
D12, D13, D14, D15, D16, D17: M7; D_SMA
F1: 10A; Fuse_Littelfuse-NANO2-451_453
H1, H2, H3, H4: MountingHole; MountingHole_3.2mm_M3_Pad_Via
J1, J4, J5, J6, J7, J8, J9: WJ500V-5.08-2P; TerminalBlock_Kangnex_WJ500V-5.08-2P_1x02_P5.08mm_Horizontal
J2: USB_C_Receptacle_USB2.0_16P; USB_C_Receptacle_HRO_TYPE-C-31-M-12
J3: Conn_01x04; PinHeader_1x04_P2.54mm_Vertical
JP1: Puente U1; SolderJumper-2_P1.8mm_Open_Pad1.2x3.0mm
L1: 10u; L_Changjiang_FXL0650
Q1: SQD50P06-15L; TO-252-2
R1, R9, R12, R32, R33, R34, R35, R36, R37, R44: 100k; R_0603_1608Metric
R2: 4.3k; R_0603_1608Metric
R3, R4, R5, R6, R10, R16, R17, R26, R27, R28, R29, R30, R31, R38, R39, R40, R41, R42, R43: 10k; R_0603_1608Metric
R7, R14: 100k 0.1%; R_0603_1608Metric
R8: 24.9k 0.1%; R_0603_1608Metric
R11: 330k; R_0603_1608Metric
R13, R23, R63, R64, R65, R66, R67, R68: 1k; R_0603_1608Metric
R15: 4.87k 0.1%; R_0603_1608Metric
R18, R19: 5k1; R_0603_1608Metric
R20, R21: 22; R_0603_1608Metric
R22: 470; R_0603_1608Metric
R24, R25: 4k7; R_0603_1608Metric
R45, R46, R47, R48, R49, R50: 10k; R_1206_3216Metric
R51, R52, R53, R54, R55, R56: 820; R_0603_1608Metric
R57, R58, R59, R60, R61, R62: 47k; R_0805_2012Metric
SW1, SW2: SW_Push; SW_Push_1P1T_XKB_TS-1187A
TP1: VIN_PROT; TestPoint_Pad_D2.0mm
TP2: +5V; TestPoint_Pad_D2.0mm
TP3: +3V3; TestPoint_Pad_D2.0mm
TP4: GND; TestPoint_THTPad_D2.0mm_Drill1.0mm
TP5: BUS_24V; TestPoint_Pad_D2.0mm
U1: TPS26632RGER; Texas_RGE0024H_VQFN-24-1EP_4x4mm_P0.5mm_EP2.7x2.7mm
U2: LMR36520FADDAR; Texas_DDA0008B_HTSOP-8-1EP_3.9x4.9mm_P1.27mm_EP2.95x4.9mm_M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
U3: TPS2116DRLR; SOT-583-8
U4: TLV1117LV33DCYR; SOT-223-3_TabPin2
U5: ESP32-S3-WROOM-1-N8; ESP32-S3-WROOM-1
U6: USBLC6-2SC6; SOT-23-6
U7, U8, U9, U10, U11, U12: BTT6050-1ERA; Infineon_PG-TDSO-14_8.65x3.9mm_P1.27mm_EP2.65x6.4mm
U13: SHT40-AD1B-R3; Sensirion_DFN-4_1.5x1.5mm_P0.8mm_SHT4x_NoCentralPad

Connections:
+3V3: C19.1, C21.1, C24.1, C25.1, C47.1, J3.1, R6.1, R13.1, R16.1, R17.1, R24.1, R25.1, TP3.1, U4.2, U5.2, U13.3
+5V: C16.1, C17.1, C18.1, TP2.1, U3.2, U3.7, U4.3
/Alimentacion/+5V_BUCK: C11.1, C12.1, C14.1, L1.2, R7.1, R11.1, U3.3, U3.5
/Alimentacion/EN_BUCK: C13.1, R9.2, R10.1, U2.3
/Alimentacion/Q1_G: D1.2, Q1.1, R1.1
/Alimentacion/U1_DVDT: C4.1, U1.9
/Alimentacion/U1_ILIM: R2.1, U1.10
/Alimentacion/U1_IMON: R3.1, R4.1, U1.13
/Alimentacion/U2_BOOT: C9.1, U2.7
/Alimentacion/U2_FB: R7.2, R8.1, U2.5
/Alimentacion/U2_SW: C9.2, L1.1, U2.8
/Alimentacion/U2_VCC: C10.1, U2.6
/Alimentacion/U3_PR1: R11.2, R12.1, U3.4
/Alimentacion/VIN_F: F1.2, Q1.2
/Alimentacion/VIN_PROT: C1.1, C2.1, C3.1, C7.1, C8.1, C22.1, D1.1, D2.1, JP1.1, Q1.3, R9.1, R14.1, TP1.1, U1.1, U1.2, U1.5, U2.2
/Alimentacion/VIN_RAW: F1.1, J1.1
/BUS_24V: C6.1, C27.1, C28.1, C29.1, C30.1, C31.1, C32.1, C45.1, C46.1, D3.1, JP1.2, R57.1, R58.1, R59.1, R60.1, R61.1, R62.1, TP5.1, U1.17, U1.18, U7.15, U8.15, U9.15, U10.15, U11.15, U12.15
/I2C_SCL: R25.2, U5.35, U13.2
/I2C_SDA: R24.2, U5.34, U13.1
/IN1: R26.1, R32.1, R63.1, U5.19
/IN2: R27.1, R33.1, R64.1, U5.20
/IN3: R28.1, R34.1, R65.1, U5.21
/IN4: R29.1, R35.1, R66.1, U5.8
/IN5: R30.1, R36.1, R67.1, U5.9
/IN6: R31.1, R37.1, R68.1, U5.10
/IS1: C39.1, R45.2, R51.1, U5.4
/IS2: C40.1, R46.2, R52.1, U5.5
/IS3: C41.1, R47.2, R53.1, U5.6
/IS4: C42.1, R48.2, R54.1, U5.7
/IS5: C43.1, R49.2, R55.1, U5.12
/IS6: C44.1, R50.2, R56.1, U5.17
/LIM_EN: R5.1, U1.12, U5.23
/LIM_FLT: R6.2, U1.14, U5.22
/LIM_IMON: C5.1, R4.2, U5.38
/MCU/BOOT: R17.2, SW2.1, U5.27
/MCU/CC1: J2.A5, R18.1
/MCU/CC2: J2.B5, R19.1
/MCU/EN: C23.1, R16.2, SW1.1, U5.3
/MCU/LED_A: D5.2, R23.2
/MCU/LED_STATUS: R23.1, U5.33
/MCU/TXD0: R22.1, U5.37
/MCU/UART_RX: J3.3, U5.36
/MCU/UART_TX: J3.2, R22.2
/MCU/USB_DM: R21.2, U5.13
/MCU/USB_DM_C: J2.A7, J2.B7, R21.1, U6.3, U6.4
/MCU/USB_DP: R20.2, U5.14
/MCU/USB_DP_C: J2.A6, J2.B6, R20.1, U6.1, U6.6
/OUT_DEN: R38.1, R39.1, R40.1, R41.1, R42.1, R43.1, R44.1, U5.31
/Salidas/DEN1_HS: R38.2, U7.5
/Salidas/DEN2_HS: R39.2, U8.5
/Salidas/DEN3_HS: R40.2, U9.5
/Salidas/DEN4_HS: R41.2, U10.5
/Salidas/DEN5_HS: R42.2, U11.5
/Salidas/DEN6_HS: R43.2, U12.5
/Salidas/IN1_HS: R26.2, U7.4
/Salidas/IN2_HS: R27.2, U8.4
/Salidas/IN3_HS: R28.2, U9.4
/Salidas/IN4_HS: R29.2, U10.4
/Salidas/IN5_HS: R30.2, U11.4
/Salidas/IN6_HS: R31.2, U12.4
/Salidas/IS1_HS: R45.1, U7.6
/Salidas/IS2_HS: R46.1, U8.6
/Salidas/IS3_HS: R47.1, U9.6
/Salidas/IS4_HS: R48.1, U10.6
/Salidas/IS5_HS: R49.1, U11.6
/Salidas/IS6_HS: R50.1, U12.6
/Salidas/LED1_A: D6.2, R63.2
/Salidas/LED2_A: D7.2, R64.2
/Salidas/LED3_A: D8.2, R65.2
/Salidas/LED4_A: D9.2, R66.2
/Salidas/LED5_A: D10.2, R67.2
/Salidas/LED6_A: D11.2, R68.2
/Salidas/OUT1: C33.1, D12.1, J4.1, R57.2, U7.10, U7.11, U7.12
/Salidas/OUT2: C34.1, D13.1, J5.1, R58.2, U8.10, U8.11, U8.12
/Salidas/OUT3: C35.1, D14.1, J6.1, R59.2, U9.10, U9.11, U9.12
/Salidas/OUT4: C36.1, D15.1, J7.1, R60.2, U10.10, U10.11, U10.12
/Salidas/OUT5: C37.1, D16.1, J8.1, R61.2, U11.10, U11.11, U11.12
/Salidas/OUT6: C38.1, D17.1, J9.1, R62.2, U12.10, U12.11, U12.12
/VBUS: C15.1, C26.1, J2.A4, J2.A9, J2.B4, J2.B9, U3.6, U6.5
/VIN_SENSE: C20.1, R14.2, R15.1, U5.39
GND: C1.2, C2.2, C3.2, C4.2, C5.2, C6.2, C7.2, C8.2, C10.2, C11.2, C12.2, C13.2, C14.2, C15.2, C16.2, C17.2, C18.2, C19.2, C20.2, C21.2, C22.2, C23.2, C24.2, C25.2, C26.2, C27.2, C28.2, C29.2, C30.2, C31.2, C32.2, C33.2, C34.2, C35.2, C36.2, C37.2, C38.2, C39.2, C40.2, C41.2, C42.2, C43.2, C44.2, C45.2, C46.2, C47.2, D2.2, D3.2, D4.1, D5.1, D6.1, D7.1, D8.1, D9.1, D10.1, D11.1, D12.2, D13.2, D14.2, D15.2, D16.2, D17.2, J1.2, J2.A1, J2.A12, J2.B1, J2.B12, J2.SH, J3.4, J4.2, J5.2, J6.2, J7.2, J8.2, J9.2, R1.2, R2.2, R3.2, R5.2, R8.2, R10.2, R12.2, R15.2, R18.2, R19.2, R32.2, R33.2, R34.2, R35.2, R36.2, R37.2, R44.2, R51.2, R52.2, R53.2, R54.2, R55.2, R56.2, SW1.2, SW2.2, TP4.1, U1.6, U1.7, U1.8, U1.15, U1.25, U2.1, U2.9, U3.1, U4.1, U5.1, U5.40, U5.41, U6.2, U7.3, U8.3, U9.3, U10.3, U11.3, U12.3, U13.4
unnamed: D4.2, R13.2
