JoanSanbartolome/ESP-Riego/hardware/v1-tfg/Control_De_Riego.kicad_pcb

## KiCad design hardware/v1-tfg/Control_De_Riego.kicad_pcb (2026-11-04)

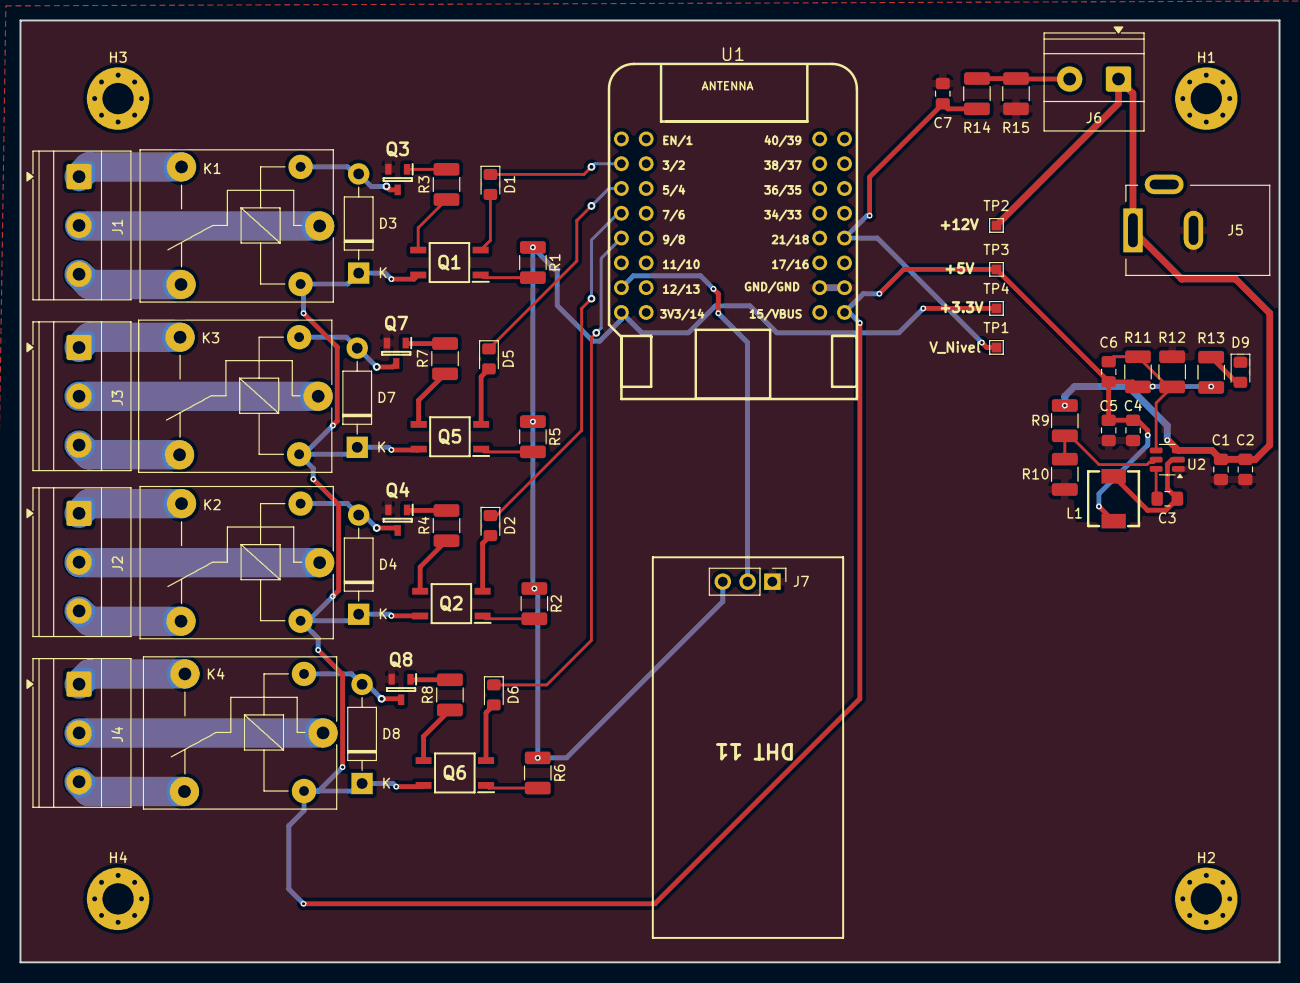
[picture p2: board Control_De_Riego.kicad_pcb from above]

Board: 2 copper layers, 129.0 x 96.5 mm, 61 parts (0 on the bottom side), 48 nets.

Parts:
C1: 10uF; C_0805_2012Metric_Pad1.18x1.45mm_HandSolder
C2, C3, C7: 100nF; C_0805_2012Metric_Pad1.18x1.45mm_HandSolder
C4, C5: 22uF; C_0805_2012Metric_Pad1.18x1.45mm_HandSolder
C6: 68pF; C_0805_2012Metric_Pad1.18x1.45mm_HandSolder
D1, D2, D5, D6: Red; LED_0805_2012Metric_Pad1.15x1.40mm_HandSolder
D3, D4, D7, D8: 1N4007; D_DO-41_SOD81_P10.16mm_Horizontal
D9: Green; LED_0805_2012Metric_Pad1.15x1.40mm_HandSolder
H1, H2, H3, H4: MountingHole; MountingHole_3.2mm_M3_Pad_Via
J1: Conector Rele 1; TerminalBlock_Phoenix_MKDS-1,5-3_1x03_P5.00mm_Horizontal
J2: Conector Rele 3; TerminalBlock_Phoenix_MKDS-1,5-3_1x03_P5.00mm_Horizontal
J3: Conector Rele 2; TerminalBlock_Phoenix_MKDS-1,5-3_1x03_P5.00mm_Horizontal
J4: Conector Rele 4; TerminalBlock_Phoenix_MKDS-1,5-3_1x03_P5.00mm_Horizontal
J5: DC Jack; BarrelJack_Kycon_KLDX-0202-xC_Horizontal
J6: Conn_01x02; TerminalBlock_Phoenix_MKDS-1,5-2_1x02_P5.00mm_Horizontal
J7: Conn_01x03; PinHeader_1x03_P2.54mm_Vertical
K1, K2, K3, K4: SANYOU_SRD_Form_C; Relay_SPDT_SANYOU_SRD_Series_Form_C
L1: 22uH; IND-SMD_L5.5-W5.2
Q1, Q2, Q5, Q6: PS2705-1-F3-A; SOP254P700X230-4N
Q3, Q4, Q7, Q8: BC817-25-7-F; SOT96P240X110-3N
R1, R2, R5, R6: 50; R_1210_3225Metric_Pad1.30x2.65mm_HandSolder
R3, R4, R7, R8: 1k; R_1210_3225Metric_Pad1.30x2.65mm_HandSolder
R9, R14: 270k; R_1210_3225Metric_Pad1.30x2.65mm_HandSolder
R10: 33k; R_1210_3225Metric_Pad1.30x2.65mm_HandSolder
R11: 100k; R_1210_3225Metric_Pad1.30x2.65mm_HandSolder
R12: 13k; R_1210_3225Metric_Pad1.30x2.65mm_HandSolder
R13: 180; R_1210_3225Metric_Pad1.30x2.65mm_HandSolder
R15: 150; R_1210_3225Metric_Pad1.30x2.65mm_HandSolder
TP1, TP2, TP3, TP4: TestPoint; TestPoint_Pad_1.0x1.0mm
U1: WEMOS-S2-MINI (ESP32-S2FN4R2); WEMOS-S2-MINI
U2: TPS54202DDC; SOT-23-6

Connections:
+3.3V: J7.3, R1.1, R2.1, R5.1, R6.1, TP4.1, U1.15 (3V3)
+5V: C4.1, C5.1, C6.1, D3.1 (K), D4.1 (K), D7.1 (K), D8.1 (K), K1.5, K2.5, K3.5, K4.5, L1.2, Q1.4 (C), Q2.4 (C), Q5.4 (C), Q6.4 (C), R11.1, R13.1, TP3.1, U1.18 (VBUS)
+12V: C1.1, C2.1, J5.1, J6.1, R9.2, TP2.1, U2.3 (VIN)
/Modulo_reles/IN_REL1: J1.2, K1.1
/Modulo_reles/IN_REL2: J3.2, K3.1
/Modulo_reles/IN_REL3: J2.2, K2.1
/Modulo_reles/IN_REL4: J4.2, K4.1
/Modulo_reles/NC_REL1: J1.3, K1.4
/Modulo_reles/NC_REL2: J3.3, K3.4
/Modulo_reles/NC_REL3: J2.3, K2.4
/Modulo_reles/NC_REL4: J4.3, K4.4
/Modulo_reles/NO_REL1: J1.1, K1.3
/Modulo_reles/NO_REL2: J3.1, K3.3
/Modulo_reles/NO_REL3: J2.1, K2.3
/Modulo_reles/NO_REL4: J4.1, K4.3
GND: C1.2, C2.2, C4.2, C5.2, C7.2, D9.1 (K), J5.2, J7.1, Q3.2, Q4.2, Q7.2, Q8.2, R10.2, R12.1, R15.2, U1.19 (GND), U1.20 (GND), U2.1 (GND)
unnamed: D1.2 (A), Q1.2 (KA)
unnamed: D2.2 (A), Q2.2 (KA)
unnamed: D3.2 (A), K1.2, Q3.3
unnamed: D4.2 (A), K2.2, Q4.3
unnamed: D5.2 (A), Q5.2 (KA)
unnamed: D6.2 (A), Q6.2 (KA)
unnamed: D7.2 (A), K3.2, Q7.3
unnamed: D8.2 (A), K4.2, Q8.3
unnamed: D9.2 (A), R13.2
unnamed: J6.2, R14.2, R15.1
unnamed: Q1.1 (AK), R1.2
unnamed: Q1.3 (E), R3.1
unnamed: Q2.1 (AK), R2.2
unnamed: Q2.3 (E), R4.1
unnamed: Q3.1, R3.2
unnamed: Q4.1, R4.2
unnamed: Q5.1 (AK), R5.2
unnamed: Q5.3 (E), R7.1
unnamed: Q6.1 (AK), R6.2
unnamed: Q6.3 (E), R8.1
unnamed: Q7.1, R7.2
unnamed: Q8.1, R8.2
unnamed: C3.1, U2.6 (BOOT)
unnamed: R9.1, R10.1, U2.5 (EN)
unnamed: C6.2, R11.2, R12.2, U2.4 (FB)
unnamed: C3.2, L1.1, U2.2 (SW)
REL1: D1.1 (K), U1.3 (IO3)
REL2: D5.1 (K), U1.5 (IO5)
REL3: D2.1 (K), U1.7 (IO7)
REL4: D6.1 (K), U1.9 (IO9)
TH_Data: J7.2, U1.13 (IO12)
V_Level: C7.1, R14.1, TP1.1, U1.24 (IO18)
