JoanSanbartolome/ESP-Riego/(commit log)

2026-11-03 docs: plan de diseño y especificaciones de la PCB v2
    - Análisis de la PCB del TFG (v1): ERC/DRC/paridad con KiCad 10 y hallazgos
    - Especificaciones v2: ESP32-S3 soldado, entrada 9-30 V, relés de baja
    tensión, lazo 4-20 mA con fuente de 24 V, montaje SMT en JLCPCB
    - Plan de diseño por fases con hitos y flujo de trabajo en git
    - README, .gitignore y .gitattributes para proyectos KiCad
2026-11-03 spec(SPEC-0001): abrir — sistema de orquestación de agentes
    Registra la decisión DEC-0001 (coordinador + 4 agentes, rama por spec,
    merge validado, hooks de guarda y auditoría), abre SPEC-0001 y registra
    a posteriori el trabajo previo como SPEC-0000 (commit abd45a7).
    Spec: SPEC-0001
    Agente: coordinador
2026-11-03 docs(gestion): manual del sistema, plantillas y checklists
    Manual de roles, ciclo de vida de las specs, convenciones de commits y
    consultas de auditoría. Plantillas de spec, log, informe, decisión y
    ficha de componente. Checklists v1 de esquema, layout, librerías y
    paquete de fabricación.
    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
2026-11-03 chore(herramientas): gestion.py y verificar.py
    - gestion.py: crea specs con el siguiente ID libre y genera TABLERO.md
    y TRAZABILIDAD.md a partir del front matter y de los trailers de git.
    - verificar.py: ERC, DRC y paridad con kicad-cli 10 y resumen por tipo.
    Sobre la copia del proyecto del TFG reproduce la referencia del
    análisis: ERC 1, DRC 40 (1 error, 39 avisos), paridad 77.
    - TABLERO.md y TRAZABILIDAD.md generados (61 requisitos sin cubrir).
    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
2026-11-03 chore(hooks): guardia, auditoría, validación de commits y push con confirmación
    - .claude/hooks/guardia.py (PreToolUse de los agentes): bloquea git de
    escritura y gh, escrituras fuera de la zona de cada agente y comandos
    que modifiquen la carpeta del TFG o la configuración del sistema.
    Falla en cerrado. 62/62 casos de prueba correctos.
    - .claude/hooks/auditoria.py (PostToolUse de los agentes): una línea
    JSONL por acción en gestion/logs/auditoria/. Nunca bloquea.
    - .githooks/commit-msg: formato del asunto y trailers obligatorios
    (Spec/Agente en ramas spec/*, Spec/Validacion en merges a main).
    Activado con core.hooksPath; 4 mensajes incorrectos rechazados.
    - .claude/settings.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
2026-11-03 feat(agentes): definiciones de los 4 agentes y CLAUDE.md
    - ing-esquematicos (Opus, high), ing-layout (Opus, high), jr-conformidad
    (Sonnet, medium) e ing-validacion (Opus, high): rol, zona de escritura,
    dónde mirar, protocolo, contrato de salida, skills útiles y
    prohibiciones. Memoria de proyecto y hooks de guarda y auditoría.
    - ing-validacion solo tiene 74 herramientas MCP de consulta; ningún
    agente tiene la herramienta Agent.
    - CLAUDE.md: convenciones comunes, mapa del repositorio y rol del
    coordinador.
    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
2026-11-03 docs: README y plan de diseño enlazan al sistema de gestión
    README con la organización del trabajo, la estructura nueva, Python 3
    como requisito y la activación de core.hooksPath al clonar. El plan de
    diseño sustituye su flujo de git por un enlace a gestion/README.md.
    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
2026-11-03 chore(gestion): diario del coordinador 2026-11-03
    Estado de SPEC-0001 y pasos pendientes: reiniciar la sesión para cargar
    los agentes, pruebas en vivo, validación VAL-0001-01 y merge.
    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
2026-11-03 test(agentes): pruebas en vivo de esquemáticos, layout y conformidad
    - Los tres agentes se cargan y acceden al MCP de KiCad (backend swig).
    - La guardia bloquea en vivo el `git commit` y la escritura en docs/ de
    jr-conformidad; no quedó ningún commit ni archivo.
    - Los hooks se ejecutan dentro de los subagentes: 6 líneas de auditoría.
    Agente: jr-conformidad
    Log: gestion/logs/SPEC-0001/01-jr-conformidad.md
    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
2026-11-03 fix(hooks): la guardia registra los bloqueos en la auditoría
    Los intentos bloqueados no llegan a PostToolUse, así que no quedaban en
    el registro. guardia.py los anota con ok=false y el motivo en
    `bloqueado`, usando la función registrar() de auditoria.py.
    AUDITORIA_DIR permite probarlo sin escribir en la auditoría real:
    62/62 casos y 30/30 bloqueos registrados.
    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
2026-11-03 val(SPEC-0001): informe VAL-0001-01 — RECHAZADO
    2 hallazgos A (herramientas MCP que escriben en ing-validacion; elusiones
    de la protección del TFG), 9 M y 8 B. Criterio 2 sin cumplir, 4 y 5
    parciales. Incluye el log y la memoria del agente y sus 50 líneas de
    auditoría, con los dos bloqueos en vivo de las 18:36.
    Agente: ing-validacion
    Log: gestion/logs/SPEC-0001/02-ing-validacion.md
    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
2026-11-03 fix(hooks): guardia con rutas reales, envoltorios y MCP
    Corrige VAL-0001-01-02, -04, -05, -06 y -13:
    - resuelve las rutas de verdad (relativas, ~, /c/..., /tmp) siguiendo
    cd, Set-Location y pushd, y aplica las zonas también a las escrituras
    por la terminal (redirecciones, rm, mv, cp, robocopy /MOVE, sed -i,
    Set-Content, tee...), así que .git, .claude, CLAUDE.md y la auditoría
    quedan fuera de toda zona;
    - red de seguridad para git en cualquier posición y análisis de bash -c,
    cmd /c, pwsh -Command, iex, xargs y $(...); bloquea -EncodedCommand y
    git diff/log --output;
    - bloquea python -c / node -e que escriben, las APIs de .NET de archivos
    y kicad-cli o verificar.py sobre el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
2026-11-03 fix(hooks): auditoría de acciones fallidas y del agent_id
    Corrige VAL-0001-01-08 y -15: PostToolUseFailure en settings.json
    (Claude Code lo ejecuta también dentro de los subagentes) registra las
    acciones que fallan con ok:false y el error; el agente sale de
    agent_type y la sesión principal no se registra. Cada línea guarda el
    agent_id, se ignoran las entradas sin herramienta y los saltos de línea
    se marcan con ⏎.
    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
2026-11-03 fix(agentes): herramientas MCP por dominio y validación solo de consulta
    Corrige VAL-0001-01-01, -03, -07 y -16:
    - ing-validacion pierde lint_offgrid y lint_schematic_cosmetic; las 72
    herramientas que conserva se han revisado por sus parámetros (solo
    close_project escribe, y la guarda exige save:false). Protocolo nuevo
    para el MCP: open_project es uso exclusivo de KiCad.
    - disallowedTools por dominio: esquemáticos sin PCB, librerías ni
    fabricación; layout sin esquema ni librerías; conformidad sin rutado,
    colocación ni dibujo del esquema; nadie controla la interfaz gráfica.
    - La guarda cubre también mcp__.* y las definiciones prohíben invocar
    skills fuera de su lista y p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
2026-11-03 fix(herramientas): verificar.py inocuo y commit-msg con el criterio de git
    Corrige VAL-0001-01-09, -10, -11, -12, -14 y -17:
    - verificar.py borra los informes viejos antes de ejecutar, falla si
    kicad-cli falla, restaura los archivos del proyecto que kicad-cli
    toca y se niega a verificar la carpeta del TFG;
    - commit_msg.py lee los trailers con git interpret-trailers (solo el
    bloque final, como la trazabilidad), valida los IDs de Requisitos y
    las rutas de Log, y en los merges a main exige Rama y Validacion de
    la misma spec y el TFG intacto. Batería versionada: 20/20 casos;
    - gestion.py escapa | en las tablas, lee UTF-8 con BOM, avisa de
    requisitos inexistentes y escribe stderr en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
2026-11-03 feat(herramientas): huella del TFG y revisión de zonas
    Capa de detección para lo que la guarda no puede ver (scripts, MCP
    sobre la placa cargada):
    - integridad_tfg.py: huella SHA-256 de los 337 archivos del TFG
    (gestion/tfg-manifiesto.json); commit-msg la verifica en cada merge.
    Antes de tomarla, en esta sesión el TFG solo se ha leído.
    - revisar_zonas.py <agente>: archivos cambiados fuera de la zona del
    agente, con las mismas zonas que la guarda.
    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
2026-11-03 docs(gestion): guardas en dos capas, checklist de proceso y límites
    Corrige VAL-0001-01-18 y documenta los límites de -03 y -04:
    - gestion/README.md: prevención (disallowedTools, guardia, commit-msg,
    push) y detección (auditoría, revisar_zonas, huella del TFG, revisión
    del diff), con sus límites conocidos;
    - checklist proceso.md v1, a partir de la propuesta de VAL-0001-01;
    - CLAUDE.md: revisar_zonas antes de cada commit, baterías al tocar
    hooks, MCP exclusivo también para revisiones, buscar con Grep;
    - docs/03: informe de validación en docs/validacion/;
    - SPEC-0001: entregables nuevos y registro; tablero regenerado.
    Agente: coordinador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
2026-11-03 chore(gestion): diario — VAL-0001-01, correcciones y pendientes
    Añade al diario del 2026-11-03 las pruebas en vivo, el rechazo de
    VAL-0001-01, la corrección de la afirmación falsa sobre las herramientas
    de ing-validacion y los pasos que faltan (reinicio, VAL-0001-02, merge).
    Log: gestion/logs/coordinador/2026-11-03.md
    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
2026-11-03 test(agentes): segunda prueba en vivo de las guardas de jr-conformidad
    Con las definiciones nuevas cargadas:
    - route_trace no está disponible (disallowedTools);
    - la guardia bloquea open_project sobre el TFG y rm -rf ../TFG/x, y los
    dos bloqueos quedan en la auditoría con su motivo;
    - el ls que falla queda registrado por PostToolUseFailure con el error
    y el agent_id;
    - revisar_zonas: todo dentro de su zona; TFG intacto.
    Log: gestion/logs/SPEC-0001/03-jr-conformidad.md
    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
2026-11-03 val(SPEC-0001): informe VAL-0001-02 — RECHAZADO
    De los 19 hallazgos de VAL-0001-01, 15 están corregidos (el 16 por
    documentación), el 03 tiene su límite documentado y el 02, el 04 y el
    18 están solo en parte. Quedan 2 hallazgos A: la guarda del MCP bloquea
    llamadas legítimas (7 de 8 casos P01–P08) y el TFG se puede destruir
    con órdenes naturales y sin copia de seguridad. Un M (redirecciones tras
    git y envoltorios) y 6 B propuestos como specs. Incluye el log, la
    memoria del agente y su auditoría.
    Log: gestion/logs/SPEC-0001/04-ing-validacion.md
    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
2026-11-03 fix(hooks): destinos MCP, lista blanca del TFG y redirecciones primero
    Corrige VAL-0001-02-01, -02, -03, -04, -06 y -07:
    - MCP: la zona solo se comprueba en los argumentos de destino
    (CLAVES_DESTINO); los orígenes de solo lectura, las variables ${…},
    los textos y las etiquetas ya no bloquean. El TFG sigue vetado en
    cualquier argumento. lint_* cuenta como escritura según dryRun/fix.
    - TFG con lista blanca: si un comando lo toca (ruta, cd, redirección o
    tubería, también con nombres 8.3 gracias a realpath), cada parte tiene
    que leer o copiar desde el TFG hacia fuera; lo demás se bloquea.
    - Las redirecciones se comprueban en todos los segmentos, también tras
    git y los envolt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
2026-11-03 fix(agentes): cerrar huecos de dominio en disallowedTools
    Corrige VAL-0001-02-06: batch_move_components (mueve la PCB y guarda)
    queda prohibida para ing-esquematicos y jr-conformidad, y
    set_footprint_type (atributo de la PCB) para jr-conformidad.
    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
2026-11-03 fix(herramientas): commit-msg estricto y auditoría que solo crece
    Corrige VAL-0001-02-05, -08 y -09:
    - commit_msg.py rechaza Spec, Agente, Validacion o Rama repetidos,
    elementos de Requisitos que no son IDs exactos (ALI-011, foo) y Log
    que no está en el commit. Batería: 24/24.
    - revisar_zonas.py avisa de AUDITORÍA ALTERADA si a un archivo
    versionado de gestion/logs/auditoria/ se le quitan o cambian líneas.
    - verificar.py borra sus informes temporales si no se pide --salida;
    integridad_tfg.py escribe stderr en UTF-8; la auditoría guarda los
    valores no textuales del MCP como JSON (booleanos, no "True").
    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
2026-11-03 docs(gestion): guardas tal como son, checklist de proceso v2 y diario
    - gestion/README.md (Guardas): lista blanca del TFG, destinos MCP,
    qué audita y qué no, límites conocidos (variables y concatenación,
    órdenes desconocidas fuera del TFG) y la copia del TFG que mantiene
    el usuario. Corrige VAL-0001-02-09 y el resto de VAL-0001-01-18.
    - proceso.md v2 con las propuestas de VAL-0001-02.
    - CLAUDE.md: cómo se copia desde el TFG.
    - SPEC-0001 y diario: VAL-0001-02, la copia del usuario y la causa de
    la fecha de TFG\.git (git log/status del análisis inicial, sin
    cambios en sus archivos).
    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
2026-11-04 test(agentes): prueba en vivo de ing-esquematicos con su definición nueva
    route_trace, batch_move_components y create_footprint no están
    disponibles; create_project, add_schematic_net_label (+3V3/ADC) y
    add_schematic_text con una ruta en el texto pasan sobre un proyecto en
    la carpeta temporal; add_schematic_text sobre gestion/ queda bloqueado
    y registrado. Cierra VAL-0001-02-10 para este agente.
    Agente: ing-esquematicos
    Log: gestion/logs/SPEC-0001/05-ing-esquematicos.md
    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
2026-11-04 test(agentes): prueba en vivo de ing-layout con su definición nueva
    add_schematic_wire, create_footprint y export_gerbers no están
    disponibles; open_board, add_board_text, save_board y close_project
    pasan sobre una copia de la placa en la carpeta temporal; open_project
    sobre el TFG queda bloqueado y registrado. Cierra VAL-0001-02-10.
    Agente: ing-layout
    Log: gestion/logs/SPEC-0001/06-ing-layout.md
    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
2026-11-04 val(SPEC-0001): informe VAL-0001-03 — APROBADO_CON_OBSERVACIONES
    Los 10 criterios de aceptación se cumplen y los dos hallazgos A de
    VAL-0001-02 están corregidos. Quedan 2 M y 6 B, que se convierten en
    specs propuestas: destinos que la guarda no ve (comodines y tuberías),
    claves de destino del MCP sin comprobar (run_drc reportPath, entre
    otras), falsos positivos, auditoría encadenada, git por variables de
    entorno, ZONAS_MCP sin documentar, prueba en vivo pendiente de
    jr-conformidad y Log con carpetas.
    Log: gestion/logs/SPEC-0001/07-ing-validacion.md
    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
2026-11-04 test(agentes): prueba en vivo de jr-conformidad con su definición actual
    batch_move_components, set_footprint_type y route_trace no están
    disponibles; create_symbol en la carpeta temporal pasa; create_symbol
    en gestion/ queda bloqueado y registrado. Cierra VAL-0001-03-07.
    Log: gestion/logs/SPEC-0001/08-jr-conformidad.md
    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
2026-11-04 spec(SPEC-0002): reducir al mínimo y descartar SPEC-0003
    Por decisión del usuario de no complicar más la orquestación:
    - SPEC-0002 queda reducida a VAL-0001-03-02: añadir a la guarda las
    claves de destino del MCP que faltan (reportPath de run_drc y otras
    seis), con un caso por clave en la batería.
    - SPEC-0003 (auditoría encadenada, falsos positivos, detalles de
    commit-msg) queda descartada. Sus límites siguen documentados en
    gestion/README.md (Guardas).
    Spec: SPEC-0002
    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
2026-11-04 spec(SPEC-0004): abrir — Requisitos v0.2: nuevo objetivo, 6 salidas, 24 V AC y T/HR en placa
    El usuario redefine el objetivo de la placa: interior en caja ventilada,
    transformador de riego de 24 V AC, 6 salidas (3 arriba y 3 abajo), sensor
    de temperatura y humedad en placa y sin sensor de nivel.
    Spec: SPEC-0004
    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
2026-11-04 spec(SPEC-0005): abrir — Estudio de la tecnología de las salidas
    Relé, SSR, triac, MOSFET y high-side switch, con pros, contras y
    limitaciones por tipo de carga. Rama apilada sobre SPEC-0004.
    Spec: SPEC-0005
    Requisitos: REL-01, REL-03, REL-05
    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
2026-11-04 spec(SPEC-0006): proponer — Viabilidad del módulo de expansión de canales
    Queda en propuesta hasta que el usuario la pida; se cierra antes de fijar
    el conector de expansión en el esquema.
    Spec: SPEC-0006
    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
2026-11-04 docs(req): requisitos v0.2 y DEC-0002
    Nuevo objetivo: interior con caja ventilada, transformador de riego de
    24 V AC rectificado (admite 12–36 V DC), 6 salidas repartidas 3 + 3 con
    tecnología por decidir (D8), sensor de temperatura y humedad en placa,
    módulo de expansión (D9) y sin sensor de nivel (NIV-01…08 y AMB-04
    retirados). Plan de diseño y checklists de esquema y layout a v2.
    Requisitos: ALI-01, ALI-02, ALI-03, ALI-04, ALI-06, ALI-09, REL-01, REL-02, REL-03, REL-05, REL-06, REL-08, REL-09, AMB-01, AMB-02, AMB-03, EXP-01, EXP-02, EXP-04, FAB-03, FAB-07, FAB-08, FAB-10, FW-03
    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
2026-11-04 val(SPEC-0004): informe VAL-0004-01 — RECHAZADO
    Hallazgo A: ALI-05 (buck de 60 V) no cubre la Vc de la TVS que exigía
    la entrada de 24 V AC; criterio 2 parcial (falta el motivo en la tabla
    de retirados). 6 hallazgos M y 9 B.
    Validacion: VAL-0004-01
    Log: gestion/logs/SPEC-0004/01-ing-validacion.md
    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
2026-11-04 docs(req): v0.2 con fuente de 24 V DC y correcciones de VAL-0004-01
    El usuario quita la entrada de AC: alimentación única desde una fuente
    de 24 V DC de hasta 5 A (18–30 V), con las 6 salidas activas a la vez y
    un total de 4 A en las salidas alimentadas (ALI-12 nuevo). Vuelve la
    protección de polaridad y el buck ≥ 60 V queda justificado por la Vc de
    la SMBJ33A. T/HR de la caseta con corrección en firmware; corte de la
    fuente visto como «no disponible». Protección por canal de las salidas
    alimentadas (del estudio de SPEC-0005). Corrige los hallazgos 01–16:
    UVLO tras las protecciones, motivo en retirados, diagrama, referencias,
    checklist de requisitos nueva y definición de ing-la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
2026-11-04 docs(req): las electroválvulas instaladas son de 24 V DC
    El usuario aclara que las válvulas instaladas son de 24 V DC, de unos
    0,2 A cada una, y no de 24 V AC. La placa puede alimentarlas
    directamente; el contacto libre queda para cargas con su propia fuente.
    Requisitos: REL-08
    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
2026-11-04 val(SPEC-0004): informe VAL-0004-02 — APROBADO_CON_OBSERVACIONES
    Resueltos los hallazgos de VAL-0004-01 (el 02 deja de aplicar con la
    entrada DC). Cadena DC recalculada y coherente. Quedan 3 M (orden TVS y
    polaridad, cómo se impone el límite de 4 A, SPEC-0005 con válvula AC)
    y 7 B.
    Validacion: VAL-0004-02
    Log: gestion/logs/SPEC-0004/02-ing-validacion.md
    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
2026-11-04 spec(SPEC-0007): proponer — Requisitos v0.3: D8 y observaciones de VAL-0004-02
    Spec: SPEC-0007
    Requisitos: ALI-03, ALI-04, ALI-09, ALI-12, REL-03, REL-05, REL-08, AMB-02, FAB-03, FAB-07, FAB-08
    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
2026-11-04 docs(diseno): estudio de la tecnología de las salidas
    Compara relé estándar y subminiatura, SSR PhotoMOS, triac, MOSFET
    low-side/high-side/bidireccional y high-side switch inteligente frente a
    las cuatro vías de uso de las válvulas (AC con su transformador, 24 V DC,
    latch y AC con PWM), con corrientes, fugas, modo de fallo, tamaño y
    coste en LCSC. Propone relé subminiatura (D8) y salida seleccionable
    (D2); la decisión queda para el usuario.
    Log: gestion/logs/SPEC-0005/01-ing-esquematicos.md
    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
2026-11-04 spec(SPEC-0005): la válvula instalada es de 24 V DC
    Corrige VAL-0004-02-03: la carga instalada pasa a ser la electroválvula
    de 24 V DC de unos 0,2 A; la de 24 V AC queda como carga de contacto libre.
    Requisitos: REL-01, REL-05, REL-08
    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
2026-11-04 docs(diseno): adenda del estudio — válvulas de 24 V DC y elección del high-side
    Evalúa los cuatro chips propuestos por el usuario (VN5050J, BTS428L2,
    TPS281C30, VN5012AK) y alternativas de LCSC dimensionadas para 0,2 A.
    Propone BTT6050-1ERA (segunda fuente BTT6030-2ERA, reserva BSP752R):
    los VN5 tienen 41 V de máximo absoluto frente al recorte de 53,3 V de la
    SMBJ33A, y los demás cuestan más o no cumplen (12 V, entrada activa baja,
    umbral de 3,25 V).
    Requisitos: REL-03, REL-05, REL-08
    Log: gestion/logs/SPEC-0005/02-ing-esquematicos.md
    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
2026-11-04 spec(SPEC-0005): D8 — high-side BTT6050-1ERA completo
    El usuario elige la opción de protección completa del estudio (§11):
    BTT6050-1ERA por canal, BTT6030-2ERA como segunda fuente y BSP752R como
    reserva. Descarta el MOSFET discreto, que ahorraba ~5 $ por placa a cambio
    de perder la protección propia y el diagnóstico. La decisión se formaliza
    en DEC-0003 con SPEC-0007.
    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
2026-11-04 val(SPEC-0005): informe VAL-0005-01 — APROBADO_CON_OBSERVACIONES
    Se cumplen los 6 criterios. 38 códigos LCSC y 24 filas de costes
    comprobados; datos del BTT6050, BTT6030 y BSP752R contra datasheet.
    Queda 1 M (el corto con la fuente de 5 A hunde el bus común y deja menos
    autonomía de la calculada: no adoptar «sin fusible por canal» tal cual)
    y 9 B. VAL-0004-02-03 resuelto.
    Validacion: VAL-0005-01
    Log: gestion/logs/SPEC-0005/03-ing-validacion.md
    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
2026-11-04 spec(SPEC-0007): añadir D8 y las observaciones de VAL-0005-01
    D8 decidida (BTT6050-1ERA completo). Entran los hallazgos 01 (M:
    corto con la fuente de 5 A y autonomía de la lógica), 03, 04, 05, 06 y
    07 de VAL-0005-01.
    Requisitos: ALI-04, ALI-05, ALI-06, ALI-09, ALI-12, MCU-05, REL-03, REL-05, REL-08
    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
2026-11-04 spec(SPEC-0008): proponer — Correcciones menores del estudio de salidas
    Observaciones B de VAL-0005-01 que afectan solo al texto del estudio
    (02, 03, 04, 06, 08, 09 y 10).
    Spec: SPEC-0008
    Requisitos: REL-03, REL-05
    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
2026-11-04 spec(SPEC-0007): abrir — Requisitos v0.3: D8 y observaciones de VAL-0004-02 y VAL-0005-01
    El usuario elige un limitador común en el bus de las salidas para el
    caso de cortocircuito (VAL-0005-01-01).
    Requisitos: ALI-04, ALI-12, REL-03, REL-05, REL-08
    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
2026-11-04 docs(req): requisitos v0.3 — salidas high-side y limitador común
    DEC-0003: D8 (BTT6050-1ERA por canal, segunda fuente BTT6030-2ERA) y
    limitador común del bus de salidas ante un corto (VAL-0005-01-01). D2
    cerrada como solo salida alimentada (interpretación pendiente de que la
    confirme el usuario). Nuevos ALI-13 (limitador) y REL-10 (diagnóstico);
    REL-08 pasa a M. Resuelve las observaciones 01, 02 y 04-10 de
    VAL-0004-02 y 03-07 de VAL-0005-01. Errata 20-28 V AC en DEC-0002.
    Requisitos: ALI-04, ALI-09, ALI-12, ALI-13, REL-01, REL-02, REL-03, REL-04, REL-05, REL-08, REL-10, AMB-02, FAB-03, FAB-06, FAB-07, FAB-08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
2026-11-04 chore(checklists): requisitos v2, esquema v3 y layout v3
    Propuestas de VAL-0004-02 y VAL-0005-01 y requisitos v0.3.
    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
2026-11-04 docs(dec): DEC-0003 — el usuario confirma D2 sin contacto libre
    Requisitos: REL-02, REL-08
    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
2026-11-04 docs(diario): 2026-11-04 — SPEC-0007 abierta, validación aplazada
    Registro de la sesión: DEC-0003, requisitos v0.3 en la rama de
    SPEC-0007 (sin validar por decisión del usuario) y pendientes.
    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
2026-11-04 spec(SPEC-0009): abrir — Importar la v1 del TFG a KiCad 10
    Fase 1: copia de los fuentes del TFG a hardware/v1-tfg, librerías en
    formato nativo con rutas ${KIPRJMOD} y migración a KiCad 10 sin tocar
    el diseño. Criterio: mismas incidencias de ERC, DRC y paridad que el
    análisis de la v1.
    Spec: SPEC-0009
    Requisitos: KIC-01
    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
2026-11-04 feat(v1): proyecto del TFG migrado a KiCad 10 con librerías nativas
    - hardware/v1-tfg: fuentes copiados sin tocar el diseño, tablas con
    ${KIPRJMOD} y formato KiCad 10 (kicad-cli upgrade).
    - hardware/libraries: símbolos y huellas de la v1 con los nicknames
    originales, cajetín y modelos 3D. Wemos extraído de las copias
    embebidas (el JSON de EasyEDA no se convierte); DC-Jack vacía (el
    JSON no trae pads y la PCB usa Connector_BarrelJack).
    ERC 1 y paridad 77 como en el análisis; DRC 39 en lugar de 40 porque la
    huella del Wemos ya coincide con su librería. Netlist y PCB idénticas a
    la copia sin migrar. TFG intacto.
    Log: g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
    [Control_De_Riego.kicad_pcb, Control_De_Riego.kicad_sch, Panel_Control.kicad_sch, allimentacion.kicad_sch, conectores.kicad_sch, modulo_reles.kicad_sch, wemos_s2mini.kicad_sch]
2026-11-04 val(SPEC-0009): VAL-0009-01 — APROBADO_CON_OBSERVACIONES
    Los 7 criterios se cumplen y el diseño no cambia (migración propia
    idéntica, netlist y PCB iguales). M 2 · B 3: el JSON del Wemos y el del
    jack DC sí se convierten con kicad-cli (01, 02); justificaciones del
    log sobre KICAD9_3DMODEL_DIR y los .wrl inexactas (03, 04);
    .gitattributes sin *.igs (05).
    Log: gestion/logs/SPEC-0009/02-ing-validacion.md
    Validacion: VAL-0009-01
    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
2026-11-04 chore(git): modelos 3D IGES y STEP en mayúsculas como binarios
    Transistor.IGS se versionaba como texto (LF en el índice). Se añaden
    *.igs/*.iges y las variantes en mayúsculas de STEP/STP/IGS/IGES, y se
    renormaliza hardware/libraries/3d (VAL-0009-01-05).
    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
2026-11-04 spec(SPEC-0009): cerrar — VAL-0009-01 APROBADO_CON_OBSERVACIONES
    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
2026-11-04 spec(SPEC-0010): proponer — Correcciones de la importación de la v1
    Hallazgos 01–04 de VAL-0009-01: Wemos convertido del JSON o desviación
    aceptada (decide el usuario), huella del jack DC y justificaciones del
    README y del log.
    Spec: SPEC-0010
    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
2026-11-04 spec(SPEC-0010): completar la propuesta con los hallazgos de VAL-0009-01
    El commit anterior salió con la plantilla vacía por un error del
    script de edición.
    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
2026-11-05 val(SPEC-0007): VAL-0007-01 — APROBADO_CON_OBSERVACIONES
    Los 3 criterios se cumplen: las 16 observaciones de VAL-0004-02 y
    VAL-0005-01 resueltas, DEC-0003 reflejada y datos del BTT6050
    comprobados. M 3 · B 7: ventana del limitador sin cerrar (depende de la
    fuente), sobrecarga de 1–4 A en un canal sin corte por hardware, y el
    estudio de salidas recomienda aún lo que DEC-0003 sustituye.
    Requisitos: ALI-12, ALI-13, REL-03, REL-08, REL-10
    Log: gestion/logs/SPEC-0007/01-ing-validacion.md
    Validacion: VAL-0007-01
    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
2026-11-05 docs(dec): erratas de DEC-0003 y de la checklist de esquema v3
    - DEC-0003: REL-02 en ≤ 30 V DC, como docs/02 (VAL-0007-01-04); añade
    AMB-02 y FAB-06 a los requisitos afectados (VAL-0007-01-09).
    - esquema.md v3: historial sin la fila v2 duplicada y protección
    inductiva según DEC-0003 en lugar de diodo/snubber/varistor
    (VAL-0007-01-08).
    Requisitos: REL-02, REL-03, AMB-02, FAB-06
    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
2026-11-05 spec(SPEC-0007): cerrar — VAL-0007-01 APROBADO_CON_OBSERVACIONES
    Requisitos: ALI-13, REL-08
    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
2026-11-05 spec(SPEC-0011): proponer — Requisitos v0.4: ventana del limitador y sobrecarga por canal
    Observaciones 01, 02, 05, 06 y 09 de VAL-0007-01. Se abre cuando el
    usuario dé el modelo de la fuente y decida la protección de un canal en
    sobrecarga. Además, VAL-0007-01-03 entra en SPEC-0008 y
    VAL-0007-01-07 en SPEC-0006.
    Spec: SPEC-0011
    Requisitos: ALI-04, ALI-09, ALI-12, ALI-13, REL-03, REL-05, REL-10, FAB-01
    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
2026-11-05 spec(SPEC-0010): abrir — Correcciones de la importación de la v1
    El usuario elige convertir el JSON de EasyEDA del Wemos (opción a): la
    librería vuelve a ser la del TFG y el DRC vuelve a 40.
    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
2026-11-05 docs(analisis): la PCB de la v1 tiene 36 vías, no 38
    Recuento comprobado por jr-conformidad y por ing-validacion en
    SPEC-0009 (VAL-0009-01).
    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
2026-11-05 lib(v1): Wemos y jack DC convertidos del JSON de EasyEDA con kicad-cli
    - Wemos s2 mini: huella regenerada con `kicad-cli fp upgrade -o` tal
    cual (el símbolo convertido es idéntico al que ya había). El DRC
    vuelve a 40, como en el análisis (VAL-0009-01-01).
    - DC-Jack.pretty: huella convertida del JSON, con el artefacto del
    pad 3 anotado (VAL-0009-01-02).
    - README de hardware/v1-tfg y log de SPEC-0009 corregidos:
    KICAD9_3DMODEL_DIR sí resuelve y KiCad 10 no instala los .wrl
    (VAL-0009-01-03 y 04).
    Log: gestion/logs/SPEC-0010/01-jr-conformidad.md
    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
2026-11-05 val(SPEC-0010): VAL-0010-01 — APROBADO_CON_OBSERVACIONES
    Wemos y jack idénticos (salvo UUID) a una conversión independiente,
    hardware/v1-tfg solo cambia el README, DRC 40 idéntico al análisis y
    TFG intacto. B 2 de documentación: el pad 3 del jack no es un
    artefacto (pad custom con polígono), y el log de SPEC-0009 conserva
    dos afirmaciones superadas.
    Log: gestion/logs/SPEC-0010/02-ing-validacion.md
    Validacion: VAL-0010-01
    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
2026-11-05 spec(SPEC-0010): cerrar — VAL-0010-01 APROBADO_CON_OBSERVACIONES
    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
2026-11-05 spec(SPEC-0012): proponer — Notas de la importación de la v1 y checklist de librerías v2
    Observaciones B de VAL-0010-01 (pad 3 del jack y afirmaciones
    superadas en el log de SPEC-0009) y propuestas de checklist de
    VAL-0009-01 y VAL-0010-01.
    Spec: SPEC-0012
    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
2026-11-05 docs(diario): 2026-11-05 — etiqueta v1.1-tfg
    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
2026-11-05 spec(SPEC-0011): abrir — Requisitos v0.4: ventana del limitador y sobrecarga por canal
    El usuario fija la fuente (LED de 24 V DC y 5 A, sin más datos) y
    descarta la protección de sobrecarga por canal: carga máxima por canal
    como parámetro y dimensionamiento correcto.
    Requisitos: ALI-04, ALI-09, ALI-12, ALI-13, REL-03, REL-05, REL-08, REL-10, FAB-01
    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
2026-11-05 docs(req): requisitos v0.4 — fuente LED de 5 A y carga máxima por canal
    DEC-0004 (decisión del usuario): fuente LED de 24 V y 5 A con los
    parámetros típicos supuestos, y sin protección de sobrecarga por canal.
    - ALI-12/ALI-13: total de las salidas 3,5 A y banda del limitador
    3,5–4,9 A, por debajo de los 5,25 A de la fuente con la lógica.
    - REL-05/REL-08/FAB-09: carga máxima por canal de 1 A como parámetro;
    pistas y bornes de salida para 4,9 A con ΔT ≤ 40 °C.
    - ALI-04 (SMBJ33A frente a la OVP), ALI-09 (avisos a 17 y 31 V),
    REL-03, REL-10 y FAB-01; §6, §7, §8 y §10, y fase 2 de docs/03.
    Resuelve VAL-0007-01-01, 02, 05, 06 y 09.
    Req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
2026-11-05 chore(checklists): requisitos v3, esquema v4 y layout v4
    Propuestas de VAL-0007-01 y requisitos v0.4: umbrales como bandas,
    protecciones escalonadas, parámetros de equipos externos, banda del
    limitador, salidas para la corriente del limitador, LED frente a
    carga abierta y retroalimentación del bus apagado. SPEC-0006: 3,5 A.
    Requisitos: ALI-12, ALI-13, REL-05, REL-10
    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
2026-11-05 val(SPEC-0011): VAL-0011-01 — RECHAZADO
    M 1 · B 8. La banda del limitador y el total de 3,5 A solo valen a
    24 V: ALI-01 permite ajustar la fuente hasta 30 V y su protección de
    sobrecarga va en % de potencia (a 28,8 V no hay banda posible). B:
    retornos GND, enclavamiento térmico del BTT6050, precisión de VIN,
    prueba de un canal, reparto de la lógica, fusible, restos y registro.
    Requisitos: ALI-01, ALI-12, ALI-13
    Log: gestion/logs/SPEC-0011/01-ing-validacion.md
    Validacion: VAL-0011-01
    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
2026-11-05 fix(req): requisitos v0.4 corregidos según VAL-0011-01
    - 01 (M): la fuente se deja en su ajuste de fábrica de 24 V (ALI-01);
    la protección en % de potencia da ≥ 5,15 A a 24,5 V. La carga
    instalada máxima pasa a 3,9 A (12 válvulas a 24,5 V con la bobina a
    −10 °C) y la banda del limitador a 3,9–4,9 A, con la lógica ≤ 0,2 A.
    - B: retornos GND para 4,9 A (FAB-03); enclavamiento térmico del
    high-side (REL-08); precisión ± 3 % de VIN, pruebas fuera de la
    banda y arranque en frío a 17 V (ALI-06/09); prueba de un canal a
    3,8 A con ΔT ≤ 25 °C; consumo de la lógica con prueba y en
    SPEC-0006; fusible y Power_In para 5,1 A a 50 °C; restos en §2 y
    SPEC-0008; regi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
2026-11-05 val(SPEC-0011): VAL-0011-02 — APROBADO_CON_OBSERVACIONES
    Los 9 hallazgos de VAL-0011-01 resueltos y los 3 criterios cumplidos.
    B 4: la carga de 3,9 A aplica dos veces la corrección por frío (la base
    correcta da 3,47 A); 5,14 A y lógica en W; UVLO de bajada para la
    prueba a 16 V; versión de las checklists.
    Requisitos: ALI-06, ALI-12, ALI-13
    Log: gestion/logs/SPEC-0011/02-ing-validacion.md
    Validacion: VAL-0011-02
    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
2026-11-05 fix(req): observaciones de VAL-0011-02 en los requisitos v0.4
    - Carga instalada máxima 3,5 A: 12 × 0,25 A (24 V, 20 °C) a 24,5 V y
    con la bobina a −10 °C = 3,47 A; los 0,28 A ya eran el valor en frío
    (se corrigió dos veces). Banda del limitador 3,5–4,9 A (≈ 4,2 A
    ± 16 %); pruebas a 3,4 y 5,5 A y térmica a 3,5 A.
    - Fuente desde 5,14 A a 24,5 V; lógica ≤ 4,8 W (≤ 0,2 A a 24 V).
    - ALI-06: funcionamiento hasta 15,5 V; prueba a 16 V bajando desde 24 V.
    - Checklists: nota «se ajustó antes del merge» y dos propuestas más.
    Validacion: VAL-0011-02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
2026-11-05 spec(SPEC-0011): cerrar — VAL-0011-02 APROBADO_CON_OBSERVACIONES
    Requisitos: ALI-12, ALI-13
    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
2026-11-05 spec(SPEC-0013): abrir — Copia de trabajo de la v2
    hardware/v2 como copia de v1.1-tfg, con el proyecto renombrado a
    esp-riego, las hojas con los bloques de KIC-02 y el cajetín de la v2,
    sin cambios de diseño. Cada bloque se sustituirá después con su spec.
    Spec: SPEC-0013
    Requisitos: KIC-01, KIC-02
    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
2026-11-05 docs(plan): la v2 avanza bloque a bloque sobre la copia de trabajo
    Forma de trabajo acordada con el usuario: hardware/v2 parte de
    v1.1-tfg y cada bloque es una spec que hace su selección (fase 2) y
    sustituye su hoja (fase 3); el layout se rehace con el esquema estable.
    Requisitos: KIC-02
    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
2026-11-05 feat(v2): copia de trabajo esp-riego a partir de v1.1-tfg
    hardware/v2 con el proyecto renombrado a esp-riego, las hojas
    Alimentacion, MCU, Salidas y Conectores (KIC-02) y el cajetín de la v2.
    Sin cambios de diseño: ERC 1, DRC 40 y paridad 77 como la v1; netlist
    idéntica salvo el prefijo de hoja; PCB con los mismos recuentos.
    Log: gestion/logs/SPEC-0013/01-jr-conformidad.md
    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
    [alimentacion.kicad_sch, conectores.kicad_sch, esp-riego.kicad_pcb, esp-riego.kicad_sch, mcu.kicad_sch, salidas.kicad_sch]
2026-11-05 val(SPEC-0013): VAL-0013-01 — RECHAZADO
    La copia del diseño es exacta (netlist, PCB y verificación iguales a
    la v1). Falla el cajetín: la hoja de dibujo del TFG lleva fijo el
    título del TFG y no muestra TITLE/REVISION (A); comment 1 se pinta como
    «PROYECTO:» (M); rutas de salida a la raíz del repositorio (B).
    Log: gestion/logs/SPEC-0013/02-ing-validacion.md
    Validacion: VAL-0013-01
    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
2026-11-05 spec(SPEC-0013): corregir el alcance del cajetín tras VAL-0013-01
    La spec pedía mantener la hoja de dibujo del TFG y a la vez quitar sus
    restos. Ahora pide una hoja de dibujo propia de la v2 con las variables
    del cajetín, comment 1 = «ESP-Riego v2», rutas de salida en
    fabricacion/v2.0 y la comprobación en el PDF exportado.
    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
2026-11-05 fix(v2): cajetín propio de la v2 y rutas de salida (VAL-0013-01)
    - hardware/libraries/ESP-Riego.kicad_wks: hoja de dibujo derivada de la
    del TFG sin su texto fijo, con TITLE, REVISION, SHEETNAME, COMPANY y
    COMMENT1; Cajetin_Kicad.kicad_wks queda para la v1.
    - esp-riego.kicad_pro apunta a ella; plot, bom_export_filename y step
    vacíos.
    - comment 1 = «ESP-Riego v2» en los 5 esquemas y la PCB.
    Comprobado en los PDF exportados; verificación sin cambios.
    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
    [alimentacion.kicad_sch, conectores.kicad_sch, esp-riego.kicad_pcb, esp-riego.kicad_sch, mcu.kicad_sch, salidas.kicad_sch]
2026-11-05 val(SPEC-0013): VAL-0013-02 — APROBADO_CON_OBSERVACIONES
    Los 3 hallazgos de VAL-0013-01 cerrados y los 5 criterios cumplidos;
    cajetín comprobado en los PDF. B 3: outputdirectory de la PCB a la raíz
    del repositorio, hoja de dibujo del TFG incrustada en la PCB y título
    repetido en el cajetín (comment 1).
    Log: gestion/logs/SPEC-0013/03-ing-validacion.md
    Validacion: VAL-0013-02
    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
2026-11-05 spec(SPEC-0013): cerrar — VAL-0013-02 APROBADO_CON_OBSERVACIONES
    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
2026-11-05 spec(SPEC-0014): abrir — Limpieza de la copia de trabajo de la v2
    Petición del usuario: inicio limpio de hardware/v2. ing-esquematicos
    retira los circuitos de la v1 que no encajan en v0.4 y deja las 4 hojas
    como esqueleto; después ing-layout vacía la PCB con un contorno
    preliminar de 100 × 70 mm. Incluye las observaciones B de VAL-0013-02.
    Checklists esquema v5, layout v5 y fabricación v2 (VAL-0013-01/02).
    En paralelo con SPEC-0015.
    Spec: SPEC-0014
    Requisitos: KIC-02, KIC-03, FAB-02, FAB-08
    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
2026-11-05 spec(SPEC-0015): abrir — Recopilación de componentes de la v2
    Petición del usuario: fichas, datasheets, símbolos, huellas, modelos 3D
    y disponibilidad en JLCPCB de los componentes ya decididos o
    candidatos. En paralelo con SPEC-0014: no toca hardware/v2 ni carga
    proyectos en el MCP. Checklist de librerías v2 (propuestas de
    VAL-0009-01 y VAL-0010-01, antes en SPEC-0012).
    Spec: SPEC-0015
    Requisitos: MCU-01, MCU-03, REL-03, ALI-04, ALI-13, AMB-01, FAB-05, FAB-07, KIC-01
    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
2026-11-05 feat(sch): esquema de la v2 limpio, con las 4 hojas como esqueleto
    Retirados los 57 componentes de la v1 que no encajan en v0.4 (Wemos,
    relés, PS2705, BC817, 1N4007, TPS54202, jack, 4–20 mA, DHT11, bornes
    de 5,00 mm, LED y test points sin MPN) con sus cables, etiquetas y
    símbolos de alimentación. Se conservan H1–H4 (M3, FAB-08). Cada hoja
    lleva su bloque pendiente y sus requisitos, y comment 1 con su
    descripción. ERC 0 errores y 0 avisos.
    Requisitos: KIC-02, KIC-03, FAB-08
    Log: gestion/logs/SPEC-0014/01-ing-esquematicos.md
    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
    [alimentacion.kicad_sch, conectores.kicad_sch, esp-riego.kicad_sch, mcu.kicad_sch, salidas.kicad_sch]
2026-11-05 feat(pcb): PCB de la v2 vacía con contorno preliminar de 100 × 70 mm
    Sincronizada con el esquema limpio: retiradas las 57 huellas, pistas,
    vías, zonas y textos de la v1; quedan H1–H4 en las esquinas. Contorno
    preliminar marcado en User.Comments. Reglas de FAB-02 y solo la clase
    Default en el proyecto. Sin outputdirectory ni la hoja del TFG
    incrustada (VAL-0013-02-01/02). ERC 0, DRC 0 y paridad 0.
    Requisitos: KIC-03, FAB-02, FAB-08
    Log: gestion/logs/SPEC-0014/02-ing-layout.md
    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
    [esp-riego.kicad_pcb]
2026-11-05 val(SPEC-0014): VAL-0014-01 — APROBADO_CON_OBSERVACIONES
    Los 6 criterios se cumplen: verificación LIMPIA, inventario de 57
    retirados cotejado con la netlist de partida, H1–H4 justificados,
    contorno y reglas de FAB-02, cajetín en PDF. B 2: dos frases de los
    textos de bloque describen mal la v1, y las tablas de librerías de
    hardware/v2 aún listan las de la v1.
    Log: gestion/logs/SPEC-0014/03-ing-validacion.md
    Validacion: VAL-0014-01
    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
2026-11-05 spec(SPEC-0014): cerrar — VAL-0014-01 APROBADO_CON_OBSERVACIONES
    Requisitos: KIC-02, KIC-03
    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
2026-11-05 lib(v2): recopilación de componentes de la v2
    - 11 fichas en hardware/componentes/ (ESP32-S3-WROOM-1, USBLC6-2SC6,
    TYPE-C-31-M-12, BTT6050-1ERA, BTT6030-2ERA, BSP752R, SMBJ33A,
    TPS2663, LM5069, SHT4x, WJ500V-5.08-2P) con LCSC, stock y precio a
    5 y 10 placas, y 10 datasheets.
    - hardware/libraries/esp-riego: símbolos BTT6050/BTT6030/BSP752R,
    huellas PG-TDSO-14 (land pattern IPC-7351 derivado) y WJ500V; 3D en
    .step. El resto se cita de la librería oficial de KiCad 10.
    - 3D de respaldo del USB-C (demos de KiCad) y del SHT4x (simplificado):
    los oficiales no existen en kicad-packages3D.
    Hecho en paralelo con SPEC-0014; sus líneas de auditoría quedaron en
    la rama de SPEC-0014.
    Spe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
2026-11-05 val(SPEC-0015): VAL-0015-01 — APROBADO_CON_OBSERVACIONES
    Los 4 criterios se cumplen; símbolos BTT6050/BTT6030/BSP752R correctos
    pin a pin; referencias oficiales y datos de LCSC comprobados. M 3:
    Infineon publica el land pattern del PG-TDSO-14-11 (difiere del
    derivado), pin 1 del 3D del TDSO junto al pad 7, y la patilla del
    borne está a 4,50 mm de la cara trasera. B 7: marcas de pin 1, altura
    del SHT4x, fichas, taladro de 1,2 mm y campo Value de los BTT.
    Requisitos: REL-03, FAB-07, KIC-01
    Log: gestion/logs/SPEC-0015/02-ing-validacion.md
    Validacion: VAL-0015-01
    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
2026-11-05 docs(dec): DEC-0005 — ahorro de tokens en el ciclo de las specs
    Decisión del usuario (medidas 1, 2, 3 y 6): validación por niveles
    (ligero con Sonnet para texto y revalidaciones, completo con Opus para
    piezas, esquema, layout y fabricación), revisión de la spec antes de
    encargar y repaso de la checklist por el autor, spec de mantenimiento
    por fase para las observaciones, y ediciones del coordinador sin
    agente. Aplicada en gestion/README.md, CLAUDE.md y los agentes.
    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
2026-11-05 fix(lib): correcciones de VAL-0015-01 y modelos 3D de SolidCraft
    - M01: huella PG-TDSO-14 con el land pattern oficial de Infineon
    (PG-TDSO-14-11): pads 1,34 × 0,65 en x = ±2,73, pasta del pad
    térmico en 2 × (2,45 × 2,95).
    - M03/B04/B09: borne WJ500V con el cuerpo de y = −5,5 a +4,5 (patilla a
    4,50 mm de la cara trasera), pin 1 y entrada de cable marcados,
    taladro 1,3 mm.
    - M02/B05: STEP del PG-TDSO-14, del WJ500V y del SHT4x (0,54 mm)
    generados con SolidCraft por un subagente modelador, con marca de
    pin 1 y alineados con sus huellas; fuentes en 3d/fuentes-solidcraft.
    - B06/B07/B08/B10: fichas (7 bornes y datasheets de ST y Littelfuse
    confirmados por el usuario; SHT4x V7.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
2026-11-05 val(SPEC-0015): VAL-0015-02 — APROBADO_CON_OBSERVACIONES
    Revalidación ligera (DEC-0005): los 10 hallazgos de VAL-0015-01
    cerrados (huella TDSO con el land pattern de Infineon, 3D alineados con
    pin 1, borne según la sección A-A). B 2: INFORME.md de las fuentes de
    SolidCraft desactualizado y numeración de pines apilados de los BTT.
    Requisitos: REL-03, AMB-01, FAB-07, KIC-01
    Log: gestion/logs/SPEC-0015/03-ing-validacion.md
    Validacion: VAL-0015-02
    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
2026-11-05 spec(SPEC-0015): cerrar — VAL-0015-02 APROBADO_CON_OBSERVACIONES
    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
2026-11-05 chore(checklists): librerías v3, proceso v3 y fabricación v3; SPEC-0016
    - Propuestas de VAL-0014-01 y VAL-0015-01 (y pendientes de VAL-0009-01
    y VAL-0013-01) aplicadas por el coordinador sin agente (DEC-0005).
    - SPEC-0016 propuesta: mantenimiento de las fases 0–2. Agrupa SPEC-0008
    y SPEC-0012 (descartadas) y las observaciones B de VAL-0015-02.
    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
2026-11-05 spec(SPEC-0016): proponer — Mantenimiento de las fases 0 a 2
    Agrupa SPEC-0008 y SPEC-0012 (descartadas) y las observaciones B de
    VAL-0015-02 y de SPEC-0014 (DEC-0005). Responsables: ing-esquematicos
    (estudio de salidas) y después jr-conformidad (notas y librerías). El
    commit b3f0b16 la anunciaba, pero su creación había fallado.
    Spec: SPEC-0016
    Requisitos: REL-03, REL-05, KIC-01
    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
2026-11-05 chore(agentes): brevedad en agentes, log y coordinador; DEC-0005 medida 8
    - Sección «Brevedad» en las cuatro definiciones de agente: respuesta
    final solo con el contrato de salida; logs e informes telegráficos.
    - Plantilla del log en estilo telegráfico.
    - CLAUDE.md: recordatorio de sesión nueva o compactar tras cada merge,
    y respuestas cortas del coordinador.
    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
2026-11-05 spec(SPEC-0016): abrir — Mantenimiento de las fases 0 a 2
    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
2026-11-05 docs(SPEC-0016): correcciones del estudio de salidas (alcance de SPEC-0008)
    Log: gestion/logs/SPEC-0016/01-ing-esquematicos.md
    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
2026-11-05 fix(SPEC-0016): notas de la v1, cajetín, pines apilados e INFORME 3D
    Alcance de SPEC-0012, VAL-0015-02-01 y 02, y la casilla del cajetín.
    Log: gestion/logs/SPEC-0016/02-jr-conformidad.md
    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
2026-11-05 val(SPEC-0016): VAL-0016-01 — APROBADO_CON_OBSERVACIONES
    Log: gestion/logs/SPEC-0016/03-ing-validacion.md
    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
2026-11-05 fix(SPEC-0016): VAL-0016-01-01 a 03 — pines OUT y INFORME 3D
    Log: gestion/logs/SPEC-0016/04-jr-conformidad.md
    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
2026-11-05 val(SPEC-0016): VAL-0016-02 — APROBADO
    Log: gestion/logs/SPEC-0016/05-ing-validacion.md
    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
2026-11-05 spec(SPEC-0016): cerrar — VAL-0016-02 APROBADO
    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
2026-11-05 spec(SPEC-0017..0019): proponer — bloque de alimentación
    Cálculos (SPEC-0017), piezas (SPEC-0018) y hoja (SPEC-0019).
    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
2026-11-05 spec(SPEC-0017): abrir — Selección y cálculos del bloque de alimentación
    Spec: SPEC-0017
    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
2026-11-05 docs(SPEC-0017): selección y cálculos del bloque de alimentación
    Fichas pasan a SPEC-0018 (zona de jr-conformidad).
    Requisitos: ALI-01, ALI-02, ALI-03, ALI-04, ALI-05, ALI-06, ALI-07, ALI-08, ALI-09, ALI-10, ALI-11, ALI-12, ALI-13
    Log: gestion/logs/SPEC-0017/01-ing-esquematicos.md
    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
2026-11-05 docs(DEC-0006): UVLO a 13,5 V y limitador TPS26632 con puente de soldadura
    Requisitos: ALI-06, ALI-12, ALI-13, REL-04, REL-08
    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
2026-11-05 val(SPEC-0017): VAL-0017-01 — APROBADO_CON_OBSERVACIONES
    Log: gestion/logs/SPEC-0017/03-ing-validacion.md
    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
2026-11-05 docs(SPEC-0017): SPEC-0018 recoge JP1 a 0,6 mm y derating (VAL-0017-01)
    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
2026-11-05 fix(SPEC-0017): VAL-0017-01-01 a 04 — JP1 0,6 mm, banda, C5 y fast-trip
    Requisitos: ALI-04, ALI-13
    Log: gestion/logs/SPEC-0017/04-ing-esquematicos.md
    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
2026-11-05 val(SPEC-0017): VAL-0017-02 — APROBADO_CON_OBSERVACIONES
    Log: gestion/logs/SPEC-0017/05-ing-validacion.md
    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
2026-11-05 fix(SPEC-0017): VAL-0017-02-01 a 03 — cifras de la banda y redacción
    Comprobado por el coordinador con Grep («4,19», «8,5 %»: 0).
    Requisitos: ALI-13
    Log: gestion/logs/SPEC-0017/06-ing-esquematicos.md
    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
2026-11-05 spec(SPEC-0017): cerrar — VAL-0017-02 APROBADO_CON_OBSERVACIONES
    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
2026-11-05 spec(SPEC-0018): abrir — Piezas del bloque de alimentación
    Abre también SPEC-0020 (cálculos del MCU, solo texto, en paralelo) y
    propone SPEC-0021 y SPEC-0022.
    Requisitos: ALI-07, MCU-01, MCU-02, MCU-03, MCU-04, MCU-05, MCU-06, MCU-07, KIC-01
2026-11-05 chore(SPEC-0020): memoria de ing-esquematicos (pines del ESP32-S3)
    Spec: SPEC-0018
    Requisitos: MCU-05
    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
2026-11-05 val(SPEC-0018): VAL-0018-01 — RECHAZADO
    Requisitos: ALI-04, ALI-05, ALI-13, KIC-01
    Log: gestion/logs/SPEC-0018/02-ing-validacion.md
    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
2026-11-05 fix(SPEC-0018): VAL-0018-01-01, 02, 06 y 07 — SMBJ33A, huella DDA0008B y JP1
    Log: gestion/logs/SPEC-0018/03-jr-conformidad.md
    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
2026-11-05 fix(SPEC-0018): VAL-0018-01-03, 04 y 05 — CIN de U2, C10 y C3
    Requisitos: ALI-05, ALI-13
    Log: gestion/logs/SPEC-0018/04-ing-esquematicos.md
    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
2026-11-05 val(SPEC-0018): VAL-0018-02 — APROBADO_CON_OBSERVACIONES
    Log: gestion/logs/SPEC-0018/06-ing-validacion.md
    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
2026-11-05 fix(SPEC-0018): VAL-0018-02-01 a 03 — vías de U2, pines de SMBJ33A y filtros
    Requisitos: ALI-04, ALI-05, KIC-01
    Log: gestion/logs/SPEC-0018/07-jr-conformidad.md
    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
2026-11-05 spec(SPEC-0018): cerrar — VAL-0018-02 APROBADO_CON_OBSERVACIONES
    Pasa VAL-0018-02-04 a SPEC-0019.
    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
2026-11-06 docs(SPEC-0020): estudio del bloque MCU y tabla de GPIO
    Borradores copiados por el coordinador desde el scratchpad (la guarda
    bloqueaba la escritura del agente en el worktree).
    Spec: SPEC-0020
    Requisitos: MCU-01, MCU-02, MCU-03, MCU-04, MCU-05, MCU-06, MCU-07, ALI-07
    Log: gestion/logs/SPEC-0020/01-ing-esquematicos.md
    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
2026-11-06 docs(DEC-0007): DEN común y cambios de compra sin consulta
    Requisitos: MCU-05, REL-04, REL-10, EXP-02
    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
2026-11-06 val(SPEC-0020): VAL-0020-01 — APROBADO_CON_OBSERVACIONES
    Log: gestion/logs/SPEC-0020/02-ing-validacion.md
    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
2026-11-06 fix(SPEC-0020): VAL-0020-01-01 a 07 — referencias C23–C26 y retoques
    Requisitos: MCU-02, MCU-03, MCU-04, ALI-07, ALI-08
    Log: gestion/logs/SPEC-0020/03-ing-esquematicos.md
    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
2026-11-06 spec(SPEC-0020): cerrar — VAL-0020-01 APROBADO_CON_OBSERVACIONES
    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
2026-11-06 spec(SPEC-0019): abrir — Hoja de alimentación de la v2
    Spec: SPEC-0019
    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
2026-11-06 feat(SPEC-0019): hoja de alimentación de la v2
    Log: gestion/logs/SPEC-0019/01-ing-esquematicos.md
    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
    [alimentacion.kicad_sch, conectores.kicad_sch, esp-riego.kicad_sch]
2026-11-06 docs(SPEC-0019): ficha del bloque con los cambios de DEC-0007 y LCSC comprobados
    Requisitos: ALI-05, ALI-09
    Log: gestion/logs/SPEC-0019/02-jr-conformidad.md
    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
2026-11-06 val(SPEC-0019): VAL-0019-01 — RECHAZADO
    Requisitos: ALI-12, ALI-13, KIC-01
    Log: gestion/logs/SPEC-0019/03-ing-validacion.md
    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
2026-11-06 spec(SPEC-0019): sincronización con la PCB a cargo de ing-layout
    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
2026-11-06 fix(SPEC-0019): VAL-0019-01-02 y 03 — huella de U1 sin vías y F1 en §3.2
    Requisitos: ALI-13, ALI-04
    Log: gestion/logs/SPEC-0019/04-ing-esquematicos.md
    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
    [alimentacion.kicad_sch]
2026-11-06 chore(SPEC-0019): checklist de esquema v6 — vías de huella conforme a FAB-02
    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
2026-11-06 docs(SPEC-0019): fichas con la huella de U1 sin vías
    Log: gestion/logs/SPEC-0019/06-jr-conformidad.md
    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
2026-11-06 feat(SPEC-0019): 55 huellas de alimentación en la PCB, sin colocar
    Log: gestion/logs/SPEC-0019/05-ing-layout.md
    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
    [esp-riego.kicad_pcb]
2026-11-06 val(SPEC-0019): VAL-0019-02 — APROBADO
    Log: gestion/logs/SPEC-0019/07-ing-validacion.md
    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
2026-11-06 spec(SPEC-0019): cerrar — VAL-0019-02 APROBADO
    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
2026-11-06 spec(SPEC-0021): abrir — Piezas del bloque MCU
    Spec: SPEC-0021
    Requisitos: MCU-01, MCU-02, MCU-03, MCU-04, MCU-05, MCU-06, MCU-07, FAB-02, FAB-11, KIC-01
2026-11-06 spec(SPEC-0023): abrir — Selección y cálculos del bloque de salidas
    Propone además SPEC-0024 (piezas) y SPEC-0025 (hoja) del bloque de salidas.
    Spec: SPEC-0023
    Requisitos: REL-01, REL-03, REL-04, REL-05, REL-06, REL-07, REL-08, REL-09, REL-10
2026-11-06 lib(SPEC-0021): piezas del bloque MCU — huellas, 3D y fichas
    Huella esp-riego:ESP32-S3-WROOM-1 con las vías del EPAD a 0,3/0,6 mm (FAB-02),
    3D del TS-1187A y copias de huella del pulsador y del HRO con su 3D; fichas
    TS-1187A-B-A-B, KT-0603YG y B-2100S04P-A110; ESP32-S3-WROOM-1 con la N8.
    Requisitos: MCU-01, MCU-02, MCU-03, MCU-04, MCU-06, MCU-07, FAB-02, FAB-11, KIC-01
    Log: gestion/logs/SPEC-0021/01-jr-conformidad.md
    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
2026-11-07 val(SPEC-0021): VAL-0021-01 — APROBADO_CON_OBSERVACIONES
    M: polaridad del LED en la ficha y columna Datasheet de la tabla de campos
    (afecta a SPEC-0022, se corrige antes del merge). B: 6.
    Log: gestion/logs/SPEC-0021/02-ing-validacion.md
    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
2026-11-07 fix(SPEC-0021): M de VAL-0021-01 — polaridad del LED y datasheets de la tabla de campos
    Corrige VAL-0021-01-01 y -02; de paso, las B -04, -05, -06 y -08. Incluye la
    auditoría hasta la fecha.
    Log: gestion/logs/SPEC-0021/03-jr-conformidad.md
    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
2026-11-07 spec(SPEC-0021): cerrar — VAL-0021-01 APROBADO_CON_OBSERVACIONES
    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
2026-11-07 spec(SPEC-0022): alcance con lo que trae SPEC-0021
    Spec: SPEC-0022
2026-11-07 docs(SPEC-0023): selección y cálculos del bloque de salidas
    docs/diseno/salidas.md: 6 × BTT6050-1ERA, IS por divisor 10 kΩ / 820 Ω
    (V_ADC ≤ 2,24 V en fallo a 30 V), R_OL 47 kΩ (0,64 mA), E_AS y T_J,
    bornes, restricciones de layout y lista de piezas.
    Log: gestion/logs/SPEC-0023/01-ing-esquematicos.md
    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
2026-11-07 val(SPEC-0023): VAL-0023-01 — APROBADO_CON_OBSERVACIONES
    M: separación de 1 mm de la clase Salidas imposible en las huellas de OUT_n;
    umbral de carga abierta en ON sin margen con la bobina caliente. B: 4.
    Log: gestion/logs/SPEC-0023/02-ing-validacion.md
    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
2026-11-07 fix(SPEC-0023): observaciones de VAL-0023-01 en salidas.md
    M-01: excepción de 0,6 mm de la clase Salidas dentro de U7–U12, R57–R62 y
    C33–C38 (pendiente de DEC). M-02: carga mínima con la bobina caliente
    (84 mA) y umbral de carga abierta en ON de 18 mV, a medir en el prototipo.
    B-03 a B-06 corregidas.
    Requisitos: REL-03, REL-10
    Log: gestion/logs/SPEC-0023/03-ing-esquematicos.md
    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
2026-11-07 spec(SPEC-0023): cerrar — VAL-0023-01 APROBADO_CON_OBSERVACIONES
    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
2026-11-07 spec(SPEC-0022): abrir — Hoja del MCU en el esquema v2
    Requisitos: MCU-01, MCU-02, MCU-03, MCU-04, MCU-05, MCU-06, MCU-07
    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
2026-11-07 feat(SPEC-0022): hoja del MCU en el esquema v2
    21 piezas (U5, U6, J2, J3, SW1, SW2, D5, C23–C26, R16–R25) con los campos
    de SPEC-0021 y las huellas esp-riego:. Raíz con 25 pines y unión con
    Alimentacion. mcu.md: C23 → C15849 (EN/VDD 0,159), D5 → KT-0603R C2286,
    U6 se queda en ST (UMW con V_RWM 5 V < 5,25 V), IS de SPEC-0023.
    ERC 0; paridad pendiente (32) solo por esta hoja, para el paso 2.
    Log: gestion/logs/SPEC-0022/01-ing-esquematicos.md
    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
    [esp-riego.kicad_sch, mcu.kicad_sch]
2026-11-07 feat(SPEC-0022): sincronizar la PCB con la hoja del MCU
    21 huellas nuevas fuera del contorno, sin colocar ni rutar; 11 pads de
    Alimentacion con las redes unidas por la raíz. Cruce pad↔netlist 80/80
    huellas, 0 diferencias. verificar.py: ERC 0, DRC 0 (172 sin conectar por
    no rutar), paridad 0.
    Requisitos: MCU-01, MCU-03
    Log: gestion/logs/SPEC-0022/02-ing-layout.md
    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
    [esp-riego.kicad_pcb]
2026-11-07 val(SPEC-0022): VAL-0022-01 — APROBADO_CON_OBSERVACIONES
    1 M (sin ficha ni polaridad del KT-0603R), 3 B (I_mín de D5, README de
    hardware/v2, conformidad del usuario con D5 rojo).
    Log: gestion/logs/SPEC-0022/03-ing-validacion.md
    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
2026-11-07 fix(SPEC-0022): observaciones 01–03 de VAL-0022-01 en mcu.md y README
    01: §11 y Anexo A remiten a la ficha KT-0603R.md, con la polaridad.
    02: I_mín de D5 en el peor caso (≈ 0,12 mA), R23 = 470 Ω como remedio.
    03: README de hardware/v2 con el estado tras sincronizar la PCB.
    Requisitos: MCU-07
    Log: gestion/logs/SPEC-0022/05-ing-esquematicos.md
    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
2026-11-07 docs(SPEC-0022): ficha del KT-0603R (VAL-0022-01-01)
    C2286 Basic. Polaridad (PDF p. 2): ② = cátodo = pad 1 de LED_0603; la
    marca es la inversa de la del KT-0603YG. Usos: D4, D5 y D6–D11.
    Log: gestion/logs/SPEC-0022/04-jr-conformidad.md
    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
2026-11-07 spec(SPEC-0022): cerrar — VAL-0022-01 APROBADO_CON_OBSERVACIONES
    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
2026-11-08 docs(DEC-0008): LED rojo, rueda libre DNP y separación de 0,6 mm en salidas
    D5 rojo con serigrafía STATUS; D12–D17 sin montar con huella; FAB-03
    (docs/02 v0.5) con 0,6 mm dentro de U7–U12, R57–R62 y C33–C38
    (IPC-2221 B2; FAB-02 ≥ 0,2 mm). SPEC-0024 y SPEC-0025 la recogen.
    Requisitos: MCU-07, REL-03, FAB-02, FAB-03
    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
2026-11-10 spec(SPEC-0024): abrir — Piezas del bloque de salidas
    Vías del EP del BTT6050 a 0,3/0,6 mm en la huella, 3D de todas las piezas,
    ficha del M7 y revisión de las del BTT6050, el borne y D4, tipo y stock con
    fecha, y tabla de campos por referencia para SPEC-0025.
    Spec: SPEC-0024
    Requisitos: REL-01, REL-03, REL-05, REL-07, REL-10, FAB-02, FAB-05, FAB-11, KIC-01
2026-11-10 lib(SPEC-0024): piezas del bloque de salidas — vías del EP del BTT6050 y fichas
    Huella del BTT6050 con 10 vías de 0,3/0,6 mm en el EP (pad 15, BUS_24V),
    cobre inferior y pasta en 10 ventanas (49,6 %). Ficha nueva del M7 (DNP,
    DEC-0008); BTT6050-1ERA con la errata de P_7.5.2, sin R_GND ni zéner en VS
    y distinto pinout del BTT6030; borne con el uso en J1 y J4–J9; D4 con su
    ficha. Tipo y stock de JLCPCB del 2026-11-10 y tabla de campos de las 87
    referencias en el log. Sin cambios de compra (DEC-0007).
    Log: gestion/logs/SPEC-0024/01-jr-conformidad.md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
2026-11-10 val(SPEC-0024): VAL-0024-01 — APROBADO_CON_OBSERVACIONES
    M: pasta del EP del BTT6050 al 49,6 % (01), tapado inferior de las vías no
    garantizado por JLCPCB (02) y cambios a salidas.md que faltan (03, afecta a
    SPEC-0025). B: 4. Las tres M se corrigen antes del merge.
    Log: gestion/logs/SPEC-0024/02-ing-validacion.md
    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
2026-11-10 fix(SPEC-0024): observaciones 01–06 de VAL-0024-01 — pasta del EP al 65 %
    Pasta del EP del BTT6050 en 14 ventanas (11,03 mm², 65 %) a 0,10 mm de los
    taladros, con el patrón comprobado por validación (01). El texto ya no da
    las vías por tapadas: sin apertura en B.Mask, a comprobar en los Gerber de
    la fase 5 (02). Cambios a salidas.md completos: D5, l. 69 y l. 5 (03, 06).
    Reglas de taladro de JLCPCB (04), V_S(OP) y verificado_por del M7 (05).
    Requisitos: FAB-02, FAB-05
    Log: gestion/logs/SPEC-0024/03-jr-conformidad.md
    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
2026-11-10 spec(SPEC-0024): cerrar — VAL-0024-01 APROBADO_CON_OBSERVACIONES
    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
2026-11-11 spec(SPEC-0026): abrir — Orquestación v2: roles, ciclo, registro y trámite
    DEC-0009 (aceptada): revisión de la orquestación con los datos de la
    auditoría del 3 al 10 de noviembre y diez medidas. El usuario acepta la
    opción B completa. SPEC-0026 aplica M2 a M9.
    Spec: SPEC-0026
    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
2026-11-11 feat(hooks): zonas de ing-diseno y guarda con menos falsos positivos
    - Zonas: ing-diseno (hardware/ salvo v1-tfg, docs/diseno/, firmware/ y
    herramientas/kicad/); se retiran ing-esquematicos e ing-layout.
    - La guarda sustituye las variables asignadas en el propio comando, no
    trata como órdenes el cuerpo de un heredoc que no va a una shell, no
    analiza el código en línea de python o node (salvo que el comando
    toque el TFG) y salta do, then, if... para encontrar la orden.
    - Batería: 21 casos nuevos (V, C y K); N24 y N31 dejan de ser límites.
    - auditoria.py corta `objetivo` a 160 caracteres.
    - commit-msg acepta `Agente: ing-diseno`.
    Co-Authored-By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
2026-11-11 feat(gestion): órdenes abrir, revisar, integrar, cerrar y registrar, y coste en el tablero
    gestion.py hace los commits del ciclo con sus trailers y resume en 25 líneas lo que se revisa antes de integrar. El registro de cada spec gana tokens, acciones y minutos por arranque, que el tablero suma por spec y por agente. Batería nueva: test_gestion.py (26 casos, con el commit-msg real). La plantilla de spec gana el plan de validación.
    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
2026-11-11 feat(agentes): tres agentes, lo común en CLAUDE.md, parte en vez de log y checklists marcadas
    ing-diseno sustituye a ing-esquematicos e ing-layout y lleva también las piezas; sus memorias se funden. jr-conformidad queda en lo mecánico, con lista blanca del MCP. ing-validacion sigue el plan de validación de la spec y no escribe log. CLAUDE.md recoge una vez el protocolo, el contrato y las prohibiciones; la sección del coordinador apunta al manual. Las definiciones ganan el método de trabajo. Cada punto de las seis checklists es [auto] o [juicio].
    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
2026-11-11 fix(herramientas): find -exec de lectura en la guarda y auditoría alterada en revisar
    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
2026-11-11 docs(gestion): ESTADO.md, specs 0027 y 0028 propuestas y SPEC-0002 descartada
    ESTADO.md sustituye al diario. SPEC-0027 (caja de herramientas de KiCad) y SPEC-0028 (mantenimiento de las fases 2 y 3) quedan propuestas. SPEC-0006 y SPEC-0025 pasan a ing-diseno.
    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
2026-11-11 test(SPEC-0026): prueba en vivo de los tres agentes
    ing-diseno, jr-conformidad e ing-validacion: una escritura dentro de la zona pasa y tres fuera se bloquean; ing-diseno escribe en hardware/libraries y en el .kicad_pcb de una copia en la carpeta temporal (MCP y sed). hardware/ queda sin cambios. El plan de validación cita la checklist de proceso v4.
    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
2026-11-11 fix(SPEC-0026): heredocs y variables de la guarda, Requisitos en abrir y textos (VAL-0026-01)
    M-01: el cuerpo de un heredoc solo es texto si lo reciben cat, tee o un intérprete y la línea no lo pasa a una shell; << entre comillas o en un comentario no abre nada, el delimitador se lee entero y, sin comillas, se analizan las líneas con $(...) o comillas invertidas. B-02: las variables se sustituyen en orden y una asignación tras && solo vale en su cadena. find -exec uniq/tree vuelve a contar como escritura. B-04: abrir escribe el trailer Requisitos. B-06: validación no tiene parte (guarda y manual), cierre sin guardar en CLAUDE.md y modelo del nivel ligero en el manual. Batería: casos HD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
2026-11-11 docs(SPEC-0026): límites de la guarda de VAL-0026-02, checklist de proceso v6 y ESTADO.md
    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
2026-11-11 spec(SPEC-0026): cerrar — VAL-0026-02 APROBADO_CON_OBSERVACIONES
    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
2026-11-12 spec(SPEC-0027): abrir — Caja de herramientas de KiCad
    Spec: SPEC-0027
    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
2026-11-12 feat(SPEC-0027): caja de herramientas de KiCad: nueve herramientas, README y batería
    Agente: ing-diseno
    Log: gestion/logs/SPEC-0027/01-ing-diseno.md
    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
2026-11-12 feat(SPEC-0027): enganche de comprobar.py en verificar.py, batería en pruebas/ y checklists enlazadas
    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
2026-11-12 fix(SPEC-0027): correcciones de VAL-0027-01 en comprobar.py, ayudas, README y batería
    Log: gestion/logs/SPEC-0027/02-ing-diseno.md
    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
2026-11-12 fix(SPEC-0027): verificar.py rellena zonas y aguanta fallos de comprobar.py; checklists según VAL-0027-01
    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
2026-11-12 spec(SPEC-0027): cerrar — VAL-0027-02 APROBADO_CON_OBSERVACIONES
    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
2026-11-12 docs(DEC-0010): agentes en Opus o inferior, nunca en Fable 5.2
    ing-diseno e ing-validacion pasan de model: inherit a model: opus.
    Sustituye la medida M8 de DEC-0009. Decidido por el usuario el 2026-11-12.
    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
2026-11-12 spec(SPEC-0025): abrir — Hoja de salidas en el esquema v2
    Spec: SPEC-0025
    Requisitos: REL-01, REL-03, REL-04, REL-05, REL-06, REL-07, REL-08, REL-10
    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
2026-11-12 feat(SPEC-0025): campos-salidas.csv (87 refs) y stock del 2026-11-12
    Log: gestion/logs/SPEC-0025/01-jr-conformidad.md
    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
    [stock-salidas.csv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]
2026-11-13 feat(SPEC-0025): hoja de salidas, raíz unida, PCB sincronizada, attr de huellas y salidas.md
    Log: gestion/logs/SPEC-0025/02-ing-diseno.md
    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
    [esp-riego.kicad_pcb, esp-riego.kicad_sch, salidas.kicad_sch]
2026-11-13 docs(SPEC-0025): bloque-salidas.md: fichas de C17713, C17902 y C23253
    Log: gestion/logs/SPEC-0025/03-jr-conformidad.md
    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
2026-11-13 spec(SPEC-0025): cerrar — VAL-0025-01 APROBADO_CON_OBSERVACIONES
    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
2026-11-13 docs(estado): válvulas de 24 V AC en la foto del usuario y respuestas a D3 y D4
2026-11-13 docs(DEC-0011): sin entrada de pulsos, pulsadores manuales, conector con SPEC-0006 y válvulas instaladas
    Decisiones del usuario del 2026-11-13: D3 (EXP-01 se retira), D4 (6 pulsadores
    leídos por firmware, en fila en el centro), D9 (el conector se fija con
    SPEC-0006), .kicad_pro versionado cuando cambie y válvulas de 24 V AC
    alimentadas en continua, con la medida pendiente.
2026-11-13 docs(gestion): specs 0029 a 0032 propuestas para cerrar el esquema v2
    Desglose de lo que falta de la fase 3: sensores, requisitos v0.6 (DEC-0011),
    conectores con expansión y pulsadores, e integración y revisión global.
2026-11-13 spec(SPEC-0030): abrir — Requisitos v0.6
    Spec: SPEC-0030
    Requisitos: EXP-01, EXP-02, EXP-03, EXP-04, FAB-07, REL-03
    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
2026-11-13 docs(SPEC-0030): EXP-03 en S, aceptada por el usuario
    Requisitos: EXP-03
    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
2026-11-14 spec(SPEC-0030): cerrar — VAL-0030-02 APROBADO_CON_OBSERVACIONES
    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
2026-11-14 spec(SPEC-0029): abrir — Bloque de sensores
    Spec: SPEC-0029
    Requisitos: AMB-01, AMB-02, KIC-02
    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
2026-11-14 docs(SPEC-0029): campos y stock del bloque de sensores
    Log: gestion/logs/SPEC-0029/01-jr-conformidad.md
    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
    [stock-sensores.csv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]
2026-11-14 feat(SPEC-0029): hoja de sensores en el esquema v2
    Log: gestion/logs/SPEC-0029/02-ing-diseno.md
    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
    [esp-riego.kicad_pcb, esp-riego.kicad_sch, sensores.kicad_sch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]
2026-11-14 docs(SPEC-0029): VAL-0029-01 del bloque de sensores
    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
2026-11-14 spec(SPEC-0029): cerrar — VAL-0029-01 APROBADO_CON_OBSERVACIONES
    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
